CLIS-WPI/OpenRU/hardware/h2/reports/H2A_SCHEMATIC_REVIEW.md

# H2-A Schematic review report — OpenRU-X6 4T4R / 16-feed RF tile

- **Date:** 2026-11-12.
- **Branch:** `hardware/h2a-rf-schematic`, from H1.1 `a7990911b39865cade9f08b94dd8522956c959f7`.
- **Status:** **preliminary schematic, not a released design.** No layout, routing, EM sign-off, Gerbers, purchases,
  OTA transmission or simulator runs were done.

## 1. What exists

The editable KiCad 9 project is `hardware/h2/schematics/openru_x6_tile.kicad_pro`, with 21 sheets and 211 placed
parts. It is generated by `tools/build_schematics.py` and fully reproducible (`tools/run_h2a_checks.sh`).

| # (brief) | Sheet(s) | Content |
|---|---|---|
| 1 RF chain | `chain1..4` | one per N310 channel. Holds the IF SMA and the three sub-sheets below. Four structurally identical chains, generated by one function and verified identical by netlist checks |
| 2 Beamformer + control | `bf1..4` | ADAR1000 (UBF1–4): 4 TX/RX/PA_BIAS/DET channels, SPI (shared SCLK/SDIO, CSB each, unique ADDR), shared TR / TX_LOAD / RX_LOAD, PA_ON ← TX_ALLOW, CREG 1 µF ×4, SDO 50 Ω |
| 3 Four front ends | `fe1..4` | 4× ADTR1107 per chain (UFE1–16), wired per ADTR1107 Fig 91: TX/RX direct, PA_BIASk → VGG_PA (10 nF), CPLR_OUT → DETk, TR_SW_POS → CTRL_SW (100 k pull-up = RX default), LNA_BIAS → VGG_LNA (10 k to GND = self-bias default). Feed SMAs JF1–16 labelled with sim feed index / site / polarisation |
| 4 Conversion | `conv1..4` | N310 IF → 18 pF DC block → BFCN-1840+ → **LTC5553** IF; LTC5553 RF → BFCN-8350+ → HFCN-7150+ → cal sheet; LO 18 pF block; VCC 18 pF + 1 µF; EN = MIX_EN |
| 5 LO | `lo` | ADF4371: 10 MHz SE REFP; RF8P → AVA-183A+ → 3 dB pad → EP4RKU+ → 4 mixers; RF8N terminated; RFAUX8 → LO-monitor SMA; loop filter UNRESOLVED |
| 6 Power + sequencing | `power` | 8 rails (regulators = TBD placeholders), per-chain TPS22810 PA-drain switch, INA226 ×5, PCA9306, negative-rail monitor (TBD) |
| 7 MCU, SPI, telemetry, watchdog | `mcu` | STM32G431 at 1.8 V, TPS3430 window watchdog, 74LVC1G11/08 interlock gates, safe-default pull-downs, TMP117 ×2, N310 GPIO / TX-permit header, SWD |
| 8 Cal + test I/O | `cal` | EDC21-24+ coupler per chain (converter ↔ ADAR1000), EP4RKU+ combiner → CAL SMA; 10 MHz REF SMA (50 Ω); PPS SMA → 74LVC1G125 → MCU |

Topology A feed ownership is preserved exactly: chain c → UBF{c}, channel k → UFE{4(c−1)+k}, with channels 1/2 the
V/H of the left site and 3/4 the V/H of the right site. All 16 feeds were checked against `H1_FEED_POLARIZATION_MAP.csv`.

## 2. Verification performed

| Check | Result | Evidence |
|---|---|---|
| KiCad ERC | **22 errors**, all deliberate unconnected/unresolved pins (§4) | `H2A_ERC_REPORT.md`, `H2A_ERC.json` |
| Hierarchy validation | ok, 0 issues | `H2A_ERC.json` |
| Symbol pin maps vs datasheets | 1088 / 1088 pins match | `H2A_PIN_INTERFACE_VERIFICATION.csv` |
| Interfaces, feed map, rails, safety chain, unconnected-pin declarations | 367 / 367 pass (+ 44 symbol pin-count checks) | same |
| Converter gain/loss, RX cascade NF | RX NF **4.05 dB** feed-referred (H1: 3.85 dB); compression ≈ −32.8 dBm per feed (ADAR1000 IP1dB-limited) | `H2A_RF_CASCADE_BUDGET.csv` |
| TX drive and compression margins | 10 dBm/feed needs: ADTR1107 out 10.7 dBm (12.3 dB below OP1dB typ, 10.3 dB below min); ADAR1000 out −10.8 dBm (20.8 dB below its OP1dB); ADAR1000 gain 13.7 dB of 21 dB; LTC5553 IF −10 dBm (25 dB below IP1dB); N310 −7.6 dBm avg (25.6 dB below 18 dBm max) | same |
| LO distribution | −5.8 / −0.2 / +3.8 dBm per mixer for ADF4371 settings −4 / −1 / +5 dBm (range −6…+6, abs max +10) | `H2A_LO_BUDGET.csv` |
| Spur frequencies | no mLO ± nIF (m, n ≤ 5) product falls in 8.35–8.45 GHz; no mLO ± nRF product in 1.75–1.85 GHz. Nearest: 5×IF at 8.75–9.25 GHz and 2LO − 3IF at 7.65–7.95 GHz (filter rejection there not tabulated) | `H2A_SPUR_TABLE.csv` |
| Power-rail / bias sequencing logic | interlock nets and default states verified in the netlist; sequence in `H2A_POWER_SEQUENCING_SPEC.md` | `verify_netlist.py` (safety) |

**Not performed, and not claimed:**
- EM simulation of any kind;
- S-parameter/scikit-rf cascade;
- ADIsimRF/ADIsimPLL;
- any RF or DC measurement;
- thermal analysis.

All 8.4 GHz figures are datasheet table values from wider bands, plot reads (about ±0.5 dB) or assumptions, tagged
row by row.

## 3. Prototype power target

The prototype target of ≥10 dBm average per feed is **still plausible.**
- It needs about 12 dB back-off from the ADTR1107 OP1dB (23 dBm typ, 21 dBm min, 6–14 GHz table).
- Every stage before it runs with ≥20 dB margin.
- It depends on two unverified items:
  1. 100 MHz OFDM EVM/ACLR at 12 dB back-off without DPD;
  2. ADAR1000 gain and gain-control range at 8.4 GHz, since its data starts at 9.5 GHz.

Both are covered by condition C2.

## 4. Unresolved electrical/RF risks (full list: `H2A_UNRESOLVED_ISSUES.md`, 26 items)

| ID | Risk | Severity | Close by |
|---|---|---|---|
| R1 | **All regulators are placeholders** (U601–U608), and the negative-rail monitor U609 is a placeholder | blocks layout prep | power design (ADI suggests LT8609S + LT1931 for 4 ADAR1000) |
| R2 | **PA_BIAS OFF value conflict.** ADAR1000 p45 says −2.5 V; ADTR1107 VGG_PA abs max is −2 V. H2-A uses −1.75 V in firmware | high (device damage) | ADI question 5a |
| R3 | **VGG_PA 10 nF vs PA_BIAS switching.** 60 ns is specified into 1 nF; 10 nF gives about 0.65 µs or more per TDD edge | medium (TDD guard time) | ADI question 5c; eval-board value |
| R4 | **LNA powered during TX.** The design keeps VDD_LNA on and pinches the gate (Stingray style), unlike the ADTR1107 TX sequence | medium | ADI question 5b |
| R5 | **No bypass values** for ADAR1000 AVDD1/AVDD3 or ADTR1107 VDD_PA/VDD_LNA/VDD_SW/VSS_SW (not in datasheets) | blocks layout prep | eval-board schematics (ADI question 2) |
| R6 | **ADF4371 loop filter not designed;** RF8P single-ended level at 6.6 GHz not tabulated; RF8 is ON at power-up by default | blocks layout prep | ADIsimPLL; C4 bench; CE held low until programmed (drawn) |
| R7 | **AVA-183A+ bias tee not wired;** no gain/P1dB spec between 5 and 8 GHz | blocks layout prep | Fig 2 / PL-328; bench |
| R8 | **ADAR1000 SDO not tristated** on a shared bus (erratum) | low (firmware) | separate CSB per chip, as drawn; read back one chip at a time |
| R9 | **MCU pin/AF map provisional;** STM32 decoupling not placed | blocks layout prep | STM32CubeMX + ST DS |
| R10 | **TI glue-part values from memory** (TPS22810 CT/QOD, TPS3430 timing, INA226 straps, PCA9306 bias, TPS22810 EN threshold at 1.8 V) | blocks layout prep | TI datasheets |
| R11 | **N310 interface levels unverified** (IF port DC state, PPS level, GPIO/ATR mapping); N310 inter-channel phase is random per start/retune | medium | UHD docs; CAL-port loopback after every init/retune (drawn) |
| R12 | **Calibration network:** EP4RKU+ phase unbalance up to 19°, coupler directivity 19 dB typ | medium | one-time VNA characterisation; phase-matched layout |
| R13 | **No footprints** for custom ICs, Mini-Circuits parts or SMAs; ADF4371 EP size is ambiguous in the datasheet. The exposed pad is symbol pin `EP` on every custom part, so footprint pad numbers must match it (the LTC5553 datasheet calls it pin 13) | blocks layout | vendor land patterns |
| R14 | **Antenna / feed interface and thermal design** not done (H1 M5, M6) | separate WPs | EM + thermal studies |
| R15 | **Source copies:** ADI datasheets were read from mirrors (analog.com unreachable) | low | re-check revisions in a browser |

## 5. Gate decision

| Gate | Decision |
|---|---|
| Mixer | **LTC5553 selected** (`H2A_MIXER_DECISION.md`) |
| Preliminary schematic capture | **Done**, as a preliminary schematic |
| **PCB layout preparation** | **NO-GO** |
| PCB routing / Gerbers / fabrication | NO-GO (unchanged) |

Why it is NO-GO:
- ERC is not clean: 22 deliberate open pins.
- The power tree is still placeholders (R1).
- Mandatory bypass networks are missing (R5).
- The loop filter, LO-amplifier bias and TI glue values are not designed (R6, R7, R10).
- None of the H1.1 conditions C1 (ADAR1000 supply), C2 (8.4 GHz bench data) or C4 (LTC5553/ADF4371 at the operating
  point) has closed, and C3 still needs the project lead's acceptance.

Exit criteria to reach CONDITIONAL GO for layout preparation:
1. R1, R5, R6, R7, R9, R10 designed and drawn.
2. ERC at 0 violations (or each residual waived in writing).
3. R2 and R4 answered by ADI or decided by the project lead.
4. Vendor footprints for all parts (R13).
5. C1 closed. C2 and C4 have at least eval-board data, or an explicit risk acceptance.

Work that may proceed in parallel, because it does not depend on schematic freeze:
- building the footprint library from vendor land patterns;
- choosing the stackup and material (ADF4371 DS recommends Rogers 4350/4003/3003);
- antenna EM design;
- the eval-board bench plan for C2/C4, cabled and attenuated with no OTA, using the draft inquiry once it is approved.
