CLIS-WPI/OpenRU/hardware/h2/sim/h2c_d_worst_ASB_nom_gmin.png

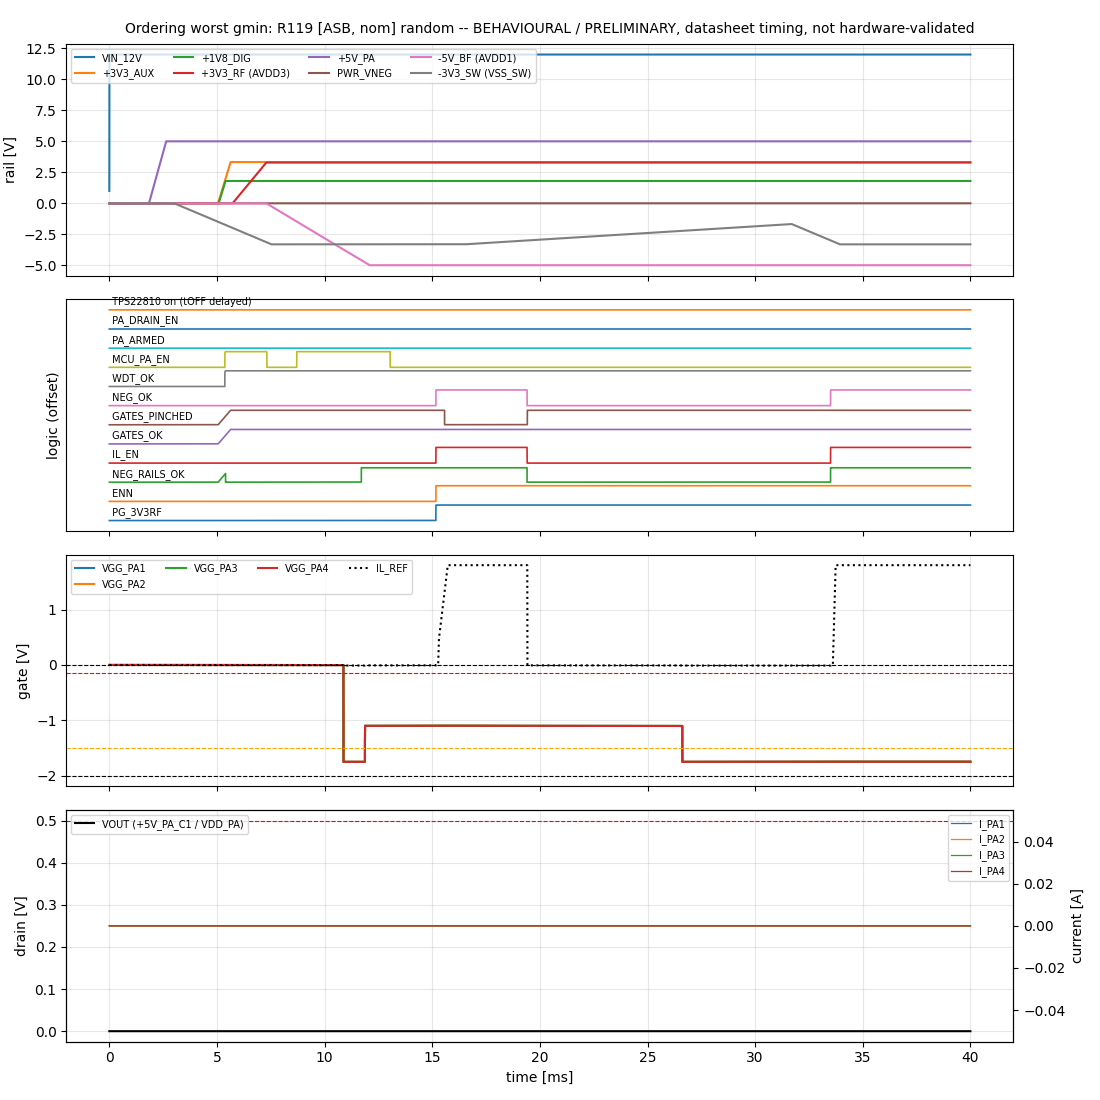
hardware/h2/sim/h2c_d_worst_ASB_nom_gmin.png
