CLIS-WPI/OpenRU/hardware/h2/sim/h2c_d_worst_ASB_nom_t05.png

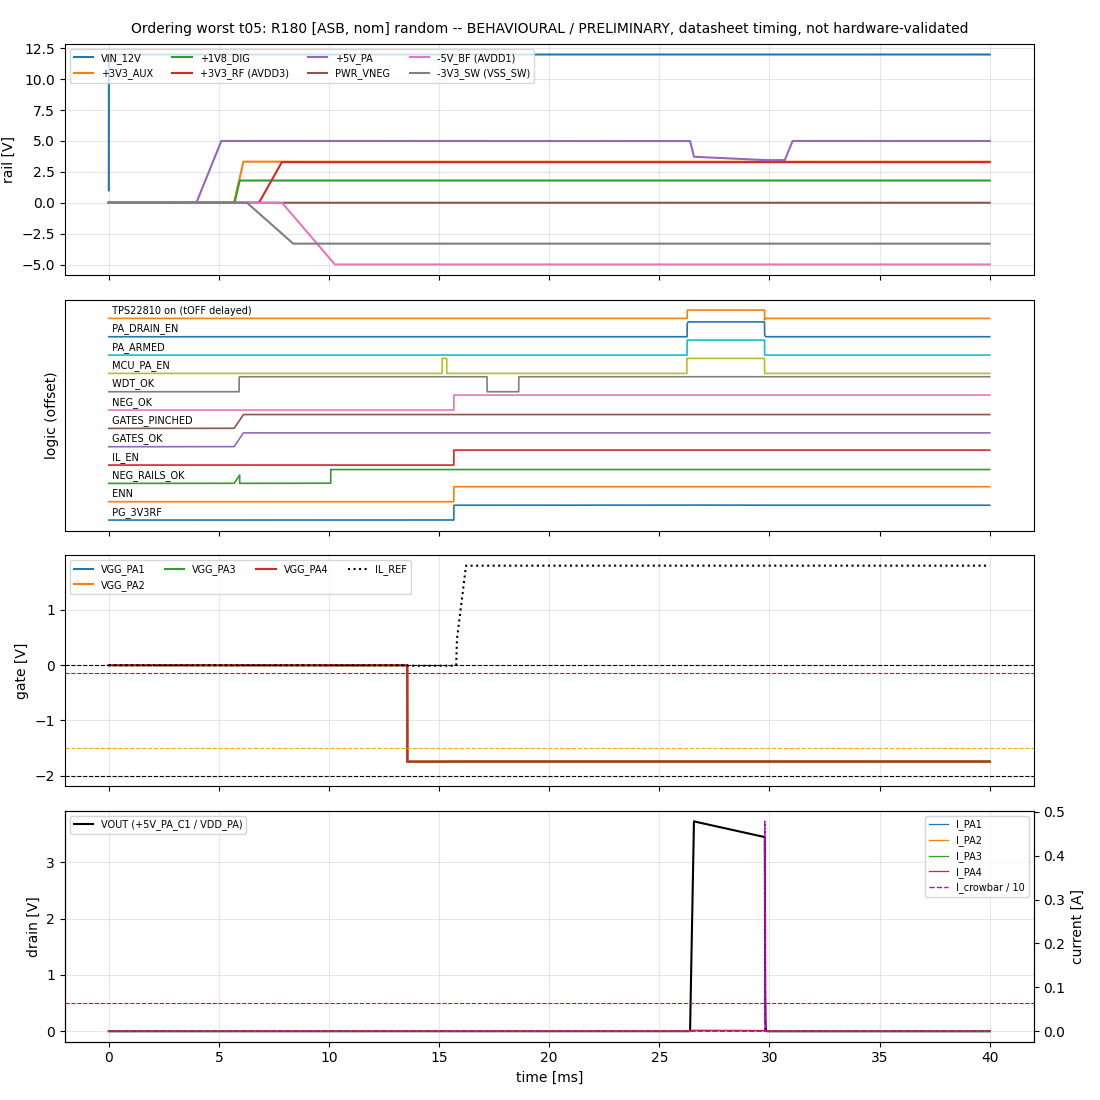
hardware/h2/sim/h2c_d_worst_ASB_nom_t05.png
