CLIS-WPI/OpenRU/hardware/h2/sim/h2c_d_worst_ASB_td100_pess_gmax.png

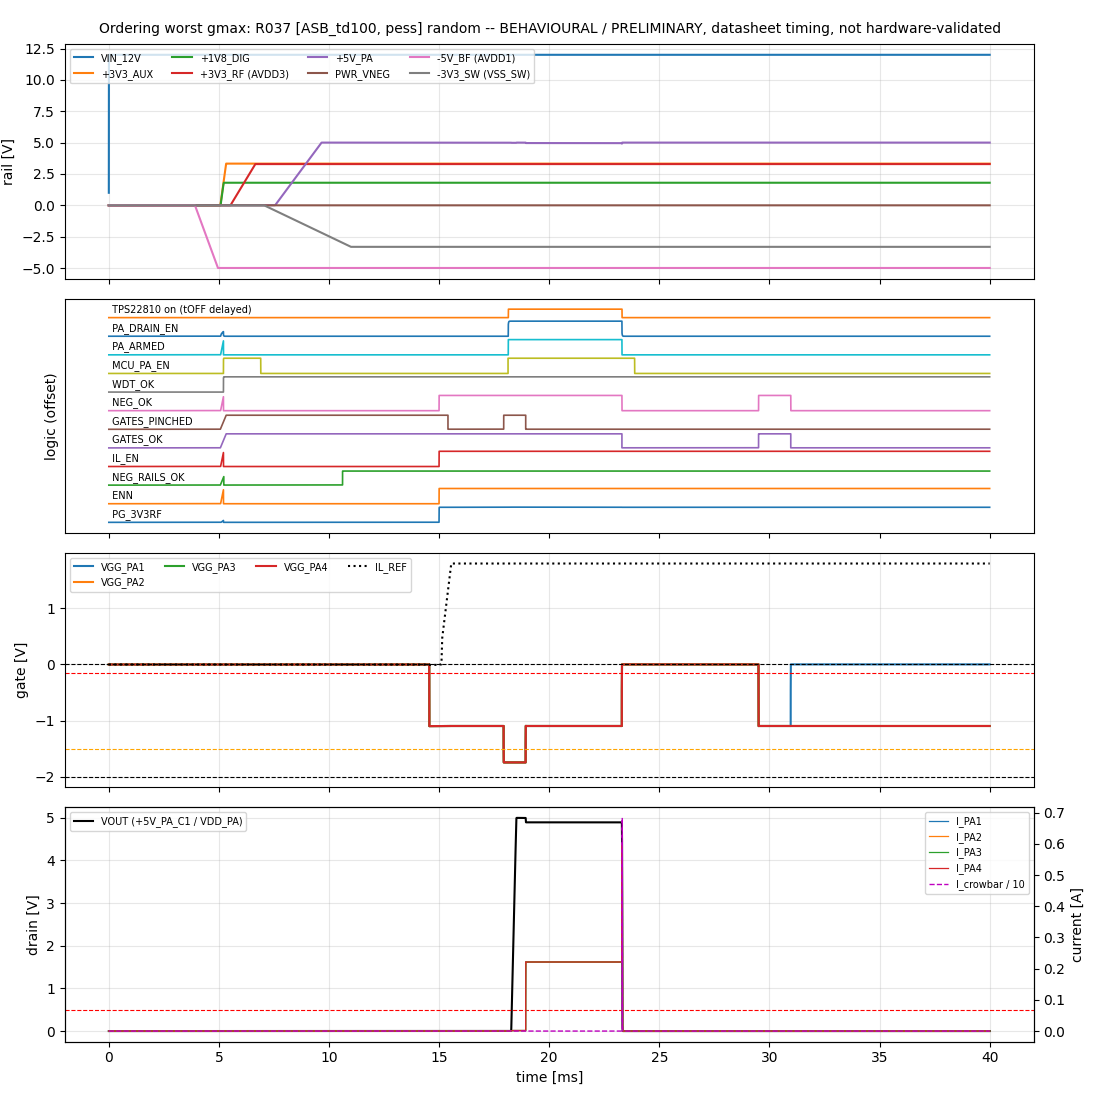
hardware/h2/sim/h2c_d_worst_ASB_td100_pess_gmax.png
