CLIS-WPI/OpenRU/hardware/h2/sim/h2c_s1_powerup_ASB_pess.png

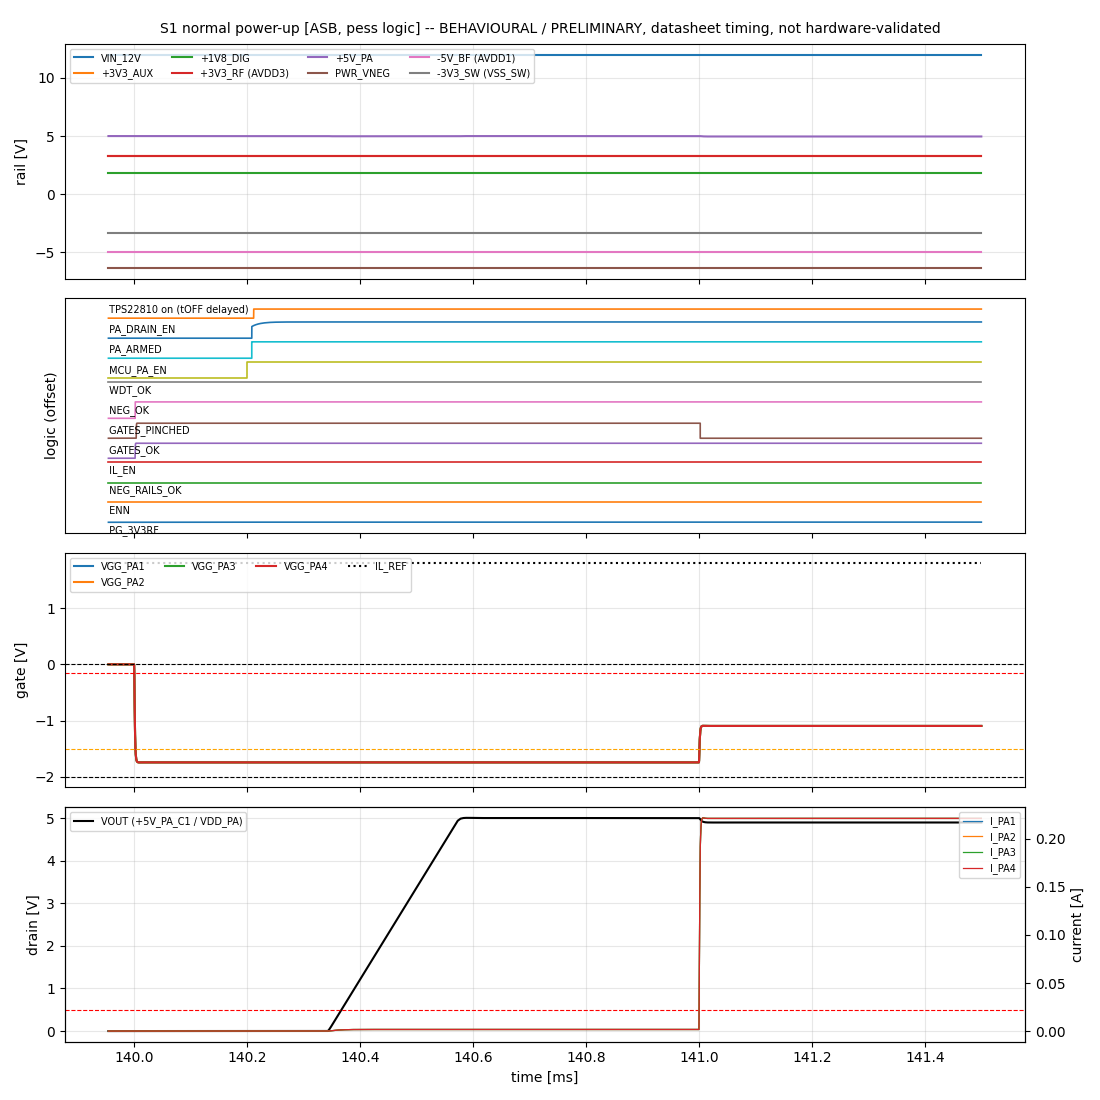
hardware/h2/sim/h2c_s1_powerup_ASB_pess.png
