CLIS-WPI/OpenRU/hardware/h2/sim/h2c_s2_unprogrammed_gates_ASB_pess.png

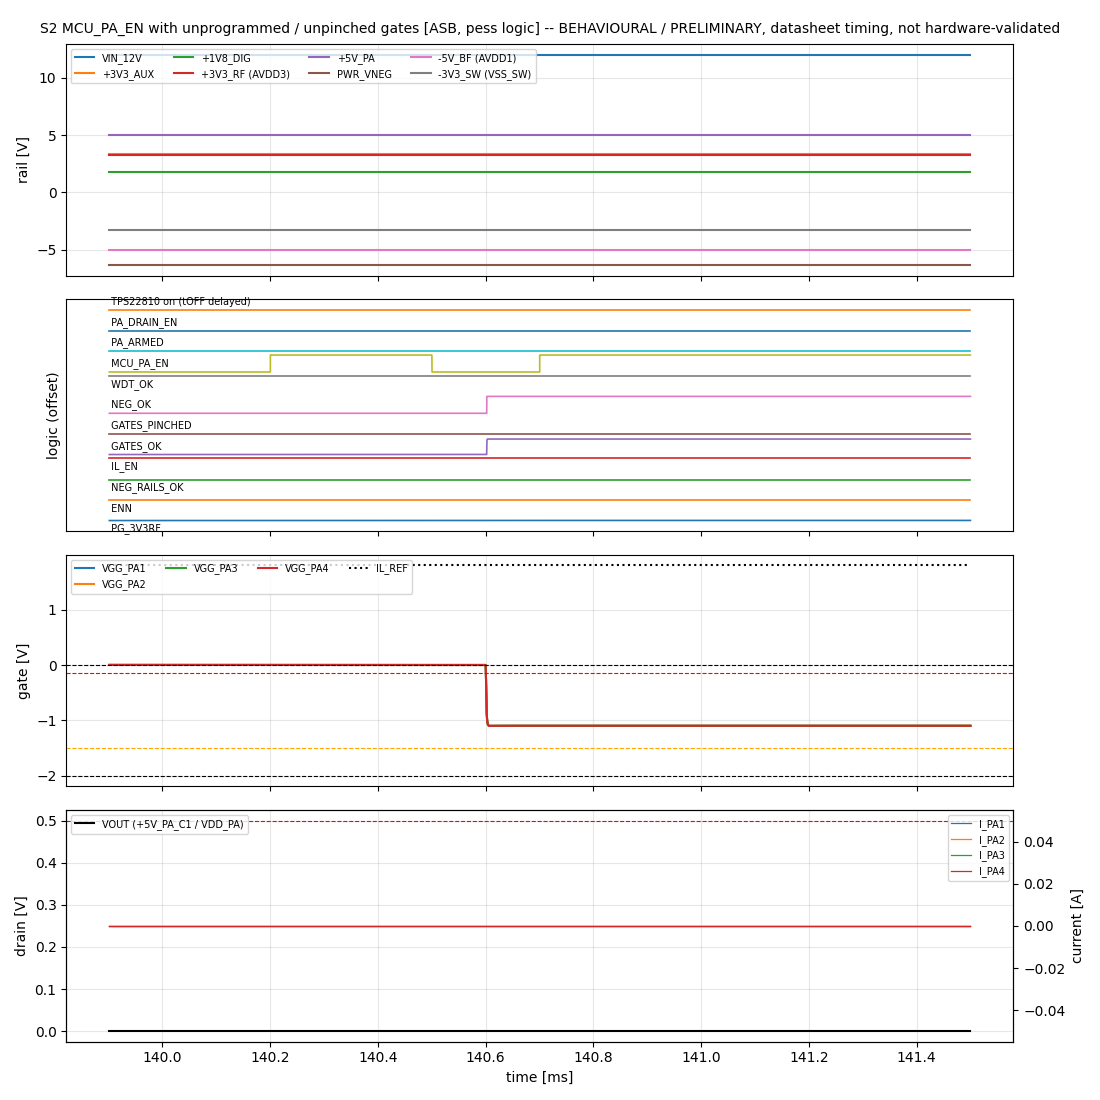
hardware/h2/sim/h2c_s2_unprogrammed_gates_ASB_pess.png
