CLIS-WPI/OpenRU/hardware/h2/sim/h2c_s3_gate_lost_ASB_pess.png

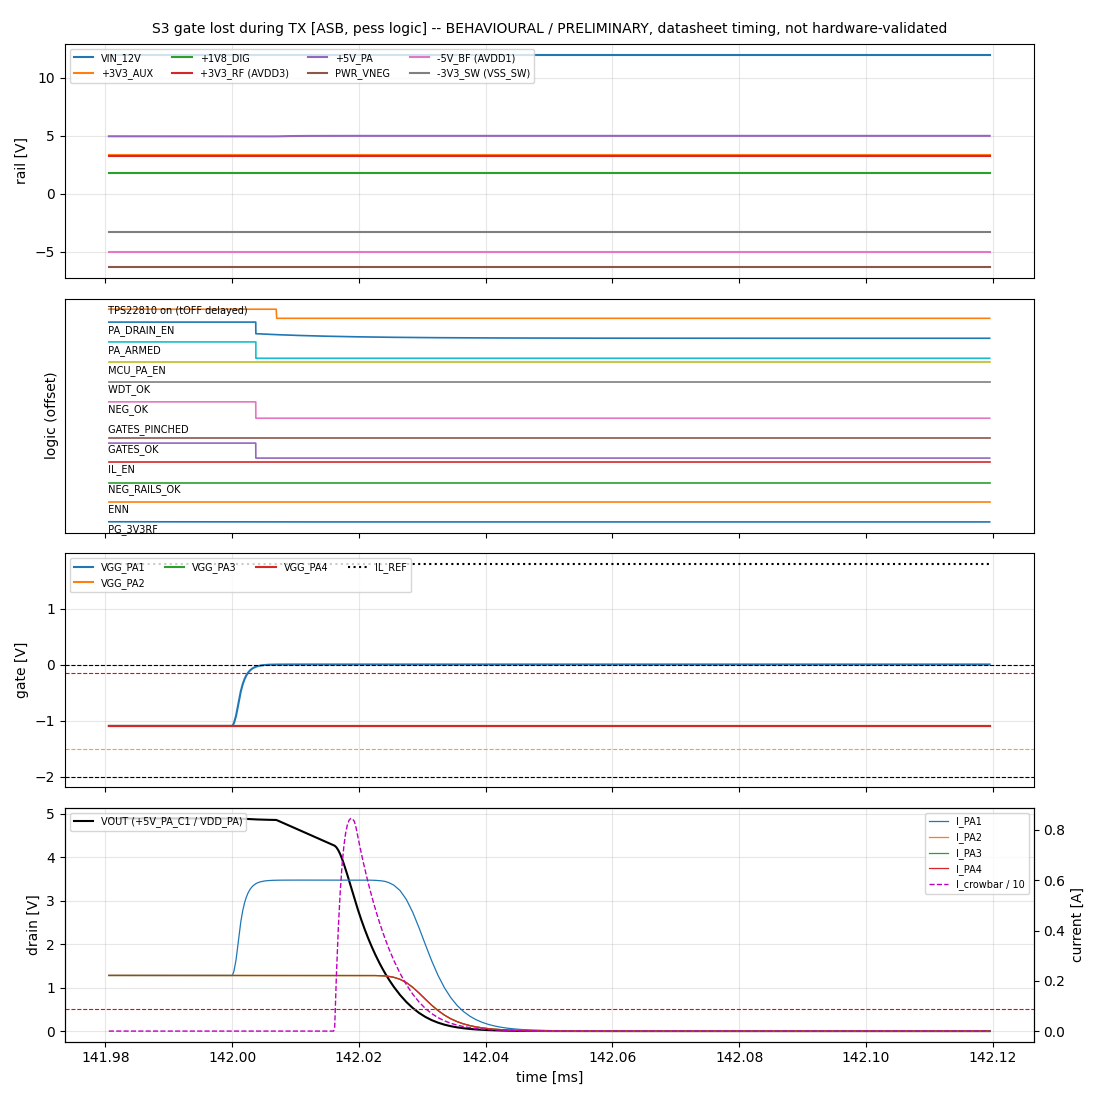
hardware/h2/sim/h2c_s3_gate_lost_ASB_pess.png
