CLIS-WPI/OpenRU/hardware/h2/sim/h2c_s3_gate_lost_R2_nom.png

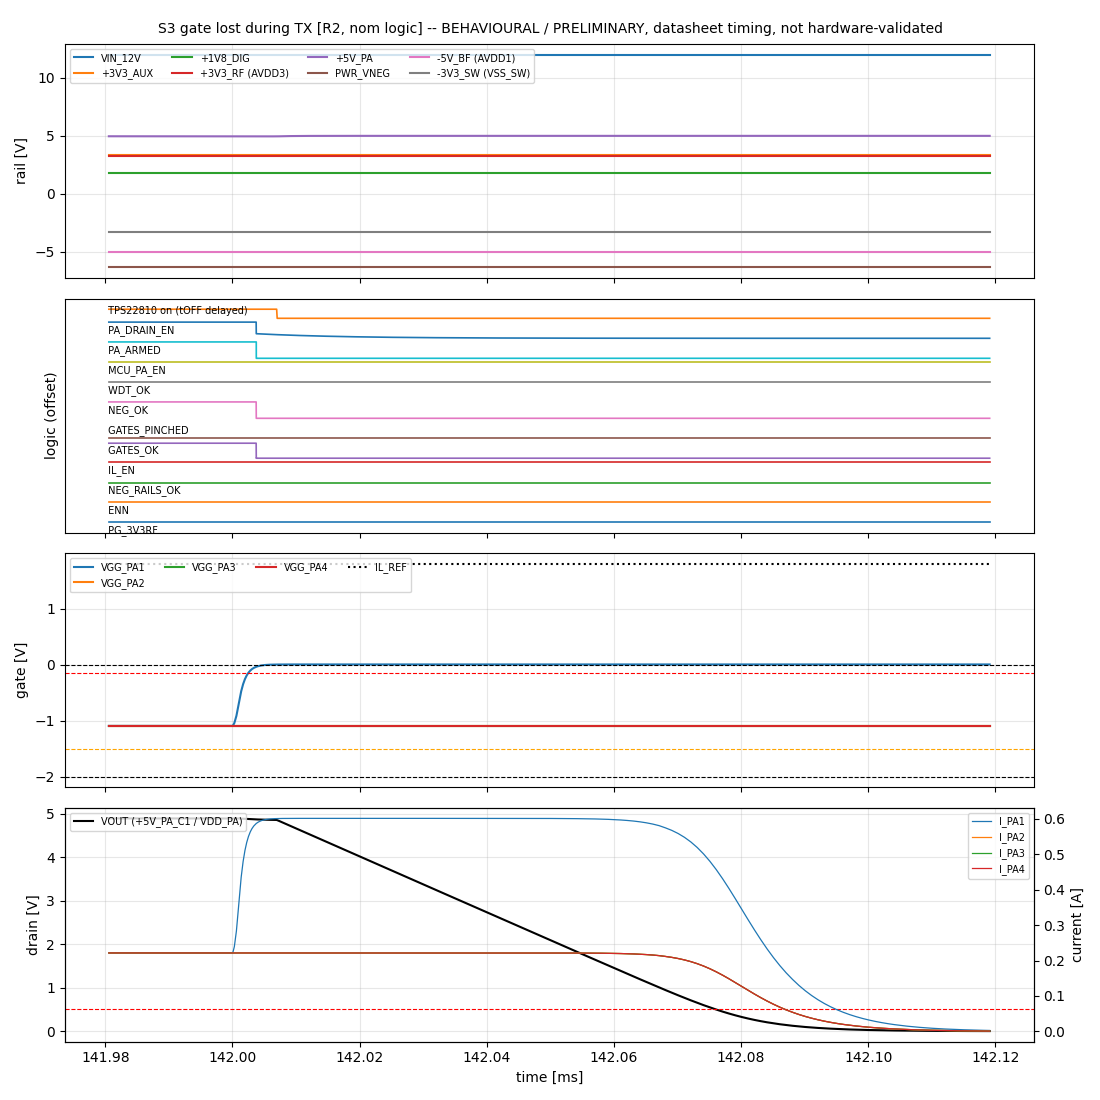
hardware/h2/sim/h2c_s3_gate_lost_R2_nom.png
