CLIS-WPI/OpenRU/hardware/h2/sim/h2c_s4a_neg_collapse_enn_ASB_pess.png

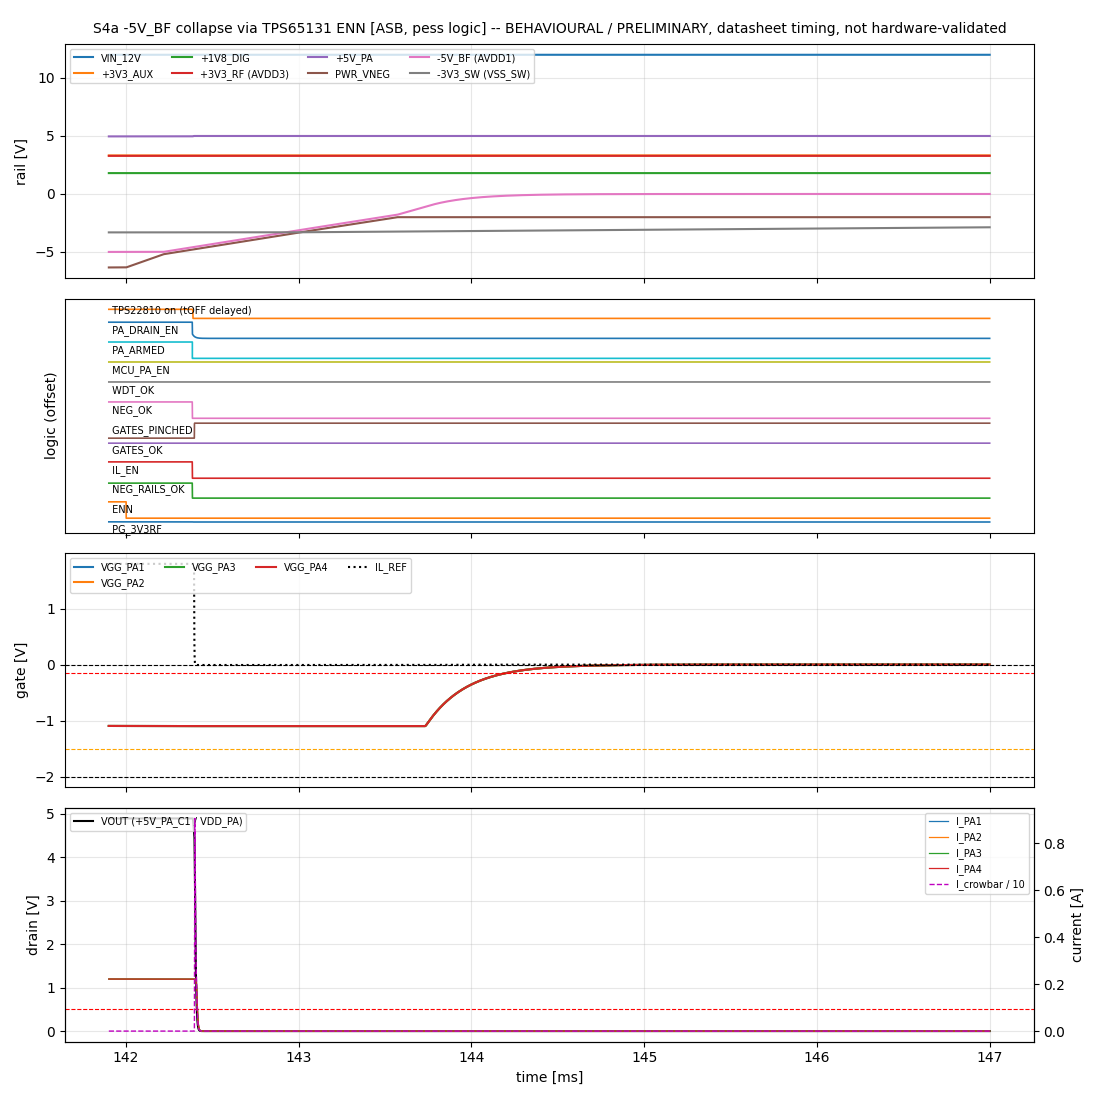
hardware/h2/sim/h2c_s4a_neg_collapse_enn_ASB_pess.png
