CLIS-WPI/OpenRU/hardware/h2/sim/h2c_s4b_neg_collapse_ldo_ASB_pess.png

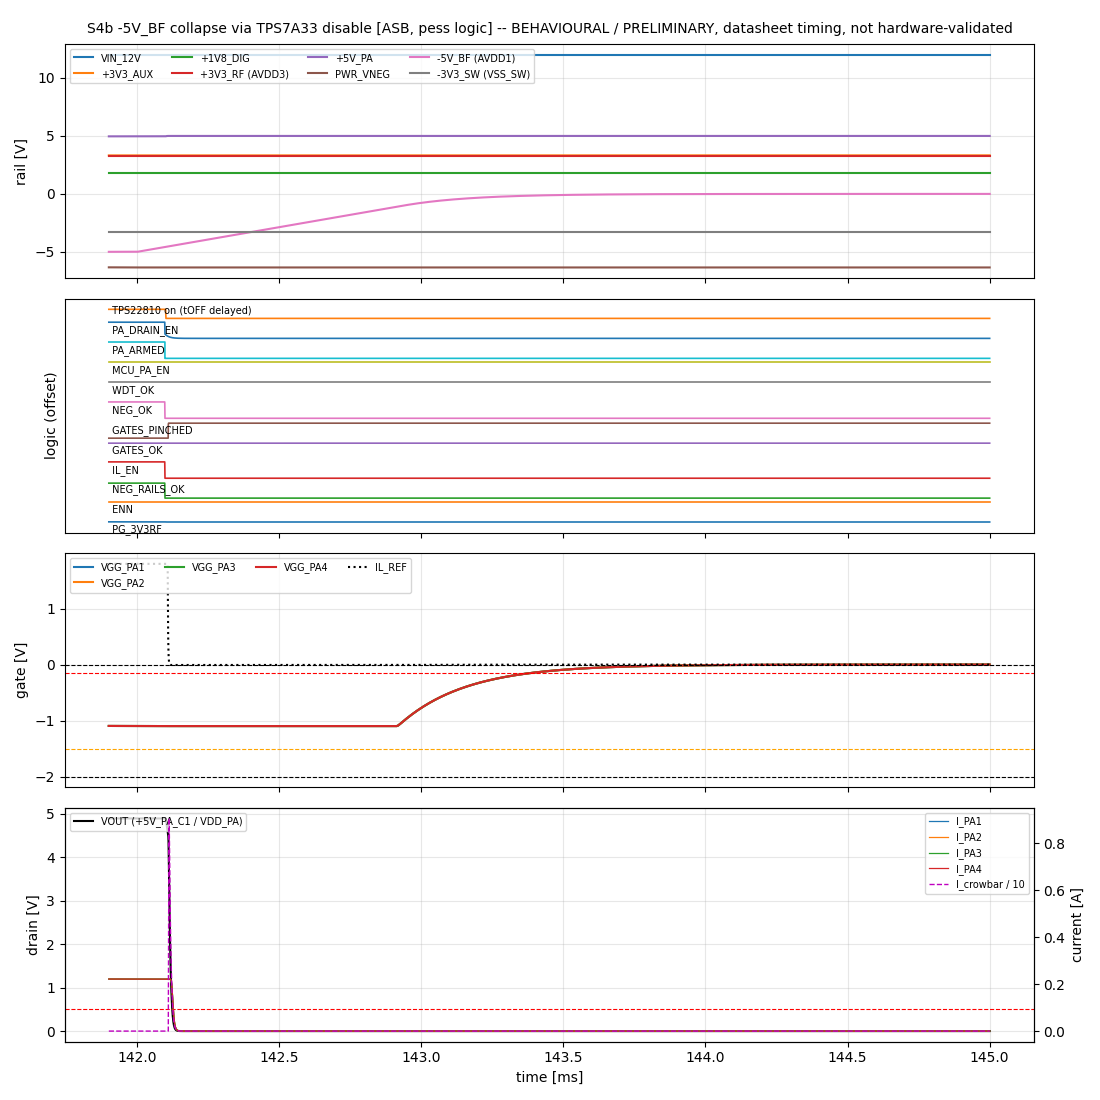
hardware/h2/sim/h2c_s4b_neg_collapse_ldo_ASB_pess.png
