CLIS-WPI/OpenRU/hardware/h2/sim/h2c_s5a_watchdog_tx_ASB_pess.png

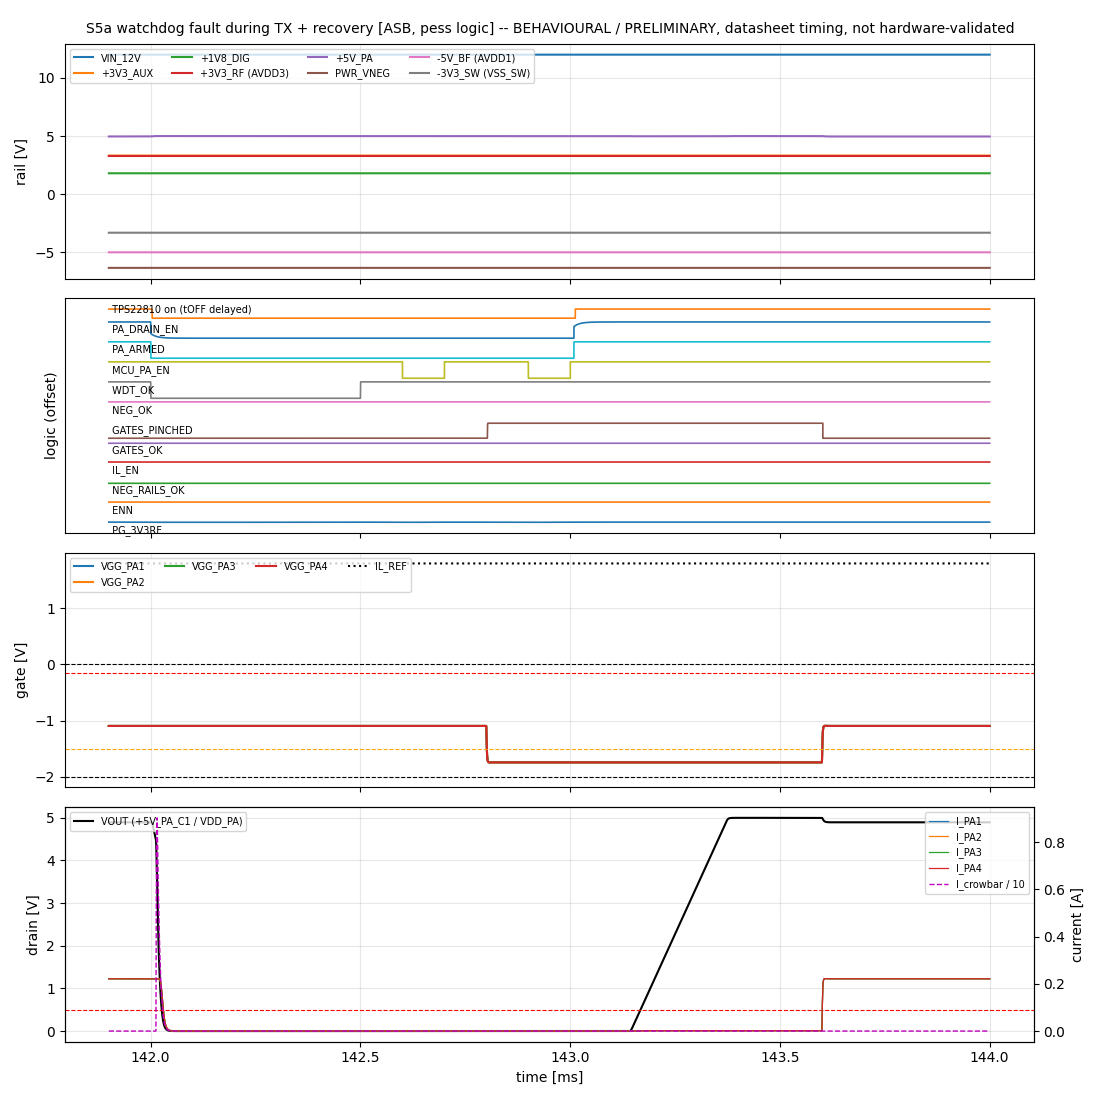
hardware/h2/sim/h2c_s5a_watchdog_tx_ASB_pess.png
