CLIS-WPI/OpenRU/hardware/h2/sim/h2c_s5b_watchdog_idle_ASB_pess.png

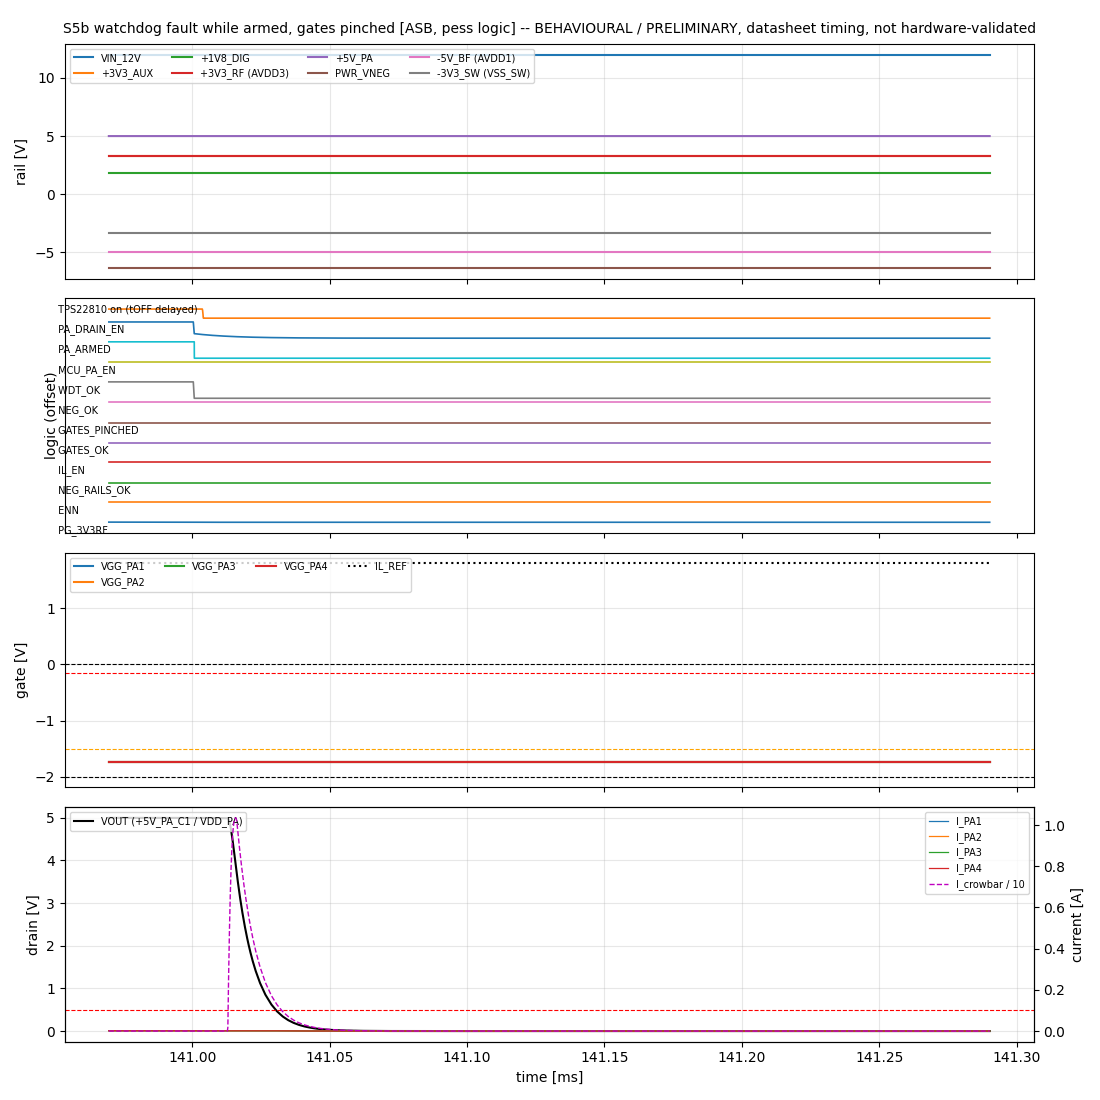
hardware/h2/sim/h2c_s5b_watchdog_idle_ASB_pess.png
