CLIS-WPI/OpenRU/hardware/h2/sim/h2c_s5b_watchdog_idle_R2_nom.png

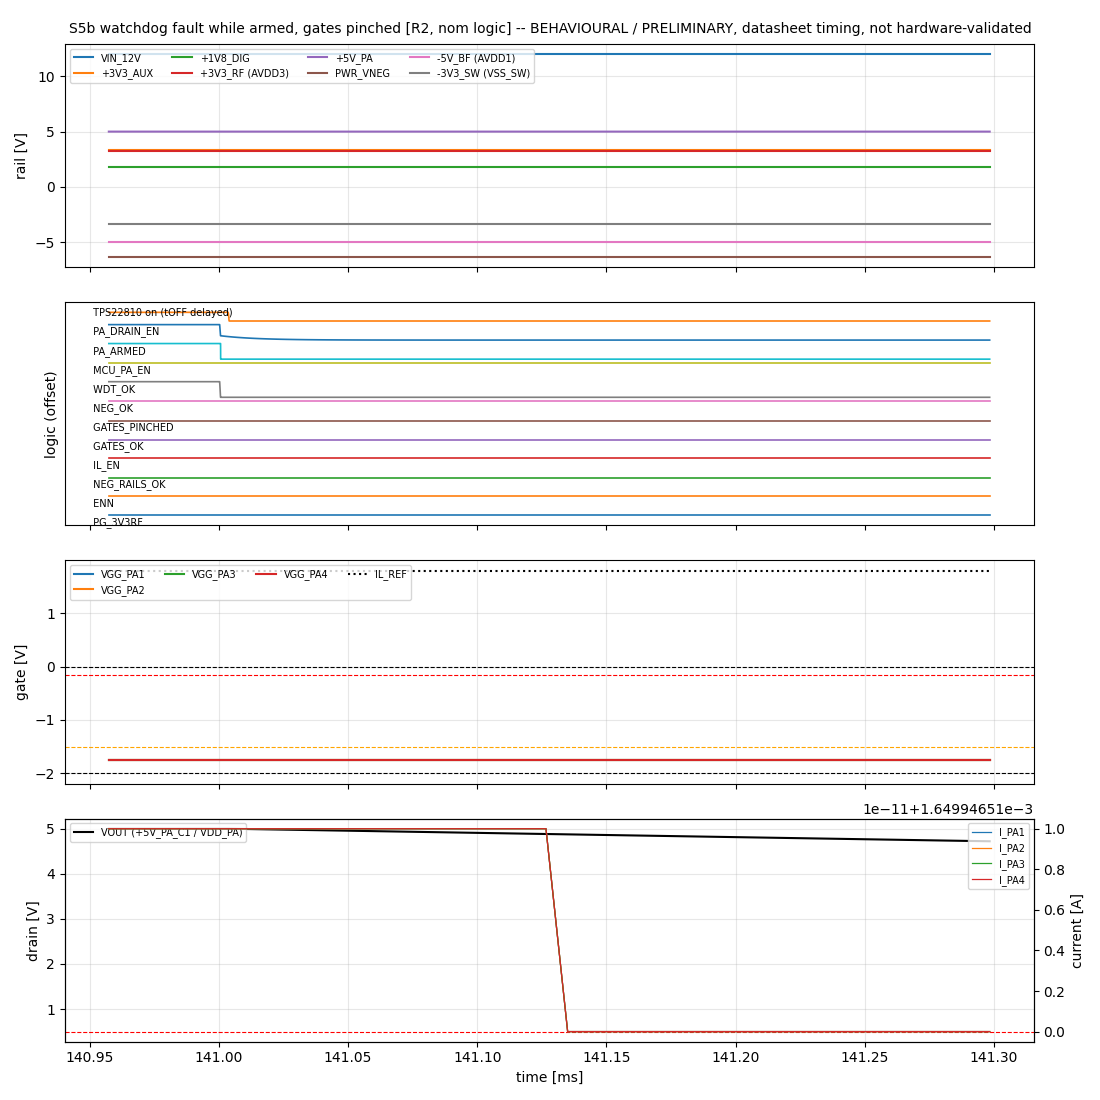
hardware/h2/sim/h2c_s5b_watchdog_idle_R2_nom.png
