CLIS-WPI/OpenRU/hardware/h2/sim/h2c_s6_vin_loss_ASB_pess.png

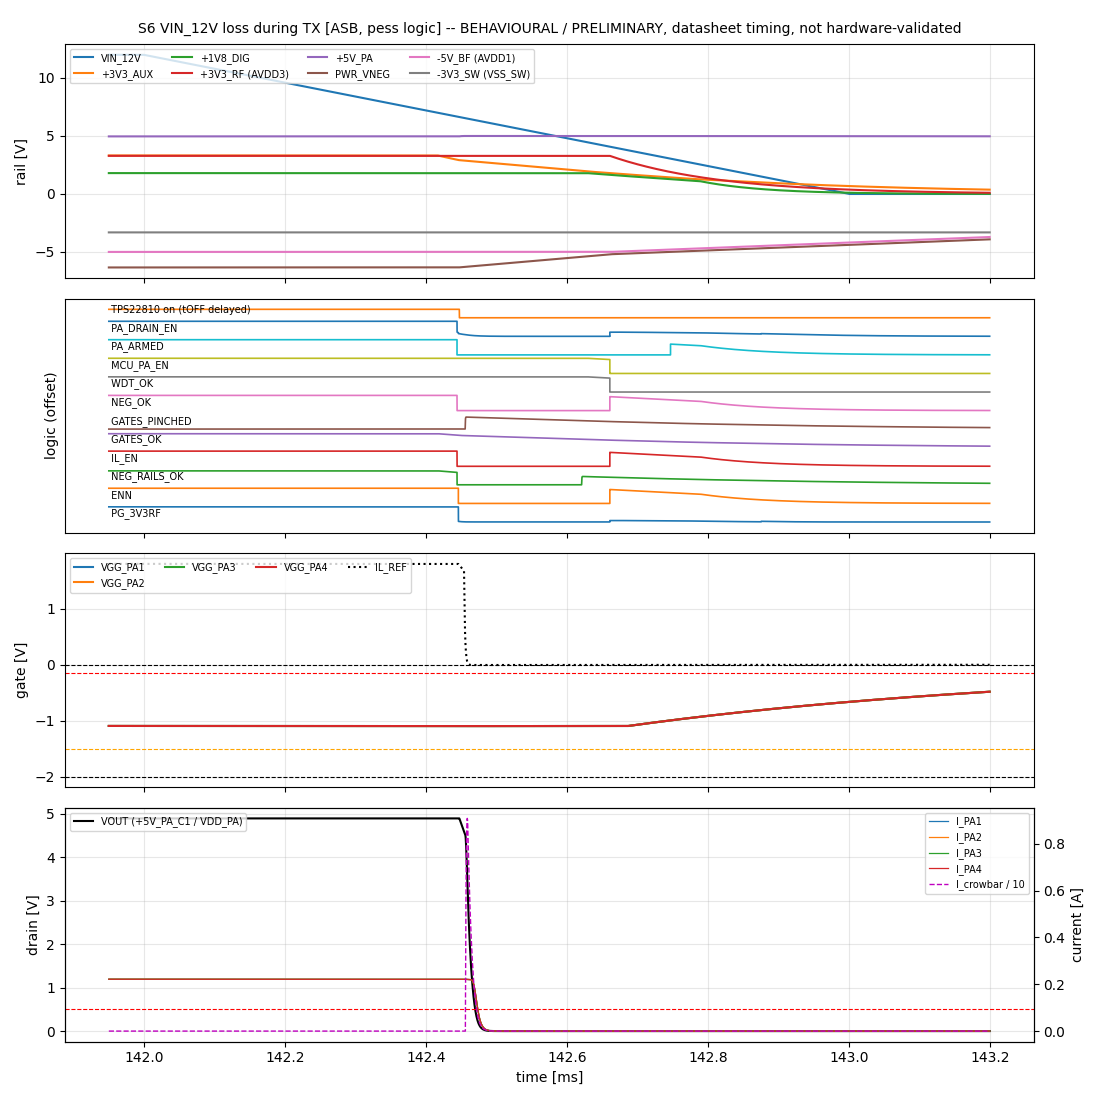
hardware/h2/sim/h2c_s6_vin_loss_ASB_pess.png
