CLIS-WPI/OpenRU/hardware/h2/sim/h2c_s6_vin_loss_R2_nom.png

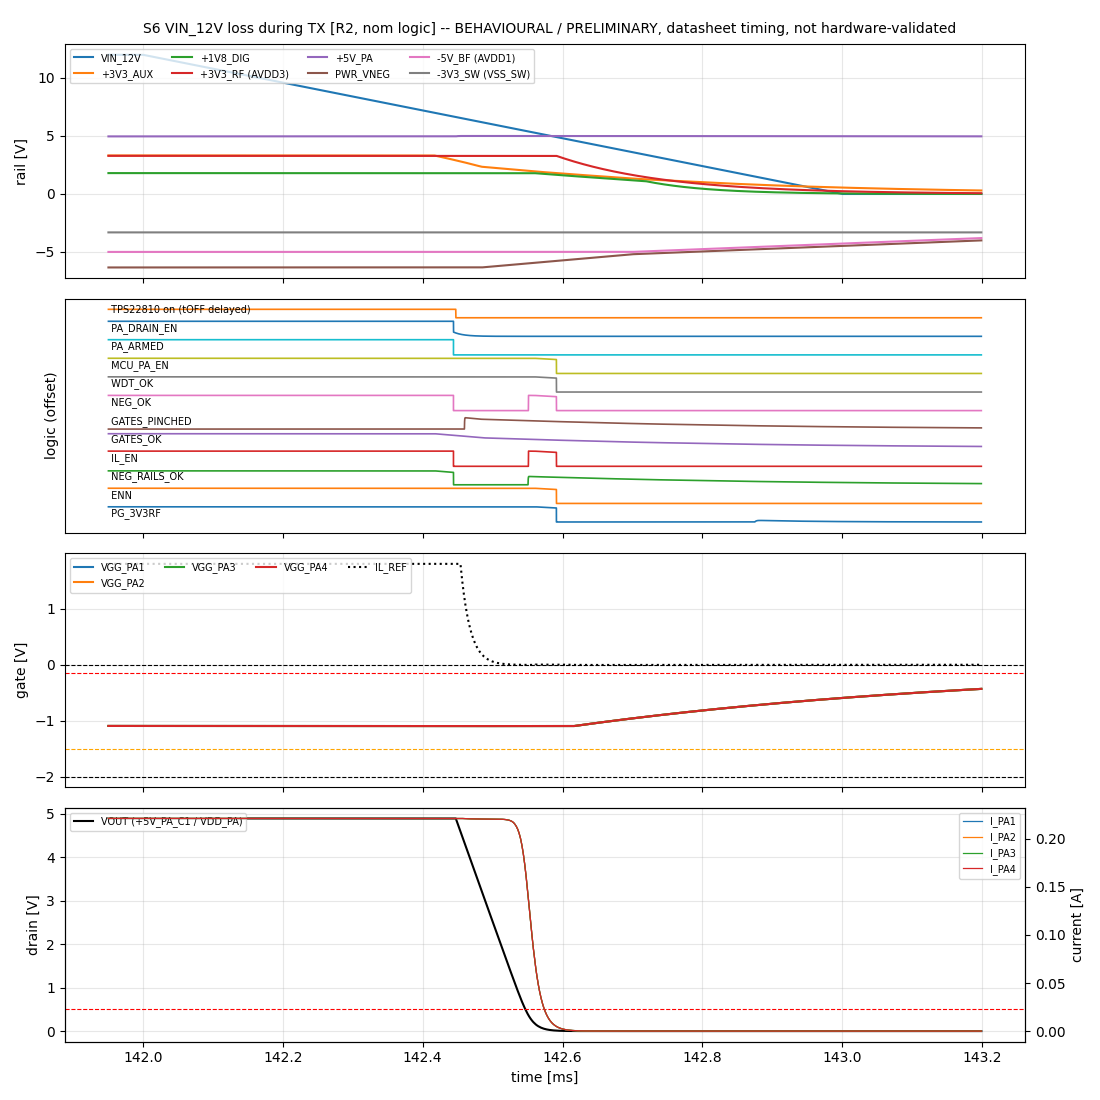
hardware/h2/sim/h2c_s6_vin_loss_R2_nom.png
