CLIS-WPI/OpenRU/hardware/h2/sim/h2c_s7a_rf_en_loss_ASB_pess.png

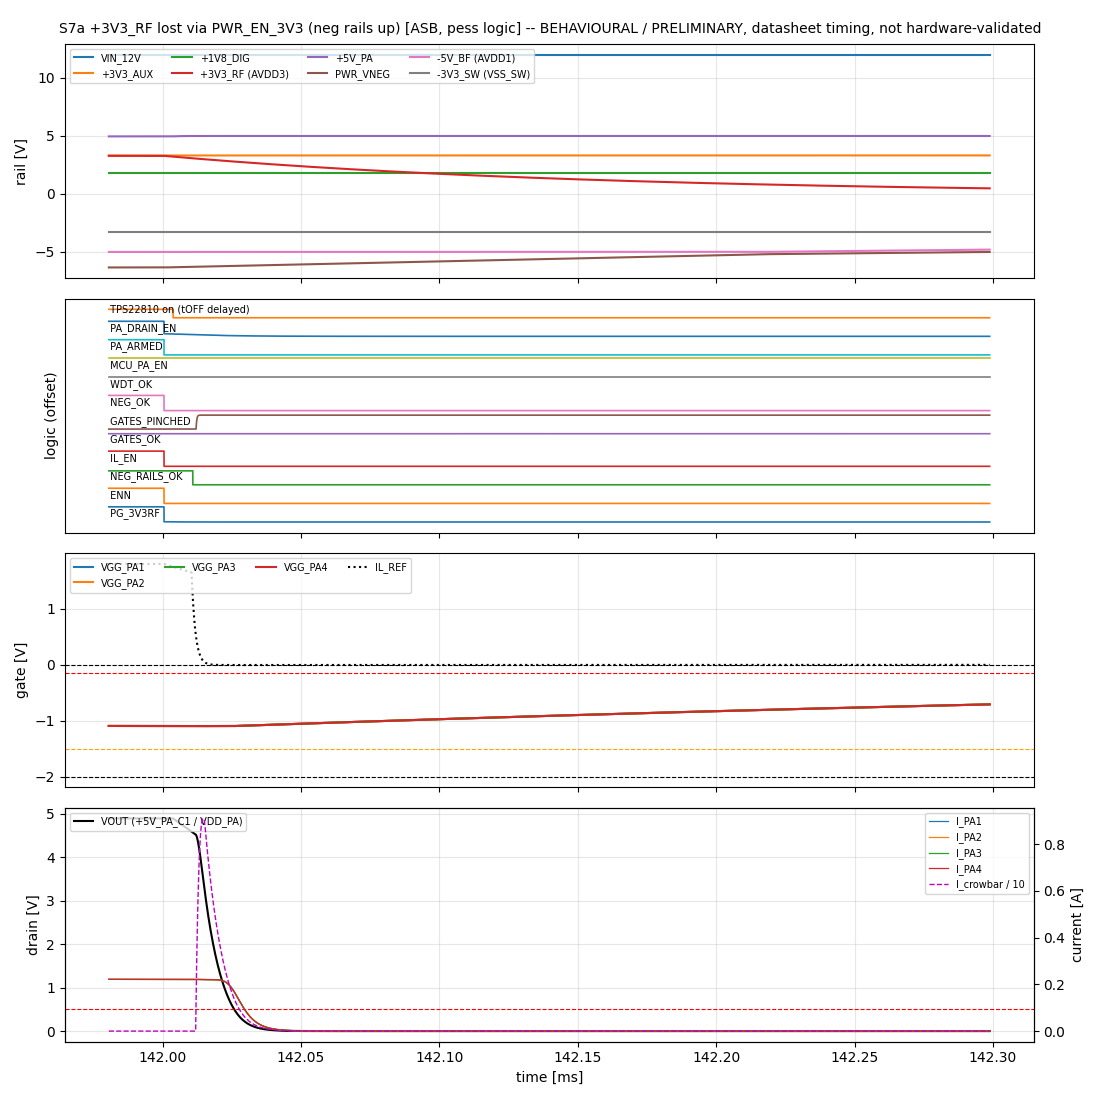
hardware/h2/sim/h2c_s7a_rf_en_loss_ASB_pess.png
