CLIS-WPI/OpenRU/hardware/h2/sim/h2c_s7a_rf_en_loss_R2_nom.png

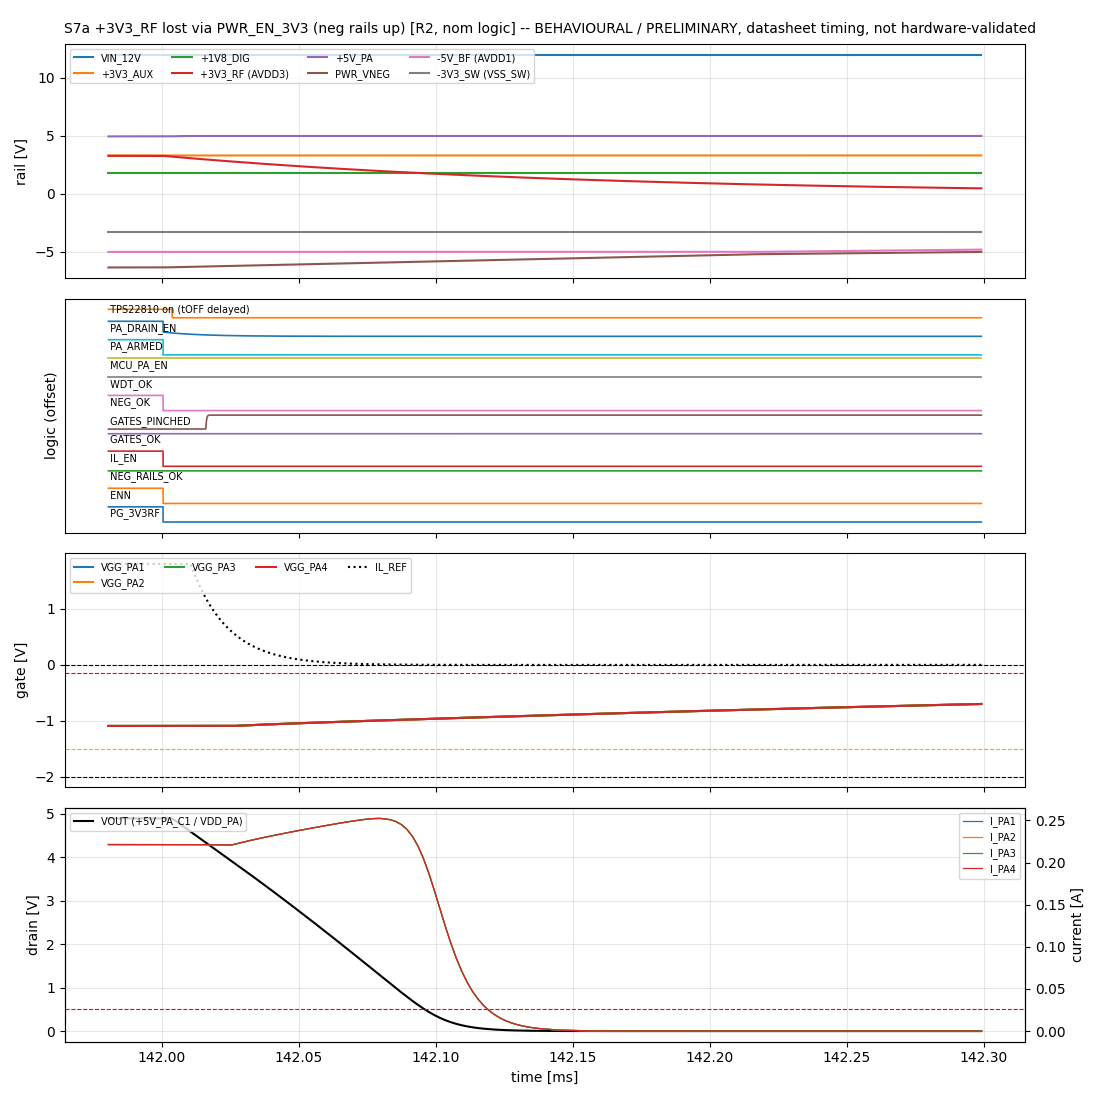
hardware/h2/sim/h2c_s7a_rf_en_loss_R2_nom.png
