CLIS-WPI/OpenRU/hardware/h2/sim/h2c_s7b_rf_silent_collapse_ASB_pess.png

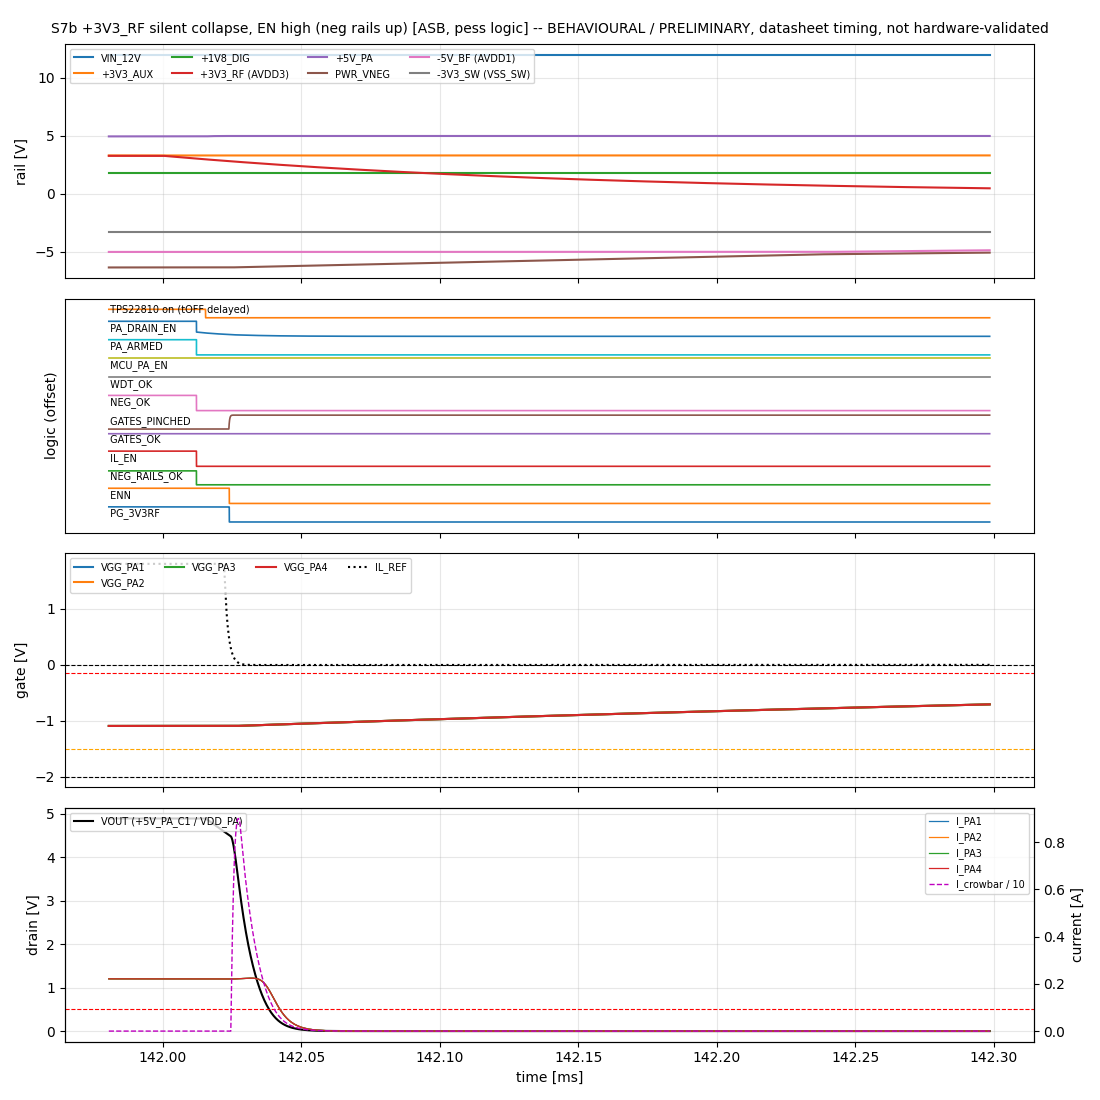
hardware/h2/sim/h2c_s7b_rf_silent_collapse_ASB_pess.png
