CLIS-WPI/OpenRU/hardware/h2/sim/h2c_s7b_rf_silent_collapse_R2_nom.png

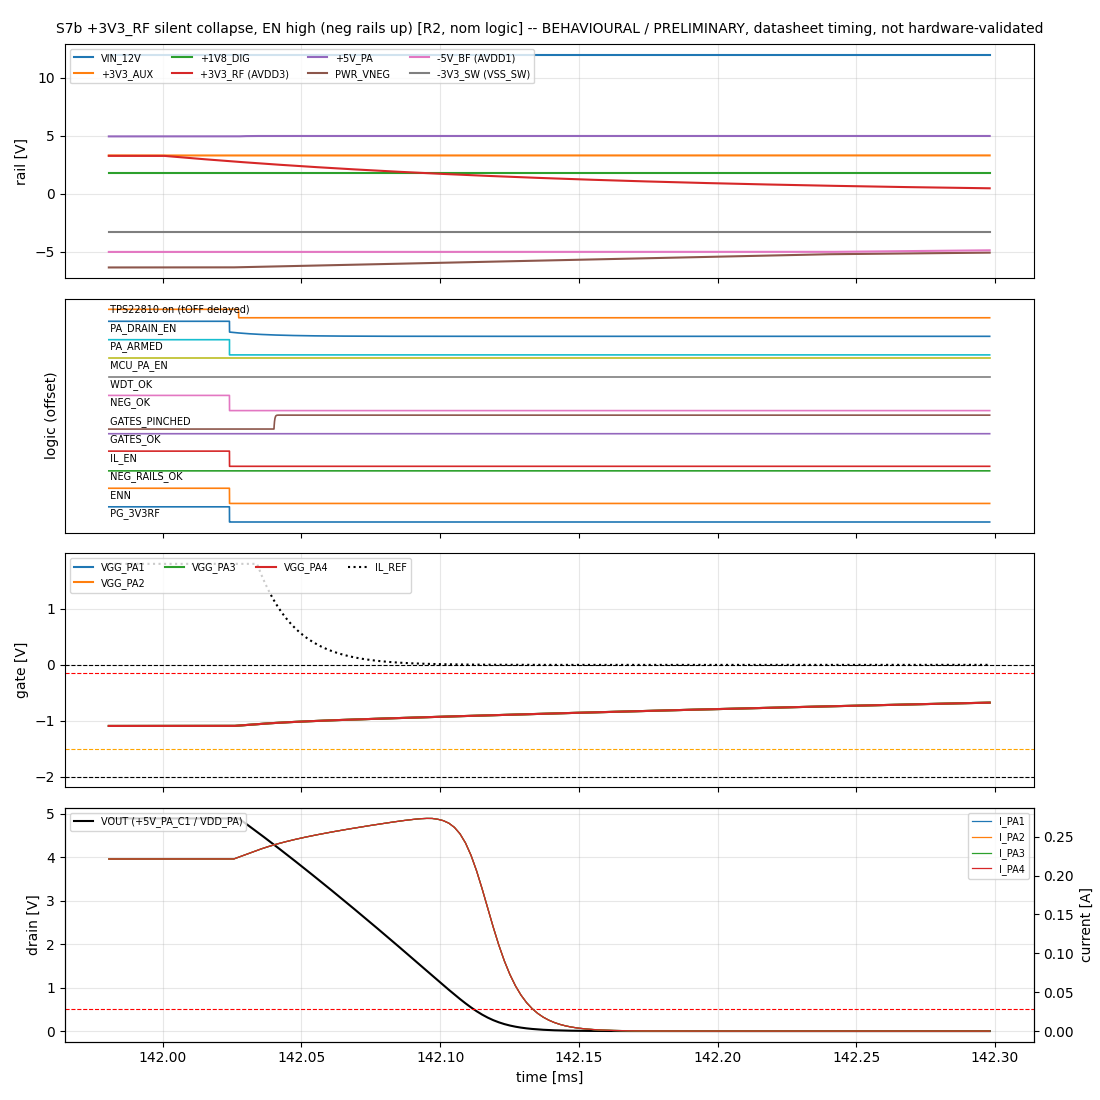
hardware/h2/sim/h2c_s7b_rf_silent_collapse_R2_nom.png
