CLIS-WPI/OpenRU/hardware/h2/reports/H2A_CANDIDATE_BOM.csv

mpn_or_value | symbol | qty_per_tile | refs | footprint | unit_price_usd | extended_usd | price_basis | status
SMA connector (type TBD) | Connector:Conn_Coaxial | 24 | J101 J201 J301 J401 J501 J801 ... (24) | UNRESOLVED | UNVERIFIED | UNVERIFIED |  | SELECTED - KiCad library symbol - DS cross-check pending
ADAR1000ACCZN | openru_x6:ADAR1000 | 4 | UBF1 UBF2 UBF3 UBF4 | UNRESOLVED | UNVERIFIED | UNVERIFIED |  | SELECTED - custom symbol from DS pin table - not qualified
50 | Device:R | 4 | R101 R201 R301 R401 | Resistor_SMD:R_0402_1005Metric | UNVERIFIED | UNVERIFIED |  | PROVISIONAL value (DS value or design choice, see H2A_SCHEMATIC_REVIEW)
1uF | Device:C | 18 | C101 C102 C103 C104 C201 C202 ... (18) | Capacitor_SMD:C_0603_1608Metric | UNVERIFIED | UNVERIFIED |  | PROVISIONAL value (DS value or design choice, see H2A_SCHEMATIC_REVIEW)
ADTR1107ACCZ | openru_x6:ADTR1107 | 16 | UFE1 UFE10 UFE11 UFE12 UFE13 UFE14 ... (16) | UNRESOLVED | 195.69 | 3131.04 | Digi-Key qty 28 (H1.1) | SELECTED - custom symbol from DS pin table - not qualified
10nF | Device:C | 16 | C111 C112 C113 C114 C211 C212 ... (16) | Capacitor_SMD:C_0402_1005Metric | UNVERIFIED | UNVERIFIED |  | PROVISIONAL value (DS value or design choice, see H2A_SCHEMATIC_REVIEW)
100k | Device:R | 21 | R120 R220 R320 R420 R710 R711 ... (21) | Resistor_SMD:R_0402_1005Metric | UNVERIFIED | UNVERIFIED |  | PROVISIONAL value (DS value or design choice, see H2A_SCHEMATIC_REVIEW)
10k | Device:R | 9 | R121 R221 R321 R421 R601 R606 ... (9) | Resistor_SMD:R_0402_1005Metric | UNVERIFIED | UNVERIFIED |  | PROVISIONAL value (DS value or design choice, see H2A_SCHEMATIC_REVIEW)
LTC5553IUDB#PBF | openru_x6:LTC5553 | 4 | UMX1 UMX2 UMX3 UMX4 | UNRESOLVED | UNVERIFIED | UNVERIFIED |  | SELECTED - custom symbol from DS pin table - not qualified
BFCN-1840+ | openru_x6:BFCN-1840+ | 4 | FL101 FL201 FL301 FL401 | UNRESOLVED | UNVERIFIED | UNVERIFIED |  | SELECTED - custom symbol from DS pin table - not qualified
BFCN-8350+ | openru_x6:BFCN-8350+ | 4 | FL102 FL202 FL302 FL402 | UNRESOLVED | 7.23 | 28.92 | Digi-Key qty 1 (H1) | SELECTED - custom symbol from DS pin table - not qualified
HFCN-7150+ | openru_x6:HFCN-7150+ | 4 | FL103 FL203 FL303 FL403 | UNRESOLVED | 5.40 | 21.60 | Digi-Key qty 1 (H1) | SELECTED - custom symbol from DS pin table - not qualified
GJM1555C1H180FB01 | Device:C | 8 | C131 C133 C231 C233 C331 C333 C431 C433 | Capacitor_SMD:C_0402_1005Metric | UNVERIFIED | UNVERIFIED |  | DATASHEET-SPECIFIED (LTC5553 Fig 1)
0402ZK180GBS | Device:C | 4 | C132 C232 C332 C432 | Capacitor_SMD:C_0402_1005Metric | UNVERIFIED | UNVERIFIED |  | DATASHEET-SPECIFIED (LTC5553 Fig 1)
GRM188R71A105KA61 | Device:C | 4 | C134 C234 C334 C434 | Capacitor_SMD:C_0603_1608Metric | UNVERIFIED | UNVERIFIED |  | DATASHEET-SPECIFIED (LTC5553 Fig 1)
ADF4371BCCZ | openru_x6:ADF4371 | 1 | U501 | UNRESOLVED | 474.90 | 474.90 | Digi-Key qty 1 (H1) | SELECTED - custom symbol from DS pin table - not qualified
1k | Device:R | 1 | R501 | Resistor_SMD:R_0402_1005Metric | UNVERIFIED | UNVERIFIED |  | PROVISIONAL value (DS value or design choice, see H2A_SCHEMATIC_REVIEW)
100nF | Device:C | 3 | C503 C504 C701 | Capacitor_SMD:C_0402_1005Metric | UNVERIFIED | UNVERIFIED |  | PROVISIONAL value (DS value or design choice, see H2A_SCHEMATIC_REVIEW)
7.5nH | Device:L | 4 | L501 L502 L503 L504 | Inductor_SMD:L_0402_1005Metric | UNVERIFIED | UNVERIFIED |  | PROVISIONAL value (DS value or design choice, see H2A_SCHEMATIC_REVIEW)
10pF | Device:C | 4 | C505 C506 C507 C508 | Capacitor_SMD:C_0402_1005Metric | UNVERIFIED | UNVERIFIED |  | PROVISIONAL value (DS value or design choice, see H2A_SCHEMATIC_REVIEW)
49.9 | Device:R | 3 | R502 R503 R801 | Resistor_SMD:R_0402_1005Metric | UNVERIFIED | UNVERIFIED |  | PROVISIONAL value (DS value or design choice, see H2A_SCHEMATIC_REVIEW)
AVA-183A+ | openru_x6:AVA-183A+ | 1 | U502 | UNRESOLVED | UNVERIFIED | UNVERIFIED |  | SELECTED - custom symbol from DS pin table - not qualified
294 | Device:R | 2 | R504 R506 | Resistor_SMD:R_0402_1005Metric | UNVERIFIED | UNVERIFIED |  | PROVISIONAL value (DS value or design choice, see H2A_SCHEMATIC_REVIEW)
17.4 | Device:R | 1 | R505 | Resistor_SMD:R_0402_1005Metric | UNVERIFIED | UNVERIFIED |  | PROVISIONAL value (DS value or design choice, see H2A_SCHEMATIC_REVIEW)
EP4RKU+ | openru_x6:EP4RKU+ | 2 | U503 U801 | UNRESOLVED | UNVERIFIED | UNVERIFIED |  | SELECTED - custom symbol from DS pin table - not qualified
EDC21-24+ | openru_x6:EDC21-24+ | 4 | DC801 DC802 DC803 DC804 | UNRESOLVED | UNVERIFIED | UNVERIFIED |  | SELECTED - custom symbol from DS pin table - not qualified
100 | Device:R | 1 | R802 | Resistor_SMD:R_0402_1005Metric | UNVERIFIED | UNVERIFIED |  | PROVISIONAL value (DS value or design choice, see H2A_SCHEMATIC_REVIEW)
74LVC1G125 | 74xGxx:74LVC1G125 | 1 | U802 | Package_TO_SOT_SMD:SOT-23-5 | UNVERIFIED | UNVERIFIED |  | SELECTED - KiCad library symbol - DS cross-check pending
VIN 12V bench | Connector_Generic:Conn_01x02 | 1 | J601 | UNRESOLVED | UNVERIFIED | UNVERIFIED |  | SELECTED - KiCad library symbol - DS cross-check pending
UNRESOLVED_REG | openru_x6:TBD_REG_POS | 6 | U601 U602 U603 U604 U605 U606 | UNRESOLVED | UNVERIFIED | UNVERIFIED |  | PLACEHOLDER - NOT A PART
UNRESOLVED_NEG_REG | openru_x6:TBD_REG_NEG | 2 | U607 U608 | UNRESOLVED | UNVERIFIED | UNVERIFIED |  | PLACEHOLDER - NOT A PART
UNRESOLVED_NEG_MON | openru_x6:TBD_NEG_RAIL_MON | 1 | U609 | UNRESOLVED | UNVERIFIED | UNVERIFIED |  | PLACEHOLDER - NOT A PART
10m | Device:R | 5 | R602 R611 R612 R613 R614 | Resistor_SMD:R_1206_3216Metric | UNVERIFIED | UNVERIFIED |  | PROVISIONAL value (DS value or design choice, see H2A_SCHEMATIC_REVIEW)
TPS22810DRVR | Power_Management:TPS22810DRV | 4 | U621 U622 U623 U624 | UNRESOLVED | UNVERIFIED | UNVERIFIED |  | SELECTED - KiCad library symbol - DS cross-check pending
INA226AIDGSR | Sensor_Energy:INA226 | 5 | U610 U611 U612 U613 U614 | UNRESOLVED | UNVERIFIED | UNVERIFIED |  | SELECTED - KiCad library symbol - DS cross-check pending
PCA9306 | Interface:PCA9306 | 1 | U615 | Package_SO:VSSOP-8_2.3x2mm_P0.5mm | UNVERIFIED | UNVERIFIED |  | SELECTED - KiCad library symbol - DS cross-check pending
200k | Device:R | 1 | R603 | Resistor_SMD:R_0402_1005Metric | UNVERIFIED | UNVERIFIED |  | PROVISIONAL value (DS value or design choice, see H2A_SCHEMATIC_REVIEW)
4.7k | Device:R | 2 | R604 R605 | Resistor_SMD:R_0402_1005Metric | UNVERIFIED | UNVERIFIED |  | PROVISIONAL value (DS value or design choice, see H2A_SCHEMATIC_REVIEW)
STM32G431CBU6 | MCU_ST_STM32G4:STM32G431C_6-8-B_Ux | 1 | U701 | Package_DFN_QFN:QFN-48-1EP_7x7mm_P0.5mm_EP5.6x5.6mm | UNVERIFIED | UNVERIFIED |  | SELECTED - KiCad library symbol - DS cross-check pending
SWD | Connector_Generic:Conn_01x05 | 1 | J701 | UNRESOLVED | UNVERIFIED | UNVERIFIED |  | SELECTED - KiCad library symbol - DS cross-check pending
TPS3430WDRCR | Power_Supervisor:TPS3430WDRC | 1 | U702 | UNRESOLVED | UNVERIFIED | UNVERIFIED |  | SELECTED - KiCad library symbol - DS cross-check pending
74LVC1G11 | 74xGxx:74LVC1G11 | 2 | U703 U705 | Package_TO_SOT_SMD:SOT-23-6 | UNVERIFIED | UNVERIFIED |  | SELECTED - KiCad library symbol - DS cross-check pending
74LVC1G08 | 74xGxx:74LVC1G08 | 1 | U704 | Package_TO_SOT_SMD:SOT-23-5 | UNVERIFIED | UNVERIFIED |  | SELECTED - KiCad library symbol - DS cross-check pending
N310 GPIO / TX interlock | Connector_Generic:Conn_01x04 | 1 | J702 | UNRESOLVED | UNVERIFIED | UNVERIFIED |  | SELECTED - KiCad library symbol - DS cross-check pending
TMP117AIDRVR | Sensor_Temperature:TMP102xxDRL | 2 | U706 U707 | Package_SON:WSON-6-1EP_2x2mm_P0.65mm_EP1x1.6mm | UNVERIFIED | UNVERIFIED |  | SELECTED - KiCad library symbol - DS cross-check pending
2.2k | Device:R | 2 | R703 R704 | Resistor_SMD:R_0402_1005Metric | UNVERIFIED | UNVERIFIED |  | PROVISIONAL value (DS value or design choice, see H2A_SCHEMATIC_REVIEW)
SUMMARY known-price parts |  |  |  |  |  | 3656.46 | ADTR1107 x16 + ADF4371 + BFCN-8350+ x4 + HFCN-7150+ x4 | ADAR1000, LTC5553, EP4RKU+ x2, EDC21-24+ x4, AVA-183A+, BFCN-1840+ x4, regulators, connectors: price UNVERIFIED
