CLIS-WPI/OpenRU/hardware/h2/sim/h2c_results.md

# H2-C sequencing / interlock simulation results -- revision 3 (as built)

**Gating result (as-built design ASB incl. all corners, nominal + pessimistic): FAIL**

**BEHAVIOURAL / PRELIMINARY -- not hardware-validated.** ngspice behavioural models with datasheet timing. Generated by `run_h2c_sim.py`. Every ASB* design gates the exit code; R2 is shown for comparison.

Designs: **R2** = schematic before REC (rev 2: U915 only); **ASB** = as built: REC with CSD16301Q2 / 3x1 ohm / DMG1012T Q2,Q3,Q966 / TPS386000 / BAT54C / TLV75518P; **ASB_cb09** = as built, crowbar VGS(th) 0.9 V (min); **ASB_cb155** = as built, crowbar VGS(th) 1.55 V (max); **ASB_q05** = as built, DMG1012T VGS(th) 0.5 V (Q2, Q3, Q966); **ASB_q10** = as built, DMG1012T VGS(th) 1.0 V (Q2, Q3, Q966); **ASB_toff-** = as built, TPS22810 tOFF -50 % (1.65 us); **ASB_toff+** = as built, TPS22810 tOFF +50 % (4.95 us); **ASB_td20** = as built, supervisor detection delay 20 us; **ASB_td50** = as built, supervisor detection delay 50 us; **ASB_td100** = as built, supervisor detection delay 100 us; **ASB_slow** = as built, slow-crowbar corner: Q2 0.5 V, crowbar 1.55 V, supervisor 100 us; **ASB_ovl** = as built, overlap corner: Q2 1.0 V, crowbar 0.9 V, tOFF +50 %; **FIX** = candidate M5 fix (not built): BAT54C clamps replaced by 2 x DMG1012T on IL_Q3G; R976 fed from supervisor VDD OR +1V8_DIG; **FIX_slow** = FIX at the slow corner; **FIX_ovl** = FIX at the overlap corner

Logic modes: **nom** = nominal thresholds; **pess** = every comparator / LVC / enable input inside its undefined band taken as HIGH / ON (LVC with VCC < 1.65 V outputs VCC, flop SET).

## Scenario suite: safety result per design / logic mode

| scenario | ASB/nom | ASB/pess | R2/nom | R2/pess | ASB_cb09/pess | ASB_cb155/pess | ASB_q05/pess | ASB_q10/pess | ASB_toff-/pess | ASB_toff+/pess | ASB_td20/pess | ASB_td50/pess | ASB_td100/pess | ASB_slow/pess | ASB_ovl/pess | FIX/nom | FIX/pess | FIX_slow/pess | FIX_ovl/pess |
|---|---|---|---|---|---|---|---|---|---|---|---|---|---|---|---|---|---|---|---|
| S1 normal power-up | PASS | PASS | PASS | **FAIL** EN,G,M5b,REF | PASS | PASS | PASS | PASS | PASS | PASS | PASS | PASS | PASS | PASS | PASS | PASS | PASS | PASS | **FAIL** EN,M5b |
| S2 MCU_PA_EN with unprogrammed / unpinched gates | PASS | PASS | PASS | **FAIL** EN,G,M5b,REF | PASS | PASS | PASS | PASS | PASS | PASS | PASS | PASS | PASS | PASS | PASS | PASS | PASS | PASS | **FAIL** EN,M5b |
| S3 gate lost during TX | PASS | PASS | **FAIL** A,T50 | **FAIL** A,EN,G,M5b,REF,T50 | PASS | PASS | PASS | PASS | PASS | PASS | PASS | PASS | PASS | PASS | PASS | PASS | PASS | PASS | **FAIL** EN,M5b |
| S4a -5V_BF collapse via TPS65131 ENN | PASS | PASS | **FAIL** A,T50 | **FAIL** A,EN,G,M5b,REF,T50 | PASS | PASS | PASS | PASS | PASS | PASS | PASS | PASS | PASS | PASS | PASS | PASS | PASS | PASS | **FAIL** EN,M5b |
| S4b -5V_BF collapse via TPS7A33 disable | PASS | PASS | **FAIL** A,T50 | **FAIL** A,EN,G,M5b,REF,T50 | PASS | PASS | PASS | PASS | PASS | PASS | PASS | PASS | PASS | PASS | PASS | PASS | PASS | PASS | **FAIL** EN,M5b |
| S5a watchdog fault during TX + recovery | PASS | PASS | **FAIL** A,T50 | **FAIL** A,EN,G,M5b,REF,T50 | PASS | PASS | PASS | PASS | PASS | PASS | PASS | PASS | PASS | PASS | PASS | PASS | PASS | PASS | **FAIL** EN,M5b |
| S5b watchdog fault while armed, gates pinched | PASS | PASS | **FAIL** T50 | **FAIL** EN,G,M5b,REF,T50 | PASS | PASS | PASS | PASS | PASS | PASS | PASS | PASS | PASS | PASS | PASS | PASS | PASS | PASS | **FAIL** EN,M5b |
| S6 VIN_12V loss during TX | PASS | PASS | **FAIL** A,T50 | **FAIL** A,EN,G,M5b,PA_DRAIN_EN,REF,T50 | PASS | PASS | PASS | PASS | PASS | PASS | PASS | PASS | PASS | PASS | PASS | PASS | PASS | PASS | **FAIL** EN,M5b |
| S7a +3V3_RF lost via PWR_EN_3V3 (neg rails up) | PASS | PASS | **FAIL** A,T50 | **FAIL** A,EN,G,M5b,REF,T50 | PASS | PASS | PASS | PASS | PASS | PASS | PASS | PASS | PASS | PASS | PASS | PASS | PASS | PASS | **FAIL** EN,M5b |
| S7b +3V3_RF silent collapse, EN high (neg rails up) | PASS | PASS | **FAIL** A,T50 | **FAIL** A,EN,G,M5b,REF,T50 | PASS | PASS | PASS | PASS | PASS | PASS | PASS | PASS | PASS | PASS | PASS | PASS | PASS | PASS | **FAIL** EN,M5b |

## Fault response (times from the fault threshold crossing)

| scenario | design/mode | switch open | drain < 0.5 V | residual PA energy | peak PA I | crowbar peak / energy | crowbar starts after switch open | crowbar off before VOUT ramp |
|---|---|---|---|---|---|---|---|---|
| S3 gate lost during TX | R2/nom | 4.5 us | 73.5 us | 0.232 mJ | 0.601 A | - | - | - |
| S3 gate lost during TX | ASB/nom | 4.5 us | 26.3 us | 0.086 mJ | 0.601 A | 8.5 A / 0.147 mJ | 9.0 us | 126.4 us |
| S3 gate lost during TX | ASB/pess | 4.5 us | 26.3 us | 0.086 mJ | 0.601 A | 8.5 A / 0.147 mJ | 9.0 us | 126.3 us |
| S4a -5V_BF collapse via TPS65131 ENN | R2/nom | 6.3 us | 106.0 us | 0.235 mJ | 0.221 A | - | - | - |
| S4a -5V_BF collapse via TPS65131 ENN | ASB/nom | 6.3 us | 29.1 us | 0.063 mJ | 0.221 A | 9.0 A / 0.174 mJ | 8.7 us | 126.3 us |
| S4a -5V_BF collapse via TPS65131 ENN | ASB/pess | 6.3 us | 29.1 us | 0.063 mJ | 0.221 A | 9.0 A / 0.174 mJ | 8.7 us | 126.3 us |
| S4b -5V_BF collapse via TPS7A33 disable | R2/nom | 7.1 us | 106.8 us | 0.235 mJ | 0.221 A | - | - | - |
| S4b -5V_BF collapse via TPS7A33 disable | ASB/nom | 7.6 us | 30.3 us | 0.063 mJ | 0.221 A | 9.0 A / 0.174 mJ | 8.7 us | 126.3 us |
| S4b -5V_BF collapse via TPS7A33 disable | ASB/pess | 7.6 us | 30.3 us | 0.063 mJ | 0.221 A | 9.0 A / 0.174 mJ | 8.7 us | 126.3 us |
| S5a watchdog fault during TX + recovery | R2/nom | 3.8 us | 103.1 us | 0.235 mJ | 0.221 A | - | - | - |
| S5a watchdog fault during TX + recovery | ASB/nom | 3.8 us | 26.8 us | 0.064 mJ | 0.221 A | 9.0 A / 0.173 mJ | 8.9 us | 126.3 us |
| S5a watchdog fault during TX + recovery | ASB/pess | 3.8 us | 26.8 us | 0.064 mJ | 0.221 A | 9.0 A / 0.173 mJ | 8.9 us | 126.3 us |
| S5b watchdog fault while armed, gates pinched | R2/nom | 3.8 us | 7179.8 us | 0.114 mJ | 0.002 A | - | - | - |
| S5b watchdog fault while armed, gates pinched | ASB/nom | 3.8 us | 30.3 us | 0.001 mJ | 0.002 A | 10.4 A / 0.247 mJ | 8.9 us | 126.3 us |
| S5b watchdog fault while armed, gates pinched | ASB/pess | 3.8 us | 30.3 us | 0.001 mJ | 0.002 A | 10.4 A / 0.247 mJ | 8.9 us | 126.3 us |
| S6 VIN_12V loss during TX | R2/nom | 4.8 us | 104.4 us | 0.235 mJ | 0.221 A | - | - | - |
| S6 VIN_12V loss during TX | ASB/nom | 4.8 us | 27.2 us | 0.062 mJ | 0.221 A | 9.1 A / 0.175 mJ | 8.5 us | 126.3 us |
| S6 VIN_12V loss during TX | ASB/pess | 4.8 us | 27.2 us | 0.062 mJ | 0.221 A | 9.1 A / 0.175 mJ | 8.5 us | 126.3 us |
| S7a +3V3_RF lost via PWR_EN_3V3 (neg rails up) | R2/nom | 3.8 us | 96.0 us | 0.235 mJ | 0.252 A | - | - | - |
| S7a +3V3_RF lost via PWR_EN_3V3 (neg rails up) | ASB/nom | 3.8 us | 25.9 us | 0.060 mJ | 0.221 A | 9.1 A / 0.177 mJ | 8.0 us | 126.3 us |
| S7a +3V3_RF lost via PWR_EN_3V3 (neg rails up) | ASB/pess | 3.8 us | 25.9 us | 0.060 mJ | 0.221 A | 9.1 A / 0.176 mJ | 8.1 us | 126.3 us |
| S7b +3V3_RF silent collapse, EN high (neg rails up) | R2/nom | 3.3 us | 88.1 us | 0.235 mJ | 0.274 A | - | - | - |
| S7b +3V3_RF silent collapse, EN high (neg rails up) | ASB/nom | 0.0 us | 14.4 us | 0.029 mJ | 0.224 A | 9.0 A / 0.172 mJ | 9.1 us | 126.3 us |
| S7b +3V3_RF silent collapse, EN high (neg rails up) | ASB/pess | 0.0 us | 14.4 us | 0.029 mJ | 0.224 A | 9.0 A / 0.172 mJ | 9.1 us | 126.3 us |

## Corners (pessimistic logic, worst over all scenarios with a fault)

| corner | safety | worst drain < 0.5 V | worst switch open | max PA energy | max peak PA I | max crowbar peak | min crowbar start after switch open | min crowbar-off before VOUT ramp | max crowbar/switch overlap |
|---|---|---|---|---|---|---|---|---|---|
| ASB | PASS | 30.3 us | 7.6 us | 0.086 mJ | 0.601 A | 10.4 A | 8.1 us | 126.3 us | 0.00 us |
| ASB_cb09 | PASS | 30.3 us | 7.6 us | 0.086 mJ | 0.601 A | 10.3 A | 8.0 us | 126.3 us | 0.00 us |
| ASB_cb155 | PASS | 30.5 us | 7.6 us | 0.087 mJ | 0.601 A | 10.5 A | 8.3 us | 126.3 us | 0.00 us |
| ASB_q05 | PASS | 35.8 us | 7.6 us | 0.112 mJ | 0.601 A | 10.4 A | 13.5 us | 129.4 us | 0.00 us |
| ASB_q10 | PASS | 26.6 us | 7.6 us | 0.066 mJ | 0.601 A | 10.4 A | 4.3 us | 122.5 us | 0.00 us |
| ASB_toff- | PASS | 30.3 us | 5.9 us | 0.094 mJ | 0.601 A | 10.3 A | 9.7 us | 124.7 us | 0.00 us |
| ASB_toff+ | PASS | 30.4 us | 9.2 us | 0.078 mJ | 0.601 A | 10.3 A | 6.5 us | 128.0 us | 0.00 us |
| ASB_td20 | PASS | 30.3 us | 7.6 us | 0.086 mJ | 0.601 A | 10.4 A | 8.1 us | 126.3 us | 0.00 us |
| ASB_td50 | PASS | 30.3 us | 7.6 us | 0.086 mJ | 0.601 A | 10.4 A | 8.1 us | 126.3 us | 0.00 us |
| ASB_td100 | PASS | 30.4 us | 7.6 us | 0.086 mJ | 0.601 A | 10.4 A | 8.1 us | 126.3 us | 0.00 us |
| ASB_slow | PASS | 36.0 us | 7.6 us | 0.113 mJ | 0.601 A | 10.6 A | 13.7 us | 129.4 us | 0.00 us |
| ASB_ovl | PASS | 26.6 us | 9.2 us | 0.057 mJ | 0.601 A | 10.3 A | 2.5 us | 124.1 us | 0.00 us |
| FIX | PASS | 30.3 us | 7.6 us | 0.086 mJ | 0.601 A | 10.4 A | 6.1 us | 126.3 us | 0.00 us |
| FIX_slow | PASS | 36.0 us | 7.6 us | 0.113 mJ | 0.601 A | 10.6 A | 10.0 us | 129.4 us | 0.00 us |
| FIX_ovl | **FAIL** (20) | 26.6 us | 9.2 us | 0.057 mJ | 0.601 A | 10.3 A | 1.7 us | 124.1 us | 0.00 us |

## M5: PG_3V3RF sink level and BAT54C clamps (worst over every as-built run, scenarios + ordering)

| design/mode | max PG_3V3RF while asserted (TLV755 EN off <= 0.3 V) | max clamped PA_DRAIN_EN (< 1.08 V) | max IL_CLR_N - VIL (< 0) | max TPS386000 sink (<= 5 mA) |
|---|---|---|---|---|
| ASB/nom | 0.068 V | 0.322 V | -577 mV | 4.44 mA |
| ASB/pess | 0.661 V | 0.974 V | +345 mV | 4.38 mA |
| ASB_cb09/pess | 0.222 V | 0.546 V | -577 mV | 4.29 mA |
| ASB_cb155/pess | 0.222 V | 0.546 V | -577 mV | 4.29 mA |
| ASB_ovl/pess | 0.661 V | 0.974 V | +345 mV | 4.40 mA |
| ASB_q05/pess | 0.222 V | 0.546 V | -577 mV | 4.29 mA |
| ASB_q10/pess | 0.222 V | 0.546 V | -577 mV | 4.05 mA |
| ASB_slow/pess | 0.661 V | 0.974 V | +345 mV | 4.29 mA |
| ASB_td100/pess | 0.661 V | 0.974 V | +345 mV | 4.29 mA |
| ASB_td20/pess | 0.661 V | 0.974 V | +345 mV | 4.29 mA |
| ASB_td50/pess | 0.661 V | 0.974 V | +345 mV | 4.29 mA |
| ASB_toff+/pess | 0.222 V | 0.546 V | -577 mV | 4.29 mA |
| ASB_toff-/pess | 0.222 V | 0.546 V | -577 mV | 3.83 mA |
| FIX/nom | 0.007 V | 0.438 V | -577 mV | 4.34 mA |
| FIX/pess | 0.007 V | 1.626 V | -576 mV | 4.34 mA |
| FIX_ovl/pess | 0.007 V | 1.627 V | -576 mV | 4.34 mA |
| FIX_slow/pess | 0.007 V | 0.820 V | -576 mV | 4.34 mA |

## Ordering test (920 runs per design: 720 start/stop permutations + 200 random)

| design/mode | failing runs | failures by criterion | worst VGG max | worst VGG min | worst drain < 0.5 V after fault | worst switch open | crowbar overlap max / min start after switch open |
|---|---|---|---|---|---|---|---|
| ASB/nom | 0 / 920 | - | +2 mV (R012) | -1.750 V (R119) | 34.1 us (R180) | 4.6 us (R037) | 0.00 us / 7.9 us |
| ASB/pess | 635 / 920 | A:5, M5a:635, M5c:53, T50:101 | +2 mV (R012) | -1.750 V (R119) | 50.3 us (P497) | 4.6 us (R037) | 0.00 us / 8.0 us |
| ASB_td20/pess | 635 / 920 | (a):128, A:104, CB:2, EN:238, M5a:633, M5c:53, T50:104 | +2 mV (R037) | -1.750 V (R119) | 58.5 us (P053) | 22.4 us (P498) | 1.51 us / 8.0 us |
| ASB_td50/pess | 635 / 920 | (a):126, A:105, CB:5, EN:242, M5a:632, M5c:52, REF:178, T50:105 | +2 mV (R174) | -1.750 V (R129) | 77.0 us (P053) | 50.2 us (P082) | 4.03 us / 7.4 us |
| ASB_td100/pess | 635 / 920 | (a):124, A:103, CB:5, EN:243, M5a:468, M5c:53, REF:178, T50:103 | +2 mV (R037) | -1.750 V (P569) | 104.1 us (P018) | 50.2 us (P082) | 4.03 us / 7.7 us |
| ASB_slow/pess | 635 / 920 | (a):124, A:104, CB:6, EN:243, M5a:467, M5c:59, REF:190, T50:104 | +2 mV (R174) | -1.750 V (R129) | 120.8 us (P082) | 50.2 us (P082) | 0.96 us / 13.7 us |
| ASB_ovl/pess | 635 / 920 | M5a:635, M5c:53 | +2 mV (R126) | -1.750 V (R008) | 31.8 us (P492) | 6.2 us (P547) | 0.00 us / 2.5 us |
| R2/nom | 666 / 920 | A:638, EN:9, G:6, REF:16, T50:661 | +128 mV (R057) | -1.750 V (R133) | 9486.7 us (R069) | 4.8 us (R145) | - |
| FIX/nom | 0 / 920 | - | +2 mV (R126) | -1.750 V (R119) | 34.1 us (R180) | 4.6 us (R037) | 0.00 us / 5.8 us |
| FIX/pess | 76 / 920 | CB:2, EN:47, M5b:33 | +2 mV (R037) | -1.750 V (P545) | 34.1 us (R180) | 4.6 us (R037) | 1.00 us / 4.7 us |
| FIX_slow/pess | 243 / 920 | (a):124, A:103, CB:6, EN:243, REF:178, T50:103 | +2 mV (R126) | -1.750 V (R129) | 114.0 us (P546) | 50.2 us (P082) | 0.96 us / 8.7 us |
| FIX_ovl/pess | 379 / 920 | EN:223, M5b:379 | +2 mV (R126) | -1.750 V (R119) | 29.6 us (R180) | 6.2 us (P547) | 0.00 us / 0.2 us |

## Every as-built FAIL

- ASB/pess ordering P000: M5a: PG_3V3RF <= 0.3 V whenever asserted (TLV755 EN guaranteed off) -- max 0.550 V
- ASB/pess ordering P001: T50: drain < 0.5 V within 50 us of 'fault@13.887ms' -- VOUT < 0.5 V at +50.2 us; VOUT at +50 us = 0.53 V
- ASB/pess ordering P001: M5a: PG_3V3RF <= 0.3 V whenever asserted (TLV755 EN guaranteed off) -- max 0.643 V
- ASB/pess ordering P003: M5a: PG_3V3RF <= 0.3 V whenever asserted (TLV755 EN guaranteed off) -- max 0.550 V
- ASB/pess ordering P004: T50: drain < 0.5 V within 50 us of 'fault@13.707ms' -- VOUT < 0.5 V at +50.1 us; VOUT at +50 us = 0.51 V
- ASB/pess ordering P004: M5a: PG_3V3RF <= 0.3 V whenever asserted (TLV755 EN guaranteed off) -- max 0.643 V
- ASB/pess ordering P005: T50: drain < 0.5 V within 50 us of 'fault@14.327ms' -- VOUT < 0.5 V at +50.2 us; VOUT at +50 us = 0.52 V
- ASB/pess ordering P005: M5a: PG_3V3RF <= 0.3 V whenever asserted (TLV755 EN guaranteed off) -- max 0.642 V
- ASB/pess ordering P006: M5a: PG_3V3RF <= 0.3 V whenever asserted (TLV755 EN guaranteed off) -- max 0.528 V
- ASB/pess ordering P009: M5a: PG_3V3RF <= 0.3 V whenever asserted (TLV755 EN guaranteed off) -- max 0.550 V
- ASB/pess ordering P010: T50: drain < 0.5 V within 50 us of 'fault@14.420ms' -- VOUT < 0.5 V at +50.2 us; VOUT at +50 us = 0.52 V
- ASB/pess ordering P010: M5a: PG_3V3RF <= 0.3 V whenever asserted (TLV755 EN guaranteed off) -- max 0.643 V
- ASB/pess ordering P011: M5a: PG_3V3RF <= 0.3 V whenever asserted (TLV755 EN guaranteed off) -- max 0.550 V
- ASB/pess ordering P012: M5a: PG_3V3RF <= 0.3 V whenever asserted (TLV755 EN guaranteed off) -- max 0.526 V
- ASB/pess ordering P015: M5a: PG_3V3RF <= 0.3 V whenever asserted (TLV755 EN guaranteed off) -- max 0.545 V
- ASB/pess ordering P018: T50: drain < 0.5 V within 50 us of 'fault@14.248ms' -- VOUT < 0.5 V at +50.2 us; VOUT at +50 us = 0.53 V
- ASB/pess ordering P018: M5a: PG_3V3RF <= 0.3 V whenever asserted (TLV755 EN guaranteed off) -- max 0.640 V
- ASB/pess ordering P019: T50: drain < 0.5 V within 50 us of 'fault@14.593ms' -- VOUT < 0.5 V at +50.2 us; VOUT at +50 us = 0.53 V
- ASB/pess ordering P019: M5a: PG_3V3RF <= 0.3 V whenever asserted (TLV755 EN guaranteed off) -- max 0.643 V
- ASB/pess ordering P020: M5a: PG_3V3RF <= 0.3 V whenever asserted (TLV755 EN guaranteed off) -- max 0.539 V
- ASB/pess ordering P021: M5a: PG_3V3RF <= 0.3 V whenever asserted (TLV755 EN guaranteed off) -- max 0.642 V
- ASB/pess ordering P023: M5a: PG_3V3RF <= 0.3 V whenever asserted (TLV755 EN guaranteed off) -- max 0.550 V
- ASB/pess ordering P024: M5a: PG_3V3RF <= 0.3 V whenever asserted (TLV755 EN guaranteed off) -- max 0.550 V
- ASB/pess ordering P025: T50: drain < 0.5 V within 50 us of 'fault@14.085ms' -- VOUT < 0.5 V at +50.2 us; VOUT at +50 us = 0.52 V
- ASB/pess ordering P025: M5a: PG_3V3RF <= 0.3 V whenever asserted (TLV755 EN guaranteed off) -- max 0.643 V
- ASB/pess ordering P029: M5a: PG_3V3RF <= 0.3 V whenever asserted (TLV755 EN guaranteed off) -- max 0.550 V
- ASB/pess ordering P030: M5a: PG_3V3RF <= 0.3 V whenever asserted (TLV755 EN guaranteed off) -- max 0.595 V
- ASB/pess ordering P033: M5a: PG_3V3RF <= 0.3 V whenever asserted (TLV755 EN guaranteed off) -- max 0.525 V
- ASB/pess ordering P034: M5a: PG_3V3RF <= 0.3 V whenever asserted (TLV755 EN guaranteed off) -- max 0.595 V
- ASB/pess ordering P036: M5a: PG_3V3RF <= 0.3 V whenever asserted (TLV755 EN guaranteed off) -- max 0.525 V
- ASB/pess ordering P037: T50: drain < 0.5 V within 50 us of 'fault@15.721ms' -- VOUT < 0.5 V at +50.2 us; VOUT at +50 us = 0.53 V
- ASB/pess ordering P037: M5a: PG_3V3RF <= 0.3 V whenever asserted (TLV755 EN guaranteed off) -- max 0.643 V
- ASB/pess ordering P039: T50: drain < 0.5 V within 50 us of 'fault@15.372ms' -- VOUT < 0.5 V at +50.2 us; VOUT at +50 us = 0.52 V
- ASB/pess ordering P039: M5a: PG_3V3RF <= 0.3 V whenever asserted (TLV755 EN guaranteed off) -- max 0.642 V
- ASB/pess ordering P040: M5a: PG_3V3RF <= 0.3 V whenever asserted (TLV755 EN guaranteed off) -- max 0.595 V
- ASB/pess ordering P041: M5a: PG_3V3RF <= 0.3 V whenever asserted (TLV755 EN guaranteed off) -- max 0.595 V
- ASB/pess ordering P042: M5a: PG_3V3RF <= 0.3 V whenever asserted (TLV755 EN guaranteed off) -- max 0.550 V
- ASB/pess ordering P043: M5a: PG_3V3RF <= 0.3 V whenever asserted (TLV755 EN guaranteed off) -- max 0.550 V
- ASB/pess ordering P044: M5a: PG_3V3RF <= 0.3 V whenever asserted (TLV755 EN guaranteed off) -- max 0.591 V
- ASB/pess ordering P045: T50: drain < 0.5 V within 50 us of 'fault@17.852ms' -- VOUT < 0.5 V at +50.2 us; VOUT at +50 us = 0.53 V
- ASB/pess ordering P045: M5a: PG_3V3RF <= 0.3 V whenever asserted (TLV755 EN guaranteed off) -- max 0.640 V
- ASB/pess ordering P046: M5a: PG_3V3RF <= 0.3 V whenever asserted (TLV755 EN guaranteed off) -- max 0.525 V
- ASB/pess ordering P048: M5a: PG_3V3RF <= 0.3 V whenever asserted (TLV755 EN guaranteed off) -- max 0.550 V
- ASB/pess ordering P051: T50: drain < 0.5 V within 50 us of 'fault@15.976ms' -- VOUT < 0.5 V at +50.2 us; VOUT at +50 us = 0.53 V
- ASB/pess ordering P051: M5a: PG_3V3RF <= 0.3 V whenever asserted (TLV755 EN guaranteed off) -- max 0.640 V
- ASB/pess ordering P053: M5a: PG_3V3RF <= 0.3 V whenever asserted (TLV755 EN guaranteed off) -- max 0.642 V
- ASB/pess ordering P054: M5a: PG_3V3RF <= 0.3 V whenever asserted (TLV755 EN guaranteed off) -- max 0.550 V
- ASB/pess ordering P055: M5a: PG_3V3RF <= 0.3 V whenever asserted (TLV755 EN guaranteed off) -- max 0.640 V
- ASB/pess ordering P056: M5a: PG_3V3RF <= 0.3 V whenever asserted (TLV755 EN guaranteed off) -- max 0.550 V
- ASB/pess ordering P057: T50: drain < 0.5 V within 50 us of 'fault@17.404ms' -- VOUT < 0.5 V at +50.2 us; VOUT at +50 us = 0.52 V
- ASB/pess ordering P057: M5a: PG_3V3RF <= 0.3 V whenever asserted (TLV755 EN guaranteed off) -- max 0.642 V
- ASB/pess ordering P057: M5c: clamped IL_CLR_N < LVC VIL (0.35 VCC) while PG_3V3RF asserted, VCC valid -- max margin +327 mV
- ASB/pess ordering P059: T50: drain < 0.5 V within 50 us of 'fault@17.130ms' -- VOUT < 0.5 V at +50.2 us; VOUT at +50 us = 0.53 V
- ASB/pess ordering P059: M5a: PG_3V3RF <= 0.3 V whenever asserted (TLV755 EN guaranteed off) -- max 0.640 V
- ASB/pess ordering P059: M5c: clamped IL_CLR_N < LVC VIL (0.35 VCC) while PG_3V3RF asserted, VCC valid -- max margin +326 mV
- ASB/pess ordering P062: M5a: PG_3V3RF <= 0.3 V whenever asserted (TLV755 EN guaranteed off) -- max 0.550 V
- ASB/pess ordering P063: T50: drain < 0.5 V within 50 us of 'fault@17.275ms' -- VOUT < 0.5 V at +50.2 us; VOUT at +50 us = 0.52 V
- ASB/pess ordering P063: M5a: PG_3V3RF <= 0.3 V whenever asserted (TLV755 EN guaranteed off) -- max 0.642 V
- ASB/pess ordering P064: M5a: PG_3V3RF <= 0.3 V whenever asserted (TLV755 EN guaranteed off) -- max 0.550 V
- ASB/pess ordering P065: M5a: PG_3V3RF <= 0.3 V whenever asserted (TLV755 EN guaranteed off) -- max 0.550 V
- ASB/pess ordering P066: M5a: PG_3V3RF <= 0.3 V whenever asserted (TLV755 EN guaranteed off) -- max 0.550 V
- ASB/pess ordering P067: M5a: PG_3V3RF <= 0.3 V whenever asserted (TLV755 EN guaranteed off) -- max 0.642 V
- ASB/pess ordering P071: T50: drain < 0.5 V within 50 us of 'fault@17.543ms' -- VOUT < 0.5 V at +50.2 us; VOUT at +50 us = 0.53 V
- ASB/pess ordering P071: M5a: PG_3V3RF <= 0.3 V whenever asserted (TLV755 EN guaranteed off) -- max 0.640 V
- ASB/pess ordering P072: M5a: PG_3V3RF <= 0.3 V whenever asserted (TLV755 EN guaranteed off) -- max 0.526 V
- ASB/pess ordering P073: M5a: PG_3V3RF <= 0.3 V whenever asserted (TLV755 EN guaranteed off) -- max 0.550 V
- ASB/pess ordering P074: M5a: PG_3V3RF <= 0.3 V whenever asserted (TLV755 EN guaranteed off) -- max 0.641 V
- ASB/pess ordering P075: M5a: PG_3V3RF <= 0.3 V whenever asserted (TLV755 EN guaranteed off) -- max 0.550 V
- ASB/pess ordering P076: M5a: PG_3V3RF <= 0.3 V whenever asserted (TLV755 EN guaranteed off) -- max 0.550 V
- ASB/pess ordering P077: M5a: PG_3V3RF <= 0.3 V whenever asserted (TLV755 EN guaranteed off) -- max 0.525 V
- ASB/pess ordering P078: M5a: PG_3V3RF <= 0.3 V whenever asserted (TLV755 EN guaranteed off) -- max 0.550 V
- ASB/pess ordering P079: T50: drain < 0.5 V within 50 us of 'fault@16.578ms' -- VOUT < 0.5 V at +50.2 us; VOUT at +50 us = 0.52 V
- ASB/pess ordering P079: M5a: PG_3V3RF <= 0.3 V whenever asserted (TLV755 EN guaranteed off) -- max 0.642 V
- ASB/pess ordering P081: T50: drain < 0.5 V within 50 us of 'fault@15.065ms' -- VOUT < 0.5 V at +50.3 us; VOUT at +50 us = 0.53 V
- ASB/pess ordering P081: M5a: PG_3V3RF <= 0.3 V whenever asserted (TLV755 EN guaranteed off) -- max 0.643 V
- ASB/pess ordering P082: T50: drain < 0.5 V within 50 us of 'fault@16.457ms' -- VOUT < 0.5 V at +50.2 us; VOUT at +50 us = 0.52 V
- ASB/pess ordering P082: M5a: PG_3V3RF <= 0.3 V whenever asserted (TLV755 EN guaranteed off) -- max 0.640 V
- ASB/pess ordering P083: T50: drain < 0.5 V within 50 us of 'fault@14.730ms' -- VOUT < 0.5 V at +50.2 us; VOUT at +50 us = 0.53 V
- ASB/pess ordering P083: M5a: PG_3V3RF <= 0.3 V whenever asserted (TLV755 EN guaranteed off) -- max 0.642 V
- ASB/pess ordering P084: T50: drain < 0.5 V within 50 us of 'fault@14.704ms' -- VOUT < 0.5 V at +50.2 us; VOUT at +50 us = 0.53 V
- ASB/pess ordering P084: M5a: PG_3V3RF <= 0.3 V whenever asserted (TLV755 EN guaranteed off) -- max 0.643 V
- ASB/pess ordering P085: M5a: PG_3V3RF <= 0.3 V whenever asserted (TLV755 EN guaranteed off) -- max 0.550 V
- ASB/pess ordering P086: M5a: PG_3V3RF <= 0.3 V whenever asserted (TLV755 EN guaranteed off) -- max 0.550 V
- ASB/pess ordering P087: M5a: PG_3V3RF <= 0.3 V whenever asserted (TLV755 EN guaranteed off) -- max 0.594 V
- ASB/pess ordering P092: M5a: PG_3V3RF <= 0.3 V whenever asserted (TLV755 EN guaranteed off) -- max 0.550 V
- ASB/pess ordering P095: T50: drain < 0.5 V within 50 us of 'fault@17.112ms' -- VOUT < 0.5 V at +50.2 us; VOUT at +50 us = 0.53 V
- ASB/pess ordering P095: M5a: PG_3V3RF <= 0.3 V whenever asserted (TLV755 EN guaranteed off) -- max 0.640 V
- ASB/pess ordering P096: M5a: PG_3V3RF <= 0.3 V whenever asserted (TLV755 EN guaranteed off) -- max 0.550 V
- ASB/pess ordering P098: M5a: PG_3V3RF <= 0.3 V whenever asserted (TLV755 EN guaranteed off) -- max 0.550 V
- ASB/pess ordering P099: M5a: PG_3V3RF <= 0.3 V whenever asserted (TLV755 EN guaranteed off) -- max 0.550 V
- ASB/pess ordering P103: M5a: PG_3V3RF <= 0.3 V whenever asserted (TLV755 EN guaranteed off) -- max 0.550 V
- ASB/pess ordering P104: T50: drain < 0.5 V within 50 us of 'fault@14.779ms' -- VOUT < 0.5 V at +50.2 us; VOUT at +50 us = 0.52 V
- ASB/pess ordering P104: M5a: PG_3V3RF <= 0.3 V whenever asserted (TLV755 EN guaranteed off) -- max 0.642 V
- ASB/pess ordering P105: M5a: PG_3V3RF <= 0.3 V whenever asserted (TLV755 EN guaranteed off) -- max 0.550 V
- ASB/pess ordering P108: M5a: PG_3V3RF <= 0.3 V whenever asserted (TLV755 EN guaranteed off) -- max 0.542 V
- ASB/pess ordering P109: M5a: PG_3V3RF <= 0.3 V whenever asserted (TLV755 EN guaranteed off) -- max 0.534 V
- ASB/pess ordering P110: M5a: PG_3V3RF <= 0.3 V whenever asserted (TLV755 EN guaranteed off) -- max 0.550 V
- ASB/pess ordering P111: T50: drain < 0.5 V within 50 us of 'fault@15.819ms' -- VOUT < 0.5 V at +50.2 us; VOUT at +50 us = 0.52 V
- ASB/pess ordering P111: M5a: PG_3V3RF <= 0.3 V whenever asserted (TLV755 EN guaranteed off) -- max 0.643 V
- ASB/pess ordering P113: M5a: PG_3V3RF <= 0.3 V whenever asserted (TLV755 EN guaranteed off) -- max 0.643 V
- ASB/pess ordering P114: M5a: PG_3V3RF <= 0.3 V whenever asserted (TLV755 EN guaranteed off) -- max 0.550 V
- ASB/pess ordering P117: M5a: PG_3V3RF <= 0.3 V whenever asserted (TLV755 EN guaranteed off) -- max 0.550 V
- ASB/pess ordering P118: M5a: PG_3V3RF <= 0.3 V whenever asserted (TLV755 EN guaranteed off) -- max 0.550 V
- ASB/pess ordering P119: M5a: PG_3V3RF <= 0.3 V whenever asserted (TLV755 EN guaranteed off) -- max 0.550 V
- ASB/pess ordering P120: M5a: PG_3V3RF <= 0.3 V whenever asserted (TLV755 EN guaranteed off) -- max 0.550 V
- ASB/pess ordering P121: M5a: PG_3V3RF <= 0.3 V whenever asserted (TLV755 EN guaranteed off) -- max 0.550 V
- ASB/pess ordering P123: M5a: PG_3V3RF <= 0.3 V whenever asserted (TLV755 EN guaranteed off) -- max 0.550 V
- ASB/pess ordering P124: M5a: PG_3V3RF <= 0.3 V whenever asserted (TLV755 EN guaranteed off) -- max 0.550 V
- ASB/pess ordering P125: T50: drain < 0.5 V within 50 us of 'fault@13.670ms' -- VOUT < 0.5 V at +50.2 us; VOUT at +50 us = 0.52 V
- ASB/pess ordering P125: M5a: PG_3V3RF <= 0.3 V whenever asserted (TLV755 EN guaranteed off) -- max 0.643 V
- ASB/pess ordering P127: M5a: PG_3V3RF <= 0.3 V whenever asserted (TLV755 EN guaranteed off) -- max 0.550 V
- ASB/pess ordering P128: M5a: PG_3V3RF <= 0.3 V whenever asserted (TLV755 EN guaranteed off) -- max 0.550 V
- ASB/pess ordering P132: M5a: PG_3V3RF <= 0.3 V whenever asserted (TLV755 EN guaranteed off) -- max 0.526 V
- ASB/pess ordering P134: M5a: PG_3V3RF <= 0.3 V whenever asserted (TLV755 EN guaranteed off) -- max 0.525 V
- ASB/pess ordering P135: M5a: PG_3V3RF <= 0.3 V whenever asserted (TLV755 EN guaranteed off) -- max 0.526 V
- ASB/pess ordering P136: M5a: PG_3V3RF <= 0.3 V whenever asserted (TLV755 EN guaranteed off) -- max 0.525 V
- ASB/pess ordering P137: T50: drain < 0.5 V within 50 us of 'fault@13.314ms' -- VOUT < 0.5 V at +50.2 us; VOUT at +50 us = 0.52 V
- ASB/pess ordering P137: M5a: PG_3V3RF <= 0.3 V whenever asserted (TLV755 EN guaranteed off) -- max 0.643 V
- ASB/pess ordering P139: M5a: PG_3V3RF <= 0.3 V whenever asserted (TLV755 EN guaranteed off) -- max 0.550 V
- ASB/pess ordering P140: M5a: PG_3V3RF <= 0.3 V whenever asserted (TLV755 EN guaranteed off) -- max 0.548 V
- ASB/pess ordering P143: M5a: PG_3V3RF <= 0.3 V whenever asserted (TLV755 EN guaranteed off) -- max 0.550 V
- ASB/pess ordering P147: M5a: PG_3V3RF <= 0.3 V whenever asserted (TLV755 EN guaranteed off) -- max 0.525 V
- ASB/pess ordering P149: M5a: PG_3V3RF <= 0.3 V whenever asserted (TLV755 EN guaranteed off) -- max 0.550 V
- ASB/pess ordering P150: M5a: PG_3V3RF <= 0.3 V whenever asserted (TLV755 EN guaranteed off) -- max 0.593 V
- ASB/pess ordering P152: M5a: PG_3V3RF <= 0.3 V whenever asserted (TLV755 EN guaranteed off) -- max 0.595 V
- ASB/pess ordering P153: M5a: PG_3V3RF <= 0.3 V whenever asserted (TLV755 EN guaranteed off) -- max 0.594 V
- ASB/pess ordering P153: M5c: clamped IL_CLR_N < LVC VIL (0.35 VCC) while PG_3V3RF asserted, VCC valid -- max margin +327 mV
- ASB/pess ordering P154: M5a: PG_3V3RF <= 0.3 V whenever asserted (TLV755 EN guaranteed off) -- max 0.550 V
- ASB/pess ordering P155: M5a: PG_3V3RF <= 0.3 V whenever asserted (TLV755 EN guaranteed off) -- max 0.595 V
- ASB/pess ordering P155: M5c: clamped IL_CLR_N < LVC VIL (0.35 VCC) while PG_3V3RF asserted, VCC valid -- max margin +328 mV
- ASB/pess ordering P156: M5a: PG_3V3RF <= 0.3 V whenever asserted (TLV755 EN guaranteed off) -- max 0.595 V
- ASB/pess ordering P157: M5a: PG_3V3RF <= 0.3 V whenever asserted (TLV755 EN guaranteed off) -- max 0.595 V
- ASB/pess ordering P159: M5a: PG_3V3RF <= 0.3 V whenever asserted (TLV755 EN guaranteed off) -- max 0.594 V
- ASB/pess ordering P160: M5a: PG_3V3RF <= 0.3 V whenever asserted (TLV755 EN guaranteed off) -- max 0.550 V
- ASB/pess ordering P162: T50: drain < 0.5 V within 50 us of 'fault@13.684ms' -- VOUT < 0.5 V at +50.2 us; VOUT at +50 us = 0.52 V
- ASB/pess ordering P162: M5a: PG_3V3RF <= 0.3 V whenever asserted (TLV755 EN guaranteed off) -- max 0.642 V
- ASB/pess ordering P163: M5a: PG_3V3RF <= 0.3 V whenever asserted (TLV755 EN guaranteed off) -- max 0.525 V
- ASB/pess ordering P164: M5a: PG_3V3RF <= 0.3 V whenever asserted (TLV755 EN guaranteed off) -- max 0.526 V
- ASB/pess ordering P165: M5a: PG_3V3RF <= 0.3 V whenever asserted (TLV755 EN guaranteed off) -- max 0.595 V
- ASB/pess ordering P165: M5c: clamped IL_CLR_N < LVC VIL (0.35 VCC) while PG_3V3RF asserted, VCC valid -- max margin +328 mV
- ASB/pess ordering P166: M5a: PG_3V3RF <= 0.3 V whenever asserted (TLV755 EN guaranteed off) -- max 0.595 V
- ASB/pess ordering P167: M5a: PG_3V3RF <= 0.3 V whenever asserted (TLV755 EN guaranteed off) -- max 0.595 V
- ASB/pess ordering P171: M5a: PG_3V3RF <= 0.3 V whenever asserted (TLV755 EN guaranteed off) -- max 0.525 V
- ASB/pess ordering P172: M5a: PG_3V3RF <= 0.3 V whenever asserted (TLV755 EN guaranteed off) -- max 0.550 V
- ASB/pess ordering P173: M5a: PG_3V3RF <= 0.3 V whenever asserted (TLV755 EN guaranteed off) -- max 0.642 V
- ASB/pess ordering P175: M5a: PG_3V3RF <= 0.3 V whenever asserted (TLV755 EN guaranteed off) -- max 0.550 V
- ASB/pess ordering P177: M5a: PG_3V3RF <= 0.3 V whenever asserted (TLV755 EN guaranteed off) -- max 0.550 V
- ASB/pess ordering P178: M5a: PG_3V3RF <= 0.3 V whenever asserted (TLV755 EN guaranteed off) -- max 0.526 V
- ASB/pess ordering P181: M5a: PG_3V3RF <= 0.3 V whenever asserted (TLV755 EN guaranteed off) -- max 0.525 V
- ASB/pess ordering P182: M5a: PG_3V3RF <= 0.3 V whenever asserted (TLV755 EN guaranteed off) -- max 0.525 V
- ASB/pess ordering P187: M5a: PG_3V3RF <= 0.3 V whenever asserted (TLV755 EN guaranteed off) -- max 0.526 V
- ASB/pess ordering P188: M5a: PG_3V3RF <= 0.3 V whenever asserted (TLV755 EN guaranteed off) -- max 0.525 V
- ASB/pess ordering P189: M5a: PG_3V3RF <= 0.3 V whenever asserted (TLV755 EN guaranteed off) -- max 0.526 V
- ASB/pess ordering P191: M5a: PG_3V3RF <= 0.3 V whenever asserted (TLV755 EN guaranteed off) -- max 0.550 V
- ASB/pess ordering P192: M5a: PG_3V3RF <= 0.3 V whenever asserted (TLV755 EN guaranteed off) -- max 0.550 V
- ASB/pess ordering P193: M5a: PG_3V3RF <= 0.3 V whenever asserted (TLV755 EN guaranteed off) -- max 0.550 V
- ASB/pess ordering P196: M5a: PG_3V3RF <= 0.3 V whenever asserted (TLV755 EN guaranteed off) -- max 0.525 V
- ASB/pess ordering P201: M5a: PG_3V3RF <= 0.3 V whenever asserted (TLV755 EN guaranteed off) -- max 0.525 V
- ASB/pess ordering P202: M5a: PG_3V3RF <= 0.3 V whenever asserted (TLV755 EN guaranteed off) -- max 0.595 V
- ASB/pess ordering P204: M5a: PG_3V3RF <= 0.3 V whenever asserted (TLV755 EN guaranteed off) -- max 0.550 V
- ASB/pess ordering P205: M5a: PG_3V3RF <= 0.3 V whenever asserted (TLV755 EN guaranteed off) -- max 0.550 V
- ASB/pess ordering P207: M5a: PG_3V3RF <= 0.3 V whenever asserted (TLV755 EN guaranteed off) -- max 0.526 V
- ASB/pess ordering P208: M5a: PG_3V3RF <= 0.3 V whenever asserted (TLV755 EN guaranteed off) -- max 0.526 V
- ASB/pess ordering P209: M5a: PG_3V3RF <= 0.3 V whenever asserted (TLV755 EN guaranteed off) -- max 0.526 V
- ASB/pess ordering P211: M5a: PG_3V3RF <= 0.3 V whenever asserted (TLV755 EN guaranteed off) -- max 0.550 V
- ASB/pess ordering P212: M5a: PG_3V3RF <= 0.3 V whenever asserted (TLV755 EN guaranteed off) -- max 0.550 V
- ASB/pess ordering P215: M5a: PG_3V3RF <= 0.3 V whenever asserted (TLV755 EN guaranteed off) -- max 0.526 V
- ASB/pess ordering P217: T50: drain < 0.5 V within 50 us of 'fault@13.367ms' -- VOUT < 0.5 V at +50.2 us; VOUT at +50 us = 0.52 V
- ASB/pess ordering P217: M5a: PG_3V3RF <= 0.3 V whenever asserted (TLV755 EN guaranteed off) -- max 0.643 V
- ASB/pess ordering P218: T50: drain < 0.5 V within 50 us of 'fault@13.006ms' -- VOUT < 0.5 V at +50.2 us; VOUT at +50 us = 0.52 V
- ASB/pess ordering P218: M5a: PG_3V3RF <= 0.3 V whenever asserted (TLV755 EN guaranteed off) -- max 0.642 V
- ASB/pess ordering P219: M5a: PG_3V3RF <= 0.3 V whenever asserted (TLV755 EN guaranteed off) -- max 0.550 V
- ASB/pess ordering P220: M5a: PG_3V3RF <= 0.3 V whenever asserted (TLV755 EN guaranteed off) -- max 0.525 V
- ASB/pess ordering P222: M5a: PG_3V3RF <= 0.3 V whenever asserted (TLV755 EN guaranteed off) -- max 0.550 V
- ASB/pess ordering P224: M5a: PG_3V3RF <= 0.3 V whenever asserted (TLV755 EN guaranteed off) -- max 0.550 V
- ASB/pess ordering P225: M5a: PG_3V3RF <= 0.3 V whenever asserted (TLV755 EN guaranteed off) -- max 0.594 V
- ASB/pess ordering P229: M5a: PG_3V3RF <= 0.3 V whenever asserted (TLV755 EN guaranteed off) -- max 0.550 V
- ASB/pess ordering P230: M5a: PG_3V3RF <= 0.3 V whenever asserted (TLV755 EN guaranteed off) -- max 0.525 V
- ASB/pess ordering P231: M5a: PG_3V3RF <= 0.3 V whenever asserted (TLV755 EN guaranteed off) -- max 0.550 V
- ASB/pess ordering P234: M5a: PG_3V3RF <= 0.3 V whenever asserted (TLV755 EN guaranteed off) -- max 0.525 V
- ASB/pess ordering P235: M5a: PG_3V3RF <= 0.3 V whenever asserted (TLV755 EN guaranteed off) -- max 0.550 V
- ASB/pess ordering P236: M5a: PG_3V3RF <= 0.3 V whenever asserted (TLV755 EN guaranteed off) -- max 0.595 V
- ASB/pess ordering P237: M5a: PG_3V3RF <= 0.3 V whenever asserted (TLV755 EN guaranteed off) -- max 0.550 V
- ASB/pess ordering P239: M5a: PG_3V3RF <= 0.3 V whenever asserted (TLV755 EN guaranteed off) -- max 0.550 V
- ASB/pess ordering P242: T50: drain < 0.5 V within 50 us of 'fault@14.162ms' -- VOUT < 0.5 V at +50.2 us; VOUT at +50 us = 0.52 V
- ASB/pess ordering P242: M5a: PG_3V3RF <= 0.3 V whenever asserted (TLV755 EN guaranteed off) -- max 0.643 V
- ASB/pess ordering P244: M5a: PG_3V3RF <= 0.3 V whenever asserted (TLV755 EN guaranteed off) -- max 0.640 V
- ASB/pess ordering P245: M5a: PG_3V3RF <= 0.3 V whenever asserted (TLV755 EN guaranteed off) -- max 0.550 V
- ASB/pess ordering P246: M5a: PG_3V3RF <= 0.3 V whenever asserted (TLV755 EN guaranteed off) -- max 0.595 V
- ASB/pess ordering P247: M5a: PG_3V3RF <= 0.3 V whenever asserted (TLV755 EN guaranteed off) -- max 0.550 V
- ASB/pess ordering P249: M5a: PG_3V3RF <= 0.3 V whenever asserted (TLV755 EN guaranteed off) -- max 0.595 V
- ASB/pess ordering P249: M5c: clamped IL_CLR_N < LVC VIL (0.35 VCC) while PG_3V3RF asserted, VCC valid -- max margin +328 mV
- ASB/pess ordering P250: T50: drain < 0.5 V within 50 us of 'fault@15.517ms' -- VOUT < 0.5 V at +50.2 us; VOUT at +50 us = 0.52 V
- ASB/pess ordering P250: M5a: PG_3V3RF <= 0.3 V whenever asserted (TLV755 EN guaranteed off) -- max 0.643 V
- ASB/pess ordering P251: M5a: PG_3V3RF <= 0.3 V whenever asserted (TLV755 EN guaranteed off) -- max 0.595 V
- ASB/pess ordering P252: M5a: PG_3V3RF <= 0.3 V whenever asserted (TLV755 EN guaranteed off) -- max 0.594 V
- ASB/pess ordering P254: M5a: PG_3V3RF <= 0.3 V whenever asserted (TLV755 EN guaranteed off) -- max 0.525 V
- ASB/pess ordering P255: M5a: PG_3V3RF <= 0.3 V whenever asserted (TLV755 EN guaranteed off) -- max 0.550 V
- ASB/pess ordering P256: M5a: PG_3V3RF <= 0.3 V whenever asserted (TLV755 EN guaranteed off) -- max 0.595 V
- ASB/pess ordering P256: M5c: clamped IL_CLR_N < LVC VIL (0.35 VCC) while PG_3V3RF asserted, VCC valid -- max margin +328 mV
- ... 6563 more (see h2c_d_runs.json)

### Worst-case waveforms

- `d_worst_ASB_nom_gmax.cir` / `h2c_d_worst_ASB_nom_gmax.png`: R012 (random)
- `d_worst_ASB_nom_gmin.cir` / `h2c_d_worst_ASB_nom_gmin.png`: R119 (random)
- `d_worst_ASB_nom_t05.cir` / `h2c_d_worst_ASB_nom_t05.png`: R180 (random)
- `d_worst_ASB_pess_gmax.cir` / `h2c_d_worst_ASB_pess_gmax.png`: R012 (random)
- `d_worst_ASB_pess_gmin.cir` / `h2c_d_worst_ASB_pess_gmin.png`: R119 (random)
- `d_worst_ASB_pess_t05.cir` / `h2c_d_worst_ASB_pess_t05.png`: P497 (up: -5V_BF>+3V3_AUX>+5V_PA>-3V3_SW>+3V3_RF>+1V8_DIG | down: +1V8_DIG>-3V3_SW>+5V_PA>+3V3_AUX>+3V3_RF>-5V_BF)
- `d_worst_ASB_pess_fail.cir` / `h2c_d_worst_ASB_pess_fail.png`: P000 (up: +3V3_AUX>+1V8_DIG>+3V3_RF>+5V_PA>-5V_BF>-3V3_SW | down: -5V_BF>-3V3_SW>+3V3_AUX>+5V_PA>+1V8_DIG>+3V3_RF)
- `d_worst_ASB_td100_pess_gmax.cir` / `h2c_d_worst_ASB_td100_pess_gmax.png`: R037 (random)
- `d_worst_ASB_td100_pess_gmin.cir` / `h2c_d_worst_ASB_td100_pess_gmin.png`: P569 (up: -5V_BF>+5V_PA>+3V3_RF>-3V3_SW>+1V8_DIG>+3V3_AUX | down: +3V3_RF>+3V3_AUX>+1V8_DIG>+5V_PA>-5V_BF>-3V3_SW)
- `d_worst_ASB_td100_pess_t05.cir` / `h2c_d_worst_ASB_td100_pess_t05.png`: P018 (up: +3V3_AUX>+1V8_DIG>-3V3_SW>+3V3_RF>+5V_PA>-5V_BF | down: -3V3_SW>+1V8_DIG>-5V_BF>+3V3_RF>+3V3_AUX>+5V_PA)
- `d_worst_ASB_td100_pess_fail.cir` / `h2c_d_worst_ASB_td100_pess_fail.png`: P000 (up: +3V3_AUX>+1V8_DIG>+3V3_RF>+5V_PA>-5V_BF>-3V3_SW | down: -5V_BF>-3V3_SW>+3V3_AUX>+5V_PA>+1V8_DIG>+3V3_RF)
- `d_worst_ASB_slow_pess_gmax.cir` / `h2c_d_worst_ASB_slow_pess_gmax.png`: R174 (random)
- `d_worst_ASB_slow_pess_gmin.cir` / `h2c_d_worst_ASB_slow_pess_gmin.png`: R129 (random)
- `d_worst_ASB_slow_pess_t05.cir` / `h2c_d_worst_ASB_slow_pess_t05.png`: P082 (up: +3V3_AUX>-5V_BF>+3V3_RF>-3V3_SW>+1V8_DIG>+5V_PA | down: -3V3_SW>+1V8_DIG>+5V_PA>+3V3_RF>-5V_BF>+3V3_AUX)
- `d_worst_ASB_slow_pess_fail.cir` / `h2c_d_worst_ASB_slow_pess_fail.png`: P000 (up: +3V3_AUX>+1V8_DIG>+3V3_RF>+5V_PA>-5V_BF>-3V3_SW | down: -5V_BF>-3V3_SW>+3V3_AUX>+5V_PA>+1V8_DIG>+3V3_RF)
- `d_worst_ASB_ovl_pess_gmax.cir` / `h2c_d_worst_ASB_ovl_pess_gmax.png`: R126 (random)
- `d_worst_ASB_ovl_pess_gmin.cir` / `h2c_d_worst_ASB_ovl_pess_gmin.png`: R008 (random)
- `d_worst_ASB_ovl_pess_t05.cir` / `h2c_d_worst_ASB_ovl_pess_t05.png`: P492 (up: -5V_BF>+3V3_AUX>+5V_PA>+1V8_DIG>+3V3_RF>-3V3_SW | down: -3V3_SW>+5V_PA>+1V8_DIG>-5V_BF>+3V3_RF>+3V3_AUX)
- `d_worst_ASB_ovl_pess_fail.cir` / `h2c_d_worst_ASB_ovl_pess_fail.png`: P000 (up: +3V3_AUX>+1V8_DIG>+3V3_RF>+5V_PA>-5V_BF>-3V3_SW | down: -5V_BF>-3V3_SW>+3V3_AUX>+5V_PA>+1V8_DIG>+3V3_RF)
- `d_worst_R2_nom_gmax.cir` / `h2c_d_worst_R2_nom_gmax.png`: R057 (random)
- `d_worst_R2_nom_gmin.cir` / `h2c_d_worst_R2_nom_gmin.png`: R133 (random)
- `d_worst_R2_nom_t05.cir` / `h2c_d_worst_R2_nom_t05.png`: R069 (random)
- `d_worst_R2_nom_fail.cir` / `h2c_d_worst_R2_nom_fail.png`: P000 (up: +3V3_AUX>+1V8_DIG>+3V3_RF>+5V_PA>-5V_BF>-3V3_SW | down: -5V_BF>-3V3_SW>+3V3_AUX>+5V_PA>+1V8_DIG>+3V3_RF)
- `d_worst_FIX_nom_gmax.cir` / `h2c_d_worst_FIX_nom_gmax.png`: R126 (random)
- `d_worst_FIX_nom_gmin.cir` / `h2c_d_worst_FIX_nom_gmin.png`: R119 (random)
- `d_worst_FIX_nom_t05.cir` / `h2c_d_worst_FIX_nom_t05.png`: R180 (random)
- `d_worst_FIX_pess_gmax.cir` / `h2c_d_worst_FIX_pess_gmax.png`: R037 (random)
- `d_worst_FIX_pess_gmin.cir` / `h2c_d_worst_FIX_pess_gmin.png`: P545 (up: -5V_BF>+3V3_RF>+5V_PA>-3V3_SW>+1V8_DIG>+3V3_AUX | down: -5V_BF>+1V8_DIG>+3V3_AUX>+3V3_RF>-3V3_SW>+5V_PA)
- `d_worst_FIX_pess_t05.cir` / `h2c_d_worst_FIX_pess_t05.png`: R180 (random)
- `d_worst_FIX_pess_fail.cir` / `h2c_d_worst_FIX_pess_fail.png`: P030 (up: +3V3_AUX>+3V3_RF>+5V_PA>+1V8_DIG>-5V_BF>-3V3_SW | down: -3V3_SW>-5V_BF>+1V8_DIG>+5V_PA>+3V3_RF>+3V3_AUX)

## Details: ASB / pess

### S1 normal power-up (`s1_powerup.cir`)

| event | time |
|---|---|
| VIN_12V > 8 V (TPS62933 UVLO start) | 0.6667 ms |
| NEG_RAILS_OK > 0.675 V first time (glitch: LM339 below VS min 2 V) | 2.6183 ms |
| PA_ARMED high first time (pessimistic flop SET while +1V8_DIG < 1.65 V) | 2.6980 ms |
| ENN (U913) high | 2.8202 ms |
| NEG_OK high first time | 2.8202 ms |
| IL_EN high first time (U915) | 2.8204 ms |
| +1V8_DIG > 1.71 V | 3.3553 ms |
| +3V3_AUX > 2.0 V (LM339 active, glitch ends) | 3.5570 ms |
| +3V3_AUX > 3.0 V | 4.9993 ms |
| PWR_EN_3V3 / 5VPA / NEG asserted (MCU) | 8.0010 ms |
| +5V_PA > 4.5 V | 10.9789 ms |
| +3V3_RF (AVDD3, VDD_SW) > 90 % | 11.0069 ms |
| PG_3V3RF high | 14.5574 ms |
| PWR_VNEG < -6.0 V | 15.5047 ms |
| -3V3_SW (VSS_SW) < -0.33 V | 26.8369 ms |
| -5V_BF (AVDD1) < -0.5 V | 26.9260 ms |
| -3V3_SW < -3.0 V (monitor trip) | 123.6077 ms |
| NEG_OK high (gates pinched) | 125.3053 ms |
| NEG_RAILS_OK high (rails good) | 125.3055 ms |
| -5V_BF < -4.6 V (monitor trip) | 125.3937 ms |
| IL_REF > 0.5 V first time | 125.4476 ms |
| IL_REF > 1.7 V (rails good) | 125.5309 ms |
| firmware PA_BIAS -> -1.75 V | 140.0000 ms |
| GATES_OK high | 140.0020 ms |
| all gates < -1.5 V | 140.0025 ms |
| GATES_PINCHED high | 140.0040 ms |
| MCU_PA_EN high | 140.2005 ms |
| PA_DRAIN_EN > 1.08 V first time | 140.2084 ms |
| PA_ARMED high | 140.2084 ms |
| PA_DRAIN_EN high | 140.2084 ms |
| VOUT (drain) > 0.5 V | 140.3672 ms |
| VOUT (drain) > 4.5 V | 140.5528 ms |
| firmware PA_BIAS -> -1.1 V (TX) | 141.0000 ms |
| any gate > -1.5 V | 141.0010 ms |

| check | kind | result | detail |
|---|---|---|---|
| AVDD3 (+3V3_RF 90 %) before AVDD1 (-5V_BF -10 %) [ADAR1000 p13] | SAFETY | PASS | lead 15.92 ms |
| VDD_SW (+3V3_RF 90 %) before VSS_SW (-3V3_SW -10 %) [ADTR1107 p24] | SAFETY | PASS | lead 15.83 ms |
| TPS65131 does not start (PWR_VNEG < -0.5 V) before PG_3V3RF, although PWR_EN_NEG was asserted early | SAFETY | PASS | PWR_VNEG < -0.5 V at 14.6377 ms, PG at 14.5574 ms |
| INFO: ENN logic level not high before PG_3V3RF (U913 output; pessimistic mode drives it to VCC while +1V8_DIG < 1.65 V) | INFO | **FAIL** | ENN first high at 2.8202 ms |
| PA_ARMED only after all gates pinched | SAFETY | PASS | +205.9 us |
| G: VGG_PA within -2.0 .. 0 V (+10 mV) | SAFETY | PASS | max +2 mV at 125.545 ms, min -1.746 V |
| A: drain < 0.5 V whenever a gate > -1.5 V outside armed TX | SAFETY | PASS | ok |
| EN: drain switch never on while a supply is invalid | SAFETY | PASS | ok |
| REF: IL_REF never on while a supply is invalid | SAFETY | PASS | ok |
| M5a: PG_3V3RF <= 0.3 V whenever asserted (TLV755 EN guaranteed off) | SAFETY | PASS | max 0.222 V |
| M5b: clamped PA_DRAIN_EN < VENF min 1.08 V while PG_3V3RF asserted | SAFETY | PASS | max 0.546 V |
| M5c: clamped IL_CLR_N < LVC VIL (0.35 VCC) while PG_3V3RF asserted, VCC valid | SAFETY | PASS | max margin -577 mV |
| M5d: TPS386000 RESET_N sink current <= 5 mA abs max | SAFETY | PASS | max 0.02 mA (VOL specified only at 1 mA) |

- max IL_REF before -5V_BF is good: 0.000 V; max NEG_OK: 1.650 V; max NEG_RAILS_OK during AUX ramp 1.001 V (unchanged pull-up, now gated by PG_3V3RF in U915)
- max gate voltage before firmware programs PA_BIAS: +2.1 mV (ADAR1000 unpowered/at reset)
- -3V3_SW and -5V_BF ramp together (same TPS65131, same 120 ms SS); ADAR1000 p44 lists -3.3 V before -5 V: -3V3_SW reaches -10 % +89.1 us before -5V_BF
- TX drain current (4 PAs) at end: 0.885 A, VOUT 4.89 V

### S2 MCU_PA_EN with unprogrammed / unpinched gates (`s2_unprogrammed_gates.cir`)

| event | time |
|---|---|
| PA_ARMED high | 2.8202 ms |
| NEG_RAILS_OK high | 3.2687 ms |
| MCU_PA_EN high (gates at reset 0 V) | 140.2000 ms |
| MCU_PA_EN low | 140.5000 ms |
| gates programmed ON -1.1 V (not pinched) | 140.6000 ms |
| MCU_PA_EN high again | 140.7000 ms |
| PA_DRAIN_EN high | never |
| VOUT > 0.5 V | never |

| check | kind | result | detail |
|---|---|---|---|
| G: VGG_PA within -2.0 .. 0 V (+10 mV) | SAFETY | PASS | max +2 mV at 125.540 ms, min -1.098 V |
| A: drain < 0.5 V whenever a gate > -1.5 V outside armed TX | SAFETY | PASS | ok |
| EN: drain switch never on while a supply is invalid | SAFETY | PASS | ok |
| REF: IL_REF never on while a supply is invalid | SAFETY | PASS | ok |
| M5a: PG_3V3RF <= 0.3 V whenever asserted (TLV755 EN guaranteed off) | SAFETY | PASS | max 0.222 V |
| M5b: clamped PA_DRAIN_EN < VENF min 1.08 V while PG_3V3RF asserted | SAFETY | PASS | max 0.546 V |
| M5c: clamped IL_CLR_N < LVC VIL (0.35 VCC) while PG_3V3RF asserted, VCC valid | SAFETY | PASS | max margin -577 mV |
| M5d: TPS386000 RESET_N sink current <= 5 mA abs max | SAFETY | PASS | max 0.02 mA (VOL specified only at 1 mA) |

- GATES_OK at 140.3 ms = 0.01 V, NEG_OK = 0.00 V, IL_CLR_N = 0.00 V
- GATES_PINCHED at 140.8 ms = 0.01 V, NEG_OK = 1.80 V
- max VOUT 0.000 V, max PA_ARMED 1.65 V

### S3 gate lost during TX (`s3_gate_lost.cir`)

| event | time |
|---|---|
| PA_BIAS1 step -1.1 -> 0 V | 142.0000 ms |
| gate1 > -0.15 V (fault) | 142.0025 ms |
| NEG_OK low | 142.0037 ms |
| GATES_OK low (< VIL) | 142.0037 ms |
| PA_DRAIN_EN low | 142.0037 ms |
| PA_ARMED low | 142.0038 ms |
| VOUT < 4.5 V | 142.0125 ms |
| VOUT < 0.5 V | 142.0288 ms |
| PA_BIAS1 restored -1.1 V (must stay off) | 142.3000 ms |

| check | kind | result | detail |
|---|---|---|---|
| G: VGG_PA within -2.0 .. 0 V (+10 mV) | SAFETY | PASS | max +2 mV at 125.537 ms, min -1.745 V |
| A: drain < 0.5 V whenever a gate > -1.5 V outside armed TX | SAFETY | PASS | ok |
| T50: drain < 0.5 V within 50 us of 'gate1 lost (> -0.15 V)' | SAFETY | PASS | VOUT < 0.5 V at +26.3 us; VOUT at +50 us = 0.00 V |
| (a) switch open <= 10 us after 'gate1 lost (> -0.15 V)' | SAFETY | PASS | tOFF complete +4.5 us |
| (b) residual PA energy <= 0.25 mJ, peak PA current <= 0.6 A after 'gate1 lost (> -0.15 V)' | SAFETY | PASS | E = 0.086 mJ; peak per-PA 0.601 A |
| INFO gate vs drain after 'gate1 lost (> -0.15 V)' | INFO | PASS | drain < 0.5 V at +26.3 us; first gate > -0.15 V at n/a; > 0 V at +2.5 us |
| EN: drain switch never on while a supply is invalid | SAFETY | PASS | ok |
| REF: IL_REF never on while a supply is invalid | SAFETY | PASS | ok |
| M5a: PG_3V3RF <= 0.3 V whenever asserted (TLV755 EN guaranteed off) | SAFETY | PASS | max 0.222 V |
| M5b: clamped PA_DRAIN_EN < VENF min 1.08 V while PG_3V3RF asserted | SAFETY | PASS | max 0.546 V |
| M5c: clamped IL_CLR_N < LVC VIL (0.35 VCC) while PG_3V3RF asserted, VCC valid | SAFETY | PASS | max margin -577 mV |
| M5d: TPS386000 RESET_N sink current <= 5 mA abs max | SAFETY | PASS | max 0.02 mA (VOL specified only at 1 mA) |
| CB: no crowbar / switch overlap (shoot-through) | SAFETY | PASS | overlap 0.00 us; crowbar starts 9.0 us after switch opens; crowbar off 126.3 us before VOUT ramp; peak 8.5 A, 0.147 mJ total |

- peak PA1 current 0.601 A (nominal 0.22 A); peak chain current 1.265 A
- PA1 energy from step to VOUT < 0.5 V: 0.058 mJ; to sim end: 0.059 mJ; stored in 19.81 uF at 5 V: 0.248 mJ
- VOUT at 142.5 ms after gate restored: 0.000 V, PA_ARMED 0.00 V

### S4a -5V_BF collapse via TPS65131 ENN (`s4a_neg_collapse_enn.cir`)

| event | time |
|---|---|
| PWR_EN_NEG / ENN low | 142.0000 ms |
| PWR_VNEG > -5.2 V (LDO in dropout) | 142.2149 ms |
| -5V_BF > -4.6 V (rail comparator) | 142.3807 ms |
| NEG_RAILS_OK low (< VIL) | 142.3837 ms |
| PA_DRAIN_EN low | 142.3838 ms |
| IL_REF < 0.1 V | 142.3975 ms |
| VOUT < 0.5 V | 142.4097 ms |
| any gate > -1.0 V (drifting above TX bias) | 143.7564 ms |
| any gate > -0.15 V (gate-lost level) | 144.2020 ms |
| any gate > -0.01 V | 144.8351 ms |

| check | kind | result | detail |
|---|---|---|---|
| G: VGG_PA within -2.0 .. 0 V (+10 mV) | SAFETY | PASS | max +2 mV at 125.545 ms, min -1.746 V |
| A: drain < 0.5 V whenever a gate > -1.5 V outside armed TX | SAFETY | PASS | ok |
| T50: drain < 0.5 V within 50 us of '-5V_BF > -4.6 V' | SAFETY | PASS | VOUT < 0.5 V at +29.1 us; VOUT at +50 us = 0.00 V |
| (a) switch open <= 10 us after '-5V_BF > -4.6 V' | SAFETY | PASS | tOFF complete +6.3 us |
| (b) residual PA energy <= 0.25 mJ, peak PA current <= 0.6 A after '-5V_BF > -4.6 V' | SAFETY | PASS | E = 0.063 mJ; peak per-PA 0.221 A |
| INFO gate vs drain after '-5V_BF > -4.6 V' | INFO | PASS | drain < 0.5 V at +29.1 us; first gate > -0.15 V at +1821.3 us; > 0 V at +2454.4 us |
| EN: drain switch never on while a supply is invalid | SAFETY | PASS | ok |
| REF: IL_REF never on while a supply is invalid | SAFETY | PASS | ok |
| M5a: PG_3V3RF <= 0.3 V whenever asserted (TLV755 EN guaranteed off) | SAFETY | PASS | max 0.222 V |
| M5b: clamped PA_DRAIN_EN < VENF min 1.08 V while PG_3V3RF asserted | SAFETY | PASS | max 0.546 V |
| M5c: clamped IL_CLR_N < LVC VIL (0.35 VCC) while PG_3V3RF asserted, VCC valid | SAFETY | PASS | max margin -577 mV |
| M5d: TPS386000 RESET_N sink current <= 5 mA abs max | SAFETY | PASS | max 0.02 mA (VOL specified only at 1 mA) |
| CB: no crowbar / switch overlap (shoot-through) | SAFETY | PASS | overlap 0.00 us; crowbar starts 8.7 us after switch opens; crowbar off 126.3 us before VOUT ramp; peak 9.0 A, 0.174 mJ total |

- first trip: rail comparator (-4.6 V); drain < 0.5 V +1792.3 us before the first gate reaches -0.15 V

### S4b -5V_BF collapse via TPS7A33 disable (`s4b_neg_collapse_ldo.cir`)

| event | time |
|---|---|
| -5V_BF LDO disabled | 142.0000 ms |
| -5V_BF > -4.6 V (rail comparator) | 142.0932 ms |
| NEG_RAILS_OK low (< VIL) | 142.0975 ms |
| PA_DRAIN_EN low | 142.0976 ms |
| IL_REF < 0.1 V | 142.1113 ms |
| VOUT < 0.5 V | 142.1235 ms |
| any gate > -1.0 V (drifting above TX bias) | 142.9395 ms |
| any gate > -0.15 V (gate-lost level) | 143.3851 ms |
| any gate > -0.01 V | 144.0182 ms |
| PWR_VNEG > -5.2 V (LDO in dropout) | never |

| check | kind | result | detail |
|---|---|---|---|
| G: VGG_PA within -2.0 .. 0 V (+10 mV) | SAFETY | PASS | max +2 mV at 125.545 ms, min -1.746 V |
| A: drain < 0.5 V whenever a gate > -1.5 V outside armed TX | SAFETY | PASS | ok |
| T50: drain < 0.5 V within 50 us of '-5V_BF > -4.6 V' | SAFETY | PASS | VOUT < 0.5 V at +30.3 us; VOUT at +50 us = 0.01 V |
| (a) switch open <= 10 us after '-5V_BF > -4.6 V' | SAFETY | PASS | tOFF complete +7.6 us |
| (b) residual PA energy <= 0.25 mJ, peak PA current <= 0.6 A after '-5V_BF > -4.6 V' | SAFETY | PASS | E = 0.063 mJ; peak per-PA 0.221 A |
| INFO gate vs drain after '-5V_BF > -4.6 V' | INFO | PASS | drain < 0.5 V at +30.3 us; first gate > -0.15 V at +1291.9 us; > 0 V at +1925.0 us |
| EN: drain switch never on while a supply is invalid | SAFETY | PASS | ok |
| REF: IL_REF never on while a supply is invalid | SAFETY | PASS | ok |
| M5a: PG_3V3RF <= 0.3 V whenever asserted (TLV755 EN guaranteed off) | SAFETY | PASS | max 0.222 V |
| M5b: clamped PA_DRAIN_EN < VENF min 1.08 V while PG_3V3RF asserted | SAFETY | PASS | max 0.546 V |
| M5c: clamped IL_CLR_N < LVC VIL (0.35 VCC) while PG_3V3RF asserted, VCC valid | SAFETY | PASS | max margin -577 mV |
| M5d: TPS386000 RESET_N sink current <= 5 mA abs max | SAFETY | PASS | max 0.02 mA (VOL specified only at 1 mA) |
| CB: no crowbar / switch overlap (shoot-through) | SAFETY | PASS | overlap 0.00 us; crowbar starts 8.7 us after switch opens; crowbar off 126.3 us before VOUT ramp; peak 9.0 A, 0.174 mJ total |

- first trip: rail comparator (-4.6 V); drain < 0.5 V +1261.5 us before the first gate reaches -0.15 V

### S5a watchdog fault during TX + recovery (`s5a_watchdog_tx.cir`)

| event | time |
|---|---|
| WDT_OK low | 142.0000 ms |
| PA_DRAIN_EN low | 142.0005 ms |
| PA_ARMED low | 142.0007 ms |
| VOUT < 0.5 V | 142.0268 ms |
| WDT_OK high again | 142.5000 ms |
| MCU_PA_EN toggle with gates ON (142.6/142.7 ms) | 142.7000 ms |
| gates OFF -1.75 V | 142.8000 ms |
| MCU_PA_EN re-arm edge | 143.0000 ms |
| PA_ARMED high (should be after 143.0 ms) | 143.0090 ms |
| PA_DRAIN_EN high | 143.0090 ms |
| VOUT > 4.5 V | 143.3534 ms |
| gates ON -1.1 V (TX) | 143.6000 ms |

| check | kind | result | detail |
|---|---|---|---|
| No re-arm while gates ON (142.7 ms toggle ignored) | SAFETY | PASS | 143.0090 ms |
| G: VGG_PA within -2.0 .. 0 V (+10 mV) | SAFETY | PASS | max +2 mV at 125.540 ms, min -1.746 V |
| A: drain < 0.5 V whenever a gate > -1.5 V outside armed TX | SAFETY | PASS | ok |
| T50: drain < 0.5 V within 50 us of 'WDT_OK low' | SAFETY | PASS | VOUT < 0.5 V at +26.8 us; VOUT at +50 us = 0.00 V |
| (a) switch open <= 10 us after 'WDT_OK low' | SAFETY | PASS | tOFF complete +3.8 us |
| (b) residual PA energy <= 0.25 mJ, peak PA current <= 0.6 A after 'WDT_OK low' | SAFETY | PASS | E = 0.064 mJ; peak per-PA 0.221 A |
| INFO gate vs drain after 'WDT_OK low' | INFO | PASS | drain < 0.5 V at +26.8 us; first gate > -0.15 V at n/a; > 0 V at n/a |
| EN: drain switch never on while a supply is invalid | SAFETY | PASS | ok |
| REF: IL_REF never on while a supply is invalid | SAFETY | PASS | ok |
| M5a: PG_3V3RF <= 0.3 V whenever asserted (TLV755 EN guaranteed off) | SAFETY | PASS | max 0.222 V |
| M5b: clamped PA_DRAIN_EN < VENF min 1.08 V while PG_3V3RF asserted | SAFETY | PASS | max 0.546 V |
| M5c: clamped IL_CLR_N < LVC VIL (0.35 VCC) while PG_3V3RF asserted, VCC valid | SAFETY | PASS | max margin -577 mV |
| M5d: TPS386000 RESET_N sink current <= 5 mA abs max | SAFETY | PASS | max 0.02 mA (VOL specified only at 1 mA) |
| CB: no crowbar / switch overlap (shoot-through) | SAFETY | PASS | overlap 0.00 us; crowbar starts 8.9 us after switch opens; crowbar off 126.3 us before VOUT ramp; peak 9.0 A, 0.173 mJ total |

### S5b watchdog fault while armed, gates pinched (`s5b_watchdog_idle.cir`)

| event | time |
|---|---|
| WDT_OK low (armed, gates -1.75 V, no PA current) | 141.0000 ms |
| PA_DRAIN_EN low | 141.0005 ms |
| VOUT < 4.5 V | 141.0145 ms |
| VOUT < 0.5 V | 141.0303 ms |

| check | kind | result | detail |
|---|---|---|---|
| G: VGG_PA within -2.0 .. 0 V (+10 mV) | SAFETY | PASS | max +2 mV at 125.551 ms, min -1.746 V |
| A: drain < 0.5 V whenever a gate > -1.5 V outside armed TX | SAFETY | PASS | ok |
| T50: drain < 0.5 V within 50 us of 'WDT_OK low' | SAFETY | PASS | VOUT < 0.5 V at +30.3 us; VOUT at +50 us = 0.03 V |
| (a) switch open <= 10 us after 'WDT_OK low' | SAFETY | PASS | tOFF complete +3.8 us |
| (b) residual PA energy <= 0.25 mJ, peak PA current <= 0.6 A after 'WDT_OK low' | SAFETY | PASS | E = 0.001 mJ; peak per-PA 0.002 A |
| INFO gate vs drain after 'WDT_OK low' | INFO | PASS | drain < 0.5 V at +30.3 us; first gate > -0.15 V at n/a; > 0 V at n/a |
| EN: drain switch never on while a supply is invalid | SAFETY | PASS | ok |
| REF: IL_REF never on while a supply is invalid | SAFETY | PASS | ok |
| M5a: PG_3V3RF <= 0.3 V whenever asserted (TLV755 EN guaranteed off) | SAFETY | PASS | max 0.222 V |
| M5b: clamped PA_DRAIN_EN < VENF min 1.08 V while PG_3V3RF asserted | SAFETY | PASS | max 0.546 V |
| M5c: clamped IL_CLR_N < LVC VIL (0.35 VCC) while PG_3V3RF asserted, VCC valid | SAFETY | PASS | max margin -577 mV |
| M5d: TPS386000 RESET_N sink current <= 5 mA abs max | SAFETY | PASS | max 0.02 mA (VOL specified only at 1 mA) |
| CB: no crowbar / switch overlap (shoot-through) | SAFETY | PASS | overlap 0.00 us; crowbar starts 8.9 us after switch opens; crowbar off 126.3 us before VOUT ramp; peak 10.4 A, 0.247 mJ total |

- QOD-only discharge (RPD 400 ohm x 19.81 uF, tau 7.9 ms): VOUT < 0.5 V after 0.03 ms
- gates stay at -1.75 V, so no PA current flows; the residual charge is 0.25 mJ

### S6 VIN_12V loss during TX (`s6_vin_loss.cir`)

| event | time |
|---|---|
| VIN_12V starts falling (12 -> 0 V / 1 ms) | 142.0000 ms |
| VIN < 7 V (TPS62933 UVLO stop, AUX stops) | 142.4167 ms |
| +3V3_AUX < 2.97 V (AUX UV comparator) | 142.4426 ms |
| PA_DRAIN_EN low | 142.4441 ms |
| NEG_RAILS_OK low (< VIL) | 142.4441 ms |
| PG_3V3RF low | 142.4460 ms |
| VOUT < 0.5 V | 142.4698 ms |
| +3V3_AUX < 2.35 V (TPS65131 UVLO) | 142.5533 ms |
| VIN < 5.3 V (+5V_PA out of regulation) | 142.5583 ms |
| +3V3_AUX < 2.0 V (LM339 VS min) | 142.6190 ms |
| NEG_RAILS_OK back > 0.675 V (LM339 below VS min) | 142.6209 ms |
| +1V8_DIG < 1.65 V | 142.6607 ms |
| IL_EN back high | 142.6607 ms |
| NEG_OK back high | 142.6607 ms |
| +3V3_RF < 2.8 V (ADAR1000 PA_BIAS high-Z, assumed) | 142.6857 ms |
| any gate > -1.0 V (drifting above TX bias) | 142.7445 ms |
| -5V_BF > -4.6 V | 142.8261 ms |
| any gate > -0.15 V | 143.9351 ms |
| any gate > -0.01 V | 145.6346 ms |
| -3V3_SW > -3.0 V | 146.2611 ms |
| IL_REF back > 0.5 V | never |
| PG_3V3RF floats high again (TPS568230 VIN < 1.5 V, assumed) | never |

| check | kind | result | detail |
|---|---|---|---|
| INFO: IL_EN and NEG_OK logic levels stay low after the trip (LVC outputs; hazard checked by EN/REF/PA_DRAIN_EN) | INFO | **FAIL** | max IL_EN 1.649 V, max NEG_OK 1.650 V |
| PA_DRAIN_EN stays < VENF 1.08 V after trip | SAFETY | PASS | max 0.494 V |
| INFO: NEG_RAILS_OK level after trip (pull-up AUX/2 once LM339 < VS min) | INFO | **FAIL** | max 0.993 V |
| INFO: IL_REF stays off (< 0.1 V) once switched off | INFO | PASS | max 0.039 V |
| G: VGG_PA within -2.0 .. 0 V (+10 mV) | SAFETY | PASS | max +2 mV at 125.540 ms, min -1.746 V |
| A: drain < 0.5 V whenever a gate > -1.5 V outside armed TX | SAFETY | PASS | ok |
| T50: drain < 0.5 V within 50 us of 'first monitored threshold (VIN loss)' | SAFETY | PASS | VOUT < 0.5 V at +27.2 us; VOUT at +50 us = 0.00 V |
| (a) switch open <= 10 us after 'first monitored threshold (VIN loss)' | SAFETY | PASS | tOFF complete +4.8 us |
| (b) residual PA energy <= 0.25 mJ, peak PA current <= 0.6 A after 'first monitored threshold (VIN loss)' | SAFETY | PASS | E = 0.062 mJ; peak per-PA 0.221 A |
| INFO gate vs drain after 'first monitored threshold (VIN loss)' | INFO | PASS | drain < 0.5 V at +27.2 us; first gate > -0.15 V at +1492.5 us; > 0 V at +3192.0 us |
| EN: drain switch never on while a supply is invalid | SAFETY | PASS | ok |
| REF: IL_REF never on while a supply is invalid | SAFETY | PASS | ok |
| M5a: PG_3V3RF <= 0.3 V whenever asserted (TLV755 EN guaranteed off) | SAFETY | PASS | max 0.222 V |
| M5b: clamped PA_DRAIN_EN < VENF min 1.08 V while PG_3V3RF asserted | SAFETY | PASS | max 0.546 V |
| M5c: clamped IL_CLR_N < LVC VIL (0.35 VCC) while PG_3V3RF asserted, VCC valid | SAFETY | PASS | max margin -577 mV |
| M5d: TPS386000 RESET_N sink current <= 5 mA abs max | SAFETY | PASS | max 4.29 mA (VOL specified only at 1 mA) |
| CB: no crowbar / switch overlap (shoot-through) | SAFETY | PASS | overlap 0.00 us; crowbar starts 8.5 us after switch opens; crowbar off 126.3 us before VOUT ramp; peak 9.1 A, 0.175 mJ total |

- first interlock threshold crossed: aux at 142.4426 ms
- drain < 0.5 V +1465.3 us before the first gate reaches -0.15 V
- max gate after VIN loss -0 mV; max NEG_OK after trip 1.65 V; max IL_EN after trip 1.65 V; max PA_ARMED after trip 1.28 V

### S7a +3V3_RF lost via PWR_EN_3V3 (neg rails up) (`s7a_rf_en_loss.cir`)

| event | time |
|---|---|
| PWR_EN_3V3 low | 142.0000 ms |
| PG_3V3RF low | 142.0005 ms |
| PA_DRAIN_EN low | 142.0005 ms |
| IL_EN low | 142.0005 ms |
| NEG_OK low | 142.0005 ms |
| TPS22810 switch open (tOFF done) | 142.0038 ms |
| IL_REF < 0.1 V | 142.0142 ms |
| +3V3_RF < 85 % (PGOOD UV) | 142.0240 ms |
| +3V3_RF < 2.8 V (ADAR1000 PA_BIAS high-Z, assumed) | 142.0256 ms |
| VOUT < 0.5 V | 142.0259 ms |
| any gate > -1.0 V | 142.0843 ms |
| any gate > -0.15 V | 143.2749 ms |

| check | kind | result | detail |
|---|---|---|---|
| G: VGG_PA within -2.0 .. 0 V (+10 mV) | SAFETY | PASS | max +2 mV at 125.540 ms, min -1.746 V |
| A: drain < 0.5 V whenever a gate > -1.5 V outside armed TX | SAFETY | PASS | ok |
| T50: drain < 0.5 V within 50 us of 'PWR_EN_3V3 low' | SAFETY | PASS | VOUT < 0.5 V at +25.9 us; VOUT at +50 us = 0.00 V |
| (a) switch open <= 10 us after 'PWR_EN_3V3 low' | SAFETY | PASS | tOFF complete +3.8 us |
| (b) residual PA energy <= 0.25 mJ, peak PA current <= 0.6 A after 'PWR_EN_3V3 low' | SAFETY | PASS | E = 0.060 mJ; peak per-PA 0.221 A |
| INFO gate vs drain after 'PWR_EN_3V3 low' | INFO | PASS | drain < 0.5 V at +25.9 us; first gate > -0.15 V at +1274.9 us; > 0 V at +2974.4 us |
| EN: drain switch never on while a supply is invalid | SAFETY | PASS | ok |
| REF: IL_REF never on while a supply is invalid | SAFETY | PASS | ok |
| M5a: PG_3V3RF <= 0.3 V whenever asserted (TLV755 EN guaranteed off) | SAFETY | PASS | max 0.222 V |
| M5b: clamped PA_DRAIN_EN < VENF min 1.08 V while PG_3V3RF asserted | SAFETY | PASS | max 0.546 V |
| M5c: clamped IL_CLR_N < LVC VIL (0.35 VCC) while PG_3V3RF asserted, VCC valid | SAFETY | PASS | max margin -577 mV |
| M5d: TPS386000 RESET_N sink current <= 5 mA abs max | SAFETY | PASS | max 0.02 mA (VOL specified only at 1 mA) |
| CB: no crowbar / switch overlap (shoot-through) | SAFETY | PASS | overlap 0.00 us; crowbar starts 8.1 us after switch opens; crowbar off 126.3 us before VOUT ramp; peak 9.1 A, 0.176 mJ total |

- -5V_BF 0.00 V and -3V3_SW -2.98 V at sim end (still up: AVDD1/VSS_SW present without AVDD3/VDD_SW; ADAR1000/ADTR1107 power-down order is not specified in the datasheets)
- max gate after the fault -2 mV; drain < 0.5 V +1249.0 us before any gate reaches -0.15 V

### S7b +3V3_RF silent collapse, EN high (neg rails up) (`s7b_rf_silent_collapse.cir`)

| event | time |
|---|---|
| +3V3_RF converter stops | 142.0000 ms |
| IL_EN low | 142.0122 ms |
| NEG_OK low | 142.0122 ms |
| PA_DRAIN_EN low | 142.0122 ms |
| TPS22810 switch open (tOFF done) | 142.0155 ms |
| +3V3_RF < 85 % (PGOOD UV) | 142.0240 ms |
| PG_3V3RF low | 142.0240 ms |
| +3V3_RF < 2.8 V (ADAR1000 PA_BIAS high-Z, assumed) | 142.0256 ms |
| IL_REF < 0.1 V | 142.0260 ms |
| VOUT < 0.5 V | 142.0384 ms |
| any gate > -1.0 V | 142.0841 ms |
| any gate > -0.15 V | 143.2746 ms |

| check | kind | result | detail |
|---|---|---|---|
| G: VGG_PA within -2.0 .. 0 V (+10 mV) | SAFETY | PASS | max +2 mV at 125.540 ms, min -1.746 V |
| A: drain < 0.5 V whenever a gate > -1.5 V outside armed TX | SAFETY | PASS | ok |
| T50: drain < 0.5 V within 50 us of '+3V3_RF < 85 %' | SAFETY | PASS | VOUT < 0.5 V at +14.4 us; VOUT at +50 us = 0.00 V |
| (a) switch open <= 10 us after '+3V3_RF < 85 %' | SAFETY | PASS | tOFF complete +0.0 us |
| (b) residual PA energy <= 0.25 mJ, peak PA current <= 0.6 A after '+3V3_RF < 85 %' | SAFETY | PASS | E = 0.029 mJ; peak per-PA 0.224 A |
| INFO gate vs drain after '+3V3_RF < 85 %' | INFO | PASS | drain < 0.5 V at +14.4 us; first gate > -0.15 V at +1250.6 us; > 0 V at +2950.0 us |
| EN: drain switch never on while a supply is invalid | SAFETY | PASS | ok |
| REF: IL_REF never on while a supply is invalid | SAFETY | PASS | ok |
| M5a: PG_3V3RF <= 0.3 V whenever asserted (TLV755 EN guaranteed off) | SAFETY | PASS | max 0.222 V |
| M5b: clamped PA_DRAIN_EN < VENF min 1.08 V while PG_3V3RF asserted | SAFETY | PASS | max 0.546 V |
| M5c: clamped IL_CLR_N < LVC VIL (0.35 VCC) while PG_3V3RF asserted, VCC valid | SAFETY | PASS | max margin -577 mV |
| M5d: TPS386000 RESET_N sink current <= 5 mA abs max | SAFETY | PASS | max 0.02 mA (VOL specified only at 1 mA) |
| CB: no crowbar / switch overlap (shoot-through) | SAFETY | PASS | overlap 0.00 us; crowbar starts 9.1 us after switch opens; crowbar off 126.3 us before VOUT ramp; peak 9.0 A, 0.172 mJ total |

- -5V_BF 0.00 V and -3V3_SW -2.98 V at sim end (still up: AVDD1/VSS_SW present without AVDD3/VDD_SW; ADAR1000/ADTR1107 power-down order is not specified in the datasheets)
- max gate after the fault -2 mV; drain < 0.5 V +1236.2 us before any gate reaches -0.15 V

## Details: ASB / nom

### S1 normal power-up (`s1_powerup.cir`)

| event | time |
|---|---|
| VIN_12V > 8 V (TPS62933 UVLO start) | 0.6667 ms |
| NEG_RAILS_OK > 0.675 V first time (glitch: LM339 below VS min 2 V) | 2.6183 ms |
| +1V8_DIG > 1.71 V | 3.3553 ms |
| +3V3_AUX > 2.0 V (LM339 active, glitch ends) | 3.5570 ms |
| +3V3_AUX > 3.0 V | 4.9993 ms |
| PWR_EN_3V3 / 5VPA / NEG asserted (MCU) | 8.0010 ms |
| +5V_PA > 4.5 V | 10.9789 ms |
| +3V3_RF (AVDD3, VDD_SW) > 90 % | 11.0069 ms |
| PG_3V3RF high | 14.5577 ms |
| ENN (U913) high | 14.5577 ms |
| PWR_VNEG < -6.0 V | 15.5055 ms |
| -3V3_SW (VSS_SW) < -0.33 V | 26.8377 ms |
| -5V_BF (AVDD1) < -0.5 V | 26.9268 ms |
| -3V3_SW < -3.0 V (monitor trip) | 123.6085 ms |
| NEG_OK high first time | 125.3030 ms |
| NEG_OK high (gates pinched) | 125.3030 ms |
| IL_EN high first time (U915) | 125.3030 ms |
| NEG_RAILS_OK high (rails good) | 125.3032 ms |
| -5V_BF < -4.6 V (monitor trip) | 125.3945 ms |
| IL_REF > 0.5 V first time | 125.4453 ms |
| IL_REF > 1.7 V (rails good) | 125.5286 ms |
| firmware PA_BIAS -> -1.75 V | 140.0000 ms |
| GATES_OK high | 140.0019 ms |
| all gates < -1.5 V | 140.0025 ms |
| GATES_PINCHED high | 140.0040 ms |
| MCU_PA_EN high | 140.2005 ms |
| PA_ARMED high first time (pessimistic flop SET while +1V8_DIG < 1.65 V) | 140.2084 ms |
| PA_DRAIN_EN > 1.08 V first time | 140.2084 ms |
| PA_ARMED high | 140.2084 ms |
| PA_DRAIN_EN high | 140.2084 ms |
| VOUT (drain) > 0.5 V | 140.3672 ms |
| VOUT (drain) > 4.5 V | 140.5528 ms |
| firmware PA_BIAS -> -1.1 V (TX) | 141.0000 ms |
| any gate > -1.5 V | 141.0010 ms |

| check | kind | result | detail |
|---|---|---|---|
| AVDD3 (+3V3_RF 90 %) before AVDD1 (-5V_BF -10 %) [ADAR1000 p13] | SAFETY | PASS | lead 15.92 ms |
| VDD_SW (+3V3_RF 90 %) before VSS_SW (-3V3_SW -10 %) [ADTR1107 p24] | SAFETY | PASS | lead 15.83 ms |
| TPS65131 does not start (PWR_VNEG < -0.5 V) before PG_3V3RF, although PWR_EN_NEG was asserted early | SAFETY | PASS | PWR_VNEG < -0.5 V at 14.6384 ms, PG at 14.5577 ms |
| INFO: ENN logic level not high before PG_3V3RF (U913 output; pessimistic mode drives it to VCC while +1V8_DIG < 1.65 V) | INFO | PASS | ENN first high at 14.5577 ms |
| PA_ARMED only after all gates pinched | SAFETY | PASS | +205.9 us |
| G: VGG_PA within -2.0 .. 0 V (+10 mV) | SAFETY | PASS | max +2 mV at 125.542 ms, min -1.746 V |
| A: drain < 0.5 V whenever a gate > -1.5 V outside armed TX | SAFETY | PASS | ok |
| EN: drain switch never on while a supply is invalid | SAFETY | PASS | ok |
| REF: IL_REF never on while a supply is invalid | SAFETY | PASS | ok |
| M5a: PG_3V3RF <= 0.3 V whenever asserted (TLV755 EN guaranteed off) | SAFETY | PASS | max 0.007 V |
| M5b: clamped PA_DRAIN_EN < VENF min 1.08 V while PG_3V3RF asserted | SAFETY | PASS | max 0.000 V |
| M5c: clamped IL_CLR_N < LVC VIL (0.35 VCC) while PG_3V3RF asserted, VCC valid | SAFETY | PASS | max margin -578 mV |
| M5d: TPS386000 RESET_N sink current <= 5 mA abs max | SAFETY | PASS | max 0.02 mA (VOL specified only at 1 mA) |

- max IL_REF before -5V_BF is good: 0.000 V; max NEG_OK: 0.000 V; max NEG_RAILS_OK during AUX ramp 1.001 V (unchanged pull-up, now gated by PG_3V3RF in U915)
- max gate voltage before firmware programs PA_BIAS: +2.1 mV (ADAR1000 unpowered/at reset)
- -3V3_SW and -5V_BF ramp together (same TPS65131, same 120 ms SS); ADAR1000 p44 lists -3.3 V before -5 V: -3V3_SW reaches -10 % +89.1 us before -5V_BF
- TX drain current (4 PAs) at end: 0.885 A, VOUT 4.89 V

### S2 MCU_PA_EN with unprogrammed / unpinched gates (`s2_unprogrammed_gates.cir`)

| event | time |
|---|---|
| NEG_RAILS_OK high | 3.2686 ms |
| MCU_PA_EN high (gates at reset 0 V) | 140.2000 ms |
| MCU_PA_EN low | 140.5000 ms |
| gates programmed ON -1.1 V (not pinched) | 140.6000 ms |
| MCU_PA_EN high again | 140.7000 ms |
| PA_ARMED high | never |
| PA_DRAIN_EN high | never |
| VOUT > 0.5 V | never |

| check | kind | result | detail |
|---|---|---|---|
| G: VGG_PA within -2.0 .. 0 V (+10 mV) | SAFETY | PASS | max +2 mV at 125.537 ms, min -1.098 V |
| A: drain < 0.5 V whenever a gate > -1.5 V outside armed TX | SAFETY | PASS | ok |
| EN: drain switch never on while a supply is invalid | SAFETY | PASS | ok |
| REF: IL_REF never on while a supply is invalid | SAFETY | PASS | ok |
| M5a: PG_3V3RF <= 0.3 V whenever asserted (TLV755 EN guaranteed off) | SAFETY | PASS | max 0.007 V |
| M5b: clamped PA_DRAIN_EN < VENF min 1.08 V while PG_3V3RF asserted | SAFETY | PASS | max 0.000 V |
| M5c: clamped IL_CLR_N < LVC VIL (0.35 VCC) while PG_3V3RF asserted, VCC valid | SAFETY | PASS | max margin -578 mV |
| M5d: TPS386000 RESET_N sink current <= 5 mA abs max | SAFETY | PASS | max 0.02 mA (VOL specified only at 1 mA) |

- GATES_OK at 140.3 ms = 0.01 V, NEG_OK = 0.00 V, IL_CLR_N = 0.00 V
- GATES_PINCHED at 140.8 ms = 0.01 V, NEG_OK = 1.80 V
- max VOUT 0.000 V, max PA_ARMED 0.00 V

### S3 gate lost during TX (`s3_gate_lost.cir`)

| event | time |
|---|---|
| PA_BIAS1 step -1.1 -> 0 V | 142.0000 ms |
| gate1 > -0.15 V (fault) | 142.0025 ms |
| NEG_OK low | 142.0037 ms |
| PA_DRAIN_EN low | 142.0037 ms |
| GATES_OK low (< VIL) | 142.0037 ms |
| PA_ARMED low | 142.0037 ms |
| VOUT < 4.5 V | 142.0125 ms |
| VOUT < 0.5 V | 142.0288 ms |
| PA_BIAS1 restored -1.1 V (must stay off) | 142.3000 ms |

| check | kind | result | detail |
|---|---|---|---|
| G: VGG_PA within -2.0 .. 0 V (+10 mV) | SAFETY | PASS | max +2 mV at 125.539 ms, min -1.745 V |
| A: drain < 0.5 V whenever a gate > -1.5 V outside armed TX | SAFETY | PASS | ok |
| T50: drain < 0.5 V within 50 us of 'gate1 lost (> -0.15 V)' | SAFETY | PASS | VOUT < 0.5 V at +26.3 us; VOUT at +50 us = 0.00 V |
| (a) switch open <= 10 us after 'gate1 lost (> -0.15 V)' | SAFETY | PASS | tOFF complete +4.5 us |
| (b) residual PA energy <= 0.25 mJ, peak PA current <= 0.6 A after 'gate1 lost (> -0.15 V)' | SAFETY | PASS | E = 0.086 mJ; peak per-PA 0.601 A |
| INFO gate vs drain after 'gate1 lost (> -0.15 V)' | INFO | PASS | drain < 0.5 V at +26.3 us; first gate > -0.15 V at n/a; > 0 V at +2.5 us |
| EN: drain switch never on while a supply is invalid | SAFETY | PASS | ok |
| REF: IL_REF never on while a supply is invalid | SAFETY | PASS | ok |
| M5a: PG_3V3RF <= 0.3 V whenever asserted (TLV755 EN guaranteed off) | SAFETY | PASS | max 0.007 V |
| M5b: clamped PA_DRAIN_EN < VENF min 1.08 V while PG_3V3RF asserted | SAFETY | PASS | max 0.000 V |
| M5c: clamped IL_CLR_N < LVC VIL (0.35 VCC) while PG_3V3RF asserted, VCC valid | SAFETY | PASS | max margin -578 mV |
| M5d: TPS386000 RESET_N sink current <= 5 mA abs max | SAFETY | PASS | max 0.02 mA (VOL specified only at 1 mA) |
| CB: no crowbar / switch overlap (shoot-through) | SAFETY | PASS | overlap 0.00 us; crowbar starts 9.0 us after switch opens; crowbar off 126.4 us before VOUT ramp; peak 8.5 A, 0.147 mJ total |

- peak PA1 current 0.601 A (nominal 0.22 A); peak chain current 1.265 A
- PA1 energy from step to VOUT < 0.5 V: 0.058 mJ; to sim end: 0.059 mJ; stored in 19.81 uF at 5 V: 0.248 mJ
- VOUT at 142.5 ms after gate restored: 0.000 V, PA_ARMED 0.00 V

### S4a -5V_BF collapse via TPS65131 ENN (`s4a_neg_collapse_enn.cir`)

| event | time |
|---|---|
| PWR_EN_NEG / ENN low | 142.0000 ms |
| PWR_VNEG > -5.2 V (LDO in dropout) | 142.2149 ms |
| -5V_BF > -4.6 V (rail comparator) | 142.3807 ms |
| NEG_RAILS_OK low (< VIL) | 142.3837 ms |
| PA_DRAIN_EN low | 142.3838 ms |
| IL_REF < 0.1 V | 142.3975 ms |
| VOUT < 0.5 V | 142.4097 ms |
| any gate > -1.0 V (drifting above TX bias) | 143.7564 ms |
| any gate > -0.15 V (gate-lost level) | 144.2020 ms |
| any gate > -0.01 V | 144.8351 ms |

| check | kind | result | detail |
|---|---|---|---|
| G: VGG_PA within -2.0 .. 0 V (+10 mV) | SAFETY | PASS | max +2 mV at 125.542 ms, min -1.746 V |
| A: drain < 0.5 V whenever a gate > -1.5 V outside armed TX | SAFETY | PASS | ok |
| T50: drain < 0.5 V within 50 us of '-5V_BF > -4.6 V' | SAFETY | PASS | VOUT < 0.5 V at +29.1 us; VOUT at +50 us = 0.00 V |
| (a) switch open <= 10 us after '-5V_BF > -4.6 V' | SAFETY | PASS | tOFF complete +6.3 us |
| (b) residual PA energy <= 0.25 mJ, peak PA current <= 0.6 A after '-5V_BF > -4.6 V' | SAFETY | PASS | E = 0.063 mJ; peak per-PA 0.221 A |
| INFO gate vs drain after '-5V_BF > -4.6 V' | INFO | PASS | drain < 0.5 V at +29.1 us; first gate > -0.15 V at +1821.3 us; > 0 V at +2454.4 us |
| EN: drain switch never on while a supply is invalid | SAFETY | PASS | ok |
| REF: IL_REF never on while a supply is invalid | SAFETY | PASS | ok |
| M5a: PG_3V3RF <= 0.3 V whenever asserted (TLV755 EN guaranteed off) | SAFETY | PASS | max 0.007 V |
| M5b: clamped PA_DRAIN_EN < VENF min 1.08 V while PG_3V3RF asserted | SAFETY | PASS | max 0.000 V |
| M5c: clamped IL_CLR_N < LVC VIL (0.35 VCC) while PG_3V3RF asserted, VCC valid | SAFETY | PASS | max margin -578 mV |
| M5d: TPS386000 RESET_N sink current <= 5 mA abs max | SAFETY | PASS | max 0.02 mA (VOL specified only at 1 mA) |
| CB: no crowbar / switch overlap (shoot-through) | SAFETY | PASS | overlap 0.00 us; crowbar starts 8.7 us after switch opens; crowbar off 126.3 us before VOUT ramp; peak 9.0 A, 0.174 mJ total |

- first trip: rail comparator (-4.6 V); drain < 0.5 V +1792.3 us before the first gate reaches -0.15 V

### S4b -5V_BF collapse via TPS7A33 disable (`s4b_neg_collapse_ldo.cir`)

| event | time |
|---|---|
| -5V_BF LDO disabled | 142.0000 ms |
| -5V_BF > -4.6 V (rail comparator) | 142.0932 ms |
| NEG_RAILS_OK low (< VIL) | 142.0975 ms |
| PA_DRAIN_EN low | 142.0976 ms |
| IL_REF < 0.1 V | 142.1113 ms |
| VOUT < 0.5 V | 142.1235 ms |
| any gate > -1.0 V (drifting above TX bias) | 142.9395 ms |
| any gate > -0.15 V (gate-lost level) | 143.3851 ms |
| any gate > -0.01 V | 144.0182 ms |
| PWR_VNEG > -5.2 V (LDO in dropout) | never |

| check | kind | result | detail |
|---|---|---|---|
| G: VGG_PA within -2.0 .. 0 V (+10 mV) | SAFETY | PASS | max +2 mV at 125.542 ms, min -1.746 V |
| A: drain < 0.5 V whenever a gate > -1.5 V outside armed TX | SAFETY | PASS | ok |
| T50: drain < 0.5 V within 50 us of '-5V_BF > -4.6 V' | SAFETY | PASS | VOUT < 0.5 V at +30.3 us; VOUT at +50 us = 0.01 V |
| (a) switch open <= 10 us after '-5V_BF > -4.6 V' | SAFETY | PASS | tOFF complete +7.6 us |
| (b) residual PA energy <= 0.25 mJ, peak PA current <= 0.6 A after '-5V_BF > -4.6 V' | SAFETY | PASS | E = 0.063 mJ; peak per-PA 0.221 A |
| INFO gate vs drain after '-5V_BF > -4.6 V' | INFO | PASS | drain < 0.5 V at +30.3 us; first gate > -0.15 V at +1291.9 us; > 0 V at +1925.0 us |
| EN: drain switch never on while a supply is invalid | SAFETY | PASS | ok |
| REF: IL_REF never on while a supply is invalid | SAFETY | PASS | ok |
| M5a: PG_3V3RF <= 0.3 V whenever asserted (TLV755 EN guaranteed off) | SAFETY | PASS | max 0.007 V |
| M5b: clamped PA_DRAIN_EN < VENF min 1.08 V while PG_3V3RF asserted | SAFETY | PASS | max 0.000 V |
| M5c: clamped IL_CLR_N < LVC VIL (0.35 VCC) while PG_3V3RF asserted, VCC valid | SAFETY | PASS | max margin -578 mV |
| M5d: TPS386000 RESET_N sink current <= 5 mA abs max | SAFETY | PASS | max 0.02 mA (VOL specified only at 1 mA) |
| CB: no crowbar / switch overlap (shoot-through) | SAFETY | PASS | overlap 0.00 us; crowbar starts 8.7 us after switch opens; crowbar off 126.3 us before VOUT ramp; peak 9.0 A, 0.174 mJ total |

- first trip: rail comparator (-4.6 V); drain < 0.5 V +1261.5 us before the first gate reaches -0.15 V

### S5a watchdog fault during TX + recovery (`s5a_watchdog_tx.cir`)

| event | time |
|---|---|
| WDT_OK low | 142.0000 ms |
| PA_DRAIN_EN low | 142.0005 ms |
| PA_ARMED low | 142.0007 ms |
| VOUT < 0.5 V | 142.0268 ms |
| WDT_OK high again | 142.5000 ms |
| MCU_PA_EN toggle with gates ON (142.6/142.7 ms) | 142.7000 ms |
| gates OFF -1.75 V | 142.8000 ms |
| MCU_PA_EN re-arm edge | 143.0000 ms |
| PA_ARMED high (should be after 143.0 ms) | 143.0090 ms |
| PA_DRAIN_EN high | 143.0090 ms |
| VOUT > 4.5 V | 143.3534 ms |
| gates ON -1.1 V (TX) | 143.6000 ms |

| check | kind | result | detail |
|---|---|---|---|
| No re-arm while gates ON (142.7 ms toggle ignored) | SAFETY | PASS | 143.0090 ms |
| G: VGG_PA within -2.0 .. 0 V (+10 mV) | SAFETY | PASS | max +2 mV at 125.537 ms, min -1.746 V |
| A: drain < 0.5 V whenever a gate > -1.5 V outside armed TX | SAFETY | PASS | ok |
| T50: drain < 0.5 V within 50 us of 'WDT_OK low' | SAFETY | PASS | VOUT < 0.5 V at +26.8 us; VOUT at +50 us = 0.00 V |
| (a) switch open <= 10 us after 'WDT_OK low' | SAFETY | PASS | tOFF complete +3.8 us |
| (b) residual PA energy <= 0.25 mJ, peak PA current <= 0.6 A after 'WDT_OK low' | SAFETY | PASS | E = 0.064 mJ; peak per-PA 0.221 A |
| INFO gate vs drain after 'WDT_OK low' | INFO | PASS | drain < 0.5 V at +26.8 us; first gate > -0.15 V at n/a; > 0 V at n/a |
| EN: drain switch never on while a supply is invalid | SAFETY | PASS | ok |
| REF: IL_REF never on while a supply is invalid | SAFETY | PASS | ok |
| M5a: PG_3V3RF <= 0.3 V whenever asserted (TLV755 EN guaranteed off) | SAFETY | PASS | max 0.007 V |
| M5b: clamped PA_DRAIN_EN < VENF min 1.08 V while PG_3V3RF asserted | SAFETY | PASS | max 0.000 V |
| M5c: clamped IL_CLR_N < LVC VIL (0.35 VCC) while PG_3V3RF asserted, VCC valid | SAFETY | PASS | max margin -578 mV |
| M5d: TPS386000 RESET_N sink current <= 5 mA abs max | SAFETY | PASS | max 0.02 mA (VOL specified only at 1 mA) |
| CB: no crowbar / switch overlap (shoot-through) | SAFETY | PASS | overlap 0.00 us; crowbar starts 8.9 us after switch opens; crowbar off 126.3 us before VOUT ramp; peak 9.0 A, 0.173 mJ total |

### S5b watchdog fault while armed, gates pinched (`s5b_watchdog_idle.cir`)

| event | time |
|---|---|
| WDT_OK low (armed, gates -1.75 V, no PA current) | 141.0000 ms |
| PA_DRAIN_EN low | 141.0005 ms |
| VOUT < 4.5 V | 141.0145 ms |
| VOUT < 0.5 V | 141.0303 ms |

| check | kind | result | detail |
|---|---|---|---|
| G: VGG_PA within -2.0 .. 0 V (+10 mV) | SAFETY | PASS | max +2 mV at 125.560 ms, min -1.746 V |
| A: drain < 0.5 V whenever a gate > -1.5 V outside armed TX | SAFETY | PASS | ok |
| T50: drain < 0.5 V within 50 us of 'WDT_OK low' | SAFETY | PASS | VOUT < 0.5 V at +30.3 us; VOUT at +50 us = 0.03 V |
| (a) switch open <= 10 us after 'WDT_OK low' | SAFETY | PASS | tOFF complete +3.8 us |
| (b) residual PA energy <= 0.25 mJ, peak PA current <= 0.6 A after 'WDT_OK low' | SAFETY | PASS | E = 0.001 mJ; peak per-PA 0.002 A |
| INFO gate vs drain after 'WDT_OK low' | INFO | PASS | drain < 0.5 V at +30.3 us; first gate > -0.15 V at n/a; > 0 V at n/a |
| EN: drain switch never on while a supply is invalid | SAFETY | PASS | ok |
| REF: IL_REF never on while a supply is invalid | SAFETY | PASS | ok |
| M5a: PG_3V3RF <= 0.3 V whenever asserted (TLV755 EN guaranteed off) | SAFETY | PASS | max 0.007 V |
| M5b: clamped PA_DRAIN_EN < VENF min 1.08 V while PG_3V3RF asserted | SAFETY | PASS | max 0.000 V |
| M5c: clamped IL_CLR_N < LVC VIL (0.35 VCC) while PG_3V3RF asserted, VCC valid | SAFETY | PASS | max margin -578 mV |
| M5d: TPS386000 RESET_N sink current <= 5 mA abs max | SAFETY | PASS | max 0.02 mA (VOL specified only at 1 mA) |
| CB: no crowbar / switch overlap (shoot-through) | SAFETY | PASS | overlap 0.00 us; crowbar starts 8.9 us after switch opens; crowbar off 126.3 us before VOUT ramp; peak 10.4 A, 0.247 mJ total |

- QOD-only discharge (RPD 400 ohm x 19.81 uF, tau 7.9 ms): VOUT < 0.5 V after 0.03 ms
- gates stay at -1.75 V, so no PA current flows; the residual charge is 0.25 mJ

### S6 VIN_12V loss during TX (`s6_vin_loss.cir`)

| event | time |
|---|---|
| VIN_12V starts falling (12 -> 0 V / 1 ms) | 142.0000 ms |
| VIN < 7 V (TPS62933 UVLO stop, AUX stops) | 142.4167 ms |
| +3V3_AUX < 2.97 V (AUX UV comparator) | 142.4426 ms |
| PA_DRAIN_EN low | 142.4441 ms |
| NEG_RAILS_OK low (< VIL) | 142.4441 ms |
| PG_3V3RF low | 142.4460 ms |
| VOUT < 0.5 V | 142.4698 ms |
| +3V3_AUX < 2.35 V (TPS65131 UVLO) | 142.5533 ms |
| VIN < 5.3 V (+5V_PA out of regulation) | 142.5583 ms |
| +3V3_AUX < 2.0 V (LM339 VS min) | 142.6190 ms |
| NEG_RAILS_OK back > 0.675 V (LM339 below VS min) | 142.6204 ms |
| +1V8_DIG < 1.65 V | 142.6607 ms |
| +3V3_RF < 2.8 V (ADAR1000 PA_BIAS high-Z, assumed) | 142.6857 ms |
| any gate > -1.0 V (drifting above TX bias) | 142.7443 ms |
| -5V_BF > -4.6 V | 142.8261 ms |
| any gate > -0.15 V | 143.9349 ms |
| any gate > -0.01 V | 145.6344 ms |
| -3V3_SW > -3.0 V | 146.2611 ms |
| IL_REF back > 0.5 V | never |
| IL_EN back high | never |
| PG_3V3RF floats high again (TPS568230 VIN < 1.5 V, assumed) | never |
| NEG_OK back high | never |

| check | kind | result | detail |
|---|---|---|---|
| INFO: IL_EN and NEG_OK logic levels stay low after the trip (LVC outputs; hazard checked by EN/REF/PA_DRAIN_EN) | INFO | PASS | max IL_EN 0.000 V, max NEG_OK 0.000 V |
| PA_DRAIN_EN stays < VENF 1.08 V after trip | SAFETY | PASS | max 0.301 V |
| INFO: NEG_RAILS_OK level after trip (pull-up AUX/2 once LM339 < VS min) | INFO | **FAIL** | max 0.995 V |
| INFO: IL_REF stays off (< 0.1 V) once switched off | INFO | PASS | max 0.041 V |
| G: VGG_PA within -2.0 .. 0 V (+10 mV) | SAFETY | PASS | max +2 mV at 125.537 ms, min -1.746 V |
| A: drain < 0.5 V whenever a gate > -1.5 V outside armed TX | SAFETY | PASS | ok |
| T50: drain < 0.5 V within 50 us of 'first monitored threshold (VIN loss)' | SAFETY | PASS | VOUT < 0.5 V at +27.2 us; VOUT at +50 us = 0.00 V |
| (a) switch open <= 10 us after 'first monitored threshold (VIN loss)' | SAFETY | PASS | tOFF complete +4.8 us |
| (b) residual PA energy <= 0.25 mJ, peak PA current <= 0.6 A after 'first monitored threshold (VIN loss)' | SAFETY | PASS | E = 0.062 mJ; peak per-PA 0.221 A |
| INFO gate vs drain after 'first monitored threshold (VIN loss)' | INFO | PASS | drain < 0.5 V at +27.2 us; first gate > -0.15 V at +1492.3 us; > 0 V at +3191.8 us |
| EN: drain switch never on while a supply is invalid | SAFETY | PASS | ok |
| REF: IL_REF never on while a supply is invalid | SAFETY | PASS | ok |
| M5a: PG_3V3RF <= 0.3 V whenever asserted (TLV755 EN guaranteed off) | SAFETY | PASS | max 0.051 V |
| M5b: clamped PA_DRAIN_EN < VENF min 1.08 V while PG_3V3RF asserted | SAFETY | PASS | max 0.295 V |
| M5c: clamped IL_CLR_N < LVC VIL (0.35 VCC) while PG_3V3RF asserted, VCC valid | SAFETY | PASS | max margin -577 mV |
| M5d: TPS386000 RESET_N sink current <= 5 mA abs max | SAFETY | PASS | max 4.31 mA (VOL specified only at 1 mA) |
| CB: no crowbar / switch overlap (shoot-through) | SAFETY | PASS | overlap 0.00 us; crowbar starts 8.5 us after switch opens; crowbar off 126.3 us before VOUT ramp; peak 9.1 A, 0.175 mJ total |

- first interlock threshold crossed: aux at 142.4426 ms
- drain < 0.5 V +1465.1 us before the first gate reaches -0.15 V
- max gate after VIN loss -0 mV; max NEG_OK after trip 0.00 V; max IL_EN after trip 0.00 V; max PA_ARMED after trip 0.00 V

### S7a +3V3_RF lost via PWR_EN_3V3 (neg rails up) (`s7a_rf_en_loss.cir`)

| event | time |
|---|---|
| PWR_EN_3V3 low | 142.0000 ms |
| PG_3V3RF low | 142.0005 ms |
| PA_DRAIN_EN low | 142.0005 ms |
| IL_EN low | 142.0005 ms |
| NEG_OK low | 142.0005 ms |
| TPS22810 switch open (tOFF done) | 142.0038 ms |
| IL_REF < 0.1 V | 142.0142 ms |
| +3V3_RF < 85 % (PGOOD UV) | 142.0240 ms |
| +3V3_RF < 2.8 V (ADAR1000 PA_BIAS high-Z, assumed) | 142.0256 ms |
| VOUT < 0.5 V | 142.0259 ms |
| any gate > -1.0 V | 142.0844 ms |
| any gate > -0.15 V | 143.2749 ms |

| check | kind | result | detail |
|---|---|---|---|
| G: VGG_PA within -2.0 .. 0 V (+10 mV) | SAFETY | PASS | max +2 mV at 125.537 ms, min -1.746 V |
| A: drain < 0.5 V whenever a gate > -1.5 V outside armed TX | SAFETY | PASS | ok |
| T50: drain < 0.5 V within 50 us of 'PWR_EN_3V3 low' | SAFETY | PASS | VOUT < 0.5 V at +25.9 us; VOUT at +50 us = 0.00 V |
| (a) switch open <= 10 us after 'PWR_EN_3V3 low' | SAFETY | PASS | tOFF complete +3.8 us |
| (b) residual PA energy <= 0.25 mJ, peak PA current <= 0.6 A after 'PWR_EN_3V3 low' | SAFETY | PASS | E = 0.060 mJ; peak per-PA 0.221 A |
| INFO gate vs drain after 'PWR_EN_3V3 low' | INFO | PASS | drain < 0.5 V at +25.9 us; first gate > -0.15 V at +1274.9 us; > 0 V at +2974.4 us |
| EN: drain switch never on while a supply is invalid | SAFETY | PASS | ok |
| REF: IL_REF never on while a supply is invalid | SAFETY | PASS | ok |
| M5a: PG_3V3RF <= 0.3 V whenever asserted (TLV755 EN guaranteed off) | SAFETY | PASS | max 0.021 V |
| M5b: clamped PA_DRAIN_EN < VENF min 1.08 V while PG_3V3RF asserted | SAFETY | PASS | max 0.285 V |
| M5c: clamped IL_CLR_N < LVC VIL (0.35 VCC) while PG_3V3RF asserted, VCC valid | SAFETY | PASS | max margin -578 mV |
| M5d: TPS386000 RESET_N sink current <= 5 mA abs max | SAFETY | PASS | max 0.02 mA (VOL specified only at 1 mA) |
| CB: no crowbar / switch overlap (shoot-through) | SAFETY | PASS | overlap 0.00 us; crowbar starts 8.0 us after switch opens; crowbar off 126.3 us before VOUT ramp; peak 9.1 A, 0.177 mJ total |

- -5V_BF 0.00 V and -3V3_SW -2.98 V at sim end (still up: AVDD1/VSS_SW present without AVDD3/VDD_SW; ADAR1000/ADTR1107 power-down order is not specified in the datasheets)
- max gate after the fault -2 mV; drain < 0.5 V +1249.1 us before any gate reaches -0.15 V

### S7b +3V3_RF silent collapse, EN high (neg rails up) (`s7b_rf_silent_collapse.cir`)

| event | time |
|---|---|
| +3V3_RF converter stops | 142.0000 ms |
| IL_EN low | 142.0122 ms |
| NEG_OK low | 142.0122 ms |
| PA_DRAIN_EN low | 142.0122 ms |
| TPS22810 switch open (tOFF done) | 142.0155 ms |
| +3V3_RF < 85 % (PGOOD UV) | 142.0240 ms |
| PG_3V3RF low | 142.0240 ms |
| +3V3_RF < 2.8 V (ADAR1000 PA_BIAS high-Z, assumed) | 142.0256 ms |
| IL_REF < 0.1 V | 142.0260 ms |
| VOUT < 0.5 V | 142.0384 ms |
| any gate > -1.0 V | 142.0841 ms |
| any gate > -0.15 V | 143.2746 ms |

| check | kind | result | detail |
|---|---|---|---|
| G: VGG_PA within -2.0 .. 0 V (+10 mV) | SAFETY | PASS | max +2 mV at 125.537 ms, min -1.746 V |
| A: drain < 0.5 V whenever a gate > -1.5 V outside armed TX | SAFETY | PASS | ok |
| T50: drain < 0.5 V within 50 us of '+3V3_RF < 85 %' | SAFETY | PASS | VOUT < 0.5 V at +14.4 us; VOUT at +50 us = 0.00 V |
| (a) switch open <= 10 us after '+3V3_RF < 85 %' | SAFETY | PASS | tOFF complete +0.0 us |
| (b) residual PA energy <= 0.25 mJ, peak PA current <= 0.6 A after '+3V3_RF < 85 %' | SAFETY | PASS | E = 0.029 mJ; peak per-PA 0.224 A |
| INFO gate vs drain after '+3V3_RF < 85 %' | INFO | PASS | drain < 0.5 V at +14.4 us; first gate > -0.15 V at +1250.6 us; > 0 V at +2950.0 us |
| EN: drain switch never on while a supply is invalid | SAFETY | PASS | ok |
| REF: IL_REF never on while a supply is invalid | SAFETY | PASS | ok |
| M5a: PG_3V3RF <= 0.3 V whenever asserted (TLV755 EN guaranteed off) | SAFETY | PASS | max 0.007 V |
| M5b: clamped PA_DRAIN_EN < VENF min 1.08 V while PG_3V3RF asserted | SAFETY | PASS | max 0.176 V |
| M5c: clamped IL_CLR_N < LVC VIL (0.35 VCC) while PG_3V3RF asserted, VCC valid | SAFETY | PASS | max margin -578 mV |
| M5d: TPS386000 RESET_N sink current <= 5 mA abs max | SAFETY | PASS | max 0.02 mA (VOL specified only at 1 mA) |
| CB: no crowbar / switch overlap (shoot-through) | SAFETY | PASS | overlap 0.00 us; crowbar starts 9.1 us after switch opens; crowbar off 126.3 us before VOUT ramp; peak 9.0 A, 0.172 mJ total |

- -5V_BF 0.00 V and -3V3_SW -2.98 V at sim end (still up: AVDD1/VSS_SW present without AVDD3/VDD_SW; ADAR1000/ADTR1107 power-down order is not specified in the datasheets)
- max gate after the fault -2 mV; drain < 0.5 V +1236.2 us before any gate reaches -0.15 V

## Details: R2 / nom

### S1 normal power-up (`s1_powerup.cir`)

| event | time |
|---|---|
| VIN_12V > 8 V (TPS62933 UVLO start) | 0.6667 ms |
| NEG_RAILS_OK > 0.675 V first time (glitch: LM339 below VS min 2 V) | 2.6183 ms |
| +1V8_DIG > 1.71 V | 3.3553 ms |
| +3V3_AUX > 2.0 V (LM339 active, glitch ends) | 3.5570 ms |
| +3V3_AUX > 3.0 V | 4.9993 ms |
| PWR_EN_3V3 / 5VPA / NEG asserted (MCU) | 8.0010 ms |
| +5V_PA > 4.5 V | 10.9789 ms |
| +3V3_RF (AVDD3, VDD_SW) > 90 % | 11.0069 ms |
| ENN (U913) high | 12.2419 ms |
| PG_3V3RF high | 12.2419 ms |
| PWR_VNEG < -6.0 V | 13.1897 ms |
| -3V3_SW (VSS_SW) < -0.33 V | 24.5217 ms |
| -5V_BF (AVDD1) < -0.5 V | 24.6108 ms |
| -3V3_SW < -3.0 V (monitor trip) | 121.2925 ms |
| NEG_OK high first time | 122.9873 ms |
| NEG_OK high (gates pinched) | 122.9873 ms |
| IL_EN high first time (U915) | 122.9873 ms |
| NEG_RAILS_OK high (rails good) | 122.9875 ms |
| -5V_BF < -4.6 V (monitor trip) | 123.0785 ms |
| IL_REF > 0.5 V first time | 123.1295 ms |
| IL_REF > 1.7 V (rails good) | 123.2129 ms |
| firmware PA_BIAS -> -1.75 V | 140.0000 ms |
| GATES_OK high | 140.0019 ms |
| all gates < -1.5 V | 140.0025 ms |
| GATES_PINCHED high | 140.0040 ms |
| MCU_PA_EN high | 140.2005 ms |
| PA_ARMED high first time (pessimistic flop SET while +1V8_DIG < 1.65 V) | 140.2084 ms |
| PA_DRAIN_EN > 1.08 V first time | 140.2084 ms |
| PA_ARMED high | 140.2084 ms |
| PA_DRAIN_EN high | 140.2084 ms |
| VOUT (drain) > 0.5 V | 140.3672 ms |
| VOUT (drain) > 4.5 V | 140.5528 ms |
| firmware PA_BIAS -> -1.1 V (TX) | 141.0000 ms |
| any gate > -1.5 V | 141.0010 ms |

| check | kind | result | detail |
|---|---|---|---|
| AVDD3 (+3V3_RF 90 %) before AVDD1 (-5V_BF -10 %) [ADAR1000 p13] | SAFETY | PASS | lead 13.60 ms |
| VDD_SW (+3V3_RF 90 %) before VSS_SW (-3V3_SW -10 %) [ADTR1107 p24] | SAFETY | PASS | lead 13.51 ms |
| TPS65131 does not start (PWR_VNEG < -0.5 V) before PG_3V3RF, although PWR_EN_NEG was asserted early | SAFETY | PASS | PWR_VNEG < -0.5 V at 12.3226 ms, PG at 12.2419 ms |
| INFO: ENN logic level not high before PG_3V3RF (U913 output; pessimistic mode drives it to VCC while +1V8_DIG < 1.65 V) | INFO | PASS | ENN first high at 12.2419 ms |
| PA_ARMED only after all gates pinched | SAFETY | PASS | +205.9 us |
| G: VGG_PA within -2.0 .. 0 V (+10 mV) | SAFETY | PASS | max +2 mV at 123.228 ms, min -1.746 V |
| A: drain < 0.5 V whenever a gate > -1.5 V outside armed TX | SAFETY | PASS | ok |
| EN: drain switch never on while a supply is invalid | SAFETY | PASS | ok |
| REF: IL_REF never on while a supply is invalid | SAFETY | PASS | ok |
| M5a: PG_3V3RF <= 0.3 V whenever asserted (TLV755 EN guaranteed off) | SAFETY | PASS | max 0.002 V |
| M5b: clamped PA_DRAIN_EN < VENF min 1.08 V while PG_3V3RF asserted | SAFETY | PASS | max 0.000 V |
| M5c: clamped IL_CLR_N < LVC VIL (0.35 VCC) while PG_3V3RF asserted, VCC valid | SAFETY | PASS | max margin -578 mV |
| M5d: TPS386000 RESET_N sink current <= 5 mA abs max | SAFETY | PASS | max 0.00 mA (VOL specified only at 1 mA) |

- max IL_REF before -5V_BF is good: 0.000 V; max NEG_OK: 0.000 V; max NEG_RAILS_OK during AUX ramp 1.001 V (unchanged pull-up, now gated by PG_3V3RF in U915)
- max gate voltage before firmware programs PA_BIAS: +2.1 mV (ADAR1000 unpowered/at reset)
- -3V3_SW and -5V_BF ramp together (same TPS65131, same 120 ms SS); ADAR1000 p44 lists -3.3 V before -5 V: -3V3_SW reaches -10 % +89.1 us before -5V_BF
- TX drain current (4 PAs) at end: 0.885 A, VOUT 4.89 V

### S2 MCU_PA_EN with unprogrammed / unpinched gates (`s2_unprogrammed_gates.cir`)

| event | time |
|---|---|
| NEG_RAILS_OK high | 3.2686 ms |
| MCU_PA_EN high (gates at reset 0 V) | 140.2000 ms |
| MCU_PA_EN low | 140.5000 ms |
| gates programmed ON -1.1 V (not pinched) | 140.6000 ms |
| MCU_PA_EN high again | 140.7000 ms |
| PA_ARMED high | never |
| PA_DRAIN_EN high | never |
| VOUT > 0.5 V | never |

| check | kind | result | detail |
|---|---|---|---|
| G: VGG_PA within -2.0 .. 0 V (+10 mV) | SAFETY | PASS | max +2 mV at 123.224 ms, min -1.098 V |
| A: drain < 0.5 V whenever a gate > -1.5 V outside armed TX | SAFETY | PASS | ok |
| EN: drain switch never on while a supply is invalid | SAFETY | PASS | ok |
| REF: IL_REF never on while a supply is invalid | SAFETY | PASS | ok |
| M5a: PG_3V3RF <= 0.3 V whenever asserted (TLV755 EN guaranteed off) | SAFETY | PASS | max 0.002 V |
| M5b: clamped PA_DRAIN_EN < VENF min 1.08 V while PG_3V3RF asserted | SAFETY | PASS | max 0.000 V |
| M5c: clamped IL_CLR_N < LVC VIL (0.35 VCC) while PG_3V3RF asserted, VCC valid | SAFETY | PASS | max margin -578 mV |
| M5d: TPS386000 RESET_N sink current <= 5 mA abs max | SAFETY | PASS | max 0.00 mA (VOL specified only at 1 mA) |

- GATES_OK at 140.3 ms = 0.01 V, NEG_OK = 0.00 V, IL_CLR_N = 0.00 V
- GATES_PINCHED at 140.8 ms = 0.01 V, NEG_OK = 1.80 V
- max VOUT 0.000 V, max PA_ARMED 0.00 V

### S3 gate lost during TX (`s3_gate_lost.cir`)

| event | time |
|---|---|
| PA_BIAS1 step -1.1 -> 0 V | 142.0000 ms |
| gate1 > -0.15 V (fault) | 142.0025 ms |
| NEG_OK low | 142.0037 ms |
| PA_DRAIN_EN low | 142.0037 ms |
| GATES_OK low (< VIL) | 142.0037 ms |
| PA_ARMED low | 142.0037 ms |
| VOUT < 4.5 V | 142.0125 ms |
| VOUT < 0.5 V | 142.0760 ms |
| PA_BIAS1 restored -1.1 V (must stay off) | 142.3000 ms |

| check | kind | result | detail |
|---|---|---|---|
| G: VGG_PA within -2.0 .. 0 V (+10 mV) | SAFETY | PASS | max +2 mV at 123.225 ms, min -1.745 V |
| A: drain < 0.5 V whenever a gate > -1.5 V outside armed TX | SAFETY | **FAIL** | violated 142.0531..142.0751 ms, max VOUT 1.90 V |
| T50: drain < 0.5 V within 50 us of 'gate1 lost (> -0.15 V)' | SAFETY | **FAIL** | VOUT < 0.5 V at +73.5 us; VOUT at +50 us = 1.93 V |
| (a) switch open <= 10 us after 'gate1 lost (> -0.15 V)' | SAFETY | PASS | tOFF complete +4.5 us |
| (b) residual PA energy <= 0.25 mJ, peak PA current <= 0.6 A after 'gate1 lost (> -0.15 V)' | SAFETY | PASS | E = 0.232 mJ; peak per-PA 0.601 A |
| INFO gate vs drain after 'gate1 lost (> -0.15 V)' | INFO | PASS | drain < 0.5 V at +73.5 us; first gate > -0.15 V at n/a; > 0 V at +2.5 us |
| EN: drain switch never on while a supply is invalid | SAFETY | PASS | ok |
| REF: IL_REF never on while a supply is invalid | SAFETY | PASS | ok |
| M5a: PG_3V3RF <= 0.3 V whenever asserted (TLV755 EN guaranteed off) | SAFETY | PASS | max 0.002 V |
| M5b: clamped PA_DRAIN_EN < VENF min 1.08 V while PG_3V3RF asserted | SAFETY | PASS | max 0.000 V |
| M5c: clamped IL_CLR_N < LVC VIL (0.35 VCC) while PG_3V3RF asserted, VCC valid | SAFETY | PASS | max margin -578 mV |
| M5d: TPS386000 RESET_N sink current <= 5 mA abs max | SAFETY | PASS | max 0.00 mA (VOL specified only at 1 mA) |

- peak PA1 current 0.601 A (nominal 0.22 A); peak chain current 1.265 A
- PA1 energy from step to VOUT < 0.5 V: 0.127 mJ; to sim end: 0.128 mJ; stored in 19.81 uF at 5 V: 0.248 mJ
- VOUT at 142.5 ms after gate restored: 0.000 V, PA_ARMED 0.00 V

### S4a -5V_BF collapse via TPS65131 ENN (`s4a_neg_collapse_enn.cir`)

| event | time |
|---|---|
| PWR_EN_NEG / ENN low | 142.0000 ms |
| PWR_VNEG > -5.2 V (LDO in dropout) | 142.2149 ms |
| -5V_BF > -4.6 V (rail comparator) | 142.3807 ms |
| NEG_RAILS_OK low (< VIL) | 142.3837 ms |
| PA_DRAIN_EN low | 142.3837 ms |
| IL_REF < 0.1 V | 142.4317 ms |
| VOUT < 0.5 V | 142.4866 ms |
| any gate > -1.0 V (drifting above TX bias) | 143.7565 ms |
| any gate > -0.15 V (gate-lost level) | 144.2020 ms |
| any gate > -0.01 V | 144.8352 ms |

| check | kind | result | detail |
|---|---|---|---|
| G: VGG_PA within -2.0 .. 0 V (+10 mV) | SAFETY | PASS | max +2 mV at 123.228 ms, min -1.746 V |
| A: drain < 0.5 V whenever a gate > -1.5 V outside armed TX | SAFETY | **FAIL** | violated 142.4313..142.4846 ms, max VOUT 2.90 V |
| T50: drain < 0.5 V within 50 us of '-5V_BF > -4.6 V' | SAFETY | **FAIL** | VOUT < 0.5 V at +106.0 us; VOUT at +50 us = 2.92 V |
| (a) switch open <= 10 us after '-5V_BF > -4.6 V' | SAFETY | PASS | tOFF complete +6.3 us |
| (b) residual PA energy <= 0.25 mJ, peak PA current <= 0.6 A after '-5V_BF > -4.6 V' | SAFETY | PASS | E = 0.235 mJ; peak per-PA 0.221 A |
| INFO gate vs drain after '-5V_BF > -4.6 V' | INFO | PASS | drain < 0.5 V at +106.0 us; first gate > -0.15 V at +1821.4 us; > 0 V at +2454.5 us |
| EN: drain switch never on while a supply is invalid | SAFETY | PASS | ok |
| REF: IL_REF never on while a supply is invalid | SAFETY | PASS | ok |
| M5a: PG_3V3RF <= 0.3 V whenever asserted (TLV755 EN guaranteed off) | SAFETY | PASS | max 0.002 V |
| M5b: clamped PA_DRAIN_EN < VENF min 1.08 V while PG_3V3RF asserted | SAFETY | PASS | max 0.000 V |
| M5c: clamped IL_CLR_N < LVC VIL (0.35 VCC) while PG_3V3RF asserted, VCC valid | SAFETY | PASS | max margin -578 mV |
| M5d: TPS386000 RESET_N sink current <= 5 mA abs max | SAFETY | PASS | max 0.00 mA (VOL specified only at 1 mA) |

- first trip: rail comparator (-4.6 V); drain < 0.5 V +1715.4 us before the first gate reaches -0.15 V

### S4b -5V_BF collapse via TPS7A33 disable (`s4b_neg_collapse_ldo.cir`)

| event | time |
|---|---|
| -5V_BF LDO disabled | 142.0000 ms |
| -5V_BF > -4.6 V (rail comparator) | 142.0933 ms |
| NEG_RAILS_OK low (< VIL) | 142.0972 ms |
| PA_DRAIN_EN low | 142.0972 ms |
| IL_REF < 0.1 V | 142.1452 ms |
| VOUT < 0.5 V | 142.2001 ms |
| any gate > -1.0 V (drifting above TX bias) | 142.9396 ms |
| any gate > -0.15 V (gate-lost level) | 143.3852 ms |
| any gate > -0.01 V | 144.0183 ms |
| PWR_VNEG > -5.2 V (LDO in dropout) | never |

| check | kind | result | detail |
|---|---|---|---|
| G: VGG_PA within -2.0 .. 0 V (+10 mV) | SAFETY | PASS | max +2 mV at 123.228 ms, min -1.746 V |
| A: drain < 0.5 V whenever a gate > -1.5 V outside armed TX | SAFETY | **FAIL** | violated 142.1449..142.1982 ms, max VOUT 2.89 V |
| T50: drain < 0.5 V within 50 us of '-5V_BF > -4.6 V' | SAFETY | **FAIL** | VOUT < 0.5 V at +106.8 us; VOUT at +50 us = 2.96 V |
| (a) switch open <= 10 us after '-5V_BF > -4.6 V' | SAFETY | PASS | tOFF complete +7.1 us |
| (b) residual PA energy <= 0.25 mJ, peak PA current <= 0.6 A after '-5V_BF > -4.6 V' | SAFETY | PASS | E = 0.235 mJ; peak per-PA 0.221 A |
| INFO gate vs drain after '-5V_BF > -4.6 V' | INFO | PASS | drain < 0.5 V at +106.8 us; first gate > -0.15 V at +1291.9 us; > 0 V at +1925.0 us |
| EN: drain switch never on while a supply is invalid | SAFETY | PASS | ok |
| REF: IL_REF never on while a supply is invalid | SAFETY | PASS | ok |
| M5a: PG_3V3RF <= 0.3 V whenever asserted (TLV755 EN guaranteed off) | SAFETY | PASS | max 0.002 V |
| M5b: clamped PA_DRAIN_EN < VENF min 1.08 V while PG_3V3RF asserted | SAFETY | PASS | max 0.000 V |
| M5c: clamped IL_CLR_N < LVC VIL (0.35 VCC) while PG_3V3RF asserted, VCC valid | SAFETY | PASS | max margin -578 mV |
| M5d: TPS386000 RESET_N sink current <= 5 mA abs max | SAFETY | PASS | max 0.00 mA (VOL specified only at 1 mA) |

- first trip: rail comparator (-4.6 V); drain < 0.5 V +1185.1 us before the first gate reaches -0.15 V

### S5a watchdog fault during TX + recovery (`s5a_watchdog_tx.cir`)

| event | time |
|---|---|
| WDT_OK low | 142.0000 ms |
| PA_DRAIN_EN low | 142.0005 ms |
| PA_ARMED low | 142.0007 ms |
| VOUT < 0.5 V | 142.1031 ms |
| WDT_OK high again | 142.5000 ms |
| MCU_PA_EN toggle with gates ON (142.6/142.7 ms) | 142.7000 ms |
| gates OFF -1.75 V | 142.8000 ms |
| MCU_PA_EN re-arm edge | 143.0000 ms |
| PA_ARMED high (should be after 143.0 ms) | 143.0090 ms |
| PA_DRAIN_EN high | 143.0090 ms |
| VOUT > 4.5 V | 143.3534 ms |
| gates ON -1.1 V (TX) | 143.6000 ms |

| check | kind | result | detail |
|---|---|---|---|
| No re-arm while gates ON (142.7 ms toggle ignored) | SAFETY | PASS | 143.0090 ms |
| G: VGG_PA within -2.0 .. 0 V (+10 mV) | SAFETY | PASS | max +2 mV at 123.224 ms, min -1.746 V |
| A: drain < 0.5 V whenever a gate > -1.5 V outside armed TX | SAFETY | **FAIL** | violated 142.0510..142.1030 ms, max VOUT 2.76 V |
| T50: drain < 0.5 V within 50 us of 'WDT_OK low' | SAFETY | **FAIL** | VOUT < 0.5 V at +103.1 us; VOUT at +50 us = 2.81 V |
| (a) switch open <= 10 us after 'WDT_OK low' | SAFETY | PASS | tOFF complete +3.8 us |
| (b) residual PA energy <= 0.25 mJ, peak PA current <= 0.6 A after 'WDT_OK low' | SAFETY | PASS | E = 0.235 mJ; peak per-PA 0.221 A |
| INFO gate vs drain after 'WDT_OK low' | INFO | PASS | drain < 0.5 V at +103.1 us; first gate > -0.15 V at n/a; > 0 V at n/a |
| EN: drain switch never on while a supply is invalid | SAFETY | PASS | ok |
| REF: IL_REF never on while a supply is invalid | SAFETY | PASS | ok |
| M5a: PG_3V3RF <= 0.3 V whenever asserted (TLV755 EN guaranteed off) | SAFETY | PASS | max 0.002 V |
| M5b: clamped PA_DRAIN_EN < VENF min 1.08 V while PG_3V3RF asserted | SAFETY | PASS | max 0.000 V |
| M5c: clamped IL_CLR_N < LVC VIL (0.35 VCC) while PG_3V3RF asserted, VCC valid | SAFETY | PASS | max margin -578 mV |
| M5d: TPS386000 RESET_N sink current <= 5 mA abs max | SAFETY | PASS | max 0.00 mA (VOL specified only at 1 mA) |

### S5b watchdog fault while armed, gates pinched (`s5b_watchdog_idle.cir`)

| event | time |
|---|---|
| WDT_OK low (armed, gates -1.75 V, no PA current) | 141.0000 ms |
| PA_DRAIN_EN low | 141.0005 ms |
| VOUT < 4.5 V | 141.5393 ms |
| VOUT < 0.5 V | 148.1798 ms |

| check | kind | result | detail |
|---|---|---|---|
| G: VGG_PA within -2.0 .. 0 V (+10 mV) | SAFETY | PASS | max +2 mV at 123.233 ms, min -1.746 V |
| A: drain < 0.5 V whenever a gate > -1.5 V outside armed TX | SAFETY | PASS | ok |
| T50: drain < 0.5 V within 50 us of 'WDT_OK low' | SAFETY | **FAIL** | VOUT < 0.5 V at +7179.8 us; VOUT at +50 us = 4.95 V |
| (a) switch open <= 10 us after 'WDT_OK low' | SAFETY | PASS | tOFF complete +3.8 us |
| (b) residual PA energy <= 0.25 mJ, peak PA current <= 0.6 A after 'WDT_OK low' | SAFETY | PASS | E = 0.114 mJ; peak per-PA 0.002 A |
| INFO gate vs drain after 'WDT_OK low' | INFO | PASS | drain < 0.5 V at +7179.8 us; first gate > -0.15 V at n/a; > 0 V at n/a |
| EN: drain switch never on while a supply is invalid | SAFETY | PASS | ok |
| REF: IL_REF never on while a supply is invalid | SAFETY | PASS | ok |
| M5a: PG_3V3RF <= 0.3 V whenever asserted (TLV755 EN guaranteed off) | SAFETY | PASS | max 0.002 V |
| M5b: clamped PA_DRAIN_EN < VENF min 1.08 V while PG_3V3RF asserted | SAFETY | PASS | max 0.000 V |
| M5c: clamped IL_CLR_N < LVC VIL (0.35 VCC) while PG_3V3RF asserted, VCC valid | SAFETY | PASS | max margin -578 mV |
| M5d: TPS386000 RESET_N sink current <= 5 mA abs max | SAFETY | PASS | max 0.00 mA (VOL specified only at 1 mA) |

- QOD-only discharge (RPD 400 ohm x 19.81 uF, tau 7.9 ms): VOUT < 0.5 V after 7.18 ms
- gates stay at -1.75 V, so no PA current flows; the residual charge is 0.25 mJ

### S6 VIN_12V loss during TX (`s6_vin_loss.cir`)

| event | time |
|---|---|
| VIN_12V starts falling (12 -> 0 V / 1 ms) | 142.0000 ms |
| VIN < 7 V (TPS62933 UVLO stop, AUX stops) | 142.4167 ms |
| +3V3_AUX < 2.97 V (AUX UV comparator) | 142.4425 ms |
| PA_DRAIN_EN low | 142.4441 ms |
| NEG_RAILS_OK low (< VIL) | 142.4441 ms |
| +3V3_AUX < 2.35 V (TPS65131 UVLO) | 142.4840 ms |
| VOUT < 0.5 V | 142.5469 ms |
| +3V3_AUX < 2.0 V (LM339 VS min) | 142.5496 ms |
| NEG_RAILS_OK back > 0.675 V (LM339 below VS min) | 142.5510 ms |
| NEG_OK back high | 142.5512 ms |
| IL_EN back high | 142.5512 ms |
| VIN < 5.3 V (+5V_PA out of regulation) | 142.5583 ms |
| +1V8_DIG < 1.65 V | 142.5913 ms |
| PG_3V3RF low | 142.5913 ms |
| +3V3_RF < 2.8 V (ADAR1000 PA_BIAS high-Z, assumed) | 142.6163 ms |
| any gate > -1.0 V (drifting above TX bias) | 142.6751 ms |
| -5V_BF > -4.6 V | 142.8642 ms |
| any gate > -0.15 V | 143.8657 ms |
| any gate > -0.01 V | 145.5653 ms |
| -3V3_SW > -3.0 V | 146.2991 ms |
| IL_REF back > 0.5 V | never |
| PG_3V3RF floats high again (TPS568230 VIN < 1.5 V, assumed) | never |

| check | kind | result | detail |
|---|---|---|---|
| INFO: IL_EN and NEG_OK logic levels stay low after the trip (LVC outputs; hazard checked by EN/REF/PA_DRAIN_EN) | INFO | **FAIL** | max IL_EN 1.799 V, max NEG_OK 1.800 V |
| PA_DRAIN_EN stays < VENF 1.08 V after trip | SAFETY | PASS | max 0.394 V |
| INFO: NEG_RAILS_OK level after trip (pull-up AUX/2 once LM339 < VS min) | INFO | **FAIL** | max 0.995 V |
| INFO: IL_REF stays off (< 0.1 V) once switched off | INFO | PASS | max 0.091 V |
| G: VGG_PA within -2.0 .. 0 V (+10 mV) | SAFETY | PASS | max +2 mV at 123.224 ms, min -1.746 V |
| A: drain < 0.5 V whenever a gate > -1.5 V outside armed TX | SAFETY | **FAIL** | violated 142.4928..142.5460 ms, max VOUT 2.85 V |
| T50: drain < 0.5 V within 50 us of 'first monitored threshold (VIN loss)' | SAFETY | **FAIL** | VOUT < 0.5 V at +104.4 us; VOUT at +50 us = 2.86 V |
| (a) switch open <= 10 us after 'first monitored threshold (VIN loss)' | SAFETY | PASS | tOFF complete +4.8 us |
| (b) residual PA energy <= 0.25 mJ, peak PA current <= 0.6 A after 'first monitored threshold (VIN loss)' | SAFETY | PASS | E = 0.235 mJ; peak per-PA 0.221 A |
| INFO gate vs drain after 'first monitored threshold (VIN loss)' | INFO | PASS | drain < 0.5 V at +104.4 us; first gate > -0.15 V at +1423.2 us; > 0 V at +3122.8 us |
| EN: drain switch never on while a supply is invalid | SAFETY | PASS | ok |
| REF: IL_REF never on while a supply is invalid | SAFETY | PASS | ok |
| M5a: PG_3V3RF <= 0.3 V whenever asserted (TLV755 EN guaranteed off) | SAFETY | PASS | max 0.002 V |
| M5b: clamped PA_DRAIN_EN < VENF min 1.08 V while PG_3V3RF asserted | SAFETY | PASS | max 0.000 V |
| M5c: clamped IL_CLR_N < LVC VIL (0.35 VCC) while PG_3V3RF asserted, VCC valid | SAFETY | PASS | max margin -578 mV |
| M5d: TPS386000 RESET_N sink current <= 5 mA abs max | SAFETY | PASS | max 0.00 mA (VOL specified only at 1 mA) |

- first interlock threshold crossed: aux at 142.4425 ms
- drain < 0.5 V +1318.8 us before the first gate reaches -0.15 V
- max gate after VIN loss -0 mV; max NEG_OK after trip 1.80 V; max IL_EN after trip 1.80 V; max PA_ARMED after trip 0.00 V

### S7a +3V3_RF lost via PWR_EN_3V3 (neg rails up) (`s7a_rf_en_loss.cir`)

| event | time |
|---|---|
| PWR_EN_3V3 low | 142.0000 ms |
| PG_3V3RF low | 142.0005 ms |
| IL_EN low | 142.0005 ms |
| NEG_OK low | 142.0005 ms |
| PA_DRAIN_EN low | 142.0005 ms |
| TPS22810 switch open (tOFF done) | 142.0038 ms |
| +3V3_RF < 85 % (PGOOD UV) | 142.0240 ms |
| +3V3_RF < 2.8 V (ADAR1000 PA_BIAS high-Z, assumed) | 142.0256 ms |
| IL_REF < 0.1 V | 142.0489 ms |
| any gate > -1.0 V | 142.0786 ms |
| VOUT < 0.5 V | 142.0960 ms |
| any gate > -0.15 V | 143.2692 ms |

| check | kind | result | detail |
|---|---|---|---|
| G: VGG_PA within -2.0 .. 0 V (+10 mV) | SAFETY | PASS | max +2 mV at 123.224 ms, min -1.746 V |
| A: drain < 0.5 V whenever a gate > -1.5 V outside armed TX | SAFETY | **FAIL** | violated 142.0515..142.0955 ms, max VOUT 2.69 V |
| T50: drain < 0.5 V within 50 us of 'PWR_EN_3V3 low' | SAFETY | **FAIL** | VOUT < 0.5 V at +96.0 us; VOUT at +50 us = 2.77 V |
| (a) switch open <= 10 us after 'PWR_EN_3V3 low' | SAFETY | PASS | tOFF complete +3.8 us |
| (b) residual PA energy <= 0.25 mJ, peak PA current <= 0.6 A after 'PWR_EN_3V3 low' | SAFETY | PASS | E = 0.235 mJ; peak per-PA 0.252 A |
| INFO gate vs drain after 'PWR_EN_3V3 low' | INFO | PASS | drain < 0.5 V at +96.0 us; first gate > -0.15 V at +1269.2 us; > 0 V at +2968.8 us |
| EN: drain switch never on while a supply is invalid | SAFETY | PASS | ok |
| REF: IL_REF never on while a supply is invalid | SAFETY | PASS | ok |
| M5a: PG_3V3RF <= 0.3 V whenever asserted (TLV755 EN guaranteed off) | SAFETY | PASS | max 0.002 V |
| M5b: clamped PA_DRAIN_EN < VENF min 1.08 V while PG_3V3RF asserted | SAFETY | PASS | max 0.433 V |
| M5c: clamped IL_CLR_N < LVC VIL (0.35 VCC) while PG_3V3RF asserted, VCC valid | SAFETY | PASS | max margin -578 mV |
| M5d: TPS386000 RESET_N sink current <= 5 mA abs max | SAFETY | PASS | max 0.00 mA (VOL specified only at 1 mA) |

- -5V_BF 0.00 V and -3V3_SW -2.98 V at sim end (still up: AVDD1/VSS_SW present without AVDD3/VDD_SW; ADAR1000/ADTR1107 power-down order is not specified in the datasheets)
- max gate after the fault -2 mV; drain < 0.5 V +1173.2 us before any gate reaches -0.15 V

### S7b +3V3_RF silent collapse, EN high (neg rails up) (`s7b_rf_silent_collapse.cir`)

| event | time |
|---|---|
| +3V3_RF converter stops | 142.0000 ms |
| +3V3_RF < 85 % (PGOOD UV) | 142.0240 ms |
| PG_3V3RF low | 142.0240 ms |
| IL_EN low | 142.0240 ms |
| NEG_OK low | 142.0240 ms |
| PA_DRAIN_EN low | 142.0240 ms |
| +3V3_RF < 2.8 V (ADAR1000 PA_BIAS high-Z, assumed) | 142.0256 ms |
| TPS22810 switch open (tOFF done) | 142.0274 ms |
| any gate > -1.0 V | 142.0586 ms |
| IL_REF < 0.1 V | 142.0724 ms |
| VOUT < 0.5 V | 142.1122 ms |
| any gate > -0.15 V | 143.2463 ms |

| check | kind | result | detail |
|---|---|---|---|
| G: VGG_PA within -2.0 .. 0 V (+10 mV) | SAFETY | PASS | max +2 mV at 123.224 ms, min -1.746 V |
| A: drain < 0.5 V whenever a gate > -1.5 V outside armed TX | SAFETY | **FAIL** | violated 142.0751..142.1111 ms, max VOUT 2.48 V |
| T50: drain < 0.5 V within 50 us of '+3V3_RF < 85 %' | SAFETY | **FAIL** | VOUT < 0.5 V at +88.1 us; VOUT at +50 us = 2.54 V |
| (a) switch open <= 10 us after '+3V3_RF < 85 %' | SAFETY | PASS | tOFF complete +3.3 us |
| (b) residual PA energy <= 0.25 mJ, peak PA current <= 0.6 A after '+3V3_RF < 85 %' | SAFETY | PASS | E = 0.235 mJ; peak per-PA 0.274 A |
| INFO gate vs drain after '+3V3_RF < 85 %' | INFO | PASS | drain < 0.5 V at +88.1 us; first gate > -0.15 V at +1222.3 us; > 0 V at +2921.9 us |
| EN: drain switch never on while a supply is invalid | SAFETY | PASS | ok |
| REF: IL_REF never on while a supply is invalid | SAFETY | PASS | ok |
| M5a: PG_3V3RF <= 0.3 V whenever asserted (TLV755 EN guaranteed off) | SAFETY | PASS | max 0.002 V |
| M5b: clamped PA_DRAIN_EN < VENF min 1.08 V while PG_3V3RF asserted | SAFETY | PASS | max 0.430 V |
| M5c: clamped IL_CLR_N < LVC VIL (0.35 VCC) while PG_3V3RF asserted, VCC valid | SAFETY | PASS | max margin -578 mV |
| M5d: TPS386000 RESET_N sink current <= 5 mA abs max | SAFETY | PASS | max 0.00 mA (VOL specified only at 1 mA) |

- -5V_BF 0.00 V and -3V3_SW -2.98 V at sim end (still up: AVDD1/VSS_SW present without AVDD3/VDD_SW; ADAR1000/ADTR1107 power-down order is not specified in the datasheets)
- max gate after the fault -2 mV; drain < 0.5 V +1134.2 us before any gate reaches -0.15 V
