CLIS-WPI/OpenRU/hardware/h2/sim/h2c_d_worst_FIX_pess_fail.png

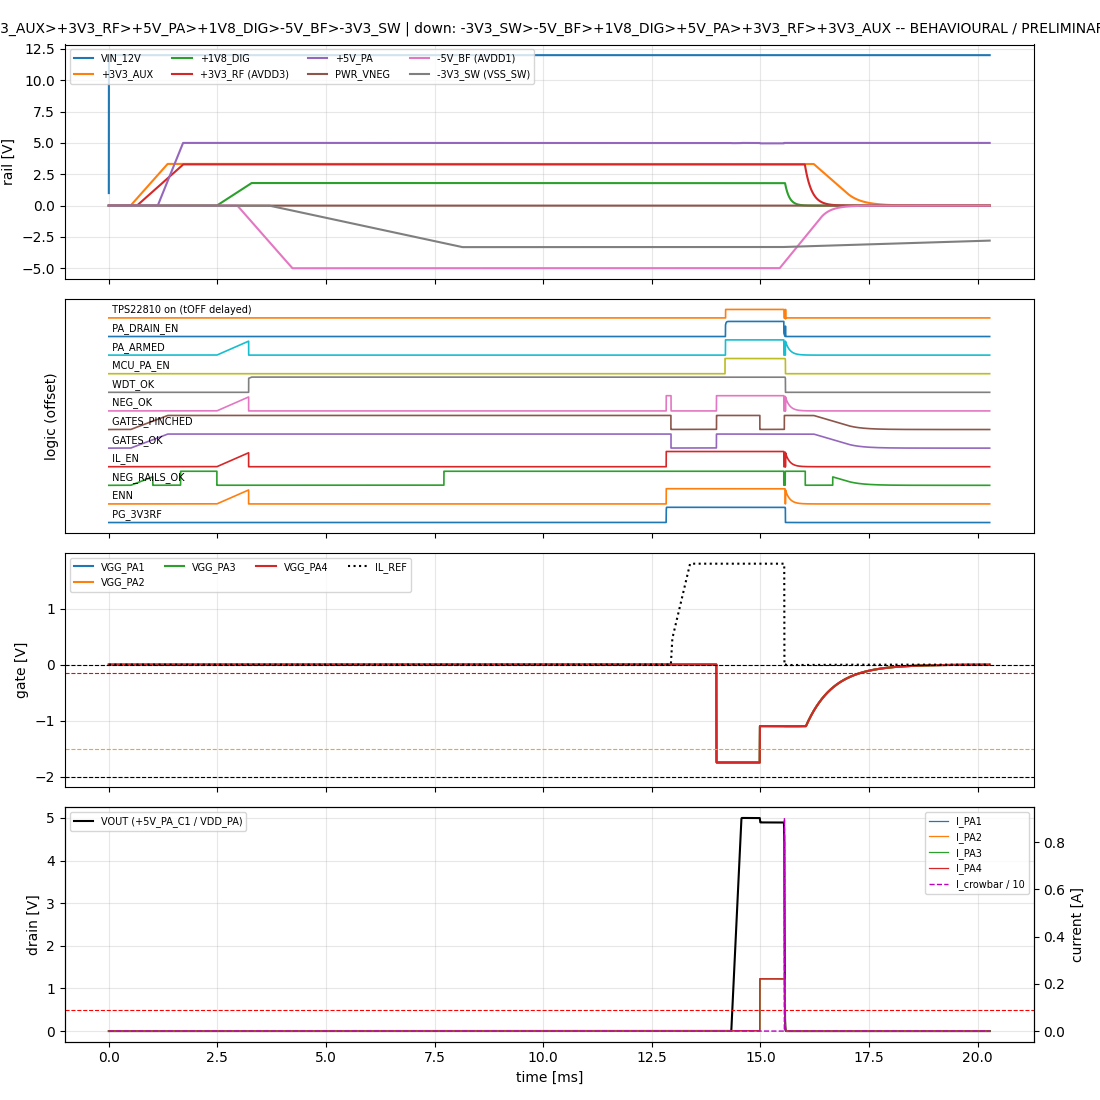
hardware/h2/sim/h2c_d_worst_FIX_pess_fail.png
