CLIS-WPI/OpenRU/hardware/h2/sim/d_worst_FIX_nom_gmax.cir

* D ordering run R126 -- BEHAVIOURAL / PRELIMINARY (free-rail mode, ADAR1000 register reset)
* rails on/off (ms): +3V3_AUX [(1.5859152909996126, None)]; +1V8_DIG [(7.949260998481094, None)]; +3V3_RF [(2.7081881216199455, None)]; +5V_PA [(4.719842346667788, None)]; -5V_BF [(4.412815328661956, None)]; -3V3_SW [(6.138376722603272, 29.681360001114317)]
.include h2c_plant.inc
.param cb_en=1 ilref_mode=2 sup_en=1 rf_uv=3.1 cref=10n asb=1 cb_r=0.362 cb_vth=1.1 cb_ciss=340p q2_vth=0.75 sup_vth=1.6706 sup_aux=2.968 sup_trst=9.6 sup_tdet=0.1u fetclamp=1
.param free=1 adar_reset=1 tr_aux=1.684 tr_18=0.369 tr_rf=0.707 tr_pa=1.672 tr_n5=1.712 tr_n3=4.326
VVIN vin 0 PWL(0 12)
VE3 fw_en3v3 0 1
VE5 fw_en5vpa 0 1
VEN fw_enneg 0 1
VKL ldo5_kill 0 0
VRK rf_kill 0 0
VWD fw_wdt 0 PWL(0 1)
VPA fw_pa_en 0 PWL(0 0 0.0108302472 0 0.0108312472 1 0.0128351119 1 0.0128361119 1 0.0145943586 1 0.0145953586 0 0.0156507489 0 0.0156517489 0)
VD1 dac1 0 PWL(0 0 0.0106302472 0 0.0106312472 -1.75 0.0116302472 -1.75 0.0116312472 -1.1 0.0270056109 -1.1 0.0270066109 0)
VD2 dac2 0 PWL(0 0 0.0106302472 0 0.0106312472 -1.75 0.0116302472 -1.75 0.0116312472 -1.1 0.0270056109 -1.1 0.0270066109 0)
VD3 dac3 0 PWL(0 0 0.0106302472 0 0.0106312472 -1.75 0.0116302472 -1.75 0.0116312472 -1.1 0.0270056109 -1.1 0.0270066109 0)
VD4 dac4 0 PWL(0 0 0.0106302472 0 0.0106312472 -1.75 0.0116302472 -1.75 0.0116312472 -1.1 0.0270056109 -1.1 0.0270066109 0)
VTLW tlw 0 PWL(0 0 0.0106302472 0 0.0106312472 0.0106302 0.0116302472 0.0106302 0.0116312472 0.0116302 0.0270056109 0.0116302 0.0270066109 0.0270056)
VFR1 fr_aux 0 PWL(0 0 0.00158591529 0 0.00158691529 1)
VFR2 fr_18 0 PWL(0 0 0.007949261 0 0.007950261 1)
VFR3 fr_rf 0 PWL(0 0 0.00270818812 0 0.00270918812 1)
VFR4 fr_pa 0 PWL(0 0 0.00471984235 0 0.00472084235 1)
VFR5 fr_n5 0 PWL(0 0 0.00441281533 0 0.00441381533 1)
VFR6 fr_n3 0 PWL(0 0 0.00613837672 0 0.00613937672 1 0.02968136 1 0.02968236 0)
.tran 1u 0.04 0 2u
.end
