CLIS-WPI/OpenRU/hardware/h2/sim/d_worst_FIX_nom_gmin.cir

* D ordering run R119 -- BEHAVIOURAL / PRELIMINARY (free-rail mode, ADAR1000 register reset)
* rails on/off (ms): +3V3_AUX [(5.050771446528277, None)]; +1V8_DIG [(1.1194453627621481, None)]; +3V3_RF [(5.723890189927998, None)]; +5V_PA [(1.8395469103500566, None)]; -5V_BF [(7.288495207404938, None)]; -3V3_SW [(3.0102515947762436, 16.49503424103897), (29.41691339208149, None)]
.include h2c_plant.inc
.param cb_en=1 ilref_mode=2 sup_en=1 rf_uv=3.1 cref=10n asb=1 cb_r=0.362 cb_vth=1.1 cb_ciss=340p q2_vth=0.75 sup_vth=1.6706 sup_aux=2.968 sup_trst=9.6 sup_tdet=0.1u fetclamp=1
.param free=1 adar_reset=1 tr_aux=0.576 tr_18=0.473 tr_rf=1.562 tr_pa=0.795 tr_n5=4.796 tr_n3=4.511
VVIN vin 0 PWL(0 12)
VE3 fw_en3v3 0 1
VE5 fw_en5vpa 0 1
VEN fw_enneg 0 1
VKL ldo5_kill 0 0
VRK rf_kill 0 0
VWD fw_wdt 0 PWL(0 1)
VPA fw_pa_en 0 PWL(0 0 0.00209357406 0 0.00209457406 1 0.0073161373 1 0.0073171373 0 0.00870360138 0 0.00870460138 1 0.0110731955 1 0.0110741955 1 0.0130430338 1 0.0130440338 0 0.0141171464 0 0.0141181464 0)
VD1 dac1 0 PWL(0 0 0.0108731955 0 0.0108741955 -1.75 0.0118731955 -1.75 0.0118741955 -1.1 0.0266148491 -1.1 0.0266158491 -1.75)
VD2 dac2 0 PWL(0 0 0.0108731955 0 0.0108741955 -1.75 0.0118731955 -1.75 0.0118741955 -1.1 0.0266148491 -1.1 0.0266158491 -1.75)
VD3 dac3 0 PWL(0 0 0.0108731955 0 0.0108741955 -1.75 0.0118731955 -1.75 0.0118741955 -1.1 0.0266148491 -1.1 0.0266158491 -1.75)
VD4 dac4 0 PWL(0 0 0.0108731955 0 0.0108741955 -1.75 0.0118731955 -1.75 0.0118741955 -1.1 0.0266148491 -1.1 0.0266158491 -1.75)
VTLW tlw 0 PWL(0 0 0.0108731955 0 0.0108741955 0.0108732 0.0118731955 0.0108732 0.0118741955 0.0118732 0.0266148491 0.0118732 0.0266158491 0.0266148)
VFR1 fr_aux 0 PWL(0 0 0.00505077145 0 0.00505177145 1)
VFR2 fr_18 0 PWL(0 0 0.00111944536 0 0.00112044536 1)
VFR3 fr_rf 0 PWL(0 0 0.00572389019 0 0.00572489019 1)
VFR4 fr_pa 0 PWL(0 0 0.00183954691 0 0.00184054691 1)
VFR5 fr_n5 0 PWL(0 0 0.00728849521 0 0.00728949521 1)
VFR6 fr_n3 0 PWL(0 0 0.00301025159 0 0.00301125159 1 0.0164950342 1 0.0164960342 0 0.0294169134 0 0.0294179134 1)
.tran 1u 0.04 0 2u
.end
