CLIS-WPI/OpenRU/hardware/h2/sim/d_worst_FIX_nom_t05.cir

* D ordering run R180 -- BEHAVIOURAL / PRELIMINARY (free-rail mode, ADAR1000 register reset)
* rails on/off (ms): +3V3_AUX [(5.686521415491434, None)]; +1V8_DIG [(1.1344892506844912, None)]; +3V3_RF [(6.815748258689236, None)]; +5V_PA [(3.9733458996358624, 17.91863107067525), (29.915045568163485, None)]; -5V_BF [(7.864856382184397, None)]; -3V3_SW [(6.273081065907562, None)]
.include h2c_plant.inc
.param cb_en=1 ilref_mode=2 sup_en=1 rf_uv=3.1 cref=10n asb=1 cb_r=0.362 cb_vth=1.1 cb_ciss=340p q2_vth=0.75 sup_vth=1.6706 sup_aux=2.968 sup_trst=9.6 sup_tdet=0.1u fetclamp=1
.param free=1 adar_reset=1 tr_aux=0.420 tr_18=0.175 tr_rf=1.032 tr_pa=1.128 tr_n5=2.399 tr_n3=2.094
VVIN vin 0 PWL(0 12)
VE3 fw_en3v3 0 1
VE5 fw_en5vpa 0 1
VEN fw_enneg 0 1
VKL ldo5_kill 0 0
VRK rf_kill 0 0
VWD fw_wdt 0 PWL(0 1 0.017172726 1 0.017173726 0 0.0186128321 0 0.0186138321 1)
VPA fw_pa_en 0 PWL(0 0 0.015137659 0 0.015138659 1 0.0153431933 1 0.0153441933 0 0.0262498687 0 0.0262508687 1 0.0297751212 1 0.0297761212 0)
VD1 dac1 0 PWL(0 0 0.00186066532 0 0.00186166532 -1.75 0.0135491769 -1.75 0.0135501769 -1.75 0.0216780135 -1.75 0.0216790135 -1.75)
VD2 dac2 0 PWL(0 0 0.00186066532 0 0.00186166532 -1.75 0.0135491769 -1.75 0.0135501769 -1.75 0.0216780135 -1.75 0.0216790135 -1.75)
VD3 dac3 0 PWL(0 0 0.00186066532 0 0.00186166532 -1.75 0.0135491769 -1.75 0.0135501769 -1.75 0.0216780135 -1.75 0.0216790135 -1.75)
VD4 dac4 0 PWL(0 0 0.00186066532 0 0.00186166532 -1.75 0.0135491769 -1.75 0.0135501769 -1.75 0.0216780135 -1.75 0.0216790135 -1.75)
VTLW tlw 0 PWL(0 0 0.00186066532 0 0.00186166532 0.00186067 0.0135491769 0.00186067 0.0135501769 0.0135492 0.0216780135 0.0135492 0.0216790135 0.021678)
VFR1 fr_aux 0 PWL(0 0 0.00568652142 0 0.00568752142 1)
VFR2 fr_18 0 PWL(0 0 0.00113448925 0 0.00113548925 1)
VFR3 fr_rf 0 PWL(0 0 0.00681574826 0 0.00681674826 1)
VFR4 fr_pa 0 PWL(0 0 0.0039733459 0 0.0039743459 1 0.0179186311 1 0.0179196311 0 0.0299150456 0 0.0299160456 1)
VFR5 fr_n5 0 PWL(0 0 0.00786485638 0 0.00786585638 1)
VFR6 fr_n3 0 PWL(0 0 0.00627308107 0 0.00627408107 1)
.tran 1u 0.04 0 2u
.end
