CLIS-WPI/OpenRU/hardware/h2/sim/d_worst_FIX_pess_fail.cir

* D ordering run P030 -- BEHAVIOURAL / PRELIMINARY (free-rail mode, ADAR1000 register reset)
* rails on/off (ms): +3V3_AUX [(0.5, 16.22406212019308)]; +1V8_DIG [(2.485350004077379, 15.564969310129483)]; +3V3_RF [(0.644842351540172, 16.020733228308476)]; +5V_PA [(1.1234512542309627, 15.564969310129483)]; -5V_BF [(2.957844400788024, 15.44124601398729)]; -3V3_SW [(3.692126653915632, 15.44124601398729)]
.include h2c_plant.inc
.param cb_en=1 ilref_mode=2 sup_en=1 rf_uv=3.1 cref=10n asb=1 cb_r=0.362 cb_vth=1.1 cb_ciss=340p q2_vth=0.75 sup_vth=1.6706 sup_aux=2.968 sup_trst=9.6 sup_tdet=0.1u fetclamp=1 pess=1
.param free=1 adar_reset=1 tr_aux=0.850 tr_18=0.799 tr_rf=1.064 tr_pa=0.581 tr_n5=1.267 tr_n3=4.438
VVIN vin 0 PWL(0 12)
VE3 fw_en3v3 0 1
VE5 fw_en5vpa 0 1
VEN fw_enneg 0 1
VKL ldo5_kill 0 0
VRK rf_kill 0 0
VWD fw_wdt 0 PWL(0 1)
VPA fw_pa_en 0 PWL(0 0 0.0141841094 0 0.0141851094 1)
VD1 dac1 0 PWL(0 0 0.0139841094 0 0.0139851094 -1.75 0.0149841094 -1.75 0.0149851094 -1.1)
VD2 dac2 0 PWL(0 0 0.0139841094 0 0.0139851094 -1.75 0.0149841094 -1.75 0.0149851094 -1.1)
VD3 dac3 0 PWL(0 0 0.0139841094 0 0.0139851094 -1.75 0.0149841094 -1.75 0.0149851094 -1.1)
VD4 dac4 0 PWL(0 0 0.0139841094 0 0.0139851094 -1.75 0.0149841094 -1.75 0.0149851094 -1.1)
VTLW tlw 0 PWL(0 0 0.0139841094 0 0.0139851094 0.0139841 0.0149841094 0.0139841 0.0149851094 0.0149841)
VFR1 fr_aux 0 PWL(0 0 0.0005 0 0.000501 1 0.0162240621 1 0.0162250621 0)
VFR2 fr_18 0 PWL(0 0 0.00248535 0 0.00248635 1 0.0155649693 1 0.0155659693 0)
VFR3 fr_rf 0 PWL(0 0 0.000644842352 0 0.000645842352 1 0.0160207332 1 0.0160217332 0)
VFR4 fr_pa 0 PWL(0 0 0.00112345125 0 0.00112445125 1 0.0155649693 1 0.0155659693 0)
VFR5 fr_n5 0 PWL(0 0 0.0029578444 0 0.0029588444 1 0.015441246 1 0.015442246 0)
VFR6 fr_n3 0 PWL(0 0 0.00369212665 0 0.00369312665 1 0.015441246 1 0.015442246 0)
.tran 1u 0.0202768 0 2u
.end
