CLIS-WPI/OpenRU/hardware/h2/sim/d_worst_FIX_pess_gmax.cir

* D ordering run R037 -- BEHAVIOURAL / PRELIMINARY (free-rail mode, ADAR1000 register reset)
* rails on/off (ms): +3V3_AUX [(5.062318391731417, None)]; +1V8_DIG [(3.900923360744394, None)]; +3V3_RF [(5.521598267979987, None)]; +5V_PA [(7.547814947254272, None)]; -5V_BF [(3.9101647072142454, None)]; -3V3_SW [(7.050420131337876, None)]
.include h2c_plant.inc
.param cb_en=1 ilref_mode=2 sup_en=1 rf_uv=3.1 cref=10n asb=1 cb_r=0.362 cb_vth=1.1 cb_ciss=340p q2_vth=0.75 sup_vth=1.6706 sup_aux=2.968 sup_trst=9.6 sup_tdet=0.1u fetclamp=1 pess=1
.param free=1 adar_reset=1 tr_aux=0.260 tr_18=0.790 tr_rf=1.125 tr_pa=2.105 tr_n5=1.037 tr_n3=3.934
VVIN vin 0 PWL(0 12)
VE3 fw_en3v3 0 1
VE5 fw_en5vpa 0 1
VEN fw_enneg 0 1
VKL ldo5_kill 0 0
VRK rf_kill 0 0
VWD fw_wdt 0 PWL(0 1)
VPA fw_pa_en 0 PWL(0 0 0.00249593992 0 0.00249693992 1 0.00689647884 1 0.00689747884 0 0.0181284329 0 0.0181294329 1 0.0238757245 1 0.0238767245 0)
VD1 dac1 0 PWL(0 0 0.000591322328 0 0.000592322328 -1.1 0.0145486781 -1.1 0.0145496781 -1.1 0.0179284329 -1.1 0.0179294329 -1.75 0.0189284329 -1.75 0.0189294329 -1.1 0.0232962907 -1.1 0.0232972907 0 0.0295024632 0 0.0295034632 -1.1 0.0309633612 -1.1 0.0309643612 0)
VD2 dac2 0 PWL(0 0 0.000591322328 0 0.000592322328 -1.1 0.0145486781 -1.1 0.0145496781 -1.1 0.0179284329 -1.1 0.0179294329 -1.75 0.0189284329 -1.75 0.0189294329 -1.1 0.0232962907 -1.1 0.0232972907 0 0.0295024632 0 0.0295034632 -1.1 0.0309633612 -1.1 0.0309643612 -1.1)
VD3 dac3 0 PWL(0 0 0.000591322328 0 0.000592322328 -1.1 0.0145486781 -1.1 0.0145496781 -1.1 0.0179284329 -1.1 0.0179294329 -1.75 0.0189284329 -1.75 0.0189294329 -1.1 0.0232962907 -1.1 0.0232972907 0 0.0295024632 0 0.0295034632 -1.1 0.0309633612 -1.1 0.0309643612 -1.1)
VD4 dac4 0 PWL(0 0 0.000591322328 0 0.000592322328 -1.1 0.0145486781 -1.1 0.0145496781 -1.1 0.0179284329 -1.1 0.0179294329 -1.75 0.0189284329 -1.75 0.0189294329 -1.1 0.0232962907 -1.1 0.0232972907 0 0.0295024632 0 0.0295034632 -1.1 0.0309633612 -1.1 0.0309643612 -1.1)
VTLW tlw 0 PWL(0 0 0.000591322328 0 0.000592322328 0.000591322 0.0145486781 0.000591322 0.0145496781 0.0145487 0.0179284329 0.0145487 0.0179294329 0.0179284 0.0189284329 0.0179284 0.0189294329 0.0189284 0.0232962907 0.0189284 0.0232972907 0.0232963 0.0295024632 0.0232963 0.0295034632 0.0295025 0.0309633612 0.0295025 0.0309643612 0.0309634)
VFR1 fr_aux 0 PWL(0 0 0.00506231839 0 0.00506331839 1)
VFR2 fr_18 0 PWL(0 0 0.00390092336 0 0.00390192336 1)
VFR3 fr_rf 0 PWL(0 0 0.00552159827 0 0.00552259827 1)
VFR4 fr_pa 0 PWL(0 0 0.00754781495 0 0.00754881495 1)
VFR5 fr_n5 0 PWL(0 0 0.00391016471 0 0.00391116471 1)
VFR6 fr_n3 0 PWL(0 0 0.00705042013 0 0.00705142013 1)
.tran 1u 0.04 0 2u
.end
