CLIS-WPI/OpenRU/hardware/h2/sim/d_worst_FIX_pess_gmin.cir

* D ordering run P545 -- BEHAVIOURAL / PRELIMINARY (free-rail mode, ADAR1000 register reset)
* rails on/off (ms): +3V3_AUX [(2.0699912194873753, 15.300132432238492)]; +1V8_DIG [(1.964876495262141, 14.826245488345972)]; +3V3_RF [(0.9188259197426818, 16.02087530363306)]; +5V_PA [(1.1491167671524583, 16.887278911606867)]; -5V_BF [(0.5, 14.826245488345972)]; -3V3_SW [(1.1491167671524583, 16.776930131000483)]
.include h2c_plant.inc
.param cb_en=1 ilref_mode=2 sup_en=1 rf_uv=3.1 cref=10n asb=1 cb_r=0.362 cb_vth=1.1 cb_ciss=340p q2_vth=0.75 sup_vth=1.6706 sup_aux=2.968 sup_trst=9.6 sup_tdet=0.1u fetclamp=1 pess=1
.param free=1 adar_reset=1 tr_aux=1.844 tr_18=0.661 tr_rf=2.133 tr_pa=1.722 tr_n5=4.315 tr_n3=2.238
VVIN vin 0 PWL(0 12)
VE3 fw_en3v3 0 1
VE5 fw_en5vpa 0 1
VEN fw_enneg 0 1
VKL ldo5_kill 0 0
VRK rf_kill 0 0
VWD fw_wdt 0 PWL(0 1)
VPA fw_pa_en 0 PWL(0 0 0.0135263032 0 0.0135273032 1)
VD1 dac1 0 PWL(0 0 0.0133263032 0 0.0133273032 -1.75 0.0143263032 -1.75 0.0143273032 -1.1)
VD2 dac2 0 PWL(0 0 0.0133263032 0 0.0133273032 -1.75 0.0143263032 -1.75 0.0143273032 -1.1)
VD3 dac3 0 PWL(0 0 0.0133263032 0 0.0133273032 -1.75 0.0143263032 -1.75 0.0143273032 -1.1)
VD4 dac4 0 PWL(0 0 0.0133263032 0 0.0133273032 -1.75 0.0143263032 -1.75 0.0143273032 -1.1)
VTLW tlw 0 PWL(0 0 0.0133263032 0 0.0133273032 0.0133263 0.0143263032 0.0133263 0.0143273032 0.0143263)
VFR1 fr_aux 0 PWL(0 0 0.00206999122 0 0.00207099122 1 0.0153001324 1 0.0153011324 0)
VFR2 fr_18 0 PWL(0 0 0.0019648765 0 0.0019658765 1 0.0148262455 1 0.0148272455 0)
VFR3 fr_rf 0 PWL(0 0 0.00091882592 0 0.00091982592 1 0.0160208753 1 0.0160218753 0)
VFR4 fr_pa 0 PWL(0 0 0.00114911677 0 0.00115011677 1 0.0168872789 1 0.0168882789 0)
VFR5 fr_n5 0 PWL(0 0 0.0005 0 0.000501 1 0.0148262455 1 0.0148272455 0)
VFR6 fr_n3 0 PWL(0 0 0.00114911677 0 0.00115011677 1 0.0167769301 1 0.0167779301 0)
.tran 1u 0.0208873 0 2u
.end
