CLIS-WPI/OpenRU/hardware/h2/sim/d_worst_ASB_nom_gmax.cir

* D ordering run R012 -- BEHAVIOURAL / PRELIMINARY (free-rail mode, ADAR1000 register reset)
* rails on/off (ms): +3V3_AUX [(6.637950232117625, None)]; +1V8_DIG [(7.591865818754842, None)]; +3V3_RF [(4.551221247799165, None)]; +5V_PA [(6.464574644255221, None)]; -5V_BF [(0.3474159140268537, None)]; -3V3_SW [(6.440456031696321, 23.35992103072318), (31.329368209047797, None)]
.include h2c_plant.inc
.param cb_en=1 ilref_mode=2 sup_en=1 rf_uv=3.1 cref=10n asb=1 cb_r=0.362 cb_vth=1.1 cb_ciss=340p q2_vth=0.75 sup_vth=1.6706 sup_aux=2.968 sup_trst=9.6 sup_tdet=0.1u
.param free=1 adar_reset=1 tr_aux=1.648 tr_18=0.651 tr_rf=1.516 tr_pa=2.529 tr_n5=1.129 tr_n3=2.693
VVIN vin 0 PWL(0 12)
VE3 fw_en3v3 0 1
VE5 fw_en5vpa 0 1
VEN fw_enneg 0 1
VKL ldo5_kill 0 0
VRK rf_kill 0 0
VWD fw_wdt 0 PWL(0 1)
VPA fw_pa_en 0 PWL(0 0 0.00287958138 0 0.00288058138 1 0.00746946108 1 0.00747046108 0 0.0128019845 0 0.0128029845 1 0.0152136399 1 0.0152146399 0 0.0223197611 0 0.0223207611 1 0.023999916 1 0.024000916 0 0.0284919614 0 0.0284929614 1 0.0325674266 1 0.0325684266 0)
VD1 dac1 0 PWL(0 0 0.000688843817 0 0.000689843817 -1.75 0.0193483344 -1.75 0.0193493344 0 0.0282919614 0 0.0282929614 -1.75 0.0292919614 -1.75 0.0292929614 -1.1 0.0343450594 -1.1 0.0343460594 -1.75)
VD2 dac2 0 PWL(0 0 0.000688843817 0 0.000689843817 -1.75 0.0193483344 -1.75 0.0193493344 0 0.0282919614 0 0.0282929614 -1.75 0.0292919614 -1.75 0.0292929614 -1.1 0.0343450594 -1.1 0.0343460594 -1.75)
VD3 dac3 0 PWL(0 0 0.000688843817 0 0.000689843817 -1.75 0.0193483344 -1.75 0.0193493344 0 0.0282919614 0 0.0282929614 -1.75 0.0292919614 -1.75 0.0292929614 -1.1 0.0343450594 -1.1 0.0343460594 -1.75)
VD4 dac4 0 PWL(0 0 0.000688843817 0 0.000689843817 -1.75 0.0193483344 -1.75 0.0193493344 0 0.0282919614 0 0.0282929614 -1.75 0.0292919614 -1.75 0.0292929614 -1.1 0.0343450594 -1.1 0.0343460594 -1.75)
VTLW tlw 0 PWL(0 0 0.000688843817 0 0.000689843817 0.000688844 0.0193483344 0.000688844 0.0193493344 0.0193483 0.0282919614 0.0193483 0.0282929614 0.028292 0.0292919614 0.028292 0.0292929614 0.029292 0.0343450594 0.029292 0.0343460594 0.0343451)
VFR1 fr_aux 0 PWL(0 0 0.00663795023 0 0.00663895023 1)
VFR2 fr_18 0 PWL(0 0 0.00759186582 0 0.00759286582 1)
VFR3 fr_rf 0 PWL(0 0 0.00455122125 0 0.00455222125 1)
VFR4 fr_pa 0 PWL(0 0 0.00646457464 0 0.00646557464 1)
VFR5 fr_n5 0 PWL(0 0 0.000347415914 0 0.000348415914 1)
VFR6 fr_n3 0 PWL(0 0 0.00644045603 0 0.00644145603 1 0.023359921 1 0.023360921 0 0.0313293682 0 0.0313303682 1)
.tran 1u 0.04 0 2u
.end
