CLIS-WPI/OpenRU/hardware/h2/sim/d_worst_ASB_ovl_pess_fail.cir

* D ordering run P000 -- BEHAVIOURAL / PRELIMINARY (free-rail mode, ADAR1000 register reset)
* rails on/off (ms): +3V3_AUX [(0.5, 15.142272688550307)]; +1V8_DIG [(1.226820154391262, 16.741564282290966)]; +3V3_RF [(2.396772948107344, 17.306084150612826)]; +5V_PA [(3.0150480749974817, 15.850224254163566)]; -5V_BF [(4.275809730626383, 14.518382468658602)]; -3V3_SW [(4.763567180452671, 15.142272688550307)]
.include h2c_plant.inc
.param cb_en=1 ilref_mode=2 sup_en=1 rf_uv=3.1 cref=10n asb=1 cb_r=0.362 cb_vth=0.9 cb_ciss=340p q2_vth=1.0 sup_vth=1.6706 sup_aux=2.968 sup_trst=9.6 sup_tdet=0.1u tsw_off=4.95u pess=1
.param free=1 adar_reset=1 tr_aux=0.780 tr_18=0.983 tr_rf=0.430 tr_pa=0.566 tr_n5=1.161 tr_n3=4.137
VVIN vin 0 PWL(0 12)
VE3 fw_en3v3 0 1
VE5 fw_en5vpa 0 1
VEN fw_enneg 0 1
VKL ldo5_kill 0 0
VRK rf_kill 0 0
VWD fw_wdt 0 PWL(0 1)
VPA fw_pa_en 0 PWL(0 0 0.0131099376 0 0.0131109376 1)
VD1 dac1 0 PWL(0 0 0.0129099376 0 0.0129109376 -1.75 0.0139099376 -1.75 0.0139109376 -1.1)
VD2 dac2 0 PWL(0 0 0.0129099376 0 0.0129109376 -1.75 0.0139099376 -1.75 0.0139109376 -1.1)
VD3 dac3 0 PWL(0 0 0.0129099376 0 0.0129109376 -1.75 0.0139099376 -1.75 0.0139109376 -1.1)
VD4 dac4 0 PWL(0 0 0.0129099376 0 0.0129109376 -1.75 0.0139099376 -1.75 0.0139109376 -1.1)
VTLW tlw 0 PWL(0 0 0.0129099376 0 0.0129109376 0.0129099 0.0139099376 0.0129099 0.0139109376 0.0139099)
VFR1 fr_aux 0 PWL(0 0 0.0005 0 0.000501 1 0.0151422727 1 0.0151432727 0)
VFR2 fr_18 0 PWL(0 0 0.00122682015 0 0.00122782015 1 0.0167415643 1 0.0167425643 0)
VFR3 fr_rf 0 PWL(0 0 0.00239677295 0 0.00239777295 1 0.0173060842 1 0.0173070842 0)
VFR4 fr_pa 0 PWL(0 0 0.00301504807 0 0.00301604807 1 0.0158502243 1 0.0158512243 0)
VFR5 fr_n5 0 PWL(0 0 0.00427580973 0 0.00427680973 1 0.0145183825 1 0.0145193825 0)
VFR6 fr_n3 0 PWL(0 0 0.00476356718 0 0.00476456718 1 0.0151422727 1 0.0151432727 0)
.tran 1u 0.0215458 0 2u
.end
