CLIS-WPI/OpenRU/hardware/h2/sim/d_worst_ASB_ovl_pess_gmin.cir

* D ordering run R008 -- BEHAVIOURAL / PRELIMINARY (free-rail mode, ADAR1000 register reset)
* rails on/off (ms): +3V3_AUX [(2.088711296240429, None)]; +1V8_DIG [(4.299533860801737, 27.256612433272956)]; +3V3_RF [(5.142313683916855, None)]; +5V_PA [(5.70888814877267, None)]; -5V_BF [(1.827364061385034, 19.344132047901834), (23.520604178895205, None)]; -3V3_SW [(0.2333055983931975, None)]
.include h2c_plant.inc
.param cb_en=1 ilref_mode=2 sup_en=1 rf_uv=3.1 cref=10n asb=1 cb_r=0.362 cb_vth=0.9 cb_ciss=340p q2_vth=1.0 sup_vth=1.6706 sup_aux=2.968 sup_trst=9.6 sup_tdet=0.1u tsw_off=4.95u pess=1
.param free=1 adar_reset=1 tr_aux=0.719 tr_18=0.456 tr_rf=1.881 tr_pa=1.769 tr_n5=2.229 tr_n3=4.321
VVIN vin 0 PWL(0 12)
VE3 fw_en3v3 0 1
VE5 fw_en5vpa 0 1
VEN fw_enneg 0 1
VKL ldo5_kill 0 0
VRK rf_kill 0 0
VWD fw_wdt 0 PWL(0 1)
VPA fw_pa_en 0 PWL(0 0 0.00759150991 0 0.00759250991 1 0.00992506429 1 0.00992606429 0 0.0236135382 0 0.0236145382 1 0.027038329 1 0.027039329 0)
VD1 dac1 0 PWL(0 0 0.00739150991 0 0.00739250991 -1.75 0.00839150991 -1.75 0.00839250991 -1.1 0.0298301766 -1.1 0.0298311766 -1.75)
VD2 dac2 0 PWL(0 0 0.00739150991 0 0.00739250991 -1.75 0.00839150991 -1.75 0.00839250991 -1.1 0.0298301766 -1.1 0.0298311766 -1.75)
VD3 dac3 0 PWL(0 0 0.00739150991 0 0.00739250991 -1.75 0.00839150991 -1.75 0.00839250991 -1.1 0.0298301766 -1.1 0.0298311766 -1.75)
VD4 dac4 0 PWL(0 0 0.00739150991 0 0.00739250991 -1.75 0.00839150991 -1.75 0.00839250991 -1.1 0.0298301766 -1.1 0.0298311766 -1.75)
VTLW tlw 0 PWL(0 0 0.00739150991 0 0.00739250991 0.00739151 0.00839150991 0.00739151 0.00839250991 0.00839151 0.0298301766 0.00839151 0.0298311766 0.0298302)
VFR1 fr_aux 0 PWL(0 0 0.0020887113 0 0.0020897113 1)
VFR2 fr_18 0 PWL(0 0 0.00429953386 0 0.00430053386 1 0.0272566124 1 0.0272576124 0)
VFR3 fr_rf 0 PWL(0 0 0.00514231368 0 0.00514331368 1)
VFR4 fr_pa 0 PWL(0 0 0.00570888815 0 0.00570988815 1)
VFR5 fr_n5 0 PWL(0 0 0.00182736406 0 0.00182836406 1 0.019344132 1 0.019345132 0 0.0235206042 0 0.0235216042 1)
VFR6 fr_n3 0 PWL(0 0 0.000233305598 0 0.000234305598 1)
.tran 1u 0.04 0 2u
.end
