CLIS-WPI/OpenRU/hardware/h2/sim/d_worst_ASB_ovl_pess_t05.cir

* D ordering run P492 -- BEHAVIOURAL / PRELIMINARY (free-rail mode, ADAR1000 register reset)
* rails on/off (ms): +3V3_AUX [(0.5, 16.076416639030114)]; +1V8_DIG [(2.248455586935278, 14.813203208675565)]; +3V3_RF [(2.248455586935278, 16.076416639030114)]; +5V_PA [(1.8580813857671257, 14.619403420265414)]; -5V_BF [(0.5, 15.53249093690907)]; -3V3_SW [(2.248455586935278, 14.506279200831019)]
.include h2c_plant.inc
.param cb_en=1 ilref_mode=2 sup_en=1 rf_uv=3.1 cref=10n asb=1 cb_r=0.362 cb_vth=0.9 cb_ciss=340p q2_vth=1.0 sup_vth=1.6706 sup_aux=2.968 sup_trst=9.6 sup_tdet=0.1u tsw_off=4.95u pess=1
.param free=1 adar_reset=1 tr_aux=0.969 tr_18=0.133 tr_rf=0.789 tr_pa=0.396 tr_n5=0.634 tr_n3=0.553
VVIN vin 0 PWL(0 12)
VE3 fw_en3v3 0 1
VE5 fw_en5vpa 0 1
VEN fw_enneg 0 1
VKL ldo5_kill 0 0
VRK rf_kill 0 0
VWD fw_wdt 0 PWL(0 1)
VPA fw_pa_en 0 PWL(0 0 0.0132816374 0 0.0132826374 1)
VD1 dac1 0 PWL(0 0 0.0130816374 0 0.0130826374 -1.75 0.0140816374 -1.75 0.0140826374 -1.1)
VD2 dac2 0 PWL(0 0 0.0130816374 0 0.0130826374 -1.75 0.0140816374 -1.75 0.0140826374 -1.1)
VD3 dac3 0 PWL(0 0 0.0130816374 0 0.0130826374 -1.75 0.0140816374 -1.75 0.0140826374 -1.1)
VD4 dac4 0 PWL(0 0 0.0130816374 0 0.0130826374 -1.75 0.0140816374 -1.75 0.0140826374 -1.1)
VTLW tlw 0 PWL(0 0 0.0130816374 0 0.0130826374 0.0130816 0.0140816374 0.0130816 0.0140826374 0.0140816)
VFR1 fr_aux 0 PWL(0 0 0.0005 0 0.000501 1 0.0160764166 1 0.0160774166 0)
VFR2 fr_18 0 PWL(0 0 0.00224845559 0 0.00224945559 1 0.0148132032 1 0.0148142032 0)
VFR3 fr_rf 0 PWL(0 0 0.00224845559 0 0.00224945559 1 0.0160764166 1 0.0160774166 0)
VFR4 fr_pa 0 PWL(0 0 0.00185808139 0 0.00185908139 1 0.0146194034 1 0.0146204034 0)
VFR5 fr_n5 0 PWL(0 0 0.0005 0 0.000501 1 0.0155324909 1 0.0155334909 0)
VFR6 fr_n3 0 PWL(0 0 0.00224845559 0 0.00224945559 1 0.0145062792 1 0.0145072792 0)
.tran 1u 0.0210094 0 2u
.end
