CLIS-WPI/OpenRU/hardware/h2/sim/d_worst_ASB_pess_t05.cir

* D ordering run P497 -- BEHAVIOURAL / PRELIMINARY (free-rail mode, ADAR1000 register reset)
* rails on/off (ms): +3V3_AUX [(0.5, 16.20275104110963)]; +1V8_DIG [(2.1631442033725725, 15.13441907708451)]; +3V3_RF [(2.0664812369195316, 17.164286673716337)]; +5V_PA [(1.065368714973614, 16.20275104110963)]; -5V_BF [(0.5, 18.126175703854695)]; -3V3_SW [(1.6628211545402511, 15.219395465456488)]
.include h2c_plant.inc
.param cb_en=1 ilref_mode=2 sup_en=1 rf_uv=3.1 cref=10n asb=1 cb_r=0.362 cb_vth=1.1 cb_ciss=340p q2_vth=0.75 sup_vth=1.6706 sup_aux=2.968 sup_trst=9.6 sup_tdet=0.1u pess=1
.param free=1 adar_reset=1 tr_aux=0.488 tr_18=0.723 tr_rf=1.133 tr_pa=2.536 tr_n5=3.456 tr_n3=1.029
VVIN vin 0 PWL(0 12)
VE3 fw_en3v3 0 1
VE5 fw_en5vpa 0 1
VEN fw_enneg 0 1
VKL ldo5_kill 0 0
VRK rf_kill 0 0
VWD fw_wdt 0 PWL(0 1)
VPA fw_pa_en 0 PWL(0 0 0.0137862458 0 0.0137872458 1)
VD1 dac1 0 PWL(0 0 0.0135862458 0 0.0135872458 -1.75 0.0145862458 -1.75 0.0145872458 -1.1)
VD2 dac2 0 PWL(0 0 0.0135862458 0 0.0135872458 -1.75 0.0145862458 -1.75 0.0145872458 -1.1)
VD3 dac3 0 PWL(0 0 0.0135862458 0 0.0135872458 -1.75 0.0145862458 -1.75 0.0145872458 -1.1)
VD4 dac4 0 PWL(0 0 0.0135862458 0 0.0135872458 -1.75 0.0145862458 -1.75 0.0145872458 -1.1)
VTLW tlw 0 PWL(0 0 0.0135862458 0 0.0135872458 0.0135862 0.0145862458 0.0135862 0.0145872458 0.0145862)
VFR1 fr_aux 0 PWL(0 0 0.0005 0 0.000501 1 0.016202751 1 0.016203751 0)
VFR2 fr_18 0 PWL(0 0 0.0021631442 0 0.0021641442 1 0.0151344191 1 0.0151354191 0)
VFR3 fr_rf 0 PWL(0 0 0.00206648124 0 0.00206748124 1 0.0171642867 1 0.0171652867 0)
VFR4 fr_pa 0 PWL(0 0 0.00106536871 0 0.00106636871 1 0.016202751 1 0.016203751 0)
VFR5 fr_n5 0 PWL(0 0 0.0005 0 0.000501 1 0.0181261757 1 0.0181271757 0)
VFR6 fr_n3 0 PWL(0 0 0.00166282115 0 0.00166382115 1 0.0152193955 1 0.0152203955 0)
.tran 1u 0.0226575 0 2u
.end
