CLIS-WPI/OpenRU/hardware/h2/sim/d_worst_ASB_slow_pess_gmax.cir

* D ordering run R174 -- BEHAVIOURAL / PRELIMINARY (free-rail mode, ADAR1000 register reset)
* rails on/off (ms): +3V3_AUX [(0.2749884229618843, None)]; +1V8_DIG [(1.5166265220646251, None)]; +3V3_RF [(4.580165721097937, None)]; +5V_PA [(7.964969357893399, None)]; -5V_BF [(1.5649858879986271, None)]; -3V3_SW [(6.8202298686612695, None)]
.include h2c_plant.inc
.param cb_en=1 ilref_mode=2 sup_en=1 rf_uv=3.1 cref=10n asb=1 cb_r=0.362 cb_vth=1.55 cb_ciss=340p q2_vth=0.5 sup_vth=1.6706 sup_aux=2.968 sup_trst=9.6 sup_tdet=100u pess=1
.param free=1 adar_reset=1 tr_aux=1.551 tr_18=0.343 tr_rf=2.798 tr_pa=1.440 tr_n5=2.840 tr_n3=2.367
VVIN vin 0 PWL(0 12)
VE3 fw_en3v3 0 1
VE5 fw_en5vpa 0 1
VEN fw_enneg 0 1
VKL ldo5_kill 0 0
VRK rf_kill 0 0
VWD fw_wdt 0 PWL(0 1)
VPA fw_pa_en 0 PWL(0 0 0.0244309675 0 0.0244319675 1 0.0250158983 1 0.0250168983 0)
VD1 dac1 0 PWL(0 0 0.00689121557 0 0.00689221557 -1.75 0.0120862478 -1.75 0.0120872478 -1.1 0.0178680152 -1.1 0.0178690152 0 0.0226471106 0 0.0226481106 -1.75 0.031186089 -1.75 0.031187089 -1.75)
VD2 dac2 0 PWL(0 0 0.00689121557 0 0.00689221557 -1.75 0.0120862478 -1.75 0.0120872478 -1.1 0.0178680152 -1.1 0.0178690152 -1.1 0.0226471106 -1.1 0.0226481106 -1.75 0.031186089 -1.75 0.031187089 -1.75)
VD3 dac3 0 PWL(0 0 0.00689121557 0 0.00689221557 -1.75 0.0120862478 -1.75 0.0120872478 -1.1 0.0178680152 -1.1 0.0178690152 -1.1 0.0226471106 -1.1 0.0226481106 -1.75 0.031186089 -1.75 0.031187089 -1.75)
VD4 dac4 0 PWL(0 0 0.00689121557 0 0.00689221557 -1.75 0.0120862478 -1.75 0.0120872478 -1.1 0.0178680152 -1.1 0.0178690152 -1.1 0.0226471106 -1.1 0.0226481106 -1.75 0.031186089 -1.75 0.031187089 -1.75)
VTLW tlw 0 PWL(0 0 0.00689121557 0 0.00689221557 0.00689122 0.0120862478 0.00689122 0.0120872478 0.0120862 0.0178680152 0.0120862 0.0178690152 0.017868 0.0226471106 0.017868 0.0226481106 0.0226471 0.031186089 0.0226471 0.031187089 0.0311861)
VFR1 fr_aux 0 PWL(0 0 0.000274988423 0 0.000275988423 1)
VFR2 fr_18 0 PWL(0 0 0.00151662652 0 0.00151762652 1)
VFR3 fr_rf 0 PWL(0 0 0.00458016572 0 0.00458116572 1)
VFR4 fr_pa 0 PWL(0 0 0.00796496936 0 0.00796596936 1)
VFR5 fr_n5 0 PWL(0 0 0.00156498589 0 0.00156598589 1)
VFR6 fr_n3 0 PWL(0 0 0.00682022987 0 0.00682122987 1)
.tran 1u 0.04 0 2u
.end
