CLIS-WPI/OpenRU/hardware/h2/sim/d_worst_ASB_slow_pess_gmin.cir

* D ordering run R129 -- BEHAVIOURAL / PRELIMINARY (free-rail mode, ADAR1000 register reset)
* rails on/off (ms): +3V3_AUX [(4.7915135885641975, None)]; +1V8_DIG [(6.75555320250213, 9.237230656802792)]; +3V3_RF [(3.590824463765662, 20.741534721969174), (30.40739953773171, None)]; +5V_PA [(5.678306286001758, 28.07212794196981)]; -5V_BF [(4.366529309602655, None)]; -3V3_SW [(2.861302920107033, None)]
.include h2c_plant.inc
.param cb_en=1 ilref_mode=2 sup_en=1 rf_uv=3.1 cref=10n asb=1 cb_r=0.362 cb_vth=1.55 cb_ciss=340p q2_vth=0.5 sup_vth=1.6706 sup_aux=2.968 sup_trst=9.6 sup_tdet=100u pess=1
.param free=1 adar_reset=1 tr_aux=1.419 tr_18=0.855 tr_rf=2.979 tr_pa=0.567 tr_n5=1.111 tr_n3=4.504
VVIN vin 0 PWL(0 12)
VE3 fw_en3v3 0 1
VE5 fw_en5vpa 0 1
VEN fw_enneg 0 1
VKL ldo5_kill 0 0
VRK rf_kill 0 0
VWD fw_wdt 0 PWL(0 1)
VPA fw_pa_en 0 PWL(0 0 0.00598226378 0 0.00598326378 1 0.0100893244 1 0.0100903244 0 0.0125902478 0 0.0125912478 1 0.0168333584 1 0.0168343584 0)
VD1 dac1 0 PWL(0 0 0.00966338141 0 0.00966438141 0 0.0123902478 0 0.0123912478 -1.75 0.0126933314 -1.75 0.0126943314 0 0.0133902478 0 0.0133912478 -1.1)
VD2 dac2 0 PWL(0 0 0.00966338141 0 0.00966438141 -1.1 0.0123902478 -1.1 0.0123912478 -1.75 0.0126933314 -1.75 0.0126943314 0 0.0133902478 0 0.0133912478 -1.1)
VD3 dac3 0 PWL(0 0 0.00966338141 0 0.00966438141 -1.1 0.0123902478 -1.1 0.0123912478 -1.75 0.0126933314 -1.75 0.0126943314 0 0.0133902478 0 0.0133912478 -1.1)
VD4 dac4 0 PWL(0 0 0.00966338141 0 0.00966438141 -1.1 0.0123902478 -1.1 0.0123912478 -1.75 0.0126933314 -1.75 0.0126943314 0 0.0133902478 0 0.0133912478 -1.1)
VTLW tlw 0 PWL(0 0 0.00966338141 0 0.00966438141 0.00966338 0.0123902478 0.00966338 0.0123912478 0.0123902 0.0126933314 0.0123902 0.0126943314 0.0126933 0.0133902478 0.0126933 0.0133912478 0.0133902)
VFR1 fr_aux 0 PWL(0 0 0.00479151359 0 0.00479251359 1)
VFR2 fr_18 0 PWL(0 0 0.0067555532 0 0.0067565532 1 0.00923723066 1 0.00923823066 0)
VFR3 fr_rf 0 PWL(0 0 0.00359082446 0 0.00359182446 1 0.0207415347 1 0.0207425347 0 0.0304073995 0 0.0304083995 1)
VFR4 fr_pa 0 PWL(0 0 0.00567830629 0 0.00567930629 1 0.0280721279 1 0.0280731279 0)
VFR5 fr_n5 0 PWL(0 0 0.00436652931 0 0.00436752931 1)
VFR6 fr_n3 0 PWL(0 0 0.00286130292 0 0.00286230292 1)
.tran 1u 0.04 0 2u
.end
