CLIS-WPI/OpenRU/hardware/h2/sim/d_worst_ASB_slow_pess_t05.cir

* D ordering run P082 -- BEHAVIOURAL / PRELIMINARY (free-rail mode, ADAR1000 register reset)
* rails on/off (ms): +3V3_AUX [(0.5, 18.007744390320276)]; +1V8_DIG [(3.6290115689017712, 16.448099521682323)]; +3V3_RF [(1.4151546969080675, 16.975185355388522)]; +5V_PA [(4.8864211677449045, 16.574581534584055)]; -5V_BF [(1.0567612986505006, 17.571166272941728)]; -3V3_SW [(2.403448266496619, 15.99734337699746)]
.include h2c_plant.inc
.param cb_en=1 ilref_mode=2 sup_en=1 rf_uv=3.1 cref=10n asb=1 cb_r=0.362 cb_vth=1.55 cb_ciss=340p q2_vth=0.5 sup_vth=1.6706 sup_aux=2.968 sup_trst=9.6 sup_tdet=100u pess=1
.param free=1 adar_reset=1 tr_aux=1.263 tr_18=0.247 tr_rf=2.025 tr_pa=0.767 tr_n5=3.978 tr_n3=1.024
VVIN vin 0 PWL(0 12)
VE3 fw_en3v3 0 1
VE5 fw_en5vpa 0 1
VEN fw_enneg 0 1
VKL ldo5_kill 0 0
VRK rf_kill 0 0
VWD fw_wdt 0 PWL(0 1)
VPA fw_pa_en 0 PWL(0 0 0.0147763346 0 0.0147773346 1)
VD1 dac1 0 PWL(0 0 0.0145763346 0 0.0145773346 -1.75 0.0155763346 -1.75 0.0155773346 -1.1)
VD2 dac2 0 PWL(0 0 0.0145763346 0 0.0145773346 -1.75 0.0155763346 -1.75 0.0155773346 -1.1)
VD3 dac3 0 PWL(0 0 0.0145763346 0 0.0145773346 -1.75 0.0155763346 -1.75 0.0155773346 -1.1)
VD4 dac4 0 PWL(0 0 0.0145763346 0 0.0145773346 -1.75 0.0155763346 -1.75 0.0155773346 -1.1)
VTLW tlw 0 PWL(0 0 0.0145763346 0 0.0145773346 0.0145763 0.0155763346 0.0145763 0.0155773346 0.0155763)
VFR1 fr_aux 0 PWL(0 0 0.0005 0 0.000501 1 0.0180077444 1 0.0180087444 0)
VFR2 fr_18 0 PWL(0 0 0.00362901157 0 0.00363001157 1 0.0164480995 1 0.0164490995 0)
VFR3 fr_rf 0 PWL(0 0 0.0014151547 0 0.0014161547 1 0.0169751854 1 0.0169761854 0)
VFR4 fr_pa 0 PWL(0 0 0.00488642117 0 0.00488742117 1 0.0165745815 1 0.0165755815 0)
VFR5 fr_n5 0 PWL(0 0 0.0010567613 0 0.0010577613 1 0.0175711663 1 0.0175721663 0)
VFR6 fr_n3 0 PWL(0 0 0.00240344827 0 0.00240444827 1 0.0159973434 1 0.0159983434 0)
.tran 1u 0.0227843 0 2u
.end
