CLIS-WPI/OpenRU/hardware/h2/sim/d_worst_ASB_td100_pess_gmin.cir

* D ordering run P569 -- BEHAVIOURAL / PRELIMINARY (free-rail mode, ADAR1000 register reset)
* rails on/off (ms): +3V3_AUX [(2.496248574222294, 15.634249199189737)]; +1V8_DIG [(2.3722019550048445, 16.21094711262543)]; +3V3_RF [(0.5, 15.180331913682908)]; +5V_PA [(0.5, 16.21094711262543)]; -5V_BF [(0.5, 17.078660146348554)]; -3V3_SW [(1.751647635738904, 17.880466241366193)]
.include h2c_plant.inc
.param cb_en=1 ilref_mode=2 sup_en=1 rf_uv=3.1 cref=10n asb=1 cb_r=0.362 cb_vth=1.1 cb_ciss=340p q2_vth=0.75 sup_vth=1.6706 sup_aux=2.968 sup_trst=9.6 sup_tdet=100u pess=1
.param free=1 adar_reset=1 tr_aux=1.640 tr_18=0.697 tr_rf=2.016 tr_pa=2.614 tr_n5=4.954 tr_n3=4.183
VVIN vin 0 PWL(0 12)
VE3 fw_en3v3 0 1
VE5 fw_en5vpa 0 1
VEN fw_enneg 0 1
VKL ldo5_kill 0 0
VRK rf_kill 0 0
VWD fw_wdt 0 PWL(0 1)
VPA fw_pa_en 0 PWL(0 0 0.0139690803 0 0.0139700803 1)
VD1 dac1 0 PWL(0 0 0.0137690803 0 0.0137700803 -1.75 0.0147690803 -1.75 0.0147700803 -1.1)
VD2 dac2 0 PWL(0 0 0.0137690803 0 0.0137700803 -1.75 0.0147690803 -1.75 0.0147700803 -1.1)
VD3 dac3 0 PWL(0 0 0.0137690803 0 0.0137700803 -1.75 0.0147690803 -1.75 0.0147700803 -1.1)
VD4 dac4 0 PWL(0 0 0.0137690803 0 0.0137700803 -1.75 0.0147690803 -1.75 0.0147700803 -1.1)
VTLW tlw 0 PWL(0 0 0.0137690803 0 0.0137700803 0.0137691 0.0147690803 0.0137691 0.0147700803 0.0147691)
VFR1 fr_aux 0 PWL(0 0 0.00249624857 0 0.00249724857 1 0.0156342492 1 0.0156352492 0)
VFR2 fr_18 0 PWL(0 0 0.00237220196 0 0.00237320196 1 0.0162109471 1 0.0162119471 0)
VFR3 fr_rf 0 PWL(0 0 0.0005 0 0.000501 1 0.0151803319 1 0.0151813319 0)
VFR4 fr_pa 0 PWL(0 0 0.0005 0 0.000501 1 0.0162109471 1 0.0162119471 0)
VFR5 fr_n5 0 PWL(0 0 0.0005 0 0.000501 1 0.0170786601 1 0.0170796601 0)
VFR6 fr_n3 0 PWL(0 0 0.00175164764 0 0.00175264764 1 0.0178804662 1 0.0178814662 0)
.tran 1u 0.0218805 0 2u
.end
