CLIS-WPI/OpenRU/hardware/h2/sim/d_worst_ASB_td100_pess_t05.cir

* D ordering run P018 -- BEHAVIOURAL / PRELIMINARY (free-rail mode, ADAR1000 register reset)
* rails on/off (ms): +3V3_AUX [(0.5, 15.709409477971436)]; +1V8_DIG [(1.4052164586374496, 14.23916136578356)]; +3V3_RF [(3.3228233837083705, 15.135371681553934)]; +5V_PA [(3.3228233837083705, 15.709409477971436)]; -5V_BF [(3.3228233837083705, 14.23916136578356)]; -3V3_SW [(2.1652881455250705, 13.778449804964916)]
.include h2c_plant.inc
.param cb_en=1 ilref_mode=2 sup_en=1 rf_uv=3.1 cref=10n asb=1 cb_r=0.362 cb_vth=1.1 cb_ciss=340p q2_vth=0.75 sup_vth=1.6706 sup_aux=2.968 sup_trst=9.6 sup_tdet=100u pess=1
.param free=1 adar_reset=1 tr_aux=0.896 tr_18=0.176 tr_rf=1.016 tr_pa=1.901 tr_n5=2.870 tr_n3=2.262
VVIN vin 0 PWL(0 12)
VE3 fw_en3v3 0 1
VE5 fw_en5vpa 0 1
VEN fw_enneg 0 1
VKL ldo5_kill 0 0
VRK rf_kill 0 0
VWD fw_wdt 0 PWL(0 1)
VPA fw_pa_en 0 PWL(0 0 0.0124809615 0 0.0124819615 1)
VD1 dac1 0 PWL(0 0 0.0122809615 0 0.0122819615 -1.75 0.0132809615 -1.75 0.0132819615 -1.1)
VD2 dac2 0 PWL(0 0 0.0122809615 0 0.0122819615 -1.75 0.0132809615 -1.75 0.0132819615 -1.1)
VD3 dac3 0 PWL(0 0 0.0122809615 0 0.0122819615 -1.75 0.0132809615 -1.75 0.0132819615 -1.1)
VD4 dac4 0 PWL(0 0 0.0122809615 0 0.0122819615 -1.75 0.0132809615 -1.75 0.0132819615 -1.1)
VTLW tlw 0 PWL(0 0 0.0122809615 0 0.0122819615 0.012281 0.0132809615 0.012281 0.0132819615 0.013281)
VFR1 fr_aux 0 PWL(0 0 0.0005 0 0.000501 1 0.0157094095 1 0.0157104095 0)
VFR2 fr_18 0 PWL(0 0 0.00140521646 0 0.00140621646 1 0.0142391614 1 0.0142401614 0)
VFR3 fr_rf 0 PWL(0 0 0.00332282338 0 0.00332382338 1 0.0151353717 1 0.0151363717 0)
VFR4 fr_pa 0 PWL(0 0 0.00332282338 0 0.00332382338 1 0.0157094095 1 0.0157104095 0)
VFR5 fr_n5 0 PWL(0 0 0.00332282338 0 0.00332382338 1 0.0142391614 1 0.0142401614 0)
VFR6 fr_n3 0 PWL(0 0 0.00216528815 0 0.00216628815 1 0.0137784498 1 0.0137794498 0)
.tran 1u 0.0197094 0 2u
.end
