CLIS-WPI/OpenRU/hardware/h2/sim/d_worst_R2_nom_gmax.cir

* D ordering run R057 -- BEHAVIOURAL / PRELIMINARY (free-rail mode, ADAR1000 register reset)
* rails on/off (ms): +3V3_AUX [(2.3947199243154933, 16.54687716607946)]; +1V8_DIG [(3.361363679077563, None)]; +3V3_RF [(4.716384038845559, 16.54687716607946)]; +5V_PA [(5.886870589445294, 16.54687716607946)]; -5V_BF [(0.8791273553412673, None)]; -3V3_SW [(1.9402170769655358, None)]
.include h2c_plant.inc
.param free=1 adar_reset=1 tr_aux=0.820 tr_18=0.576 tr_rf=2.443 tr_pa=1.729 tr_n5=2.995 tr_n3=3.861
VVIN vin 0 PWL(0 12 0.0165468772 12 0.0165478772 0)
VE3 fw_en3v3 0 1
VE5 fw_en5vpa 0 1
VEN fw_enneg 0 1
VKL ldo5_kill 0 0
VRK rf_kill 0 0
VWD fw_wdt 0 PWL(0 1)
VPA fw_pa_en 0 PWL(0 0 0.0231060775 0 0.0231070775 1 0.0274212112 1 0.0274222112 0 0.0275802705 0 0.0275812705 1 0.0318893886 1 0.0318903886 0)
VD1 dac1 0 PWL(0 0 0.0203672186 0 0.0203682186 -1.75 0.0229060775 -1.75 0.0229070775 -1.75 0.0231298184 -1.75 0.0231308184 -1.75 0.0239060775 -1.75 0.0239070775 -1.1 0.0251699009 -1.1 0.0251709009 0 0.0331854112 0 0.0331864112 0)
VD2 dac2 0 PWL(0 0 0.0203672186 0 0.0203682186 -1.75 0.0229060775 -1.75 0.0229070775 -1.75 0.0231298184 -1.75 0.0231308184 -1.75 0.0239060775 -1.75 0.0239070775 -1.1 0.0251699009 -1.1 0.0251709009 -1.1 0.0331854112 -1.1 0.0331864112 0)
VD3 dac3 0 PWL(0 0 0.0203672186 0 0.0203682186 -1.75 0.0229060775 -1.75 0.0229070775 -1.75 0.0231298184 -1.75 0.0231308184 -1.75 0.0239060775 -1.75 0.0239070775 -1.1 0.0251699009 -1.1 0.0251709009 -1.1 0.0331854112 -1.1 0.0331864112 0)
VD4 dac4 0 PWL(0 0 0.0203672186 0 0.0203682186 -1.75 0.0229060775 -1.75 0.0229070775 -1.75 0.0231298184 -1.75 0.0231308184 -1.75 0.0239060775 -1.75 0.0239070775 -1.1 0.0251699009 -1.1 0.0251709009 -1.1 0.0331854112 -1.1 0.0331864112 0)
VTLW tlw 0 PWL(0 0 0.0203672186 0 0.0203682186 0.0203672 0.0229060775 0.0203672 0.0229070775 0.0229061 0.0231298184 0.0229061 0.0231308184 0.0231298 0.0239060775 0.0231298 0.0239070775 0.0239061 0.0251699009 0.0239061 0.0251709009 0.0251699 0.0331854112 0.0251699 0.0331864112 0.0331854)
VFR1 fr_aux 0 PWL(0 0 0.00239471992 0 0.00239571992 1 0.0165468772 1 0.0165478772 0)
VFR2 fr_18 0 PWL(0 0 0.00336136368 0 0.00336236368 1)
VFR3 fr_rf 0 PWL(0 0 0.00471638404 0 0.00471738404 1 0.0165468772 1 0.0165478772 0)
VFR4 fr_pa 0 PWL(0 0 0.00588687059 0 0.00588787059 1 0.0165468772 1 0.0165478772 0)
VFR5 fr_n5 0 PWL(0 0 0.000879127355 0 0.000880127355 1)
VFR6 fr_n3 0 PWL(0 0 0.00194021708 0 0.00194121708 1)
.tran 1u 0.04 0 2u
.end
