CLIS-WPI/OpenRU/hardware/h2/sim/d_worst_R2_nom_gmin.cir

* D ordering run R133 -- BEHAVIOURAL / PRELIMINARY (free-rail mode, ADAR1000 register reset)
* rails on/off (ms): +3V3_AUX [(0.8634298619067886, 17.27164459766415)]; +1V8_DIG [(6.839451976373704, None)]; +3V3_RF [(6.262413475166552, None)]; +5V_PA [(1.2400318223761684, None)]; -5V_BF [(2.7775995047193085, None)]; -3V3_SW [(3.775897106680507, None)]
.include h2c_plant.inc
.param free=1 adar_reset=1 tr_aux=1.431 tr_18=0.396 tr_rf=1.013 tr_pa=1.567 tr_n5=1.870 tr_n3=2.453
VVIN vin 0 PWL(0 12)
VE3 fw_en3v3 0 1
VE5 fw_en5vpa 0 1
VEN fw_enneg 0 1
VKL ldo5_kill 0 0
VRK rf_kill 0 0
VWD fw_wdt 0 PWL(0 1 0.00567978959 1 0.00568078959 0 0.00734480149 0 0.00734580149 1)
VPA fw_pa_en 0 PWL(0 0 0.00839647677 0 0.00839747677 1 0.0123809622 1 0.0123819622 0 0.0266473644 0 0.0266483644 1 0.0285002007 1 0.0285012007 0 0.0351816527 0 0.0351826527 1 0.0384456503 1 0.0384466503 0)
VD1 dac1 0 PWL(0 0 0.00819647677 0 0.00819747677 -1.75 0.00919647677 -1.75 0.00919747677 -1.1 0.010578078 -1.1 0.010579078 -1.75)
VD2 dac2 0 PWL(0 0 0.00819647677 0 0.00819747677 -1.75 0.00919647677 -1.75 0.00919747677 -1.1 0.010578078 -1.1 0.010579078 -1.75)
VD3 dac3 0 PWL(0 0 0.00819647677 0 0.00819747677 -1.75 0.00919647677 -1.75 0.00919747677 -1.1 0.010578078 -1.1 0.010579078 -1.75)
VD4 dac4 0 PWL(0 0 0.00819647677 0 0.00819747677 -1.75 0.00919647677 -1.75 0.00919747677 -1.1 0.010578078 -1.1 0.010579078 -1.75)
VTLW tlw 0 PWL(0 0 0.00819647677 0 0.00819747677 0.00819648 0.00919647677 0.00819648 0.00919747677 0.00919648 0.010578078 0.00919648 0.010579078 0.0105781)
VFR1 fr_aux 0 PWL(0 0 0.000863429862 0 0.000864429862 1 0.0172716446 1 0.0172726446 0)
VFR2 fr_18 0 PWL(0 0 0.00683945198 0 0.00684045198 1)
VFR3 fr_rf 0 PWL(0 0 0.00626241348 0 0.00626341348 1)
VFR4 fr_pa 0 PWL(0 0 0.00124003182 0 0.00124103182 1)
VFR5 fr_n5 0 PWL(0 0 0.0027775995 0 0.0027785995 1)
VFR6 fr_n3 0 PWL(0 0 0.00377589711 0 0.00377689711 1)
.tran 1u 0.04 0 2u
.end
