CLIS-WPI/OpenRU/hardware/h2/schematics/bf1.kicad_sch

## KiCad design hardware/h2/schematics/bf1.kicad_sch (2026-11-12)

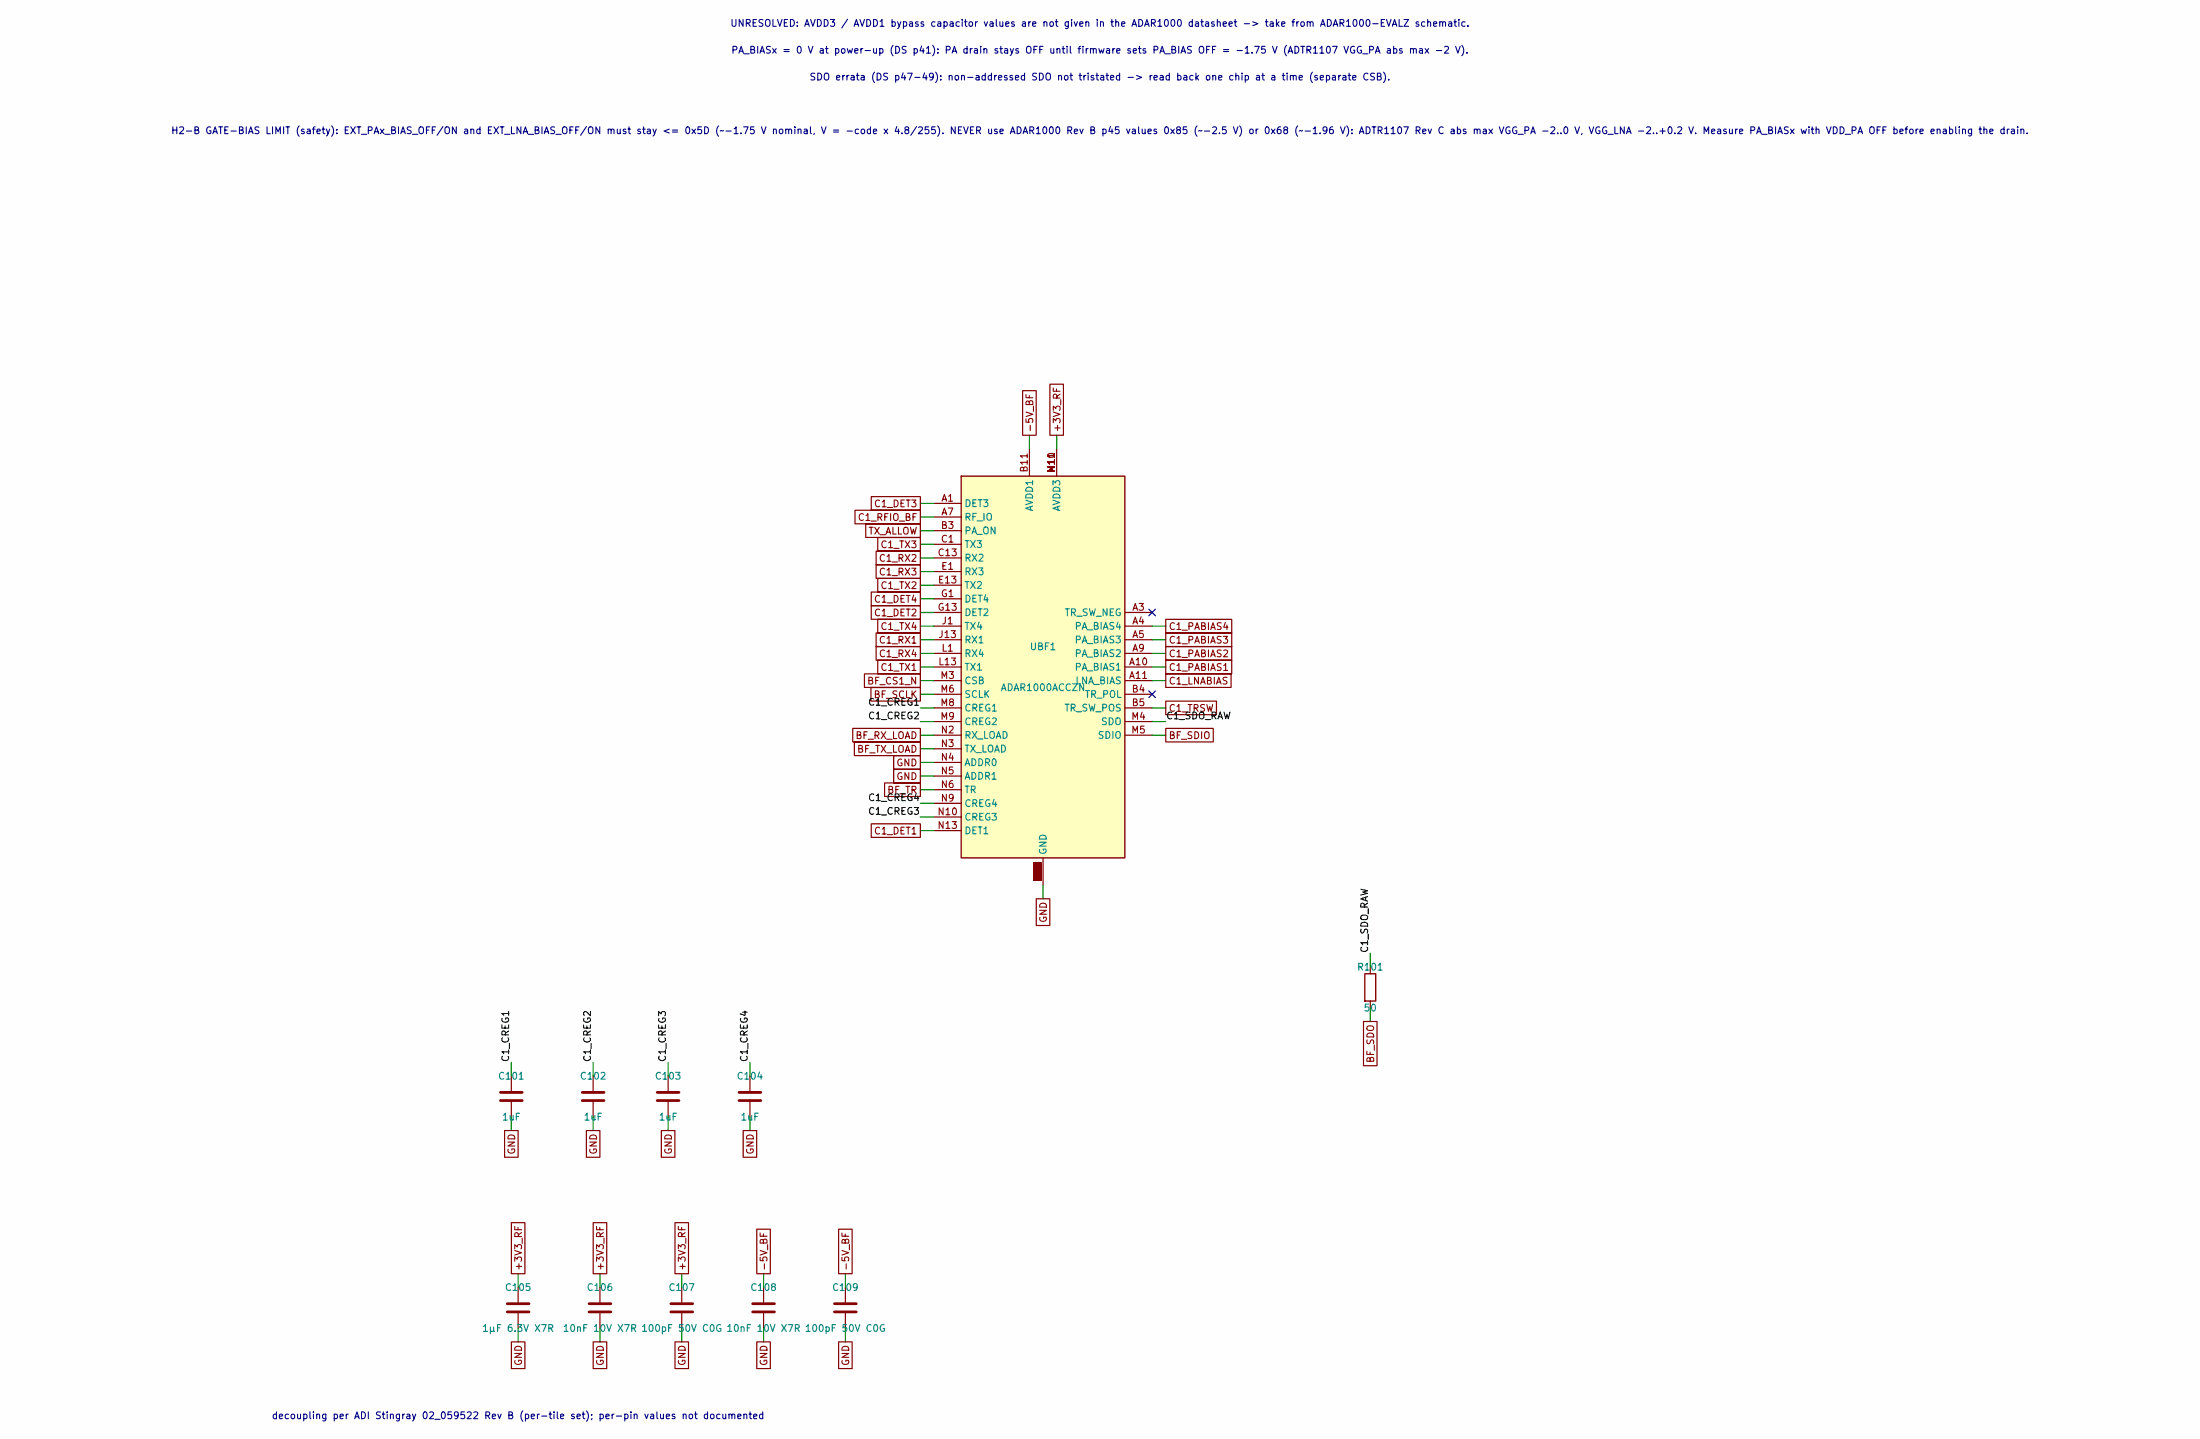
[picture p36: schematic bf1.kicad_sch]

Parts:
C101, C102, C103, C104: 1uF; C_0603_1608Metric
C105: 1µF 6.3V X7R; C_0402_1005Metric; MPN GRM155R70J105KA12D
C106, C108: 10nF 10V X7R; C_0402_1005Metric
C107, C109: 100pF 50V C0G; C_0402_1005Metric
R101: 50; R_0402_1005Metric
UBF1: ADAR1000ACCZN; MPN ADAR1000ACCZN

Connections:
+3V3_RF: C105.1, C106.1, C107.1, UBF1.M10 (AVDD3), UBF1.M11 (AVDD3), UBF1.N11 (AVDD3)
-5V_BF: C108.1, C109.1, UBF1.B11 (AVDD1)
BF_CS1_N: UBF1.M3 (CSB)
BF_RX_LOAD: UBF1.N2 (RX_LOAD)
BF_SCLK: UBF1.M6 (SCLK)
BF_SDIO: UBF1.M5 (SDIO)
BF_SDO: R101.2
BF_TR: UBF1.N6 (TR)
BF_TX_LOAD: UBF1.N3 (TX_LOAD)
C1_CREG1: C101.1, UBF1.M8 (CREG1)
C1_CREG2: C102.1, UBF1.M9 (CREG2)
C1_CREG3: C103.1, UBF1.N10 (CREG3)
C1_CREG4: C104.1, UBF1.N9 (CREG4)
C1_DET1: UBF1.N13 (DET1)
C1_DET2: UBF1.G13 (DET2)
C1_DET3: UBF1.A1 (DET3)
C1_DET4: UBF1.G1 (DET4)
C1_LNABIAS: UBF1.A11 (LNA_BIAS)
C1_PABIAS1: UBF1.A10 (PA_BIAS1)
C1_PABIAS2: UBF1.A9 (PA_BIAS2)
C1_PABIAS3: UBF1.A5 (PA_BIAS3)
C1_PABIAS4: UBF1.A4 (PA_BIAS4)
C1_RFIO_BF: UBF1.A7 (RF_IO)
C1_RX1: UBF1.J13 (RX1)
C1_RX2: UBF1.C13 (RX2)
C1_RX3: UBF1.E1 (RX3)
C1_RX4: UBF1.L1 (RX4)
C1_SDO_RAW: R101.1, UBF1.M4 (SDO)
C1_TRSW: UBF1.B5 (TR_SW_POS)
C1_TX1: UBF1.L13 (TX1)
C1_TX2: UBF1.E13 (TX2)
C1_TX3: UBF1.C1 (TX3)
C1_TX4: UBF1.J1 (TX4)
GND: C101.2, C102.2, C103.2, C104.2, C105.2, C106.2, C107.2, C108.2, C109.2, UBF1.A2 (GND), UBF1.A6 (GND), UBF1.A8 (GND), UBF1.A12 (GND), UBF1.A13 (GND), UBF1.B1 (GND), UBF1.B2 (GND), UBF1.B6 (GND), UBF1.B7 (GND), UBF1.B8 (GND), UBF1.B9 (GND), UBF1.B10 (GND), UBF1.B12 (GND), UBF1.B13 (GND), UBF1.C2 (GND), UBF1.C12 (GND), UBF1.D1 (GND), UBF1.D2 (GND), UBF1.D12 (GND), UBF1.D13 (GND), UBF1.E2 (GND), UBF1.E12 (GND), UBF1.EP (GND), UBF1.F1 (GND), UBF1.F2 (GND), UBF1.F12 (GND), UBF1.F13 (GND), UBF1.G2 (GND), UBF1.G12 (GND), UBF1.H1 (GND), UBF1.H2 (GND), UBF1.H12 (GND), UBF1.H13 (GND), UBF1.J2 (GND), UBF1.J12 (GND), UBF1.K1 (GND), UBF1.K2 (GND), UBF1.K12 (GND), UBF1.K13 (GND), UBF1.L2 (GND), UBF1.L12 (GND), UBF1.M1 (GND), UBF1.M2 (GND), UBF1.M7 (GND), UBF1.M12 (GND), UBF1.M13 (GND), UBF1.N1 (GND), UBF1.N4 (ADDR0), UBF1.N5 (ADDR1), UBF1.N7 (GND), UBF1.N8 (GND), UBF1.N12 (GND)
TX_ALLOW: UBF1.B3 (PA_ON)

Notes on the sheet:
UNRESOLVED: AVDD3 / AVDD1 bypass capacitor values are not given in the ADAR1000 datasheet -> take from ADAR1000-EVALZ schematic.
PA_BIASx = 0 V at power-up (DS p41): PA drain stays OFF until firmware sets PA_BIAS OFF = -1.75 V (ADTR1107 VGG_PA abs max -2 V).
SDO errata (DS p47-49): non-addressed SDO not tristated -> read back one chip at a time (separate CSB).
H2-B GATE-BIAS LIMIT (safety): EXT_PAx_BIAS_OFF/ON and EXT_LNA_BIAS_OFF/ON must stay <= 0x5D (~-1.75 V nominal, V = -code x 4.8/255). NEVER use ADAR1000 Rev B p45 values 0x85 (~-2.5 V) or 0x68 (~-1.96 V): ADTR1107 Rev C abs max VGG_PA -2..0 V, VGG_LNA -2..+0.2 V. Measure PA_BIASx with VDD_PA OFF be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
decoupling per ADI Stingray 02_059522 Rev B (per-tile set); per-pin values not documented
