CLIS-WPI/OpenRU/hardware/h2/schematics/bf2.kicad_sch

## KiCad design hardware/h2/schematics/bf2.kicad_sch (2026-11-12)

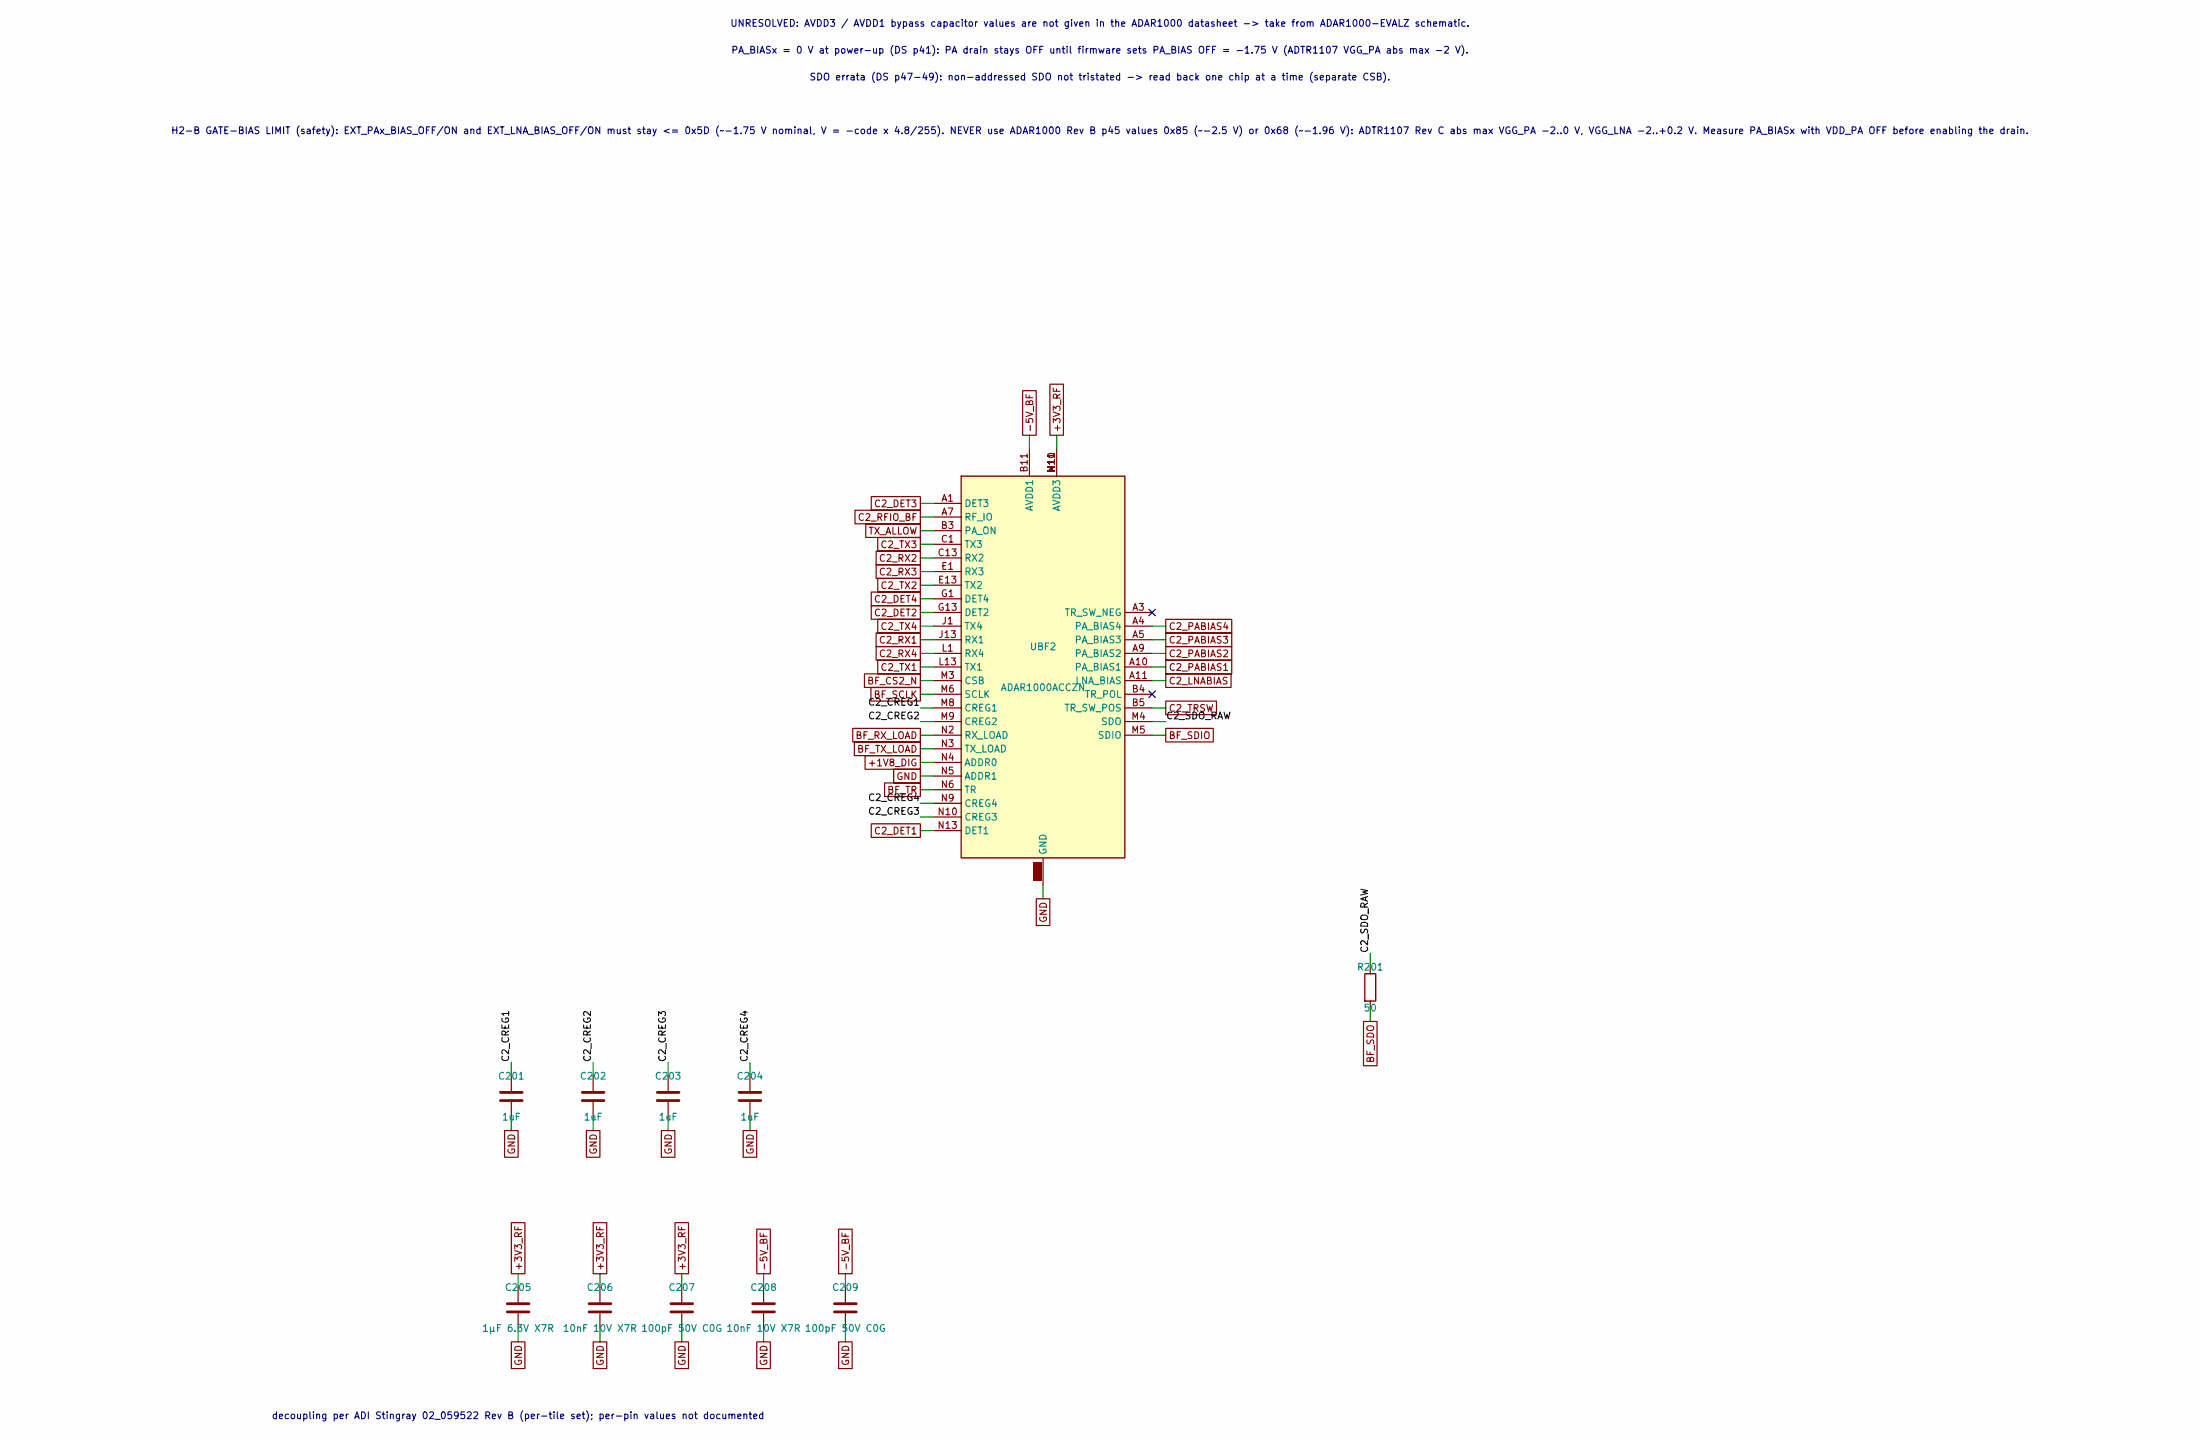
[picture p37: schematic bf2.kicad_sch]

Parts:
C201, C202, C203, C204: 1uF; C_0603_1608Metric
C205: 1µF 6.3V X7R; C_0402_1005Metric; MPN GRM155R70J105KA12D
C206, C208: 10nF 10V X7R; C_0402_1005Metric
C207, C209: 100pF 50V C0G; C_0402_1005Metric
R201: 50; R_0402_1005Metric
UBF2: ADAR1000ACCZN; MPN ADAR1000ACCZN

Connections:
+1V8_DIG: UBF2.N4 (ADDR0)
+3V3_RF: C205.1, C206.1, C207.1, UBF2.M10 (AVDD3), UBF2.M11 (AVDD3), UBF2.N11 (AVDD3)
-5V_BF: C208.1, C209.1, UBF2.B11 (AVDD1)
BF_CS2_N: UBF2.M3 (CSB)
BF_RX_LOAD: UBF2.N2 (RX_LOAD)
BF_SCLK: UBF2.M6 (SCLK)
BF_SDIO: UBF2.M5 (SDIO)
BF_SDO: R201.2
BF_TR: UBF2.N6 (TR)
BF_TX_LOAD: UBF2.N3 (TX_LOAD)
C2_CREG1: C201.1, UBF2.M8 (CREG1)
C2_CREG2: C202.1, UBF2.M9 (CREG2)
C2_CREG3: C203.1, UBF2.N10 (CREG3)
C2_CREG4: C204.1, UBF2.N9 (CREG4)
C2_DET1: UBF2.N13 (DET1)
C2_DET2: UBF2.G13 (DET2)
C2_DET3: UBF2.A1 (DET3)
C2_DET4: UBF2.G1 (DET4)
C2_LNABIAS: UBF2.A11 (LNA_BIAS)
C2_PABIAS1: UBF2.A10 (PA_BIAS1)
C2_PABIAS2: UBF2.A9 (PA_BIAS2)
C2_PABIAS3: UBF2.A5 (PA_BIAS3)
C2_PABIAS4: UBF2.A4 (PA_BIAS4)
C2_RFIO_BF: UBF2.A7 (RF_IO)
C2_RX1: UBF2.J13 (RX1)
C2_RX2: UBF2.C13 (RX2)
C2_RX3: UBF2.E1 (RX3)
C2_RX4: UBF2.L1 (RX4)
C2_SDO_RAW: R201.1, UBF2.M4 (SDO)
C2_TRSW: UBF2.B5 (TR_SW_POS)
C2_TX1: UBF2.L13 (TX1)
C2_TX2: UBF2.E13 (TX2)
C2_TX3: UBF2.C1 (TX3)
C2_TX4: UBF2.J1 (TX4)
GND: C201.2, C202.2, C203.2, C204.2, C205.2, C206.2, C207.2, C208.2, C209.2, UBF2.A2 (GND), UBF2.A6 (GND), UBF2.A8 (GND), UBF2.A12 (GND), UBF2.A13 (GND), UBF2.B1 (GND), UBF2.B2 (GND), UBF2.B6 (GND), UBF2.B7 (GND), UBF2.B8 (GND), UBF2.B9 (GND), UBF2.B10 (GND), UBF2.B12 (GND), UBF2.B13 (GND), UBF2.C2 (GND), UBF2.C12 (GND), UBF2.D1 (GND), UBF2.D2 (GND), UBF2.D12 (GND), UBF2.D13 (GND), UBF2.E2 (GND), UBF2.E12 (GND), UBF2.EP (GND), UBF2.F1 (GND), UBF2.F2 (GND), UBF2.F12 (GND), UBF2.F13 (GND), UBF2.G2 (GND), UBF2.G12 (GND), UBF2.H1 (GND), UBF2.H2 (GND), UBF2.H12 (GND), UBF2.H13 (GND), UBF2.J2 (GND), UBF2.J12 (GND), UBF2.K1 (GND), UBF2.K2 (GND), UBF2.K12 (GND), UBF2.K13 (GND), UBF2.L2 (GND), UBF2.L12 (GND), UBF2.M1 (GND), UBF2.M2 (GND), UBF2.M7 (GND), UBF2.M12 (GND), UBF2.M13 (GND), UBF2.N1 (GND), UBF2.N5 (ADDR1), UBF2.N7 (GND), UBF2.N8 (GND), UBF2.N12 (GND)
TX_ALLOW: UBF2.B3 (PA_ON)

Notes on the sheet:
UNRESOLVED: AVDD3 / AVDD1 bypass capacitor values are not given in the ADAR1000 datasheet -> take from ADAR1000-EVALZ schematic.
PA_BIASx = 0 V at power-up (DS p41): PA drain stays OFF until firmware sets PA_BIAS OFF = -1.75 V (ADTR1107 VGG_PA abs max -2 V).
SDO errata (DS p47-49): non-addressed SDO not tristated -> read back one chip at a time (separate CSB).
H2-B GATE-BIAS LIMIT (safety): EXT_PAx_BIAS_OFF/ON and EXT_LNA_BIAS_OFF/ON must stay <= 0x5D (~-1.75 V nominal, V = -code x 4.8/255). NEVER use ADAR1000 Rev B p45 values 0x85 (~-2.5 V) or 0x68 (~-1.96 V): ADTR1107 Rev C abs max VGG_PA -2..0 V, VGG_LNA -2..+0.2 V. Measure PA_BIASx with VDD_PA OFF be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
decoupling per ADI Stingray 02_059522 Rev B (per-tile set); per-pin values not documented
