CLIS-WPI/OpenRU/hardware/h2/schematics/bf3.kicad_sch

## KiCad design hardware/h2/schematics/bf3.kicad_sch (2026-11-12)

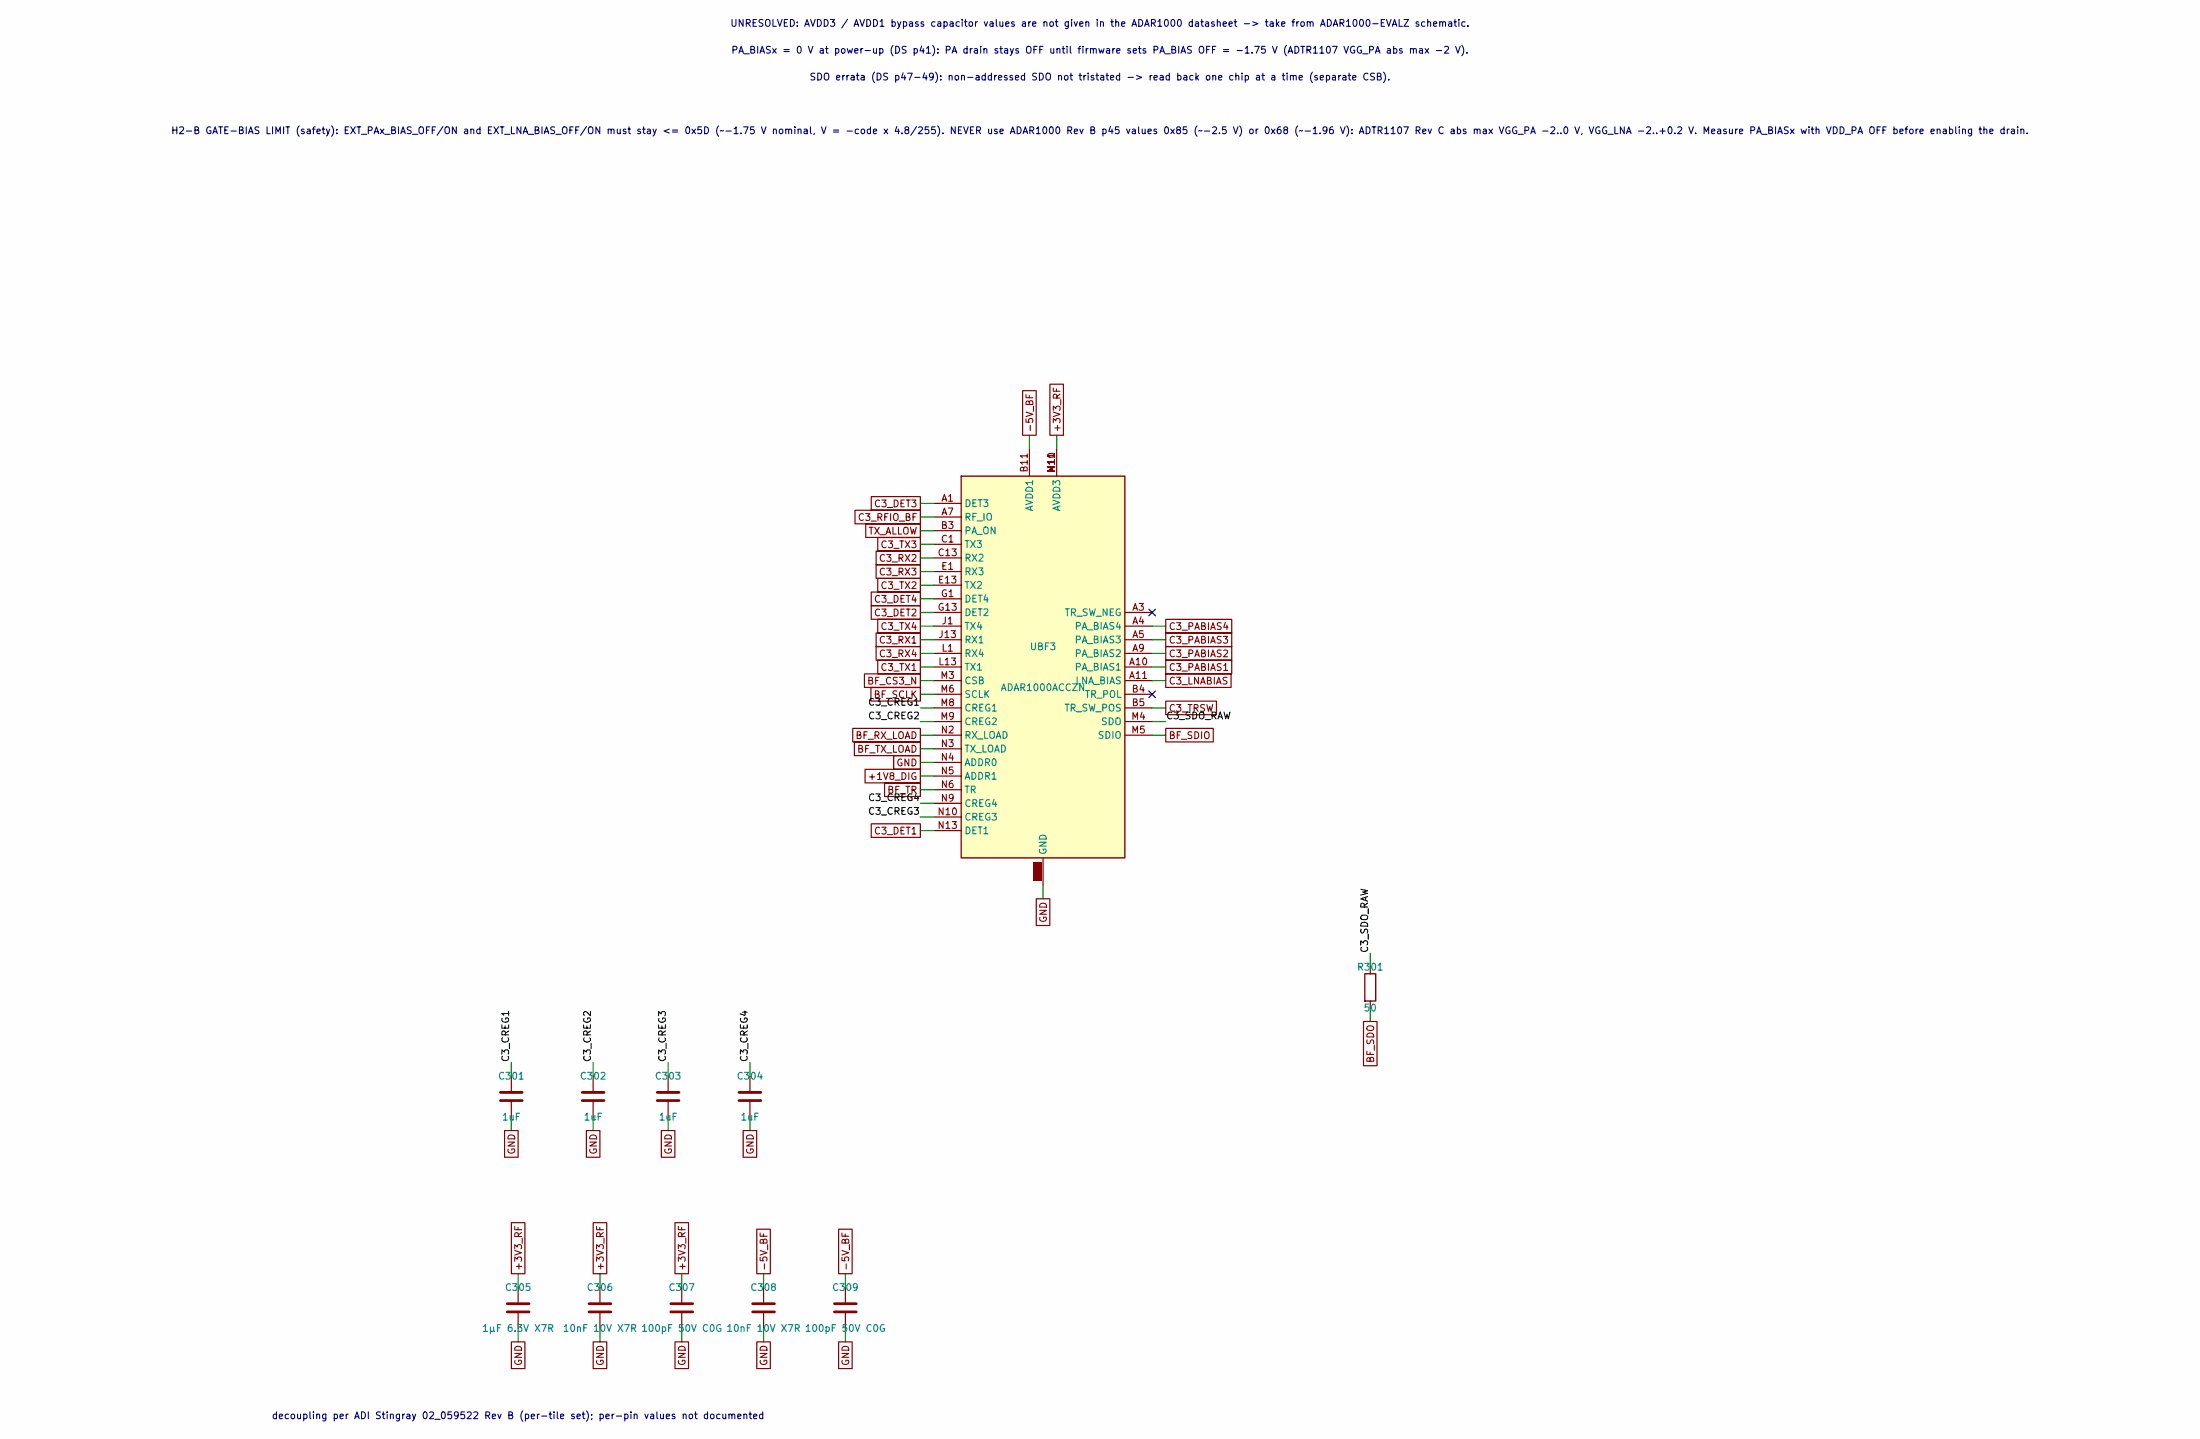
[picture p38: schematic bf3.kicad_sch]

Parts:
C301, C302, C303, C304: 1uF; C_0603_1608Metric
C305: 1µF 6.3V X7R; C_0402_1005Metric; MPN GRM155R70J105KA12D
C306, C308: 10nF 10V X7R; C_0402_1005Metric
C307, C309: 100pF 50V C0G; C_0402_1005Metric
R301: 50; R_0402_1005Metric
UBF3: ADAR1000ACCZN; MPN ADAR1000ACCZN

Connections:
+1V8_DIG: UBF3.N5 (ADDR1)
+3V3_RF: C305.1, C306.1, C307.1, UBF3.M10 (AVDD3), UBF3.M11 (AVDD3), UBF3.N11 (AVDD3)
-5V_BF: C308.1, C309.1, UBF3.B11 (AVDD1)
BF_CS3_N: UBF3.M3 (CSB)
BF_RX_LOAD: UBF3.N2 (RX_LOAD)
BF_SCLK: UBF3.M6 (SCLK)
BF_SDIO: UBF3.M5 (SDIO)
BF_SDO: R301.2
BF_TR: UBF3.N6 (TR)
BF_TX_LOAD: UBF3.N3 (TX_LOAD)
C3_CREG1: C301.1, UBF3.M8 (CREG1)
C3_CREG2: C302.1, UBF3.M9 (CREG2)
C3_CREG3: C303.1, UBF3.N10 (CREG3)
C3_CREG4: C304.1, UBF3.N9 (CREG4)
C3_DET1: UBF3.N13 (DET1)
C3_DET2: UBF3.G13 (DET2)
C3_DET3: UBF3.A1 (DET3)
C3_DET4: UBF3.G1 (DET4)
C3_LNABIAS: UBF3.A11 (LNA_BIAS)
C3_PABIAS1: UBF3.A10 (PA_BIAS1)
C3_PABIAS2: UBF3.A9 (PA_BIAS2)
C3_PABIAS3: UBF3.A5 (PA_BIAS3)
C3_PABIAS4: UBF3.A4 (PA_BIAS4)
C3_RFIO_BF: UBF3.A7 (RF_IO)
C3_RX1: UBF3.J13 (RX1)
C3_RX2: UBF3.C13 (RX2)
C3_RX3: UBF3.E1 (RX3)
C3_RX4: UBF3.L1 (RX4)
C3_SDO_RAW: R301.1, UBF3.M4 (SDO)
C3_TRSW: UBF3.B5 (TR_SW_POS)
C3_TX1: UBF3.L13 (TX1)
C3_TX2: UBF3.E13 (TX2)
C3_TX3: UBF3.C1 (TX3)
C3_TX4: UBF3.J1 (TX4)
GND: C301.2, C302.2, C303.2, C304.2, C305.2, C306.2, C307.2, C308.2, C309.2, UBF3.A2 (GND), UBF3.A6 (GND), UBF3.A8 (GND), UBF3.A12 (GND), UBF3.A13 (GND), UBF3.B1 (GND), UBF3.B2 (GND), UBF3.B6 (GND), UBF3.B7 (GND), UBF3.B8 (GND), UBF3.B9 (GND), UBF3.B10 (GND), UBF3.B12 (GND), UBF3.B13 (GND), UBF3.C2 (GND), UBF3.C12 (GND), UBF3.D1 (GND), UBF3.D2 (GND), UBF3.D12 (GND), UBF3.D13 (GND), UBF3.E2 (GND), UBF3.E12 (GND), UBF3.EP (GND), UBF3.F1 (GND), UBF3.F2 (GND), UBF3.F12 (GND), UBF3.F13 (GND), UBF3.G2 (GND), UBF3.G12 (GND), UBF3.H1 (GND), UBF3.H2 (GND), UBF3.H12 (GND), UBF3.H13 (GND), UBF3.J2 (GND), UBF3.J12 (GND), UBF3.K1 (GND), UBF3.K2 (GND), UBF3.K12 (GND), UBF3.K13 (GND), UBF3.L2 (GND), UBF3.L12 (GND), UBF3.M1 (GND), UBF3.M2 (GND), UBF3.M7 (GND), UBF3.M12 (GND), UBF3.M13 (GND), UBF3.N1 (GND), UBF3.N4 (ADDR0), UBF3.N7 (GND), UBF3.N8 (GND), UBF3.N12 (GND)
TX_ALLOW: UBF3.B3 (PA_ON)

Notes on the sheet:
UNRESOLVED: AVDD3 / AVDD1 bypass capacitor values are not given in the ADAR1000 datasheet -> take from ADAR1000-EVALZ schematic.
PA_BIASx = 0 V at power-up (DS p41): PA drain stays OFF until firmware sets PA_BIAS OFF = -1.75 V (ADTR1107 VGG_PA abs max -2 V).
SDO errata (DS p47-49): non-addressed SDO not tristated -> read back one chip at a time (separate CSB).
H2-B GATE-BIAS LIMIT (safety): EXT_PAx_BIAS_OFF/ON and EXT_LNA_BIAS_OFF/ON must stay <= 0x5D (~-1.75 V nominal, V = -code x 4.8/255). NEVER use ADAR1000 Rev B p45 values 0x85 (~-2.5 V) or 0x68 (~-1.96 V): ADTR1107 Rev C abs max VGG_PA -2..0 V, VGG_LNA -2..+0.2 V. Measure PA_BIASx with VDD_PA OFF be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
decoupling per ADI Stingray 02_059522 Rev B (per-tile set); per-pin values not documented
