CLIS-WPI/OpenRU/hardware/h2/schematics/bf4.kicad_sch

## KiCad design hardware/h2/schematics/bf4.kicad_sch (2026-11-12)

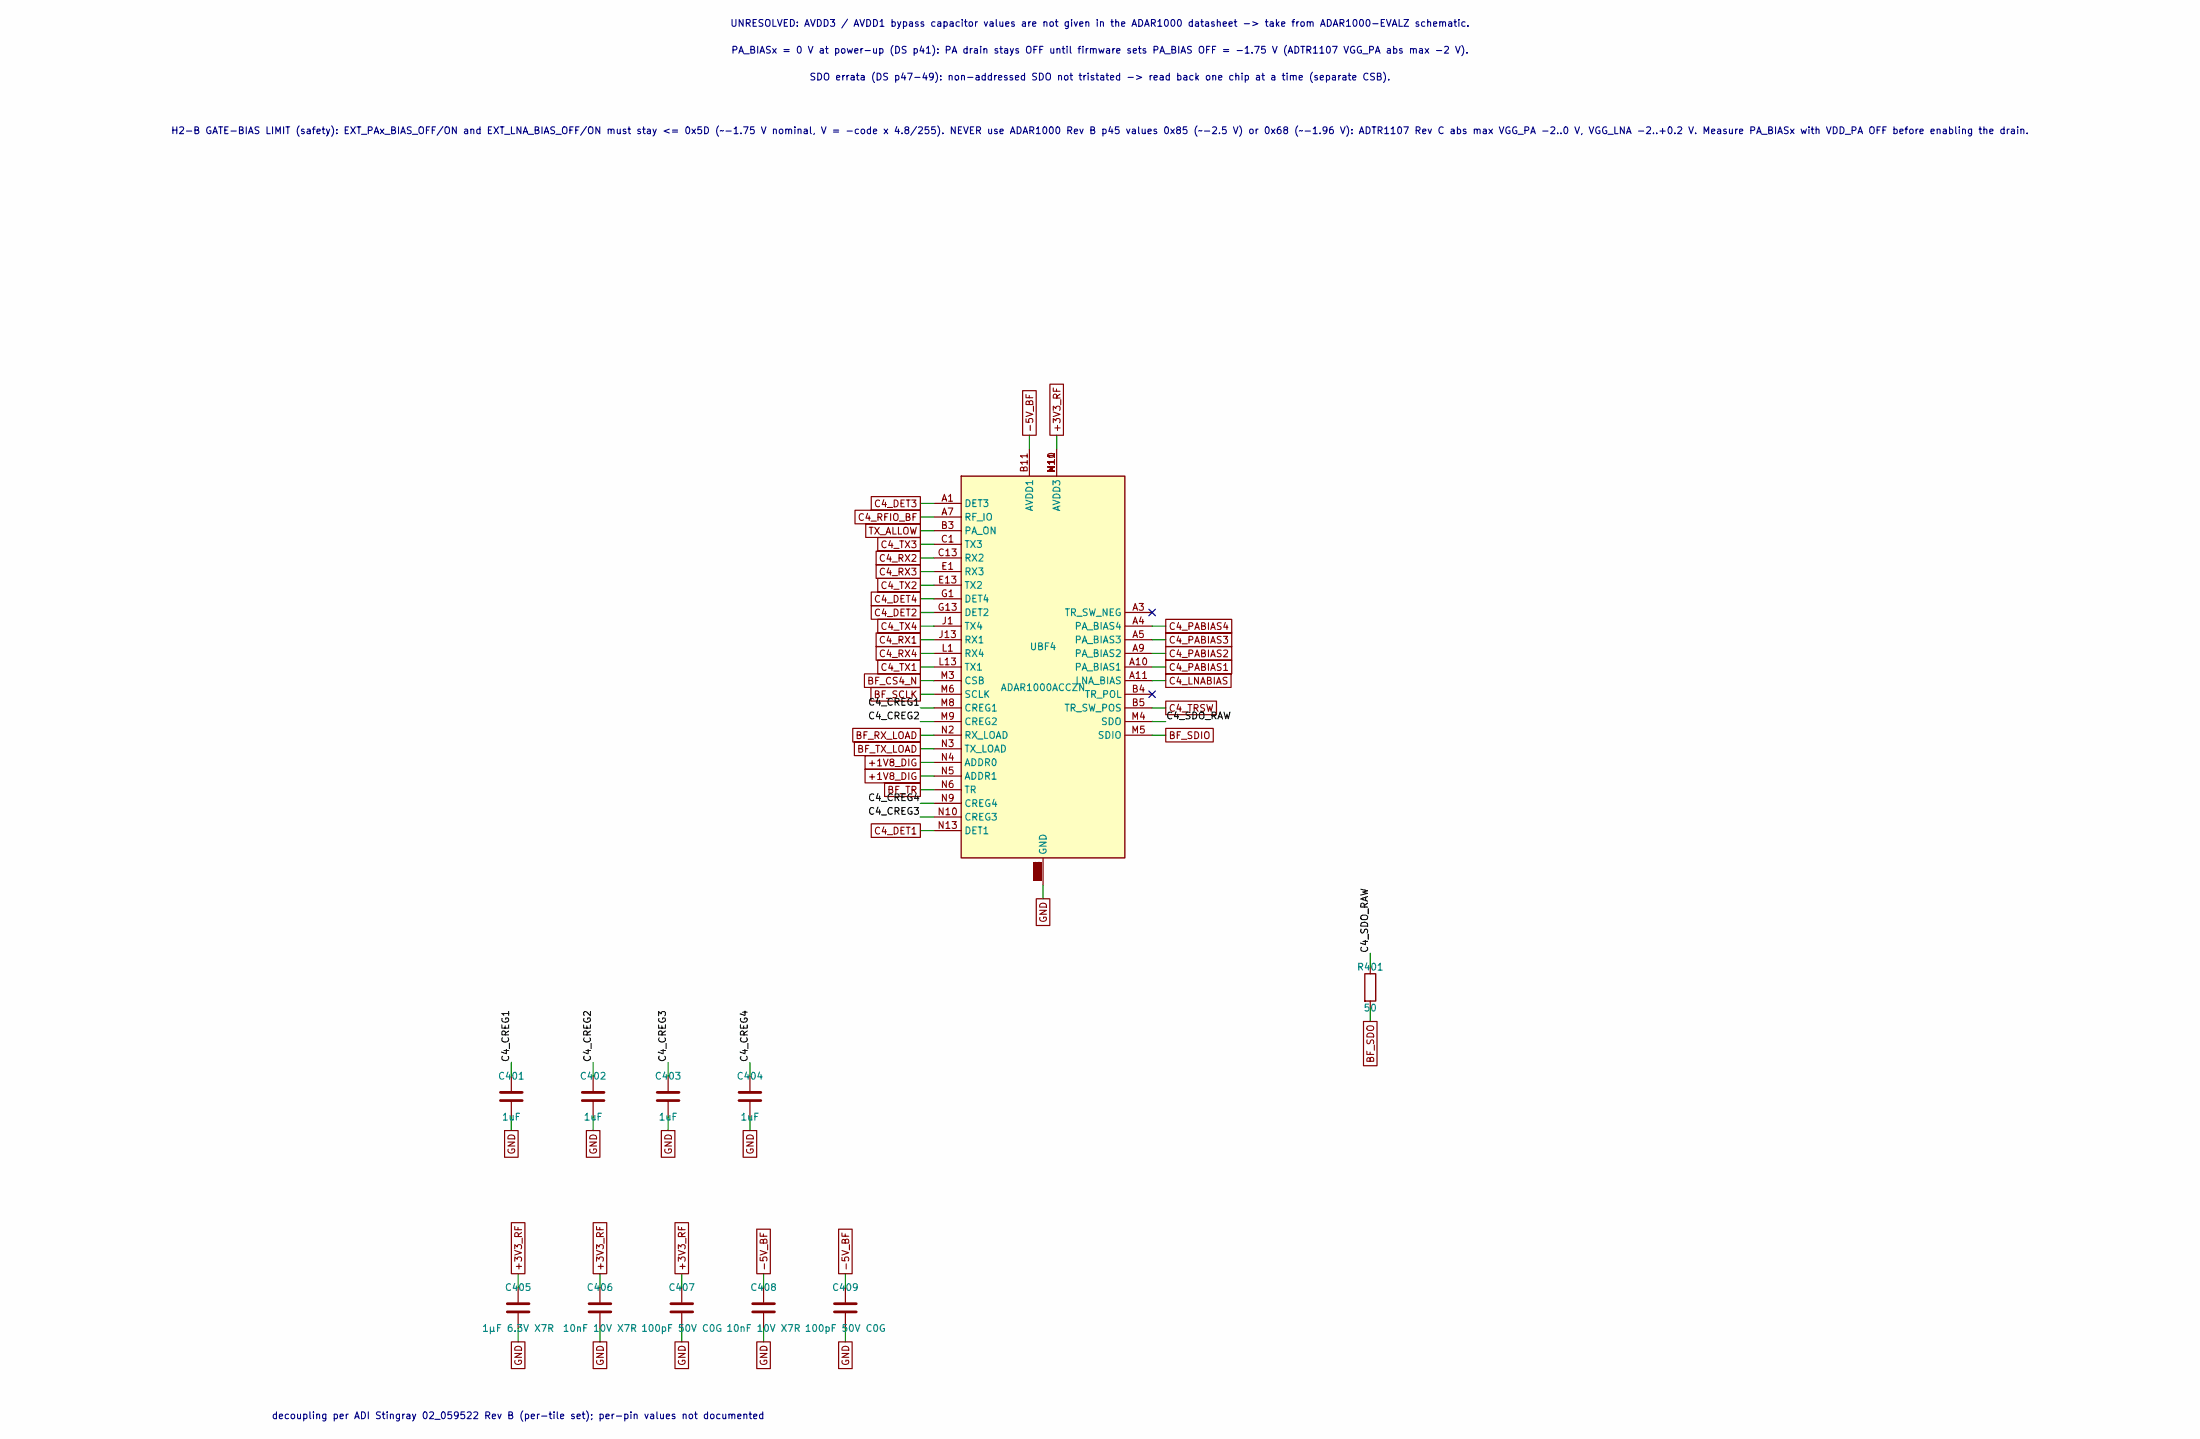
[picture p39: schematic bf4.kicad_sch]

Parts:
C401, C402, C403, C404: 1uF; C_0603_1608Metric
C405: 1µF 6.3V X7R; C_0402_1005Metric; MPN GRM155R70J105KA12D
C406, C408: 10nF 10V X7R; C_0402_1005Metric
C407, C409: 100pF 50V C0G; C_0402_1005Metric
R401: 50; R_0402_1005Metric
UBF4: ADAR1000ACCZN; MPN ADAR1000ACCZN

Connections:
+1V8_DIG: UBF4.N4 (ADDR0), UBF4.N5 (ADDR1)
+3V3_RF: C405.1, C406.1, C407.1, UBF4.M10 (AVDD3), UBF4.M11 (AVDD3), UBF4.N11 (AVDD3)
-5V_BF: C408.1, C409.1, UBF4.B11 (AVDD1)
BF_CS4_N: UBF4.M3 (CSB)
BF_RX_LOAD: UBF4.N2 (RX_LOAD)
BF_SCLK: UBF4.M6 (SCLK)
BF_SDIO: UBF4.M5 (SDIO)
BF_SDO: R401.2
BF_TR: UBF4.N6 (TR)
BF_TX_LOAD: UBF4.N3 (TX_LOAD)
C4_CREG1: C401.1, UBF4.M8 (CREG1)
C4_CREG2: C402.1, UBF4.M9 (CREG2)
C4_CREG3: C403.1, UBF4.N10 (CREG3)
C4_CREG4: C404.1, UBF4.N9 (CREG4)
C4_DET1: UBF4.N13 (DET1)
C4_DET2: UBF4.G13 (DET2)
C4_DET3: UBF4.A1 (DET3)
C4_DET4: UBF4.G1 (DET4)
C4_LNABIAS: UBF4.A11 (LNA_BIAS)
C4_PABIAS1: UBF4.A10 (PA_BIAS1)
C4_PABIAS2: UBF4.A9 (PA_BIAS2)
C4_PABIAS3: UBF4.A5 (PA_BIAS3)
C4_PABIAS4: UBF4.A4 (PA_BIAS4)
C4_RFIO_BF: UBF4.A7 (RF_IO)
C4_RX1: UBF4.J13 (RX1)
C4_RX2: UBF4.C13 (RX2)
C4_RX3: UBF4.E1 (RX3)
C4_RX4: UBF4.L1 (RX4)
C4_SDO_RAW: R401.1, UBF4.M4 (SDO)
C4_TRSW: UBF4.B5 (TR_SW_POS)
C4_TX1: UBF4.L13 (TX1)
C4_TX2: UBF4.E13 (TX2)
C4_TX3: UBF4.C1 (TX3)
C4_TX4: UBF4.J1 (TX4)
GND: C401.2, C402.2, C403.2, C404.2, C405.2, C406.2, C407.2, C408.2, C409.2, UBF4.A2 (GND), UBF4.A6 (GND), UBF4.A8 (GND), UBF4.A12 (GND), UBF4.A13 (GND), UBF4.B1 (GND), UBF4.B2 (GND), UBF4.B6 (GND), UBF4.B7 (GND), UBF4.B8 (GND), UBF4.B9 (GND), UBF4.B10 (GND), UBF4.B12 (GND), UBF4.B13 (GND), UBF4.C2 (GND), UBF4.C12 (GND), UBF4.D1 (GND), UBF4.D2 (GND), UBF4.D12 (GND), UBF4.D13 (GND), UBF4.E2 (GND), UBF4.E12 (GND), UBF4.EP (GND), UBF4.F1 (GND), UBF4.F2 (GND), UBF4.F12 (GND), UBF4.F13 (GND), UBF4.G2 (GND), UBF4.G12 (GND), UBF4.H1 (GND), UBF4.H2 (GND), UBF4.H12 (GND), UBF4.H13 (GND), UBF4.J2 (GND), UBF4.J12 (GND), UBF4.K1 (GND), UBF4.K2 (GND), UBF4.K12 (GND), UBF4.K13 (GND), UBF4.L2 (GND), UBF4.L12 (GND), UBF4.M1 (GND), UBF4.M2 (GND), UBF4.M7 (GND), UBF4.M12 (GND), UBF4.M13 (GND), UBF4.N1 (GND), UBF4.N7 (GND), UBF4.N8 (GND), UBF4.N12 (GND)
TX_ALLOW: UBF4.B3 (PA_ON)

Notes on the sheet:
UNRESOLVED: AVDD3 / AVDD1 bypass capacitor values are not given in the ADAR1000 datasheet -> take from ADAR1000-EVALZ schematic.
PA_BIASx = 0 V at power-up (DS p41): PA drain stays OFF until firmware sets PA_BIAS OFF = -1.75 V (ADTR1107 VGG_PA abs max -2 V).
SDO errata (DS p47-49): non-addressed SDO not tristated -> read back one chip at a time (separate CSB).
H2-B GATE-BIAS LIMIT (safety): EXT_PAx_BIAS_OFF/ON and EXT_LNA_BIAS_OFF/ON must stay <= 0x5D (~-1.75 V nominal, V = -code x 4.8/255). NEVER use ADAR1000 Rev B p45 values 0x85 (~-2.5 V) or 0x68 (~-1.96 V): ADTR1107 Rev C abs max VGG_PA -2..0 V, VGG_LNA -2..+0.2 V. Measure PA_BIASx with VDD_PA OFF be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
decoupling per ADI Stingray 02_059522 Rev B (per-tile set); per-pin values not documented
