CLIS-WPI/OpenRU/hardware/h2/schematics/cal.kicad_sch

## KiCad design hardware/h2/schematics/cal.kicad_sch (2026-11-12)

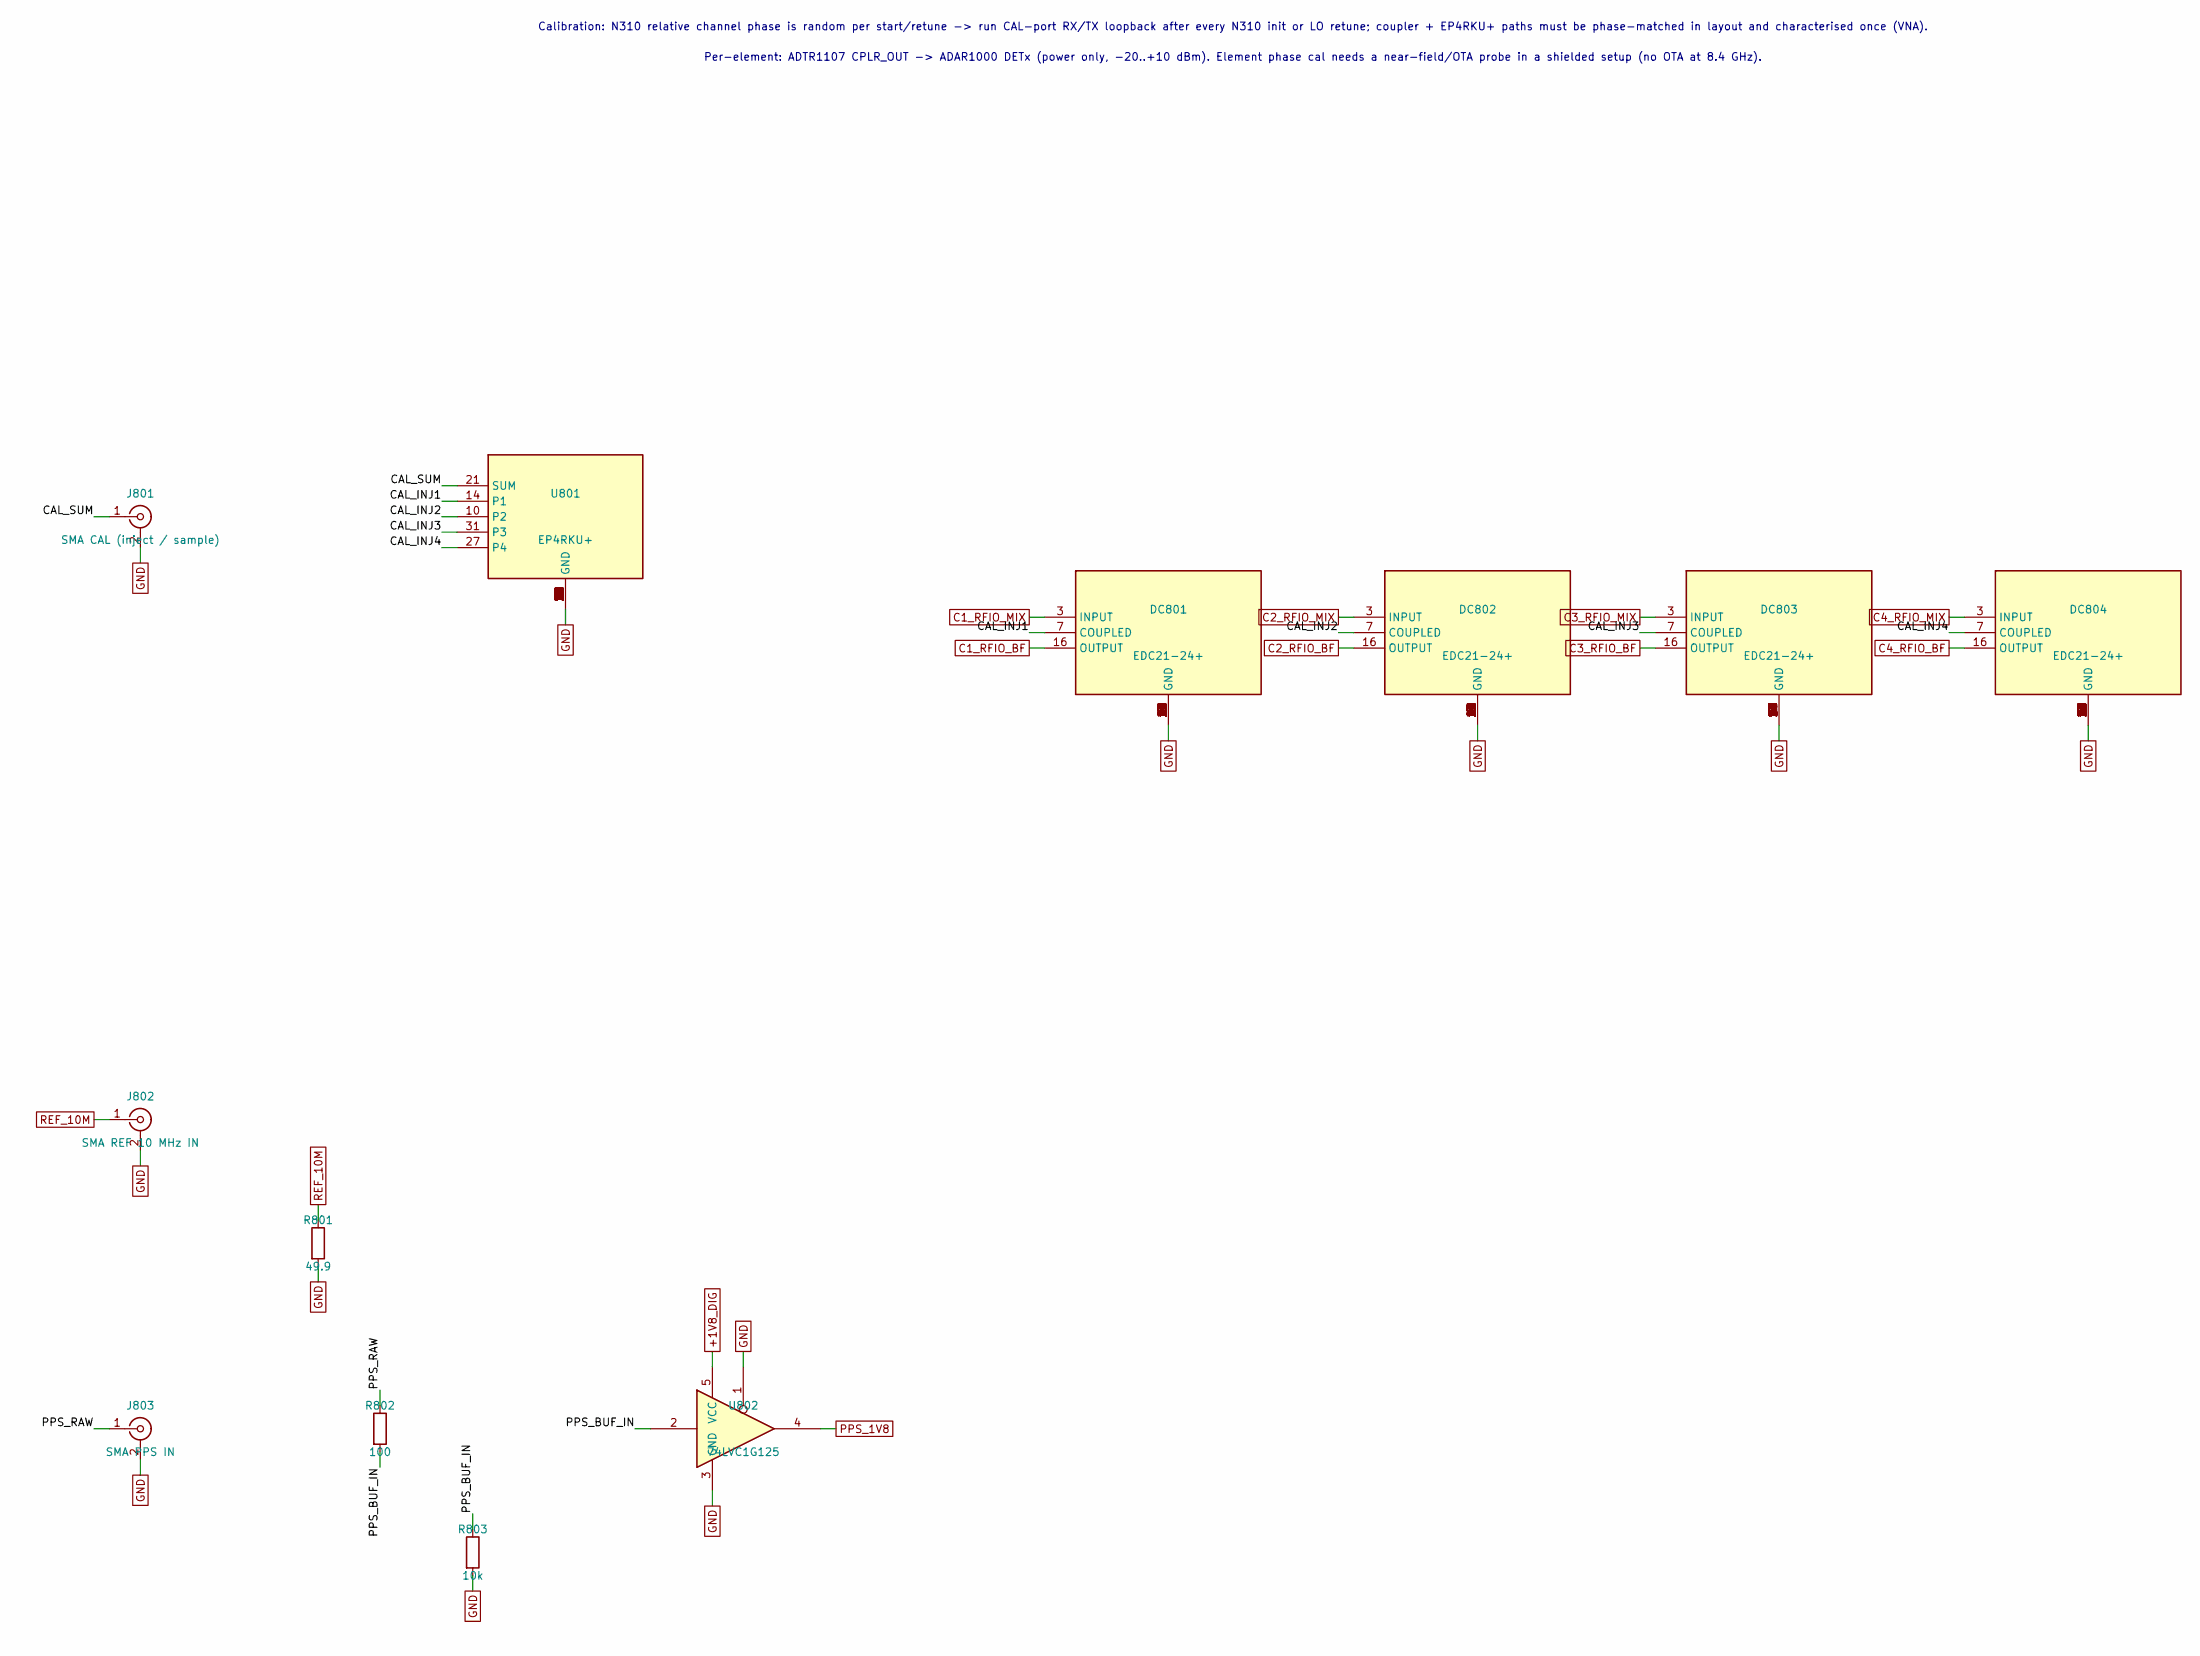
[picture p40: schematic cal.kicad_sch]

Parts:
DC801, DC802, DC803, DC804: EDC21-24+; MPN EDC21-24+
J801: SMA CAL (inject / sample)
J802: SMA REF 10 MHz IN
J803: SMA PPS IN
R801: 49.9; R_0402_1005Metric
R802: 100; R_0402_1005Metric
R803: 10k; R_0402_1005Metric
U801: EP4RKU+; MPN EP4RKU+
U802: 74LVC1G125; SOT-23-5

Connections:
+1V8_DIG: U802.5 (VCC)
C1_RFIO_BF: DC801.16 (OUTPUT)
C1_RFIO_MIX: DC801.3 (INPUT)
C2_RFIO_BF: DC802.16 (OUTPUT)
C2_RFIO_MIX: DC802.3 (INPUT)
C3_RFIO_BF: DC803.16 (OUTPUT)
C3_RFIO_MIX: DC803.3 (INPUT)
C4_RFIO_BF: DC804.16 (OUTPUT)
C4_RFIO_MIX: DC804.3 (INPUT)
CAL_INJ1: DC801.7 (COUPLED), U801.14 (P1)
CAL_INJ2: DC802.7 (COUPLED), U801.10 (P2)
CAL_INJ3: DC803.7 (COUPLED), U801.31 (P3)
CAL_INJ4: DC804.7 (COUPLED), U801.27 (P4)
CAL_SUM: J801.1 (In), U801.21 (SUM)
GND: DC801.1 (GND), DC801.2 (GND), DC801.4 (GND), DC801.5 (GND), DC801.6 (GND), DC801.8 (GND), DC801.9 (GND), DC801.10 (GND), DC801.11 (GND), DC801.12 (GND), DC801.13 (GND), DC801.14 (GND), DC801.15 (GND), DC801.17 (GND), DC801.18 (GND), DC801.19 (GND), DC801.20 (GND), DC801.21 (GND), DC801.22 (GND), DC801.23 (GND), DC801.24 (GND), DC801.EP (GND), DC802.1 (GND), DC802.2 (GND), DC802.4 (GND), DC802.5 (GND), DC802.6 (GND), DC802.8 (GND), DC802.9 (GND), DC802.10 (GND), DC802.11 (GND), DC802.12 (GND), DC802.13 (GND), DC802.14 (GND), DC802.15 (GND), DC802.17 (GND), DC802.18 (GND), DC802.19 (GND), DC802.20 (GND), DC802.21 (GND), DC802.22 (GND), DC802.23 (GND), DC802.24 (GND), DC802.EP (GND), DC803.1 (GND), DC803.2 (GND), DC803.4 (GND), DC803.5 (GND), DC803.6 (GND), DC803.8 (GND), DC803.9 (GND), DC803.10 (GND), DC803.11 (GND), DC803.12 (GND), DC803.13 (GND), DC803.14 (GND), DC803.15 (GND), DC803.17 (GND), DC803.18 (GND), DC803.19 (GND), DC803.20 (GND), DC803.21 (GND), DC803.22 (GND), DC803.23 (GND), DC803.24 (GND), DC803.EP (GND), DC804.1 (GND), DC804.2 (GND), DC804.4 (GND), DC804.5 (GND), DC804.6 (GND), DC804.8 (GND), DC804.9 (GND), DC804.10 (GND), DC804.11 (GND), DC804.12 (GND), DC804.13 (GND), DC804.14 (GND), DC804.15 (GND), DC804.17 (GND), DC804.18 (GND), DC804.19 (GND), DC804.20 (GND), DC804.21 (GND), DC804.22 (GND), DC804.23 (GND), DC804.24 (GND), DC804.EP (GND), J801.2 (Ext), J802.2 (Ext), J803.2 (Ext), R801.2, R803.2, U801.1 (GND), U801.2 (GND), U801.3 (GND), U801.4 (GND), U801.5 (GND), U801.6 (GND), U801.7 (GND), U801.8 (GND), U801.9 (GND), U801.11 (GND), U801.12 (GND), U801.13 (GND), U801.15 (GND), U801.16 (GND), U801.17 (GND), U801.18 (GND), U801.19 (GND), U801.20 (GND), U801.22 (GND), U801.23 (GND), U801.24 (GND), U801.25 (GND), U801.26 (GND), U801.28 (GND), U801.29 (GND), U801.30 (GND), U801.32 (GND), U801.EP (GND), U802.1, U802.3 (GND)
PPS_1V8: U802.4
PPS_BUF_IN: R802.2, R803.1, U802.2
PPS_RAW: J803.1 (In), R802.1
REF_10M: J802.1 (In), R801.1

Notes on the sheet:
Calibration: N310 relative channel phase is random per start/retune -> run CAL-port RX/TX loopback after every N310 init or LO retune; coupler + EP4RKU+ paths must be phase-matched in layout and characterised once (VNA).
Per-element: ADTR1107 CPLR_OUT -> ADAR1000 DETx (power only, -20..+10 dBm). Element phase cal needs a near-field/OTA probe in a shielded setup (no OTA at 8.4 GHz).
