CLIS-WPI/OpenRU/hardware/h2/schematics/conv1.kicad_sch

## KiCad design hardware/h2/schematics/conv1.kicad_sch (2026-11-12)

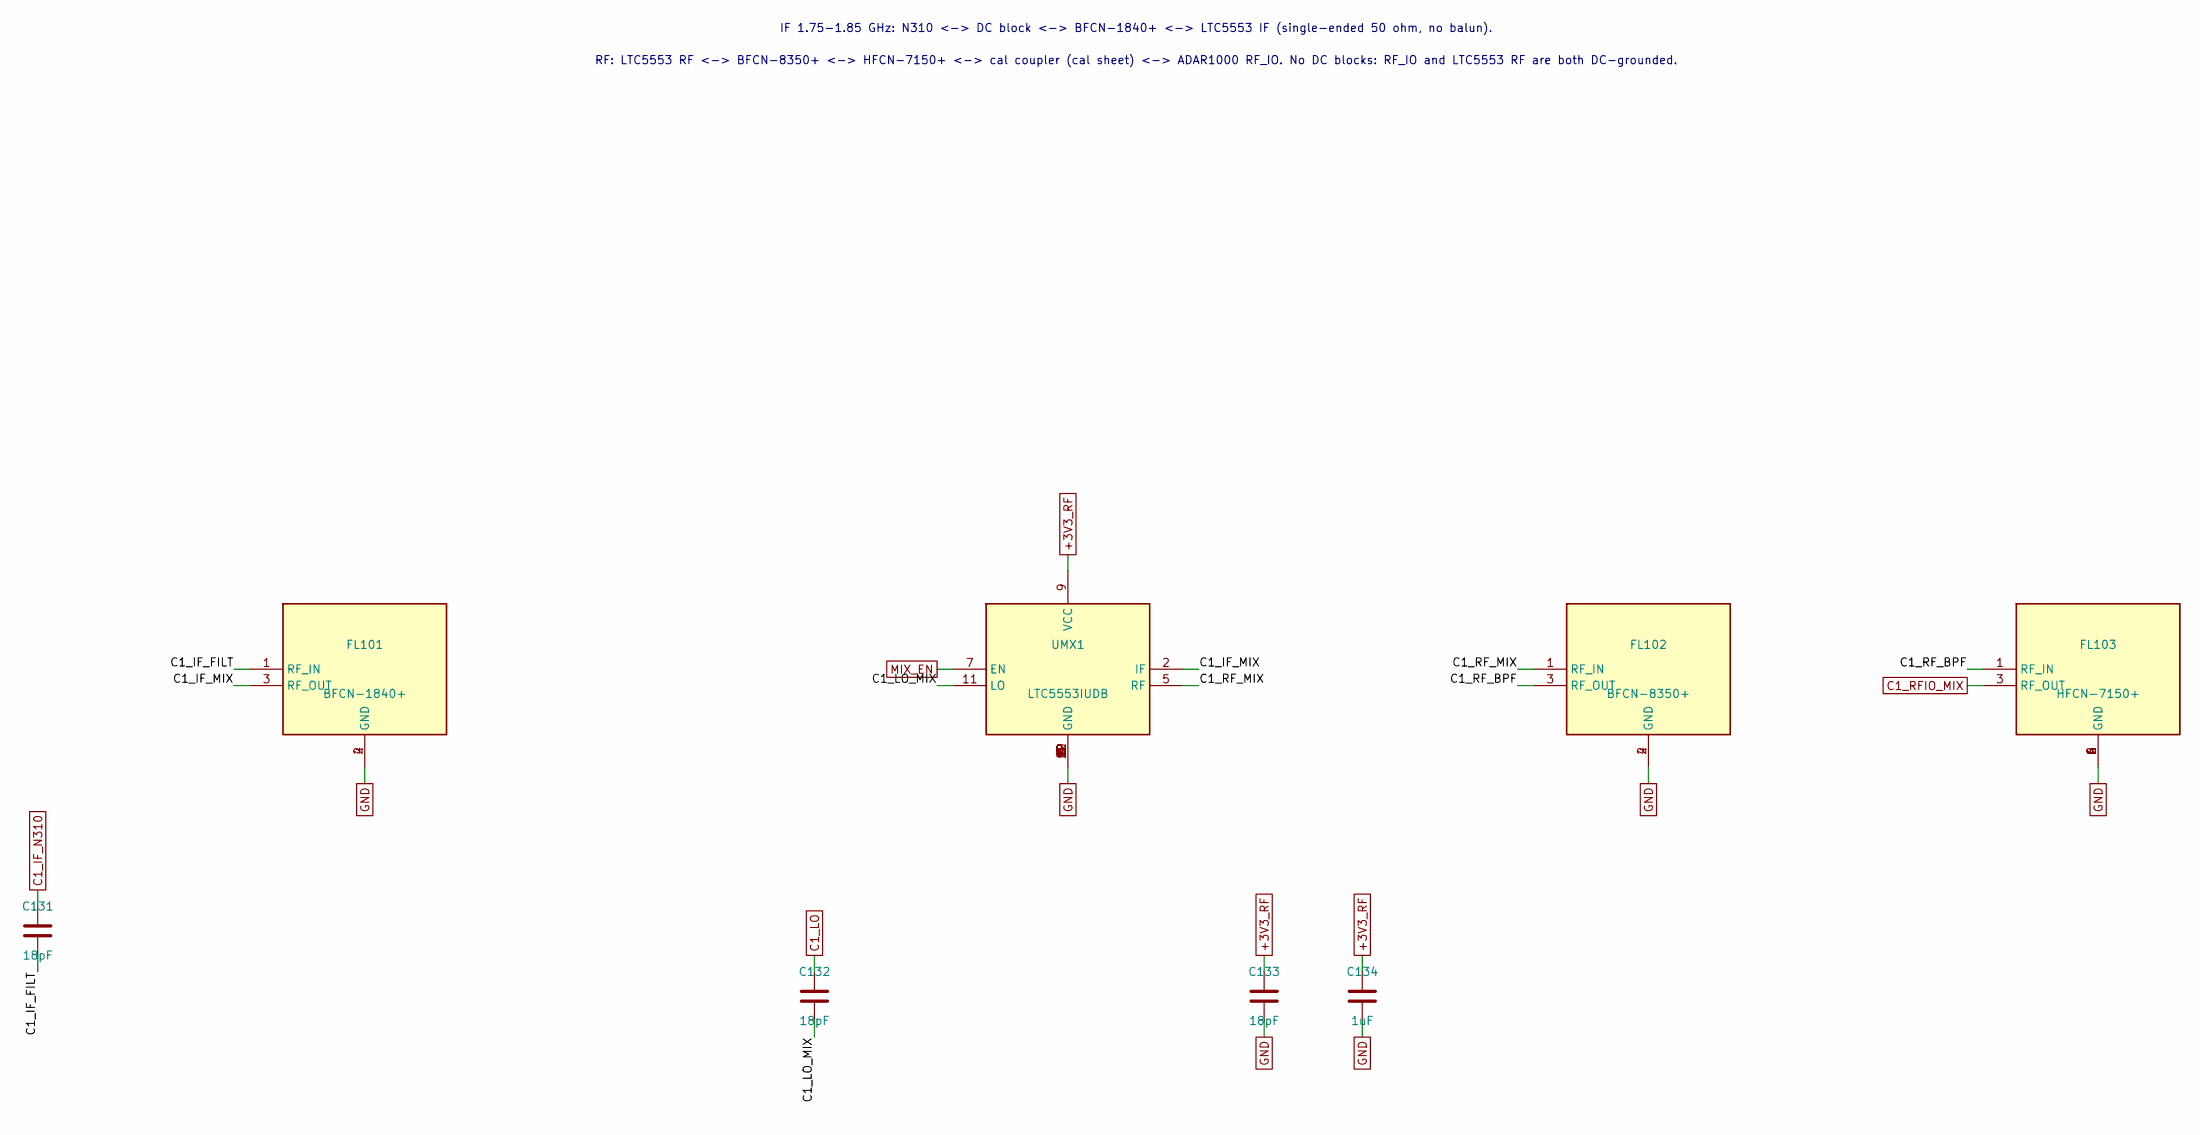
[picture p41: schematic conv1.kicad_sch]

Parts:
C131, C133: 18pF; C_0402_1005Metric; MPN GJM1555C1H180FB01
C132: 18pF; C_0402_1005Metric; MPN 0402ZK180GBS
C134: 1uF; C_0603_1608Metric; MPN GRM188R71A105KA61
FL101: BFCN-1840+; MPN BFCN-1840+
FL102: BFCN-8350+; MPN BFCN-8350+
FL103: HFCN-7150+; MPN HFCN-7150+
UMX1: LTC5553IUDB; MPN LTC5553IUDB#PBF

Connections:
+3V3_RF: C133.1, C134.1, UMX1.9 (VCC)
C1_IF_FILT: C131.2, FL101.1 (RF_IN)
C1_IF_MIX: FL101.3 (RF_OUT), UMX1.2 (IF)
C1_IF_N310: C131.1
C1_LO: C132.1
C1_LO_MIX: C132.2, UMX1.11 (LO)
C1_RFIO_MIX: FL103.3 (RF_OUT)
C1_RF_BPF: FL102.3 (RF_OUT), FL103.1 (RF_IN)
C1_RF_MIX: FL102.1 (RF_IN), UMX1.5 (RF)
GND: C133.2, C134.2, FL101.2 (GND), FL101.4 (GND), FL102.2 (GND), FL102.4 (GND), FL103.2 (GND), FL103.4 (GND), FL103.5 (GND), FL103.6 (GND), UMX1.1 (GND), UMX1.3 (GND), UMX1.4 (GND), UMX1.6 (GND), UMX1.8 (GND), UMX1.10 (GND), UMX1.12 (GND), UMX1.EP (GND)
MIX_EN: UMX1.7 (EN)

Notes on the sheet:
IF 1.75-1.85 GHz: N310 <-> DC block <-> BFCN-1840+ <-> LTC5553 IF (single-ended 50 ohm, no balun).
RF: LTC5553 RF <-> BFCN-8350+ <-> HFCN-7150+ <-> cal coupler (cal sheet) <-> ADAR1000 RF_IO. No DC blocks: RF_IO and LTC5553 RF are both DC-grounded.
