CLIS-WPI/OpenRU/hardware/h2/schematics/conv2.kicad_sch

## KiCad design hardware/h2/schematics/conv2.kicad_sch (2026-11-12)

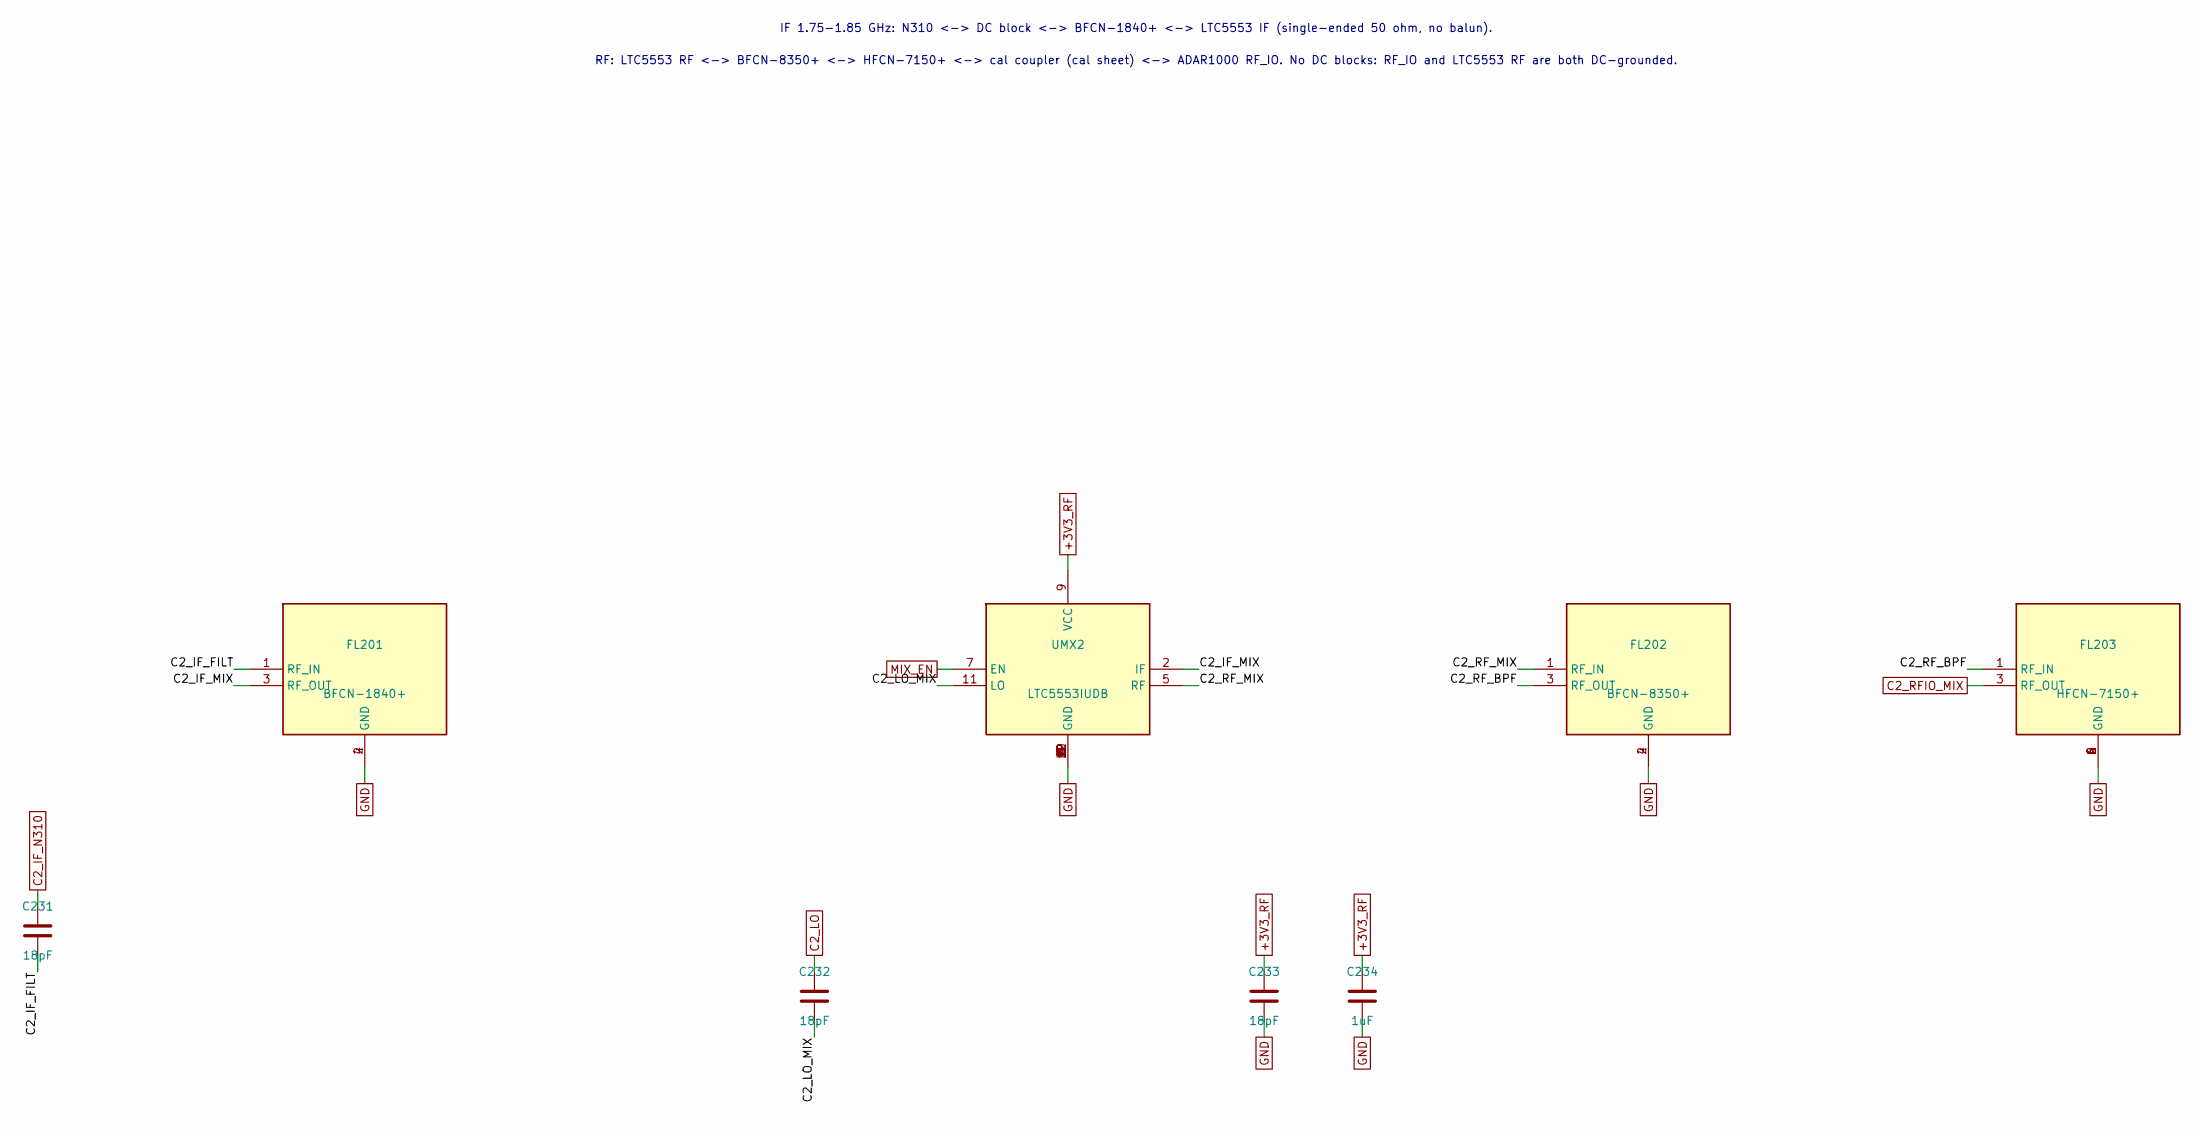
[picture p42: schematic conv2.kicad_sch]

Parts:
C231, C233: 18pF; C_0402_1005Metric; MPN GJM1555C1H180FB01
C232: 18pF; C_0402_1005Metric; MPN 0402ZK180GBS
C234: 1uF; C_0603_1608Metric; MPN GRM188R71A105KA61
FL201: BFCN-1840+; MPN BFCN-1840+
FL202: BFCN-8350+; MPN BFCN-8350+
FL203: HFCN-7150+; MPN HFCN-7150+
UMX2: LTC5553IUDB; MPN LTC5553IUDB#PBF

Connections:
+3V3_RF: C233.1, C234.1, UMX2.9 (VCC)
C2_IF_FILT: C231.2, FL201.1 (RF_IN)
C2_IF_MIX: FL201.3 (RF_OUT), UMX2.2 (IF)
C2_IF_N310: C231.1
C2_LO: C232.1
C2_LO_MIX: C232.2, UMX2.11 (LO)
C2_RFIO_MIX: FL203.3 (RF_OUT)
C2_RF_BPF: FL202.3 (RF_OUT), FL203.1 (RF_IN)
C2_RF_MIX: FL202.1 (RF_IN), UMX2.5 (RF)
GND: C233.2, C234.2, FL201.2 (GND), FL201.4 (GND), FL202.2 (GND), FL202.4 (GND), FL203.2 (GND), FL203.4 (GND), FL203.5 (GND), FL203.6 (GND), UMX2.1 (GND), UMX2.3 (GND), UMX2.4 (GND), UMX2.6 (GND), UMX2.8 (GND), UMX2.10 (GND), UMX2.12 (GND), UMX2.EP (GND)
MIX_EN: UMX2.7 (EN)

Notes on the sheet:
IF 1.75-1.85 GHz: N310 <-> DC block <-> BFCN-1840+ <-> LTC5553 IF (single-ended 50 ohm, no balun).
RF: LTC5553 RF <-> BFCN-8350+ <-> HFCN-7150+ <-> cal coupler (cal sheet) <-> ADAR1000 RF_IO. No DC blocks: RF_IO and LTC5553 RF are both DC-grounded.
