CLIS-WPI/OpenRU/hardware/h2/schematics/conv3.kicad_sch

## KiCad design hardware/h2/schematics/conv3.kicad_sch (2026-11-12)

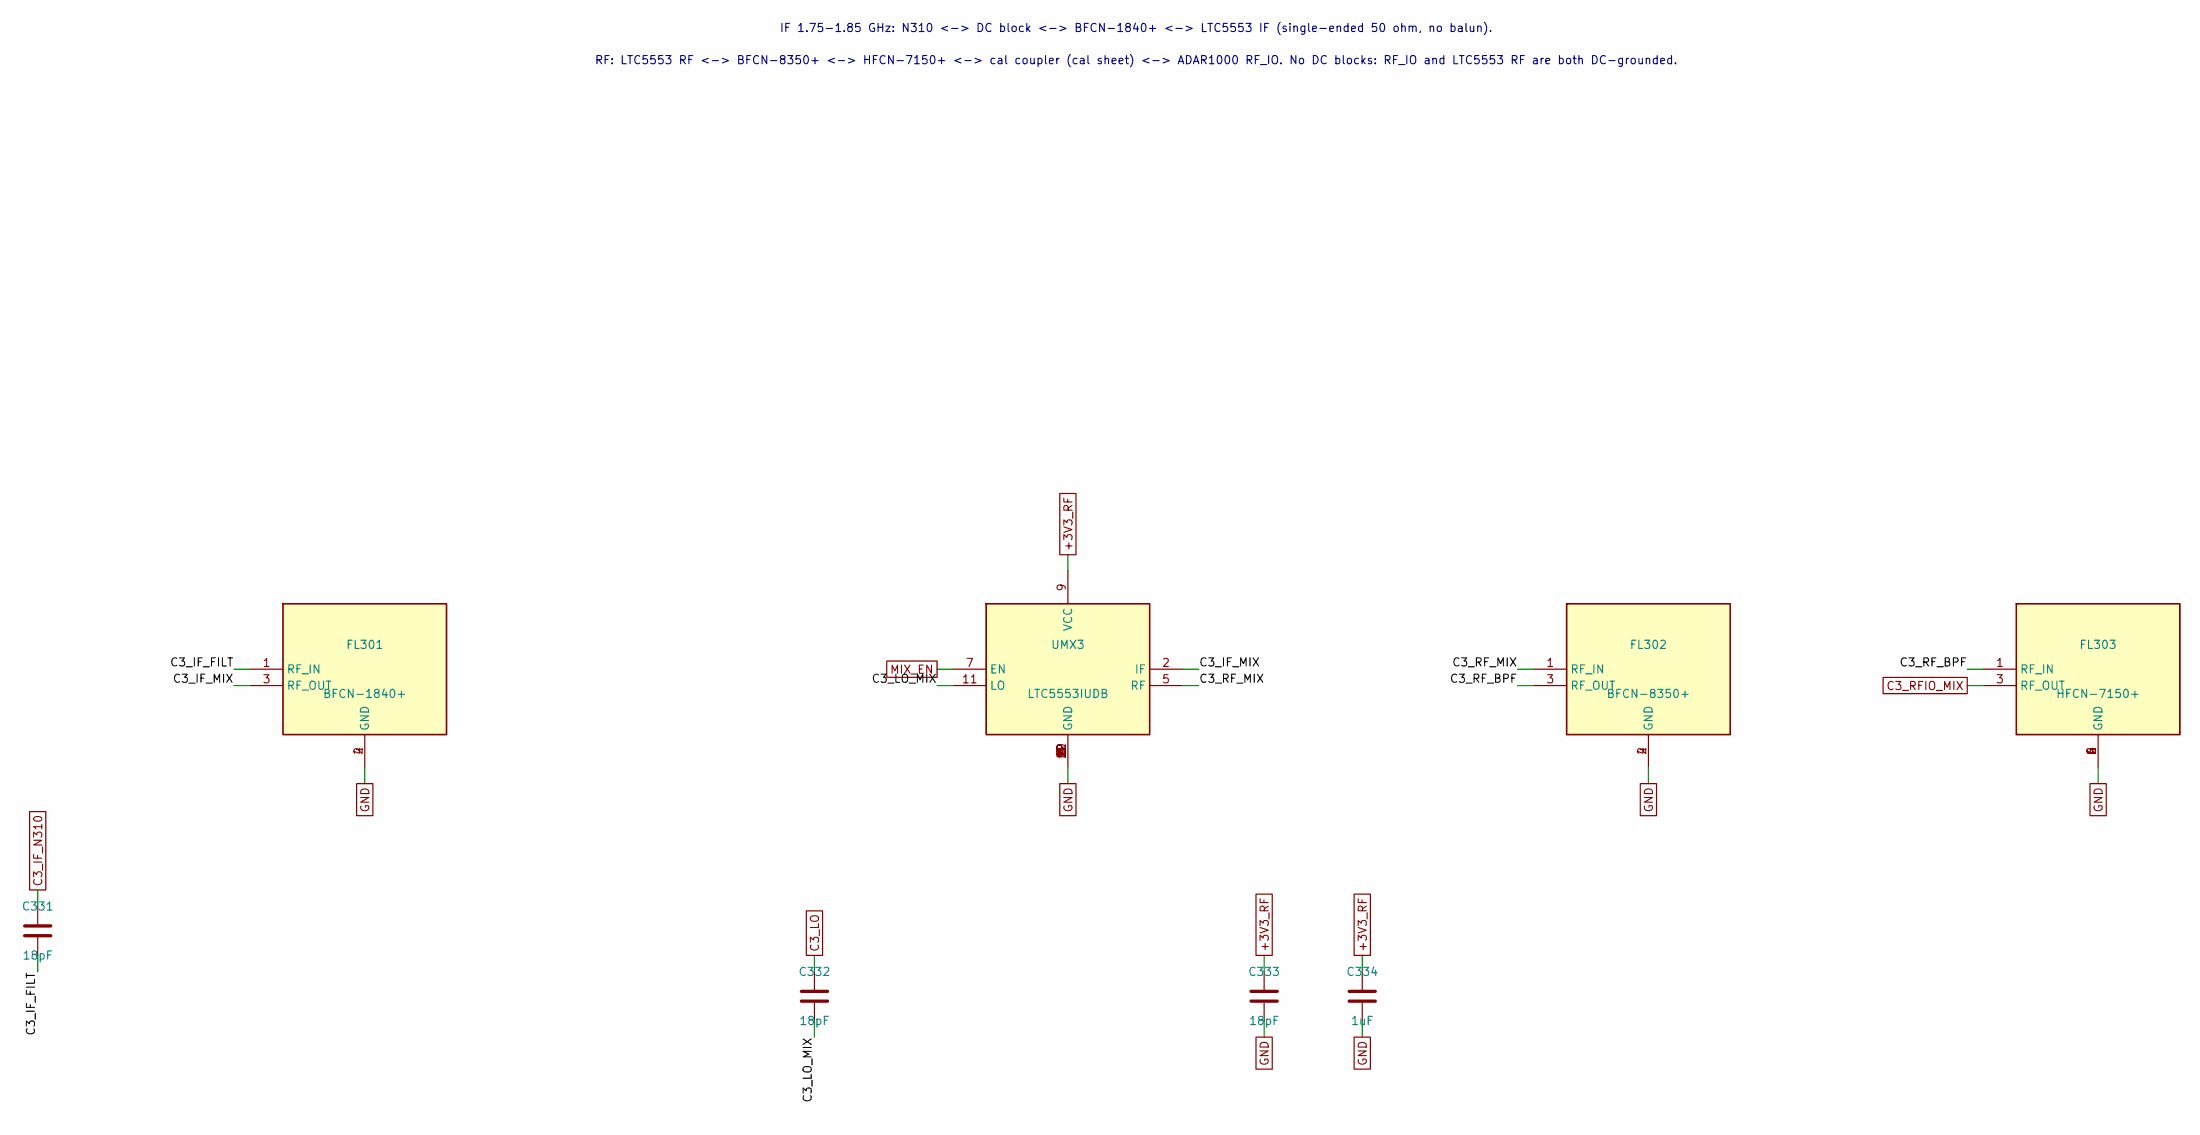
[picture p43: schematic conv3.kicad_sch]

Parts:
C331, C333: 18pF; C_0402_1005Metric; MPN GJM1555C1H180FB01
C332: 18pF; C_0402_1005Metric; MPN 0402ZK180GBS
C334: 1uF; C_0603_1608Metric; MPN GRM188R71A105KA61
FL301: BFCN-1840+; MPN BFCN-1840+
FL302: BFCN-8350+; MPN BFCN-8350+
FL303: HFCN-7150+; MPN HFCN-7150+
UMX3: LTC5553IUDB; MPN LTC5553IUDB#PBF

Connections:
+3V3_RF: C333.1, C334.1, UMX3.9 (VCC)
C3_IF_FILT: C331.2, FL301.1 (RF_IN)
C3_IF_MIX: FL301.3 (RF_OUT), UMX3.2 (IF)
C3_IF_N310: C331.1
C3_LO: C332.1
C3_LO_MIX: C332.2, UMX3.11 (LO)
C3_RFIO_MIX: FL303.3 (RF_OUT)
C3_RF_BPF: FL302.3 (RF_OUT), FL303.1 (RF_IN)
C3_RF_MIX: FL302.1 (RF_IN), UMX3.5 (RF)
GND: C333.2, C334.2, FL301.2 (GND), FL301.4 (GND), FL302.2 (GND), FL302.4 (GND), FL303.2 (GND), FL303.4 (GND), FL303.5 (GND), FL303.6 (GND), UMX3.1 (GND), UMX3.3 (GND), UMX3.4 (GND), UMX3.6 (GND), UMX3.8 (GND), UMX3.10 (GND), UMX3.12 (GND), UMX3.EP (GND)
MIX_EN: UMX3.7 (EN)

Notes on the sheet:
IF 1.75-1.85 GHz: N310 <-> DC block <-> BFCN-1840+ <-> LTC5553 IF (single-ended 50 ohm, no balun).
RF: LTC5553 RF <-> BFCN-8350+ <-> HFCN-7150+ <-> cal coupler (cal sheet) <-> ADAR1000 RF_IO. No DC blocks: RF_IO and LTC5553 RF are both DC-grounded.
