CLIS-WPI/OpenRU/hardware/h2/schematics/conv4.kicad_sch

## KiCad design hardware/h2/schematics/conv4.kicad_sch (2026-11-12)

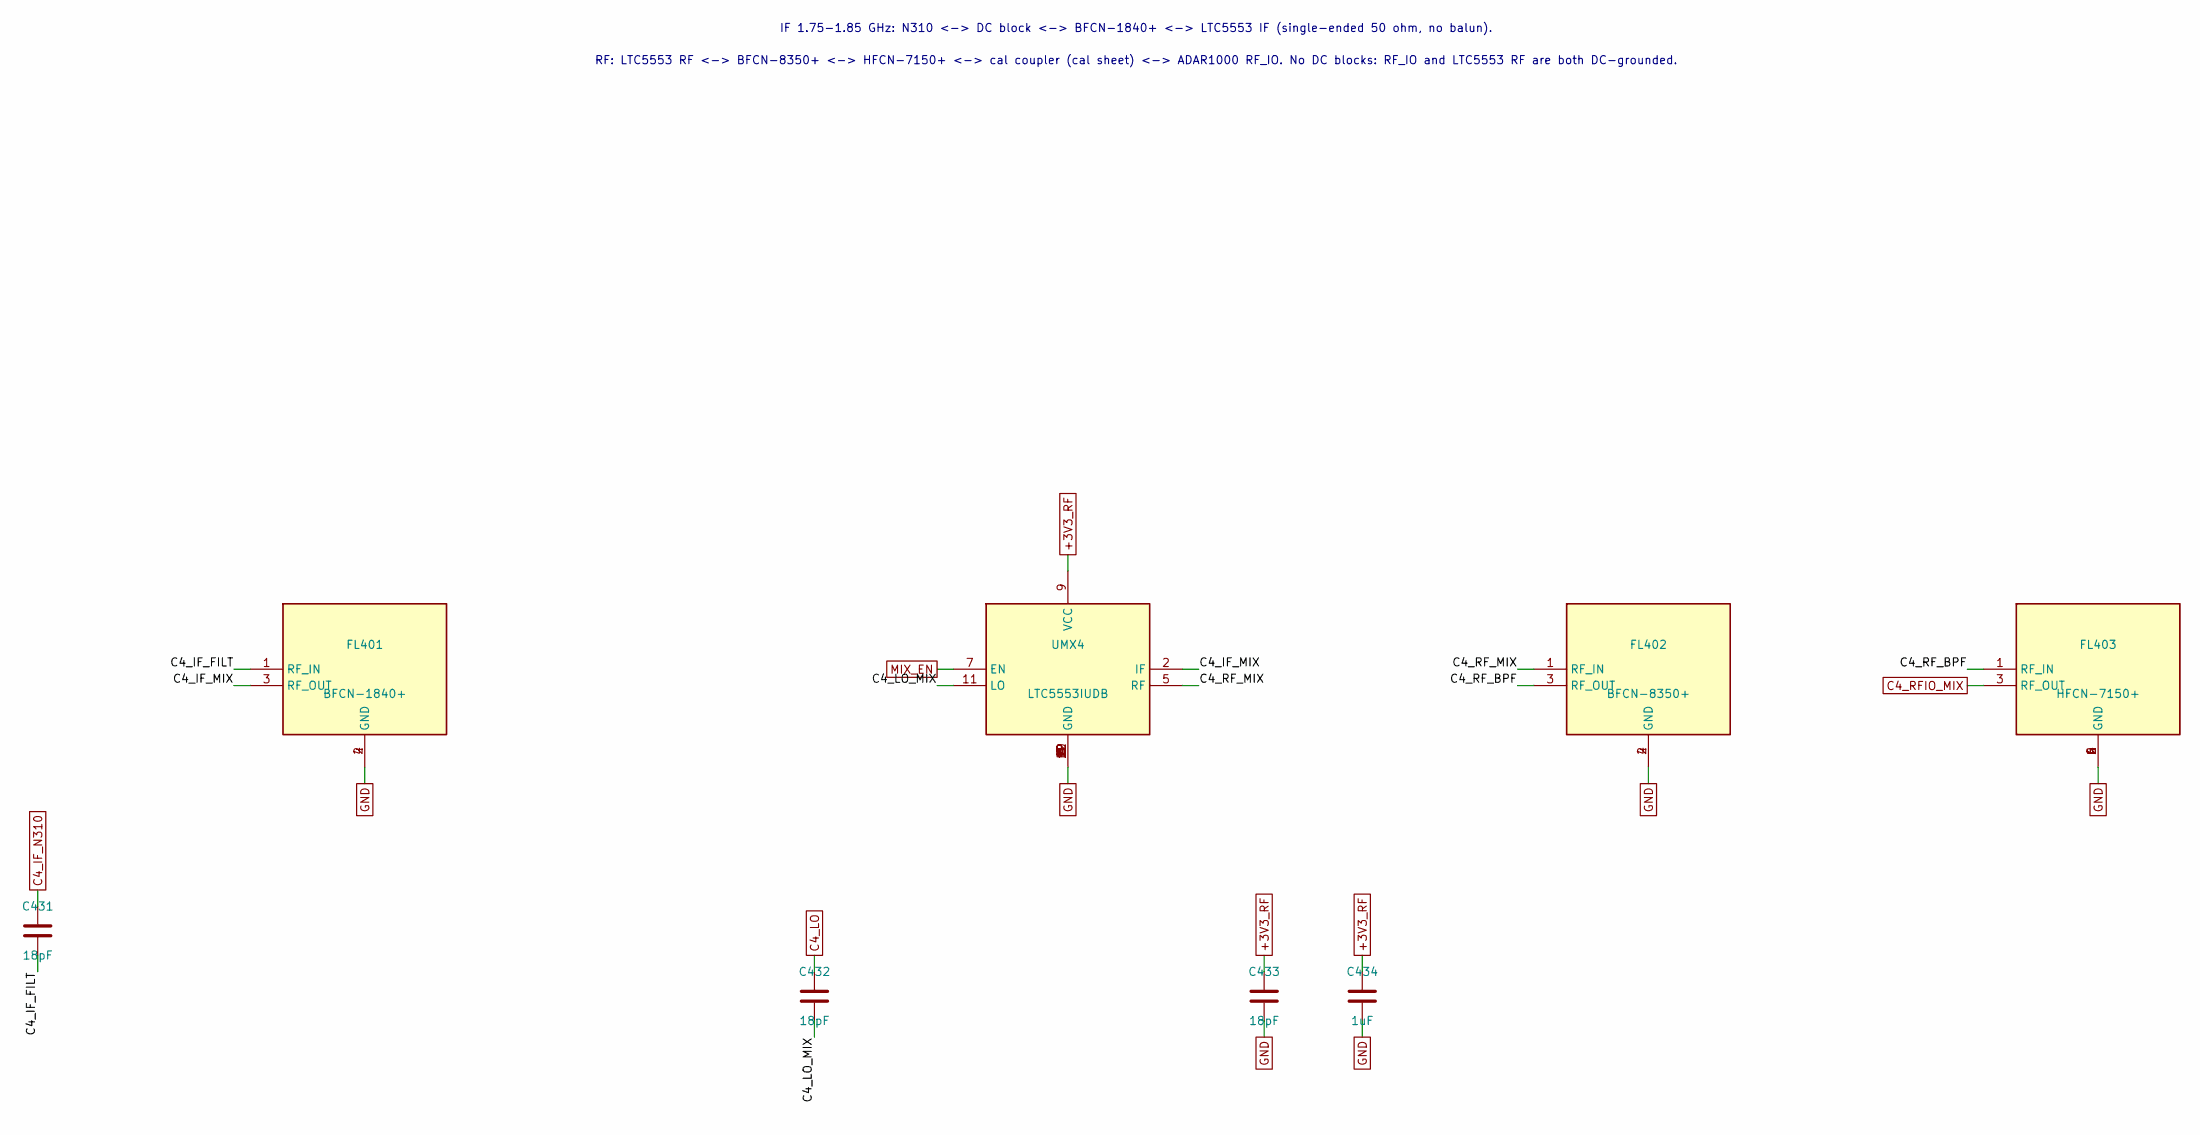
[picture p44: schematic conv4.kicad_sch]

Parts:
C431, C433: 18pF; C_0402_1005Metric; MPN GJM1555C1H180FB01
C432: 18pF; C_0402_1005Metric; MPN 0402ZK180GBS
C434: 1uF; C_0603_1608Metric; MPN GRM188R71A105KA61
FL401: BFCN-1840+; MPN BFCN-1840+
FL402: BFCN-8350+; MPN BFCN-8350+
FL403: HFCN-7150+; MPN HFCN-7150+
UMX4: LTC5553IUDB; MPN LTC5553IUDB#PBF

Connections:
+3V3_RF: C433.1, C434.1, UMX4.9 (VCC)
C4_IF_FILT: C431.2, FL401.1 (RF_IN)
C4_IF_MIX: FL401.3 (RF_OUT), UMX4.2 (IF)
C4_IF_N310: C431.1
C4_LO: C432.1
C4_LO_MIX: C432.2, UMX4.11 (LO)
C4_RFIO_MIX: FL403.3 (RF_OUT)
C4_RF_BPF: FL402.3 (RF_OUT), FL403.1 (RF_IN)
C4_RF_MIX: FL402.1 (RF_IN), UMX4.5 (RF)
GND: C433.2, C434.2, FL401.2 (GND), FL401.4 (GND), FL402.2 (GND), FL402.4 (GND), FL403.2 (GND), FL403.4 (GND), FL403.5 (GND), FL403.6 (GND), UMX4.1 (GND), UMX4.3 (GND), UMX4.4 (GND), UMX4.6 (GND), UMX4.8 (GND), UMX4.10 (GND), UMX4.12 (GND), UMX4.EP (GND)
MIX_EN: UMX4.7 (EN)

Notes on the sheet:
IF 1.75-1.85 GHz: N310 <-> DC block <-> BFCN-1840+ <-> LTC5553 IF (single-ended 50 ohm, no balun).
RF: LTC5553 RF <-> BFCN-8350+ <-> HFCN-7150+ <-> cal coupler (cal sheet) <-> ADAR1000 RF_IO. No DC blocks: RF_IO and LTC5553 RF are both DC-grounded.
