CLIS-WPI/OpenRU/hardware/h2/schematics/fe1.kicad_sch

## KiCad design hardware/h2/schematics/fe1.kicad_sch (2026-11-12)

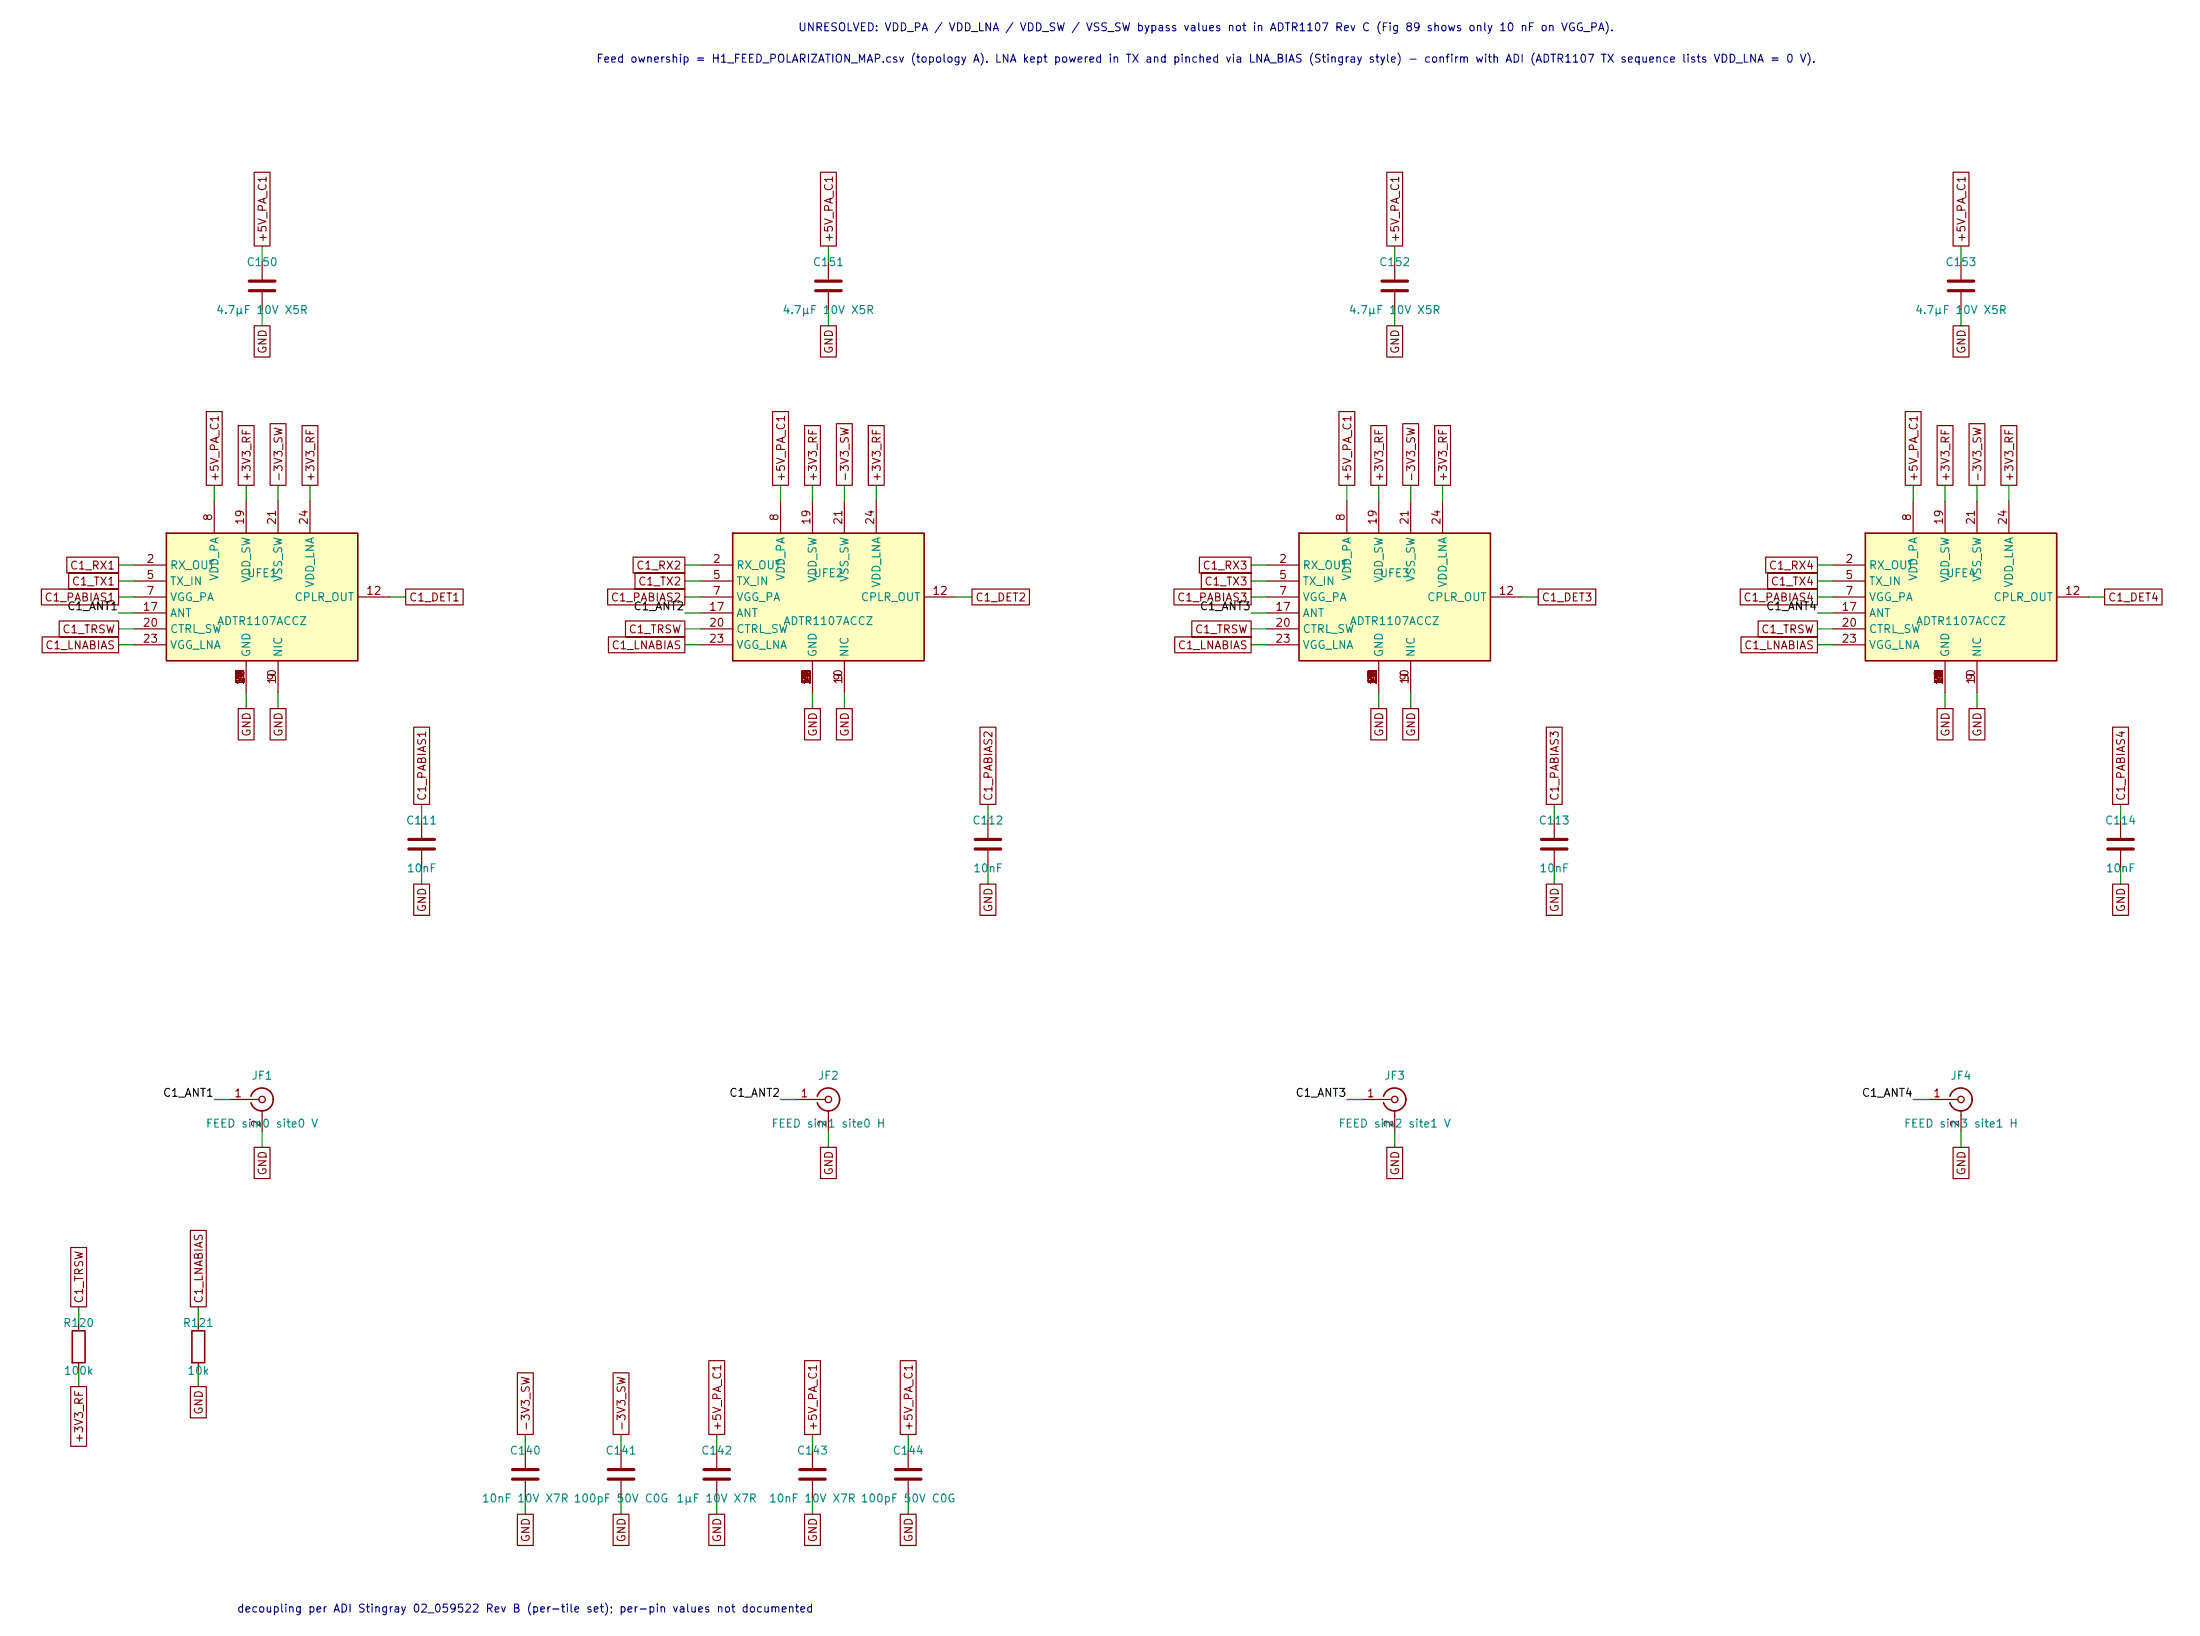
[picture p45: schematic fe1.kicad_sch]

Parts:
C111, C112, C113, C114: 10nF; C_0402_1005Metric
C140, C143: 10nF 10V X7R; C_0402_1005Metric
C141, C144: 100pF 50V C0G; C_0402_1005Metric
C142: 1µF 10V X7R; C_0402_1005Metric
C150, C151, C152, C153: 4.7µF 10V X5R; C_0402_1005Metric
JF1: FEED sim0 site0 V
JF2: FEED sim1 site0 H
JF3: FEED sim2 site1 V
JF4: FEED sim3 site1 H
R120: 100k; R_0402_1005Metric
R121: 10k; R_0402_1005Metric
UFE1, UFE2, UFE3, UFE4: ADTR1107ACCZ; MPN ADTR1107ACCZ

Connections:
+3V3_RF: R120.2, UFE1.19 (VDD_SW), UFE1.24 (VDD_LNA), UFE2.19 (VDD_SW), UFE2.24 (VDD_LNA), UFE3.19 (VDD_SW), UFE3.24 (VDD_LNA), UFE4.19 (VDD_SW), UFE4.24 (VDD_LNA)
+5V_PA_C1: C142.1, C143.1, C144.1, C150.1, C151.1, C152.1, C153.1, UFE1.8 (VDD_PA), UFE2.8 (VDD_PA), UFE3.8 (VDD_PA), UFE4.8 (VDD_PA)
-3V3_SW: C140.1, C141.1, UFE1.21 (VSS_SW), UFE2.21 (VSS_SW), UFE3.21 (VSS_SW), UFE4.21 (VSS_SW)
C1_ANT1: JF1.1 (In), UFE1.17 (ANT)
C1_ANT2: JF2.1 (In), UFE2.17 (ANT)
C1_ANT3: JF3.1 (In), UFE3.17 (ANT)
C1_ANT4: JF4.1 (In), UFE4.17 (ANT)
C1_DET1: UFE1.12 (CPLR_OUT)
C1_DET2: UFE2.12 (CPLR_OUT)
C1_DET3: UFE3.12 (CPLR_OUT)
C1_DET4: UFE4.12 (CPLR_OUT)
C1_LNABIAS: R121.1, UFE1.23 (VGG_LNA), UFE2.23 (VGG_LNA), UFE3.23 (VGG_LNA), UFE4.23 (VGG_LNA)
C1_PABIAS1: C111.1, UFE1.7 (VGG_PA)
C1_PABIAS2: C112.1, UFE2.7 (VGG_PA)
C1_PABIAS3: C113.1, UFE3.7 (VGG_PA)
C1_PABIAS4: C114.1, UFE4.7 (VGG_PA)
C1_RX1: UFE1.2 (RX_OUT)
C1_RX2: UFE2.2 (RX_OUT)
C1_RX3: UFE3.2 (RX_OUT)
C1_RX4: UFE4.2 (RX_OUT)
C1_TRSW: R120.1, UFE1.20 (CTRL_SW), UFE2.20 (CTRL_SW), UFE3.20 (CTRL_SW), UFE4.20 (CTRL_SW)
C1_TX1: UFE1.5 (TX_IN)
C1_TX2: UFE2.5 (TX_IN)
C1_TX3: UFE3.5 (TX_IN)
C1_TX4: UFE4.5 (TX_IN)
GND: C111.2, C112.2, C113.2, C114.2, C140.2, C141.2, C142.2, C143.2, C144.2, C150.2, C151.2, C152.2, C153.2, JF1.2 (Ext), JF2.2 (Ext), JF3.2 (Ext), JF4.2 (Ext), R121.2, UFE1.1 (GND), UFE1.3 (GND), UFE1.4 (GND), UFE1.6 (GND), UFE1.9 (NIC), UFE1.10 (NIC), UFE1.11 (GND), UFE1.13 (GND), UFE1.14 (GND), UFE1.15 (GND), UFE1.16 (GND), UFE1.18 (GND), UFE1.22 (GND), UFE1.EP (GND), UFE2.1 (GND), UFE2.3 (GND), UFE2.4 (GND), UFE2.6 (GND), UFE2.9 (NIC), UFE2.10 (NIC), UFE2.11 (GND), UFE2.13 (GND), UFE2.14 (GND), UFE2.15 (GND), UFE2.16 (GND), UFE2.18 (GND), UFE2.22 (GND), UFE2.EP (GND), UFE3.1 (GND), UFE3.3 (GND), UFE3.4 (GND), UFE3.6 (GND), UFE3.9 (NIC), UFE3.10 (NIC), UFE3.11 (GND), UFE3.13 (GND), UFE3.14 (GND), UFE3.15 (GND), UFE3.16 (GND), UFE3.18 (GND), UFE3.22 (GND), UFE3.EP (GND), UFE4.1 (GND), UFE4.3 (GND), UFE4.4 (GND), UFE4.6 (GND), UFE4.9 (NIC), UFE4.10 (NIC), UFE4.11 (GND), UFE4.13 (GND), UFE4.14 (GND), UFE4.15 (GND), UFE4.16 (GND), UFE4.18 (GND), UFE4.22 (GND), UFE4.EP (GND)

Notes on the sheet:
UNRESOLVED: VDD_PA / VDD_LNA / VDD_SW / VSS_SW bypass values not in ADTR1107 Rev C (Fig 89 shows only 10 nF on VGG_PA).
Feed ownership = H1_FEED_POLARIZATION_MAP.csv (topology A). LNA kept powered in TX and pinched via LNA_BIAS (Stingray style) - confirm with ADI (ADTR1107 TX sequence lists VDD_LNA = 0 V).
decoupling per ADI Stingray 02_059522 Rev B (per-tile set); per-pin values not documented
