CLIS-WPI/OpenRU/hardware/h2/schematics/fe2.kicad_sch

## KiCad design hardware/h2/schematics/fe2.kicad_sch (2026-11-12)

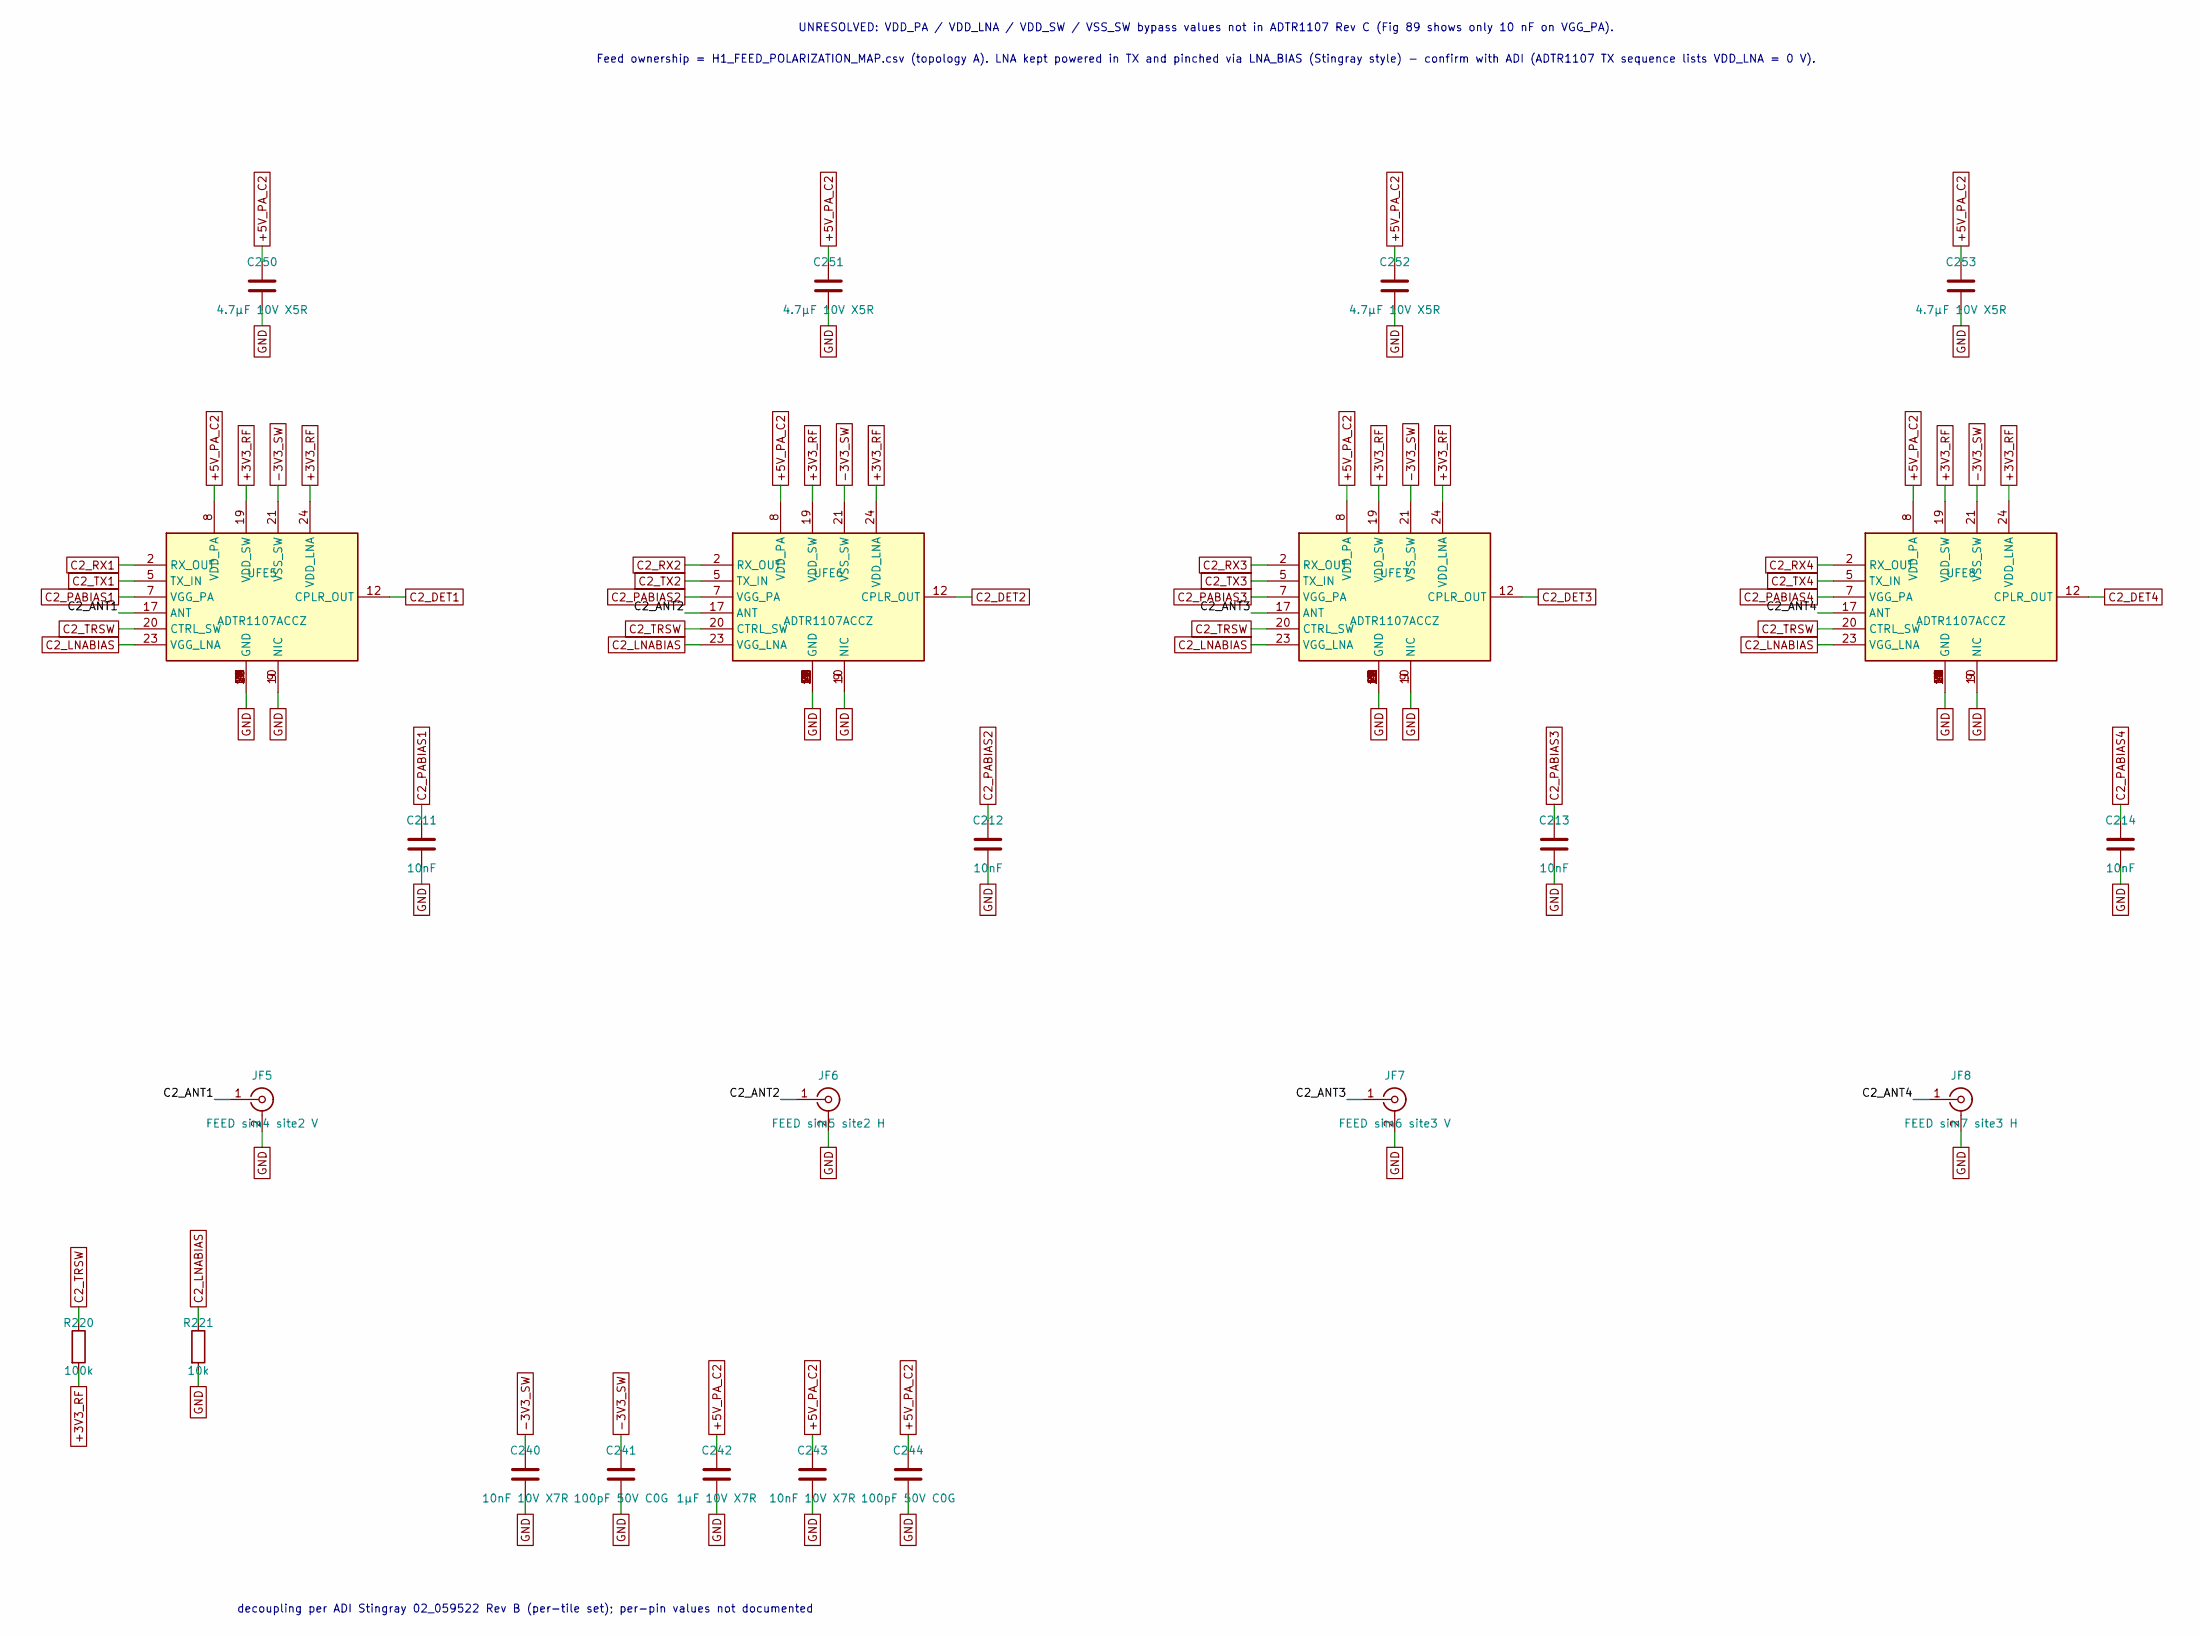
[picture p46: schematic fe2.kicad_sch]

Parts:
C211, C212, C213, C214: 10nF; C_0402_1005Metric
C240, C243: 10nF 10V X7R; C_0402_1005Metric
C241, C244: 100pF 50V C0G; C_0402_1005Metric
C242: 1µF 10V X7R; C_0402_1005Metric
C250, C251, C252, C253: 4.7µF 10V X5R; C_0402_1005Metric
JF5: FEED sim4 site2 V
JF6: FEED sim5 site2 H
JF7: FEED sim6 site3 V
JF8: FEED sim7 site3 H
R220: 100k; R_0402_1005Metric
R221: 10k; R_0402_1005Metric
UFE5, UFE6, UFE7, UFE8: ADTR1107ACCZ; MPN ADTR1107ACCZ

Connections:
+3V3_RF: R220.2, UFE5.19 (VDD_SW), UFE5.24 (VDD_LNA), UFE6.19 (VDD_SW), UFE6.24 (VDD_LNA), UFE7.19 (VDD_SW), UFE7.24 (VDD_LNA), UFE8.19 (VDD_SW), UFE8.24 (VDD_LNA)
+5V_PA_C2: C242.1, C243.1, C244.1, C250.1, C251.1, C252.1, C253.1, UFE5.8 (VDD_PA), UFE6.8 (VDD_PA), UFE7.8 (VDD_PA), UFE8.8 (VDD_PA)
-3V3_SW: C240.1, C241.1, UFE5.21 (VSS_SW), UFE6.21 (VSS_SW), UFE7.21 (VSS_SW), UFE8.21 (VSS_SW)
C2_ANT1: JF5.1 (In), UFE5.17 (ANT)
C2_ANT2: JF6.1 (In), UFE6.17 (ANT)
C2_ANT3: JF7.1 (In), UFE7.17 (ANT)
C2_ANT4: JF8.1 (In), UFE8.17 (ANT)
C2_DET1: UFE5.12 (CPLR_OUT)
C2_DET2: UFE6.12 (CPLR_OUT)
C2_DET3: UFE7.12 (CPLR_OUT)
C2_DET4: UFE8.12 (CPLR_OUT)
C2_LNABIAS: R221.1, UFE5.23 (VGG_LNA), UFE6.23 (VGG_LNA), UFE7.23 (VGG_LNA), UFE8.23 (VGG_LNA)
C2_PABIAS1: C211.1, UFE5.7 (VGG_PA)
C2_PABIAS2: C212.1, UFE6.7 (VGG_PA)
C2_PABIAS3: C213.1, UFE7.7 (VGG_PA)
C2_PABIAS4: C214.1, UFE8.7 (VGG_PA)
C2_RX1: UFE5.2 (RX_OUT)
C2_RX2: UFE6.2 (RX_OUT)
C2_RX3: UFE7.2 (RX_OUT)
C2_RX4: UFE8.2 (RX_OUT)
C2_TRSW: R220.1, UFE5.20 (CTRL_SW), UFE6.20 (CTRL_SW), UFE7.20 (CTRL_SW), UFE8.20 (CTRL_SW)
C2_TX1: UFE5.5 (TX_IN)
C2_TX2: UFE6.5 (TX_IN)
C2_TX3: UFE7.5 (TX_IN)
C2_TX4: UFE8.5 (TX_IN)
GND: C211.2, C212.2, C213.2, C214.2, C240.2, C241.2, C242.2, C243.2, C244.2, C250.2, C251.2, C252.2, C253.2, JF5.2 (Ext), JF6.2 (Ext), JF7.2 (Ext), JF8.2 (Ext), R221.2, UFE5.1 (GND), UFE5.3 (GND), UFE5.4 (GND), UFE5.6 (GND), UFE5.9 (NIC), UFE5.10 (NIC), UFE5.11 (GND), UFE5.13 (GND), UFE5.14 (GND), UFE5.15 (GND), UFE5.16 (GND), UFE5.18 (GND), UFE5.22 (GND), UFE5.EP (GND), UFE6.1 (GND), UFE6.3 (GND), UFE6.4 (GND), UFE6.6 (GND), UFE6.9 (NIC), UFE6.10 (NIC), UFE6.11 (GND), UFE6.13 (GND), UFE6.14 (GND), UFE6.15 (GND), UFE6.16 (GND), UFE6.18 (GND), UFE6.22 (GND), UFE6.EP (GND), UFE7.1 (GND), UFE7.3 (GND), UFE7.4 (GND), UFE7.6 (GND), UFE7.9 (NIC), UFE7.10 (NIC), UFE7.11 (GND), UFE7.13 (GND), UFE7.14 (GND), UFE7.15 (GND), UFE7.16 (GND), UFE7.18 (GND), UFE7.22 (GND), UFE7.EP (GND), UFE8.1 (GND), UFE8.3 (GND), UFE8.4 (GND), UFE8.6 (GND), UFE8.9 (NIC), UFE8.10 (NIC), UFE8.11 (GND), UFE8.13 (GND), UFE8.14 (GND), UFE8.15 (GND), UFE8.16 (GND), UFE8.18 (GND), UFE8.22 (GND), UFE8.EP (GND)

Notes on the sheet:
UNRESOLVED: VDD_PA / VDD_LNA / VDD_SW / VSS_SW bypass values not in ADTR1107 Rev C (Fig 89 shows only 10 nF on VGG_PA).
Feed ownership = H1_FEED_POLARIZATION_MAP.csv (topology A). LNA kept powered in TX and pinched via LNA_BIAS (Stingray style) - confirm with ADI (ADTR1107 TX sequence lists VDD_LNA = 0 V).
decoupling per ADI Stingray 02_059522 Rev B (per-tile set); per-pin values not documented
