CLIS-WPI/OpenRU/hardware/h2/schematics/fe3.kicad_sch

## KiCad design hardware/h2/schematics/fe3.kicad_sch (2026-11-12)

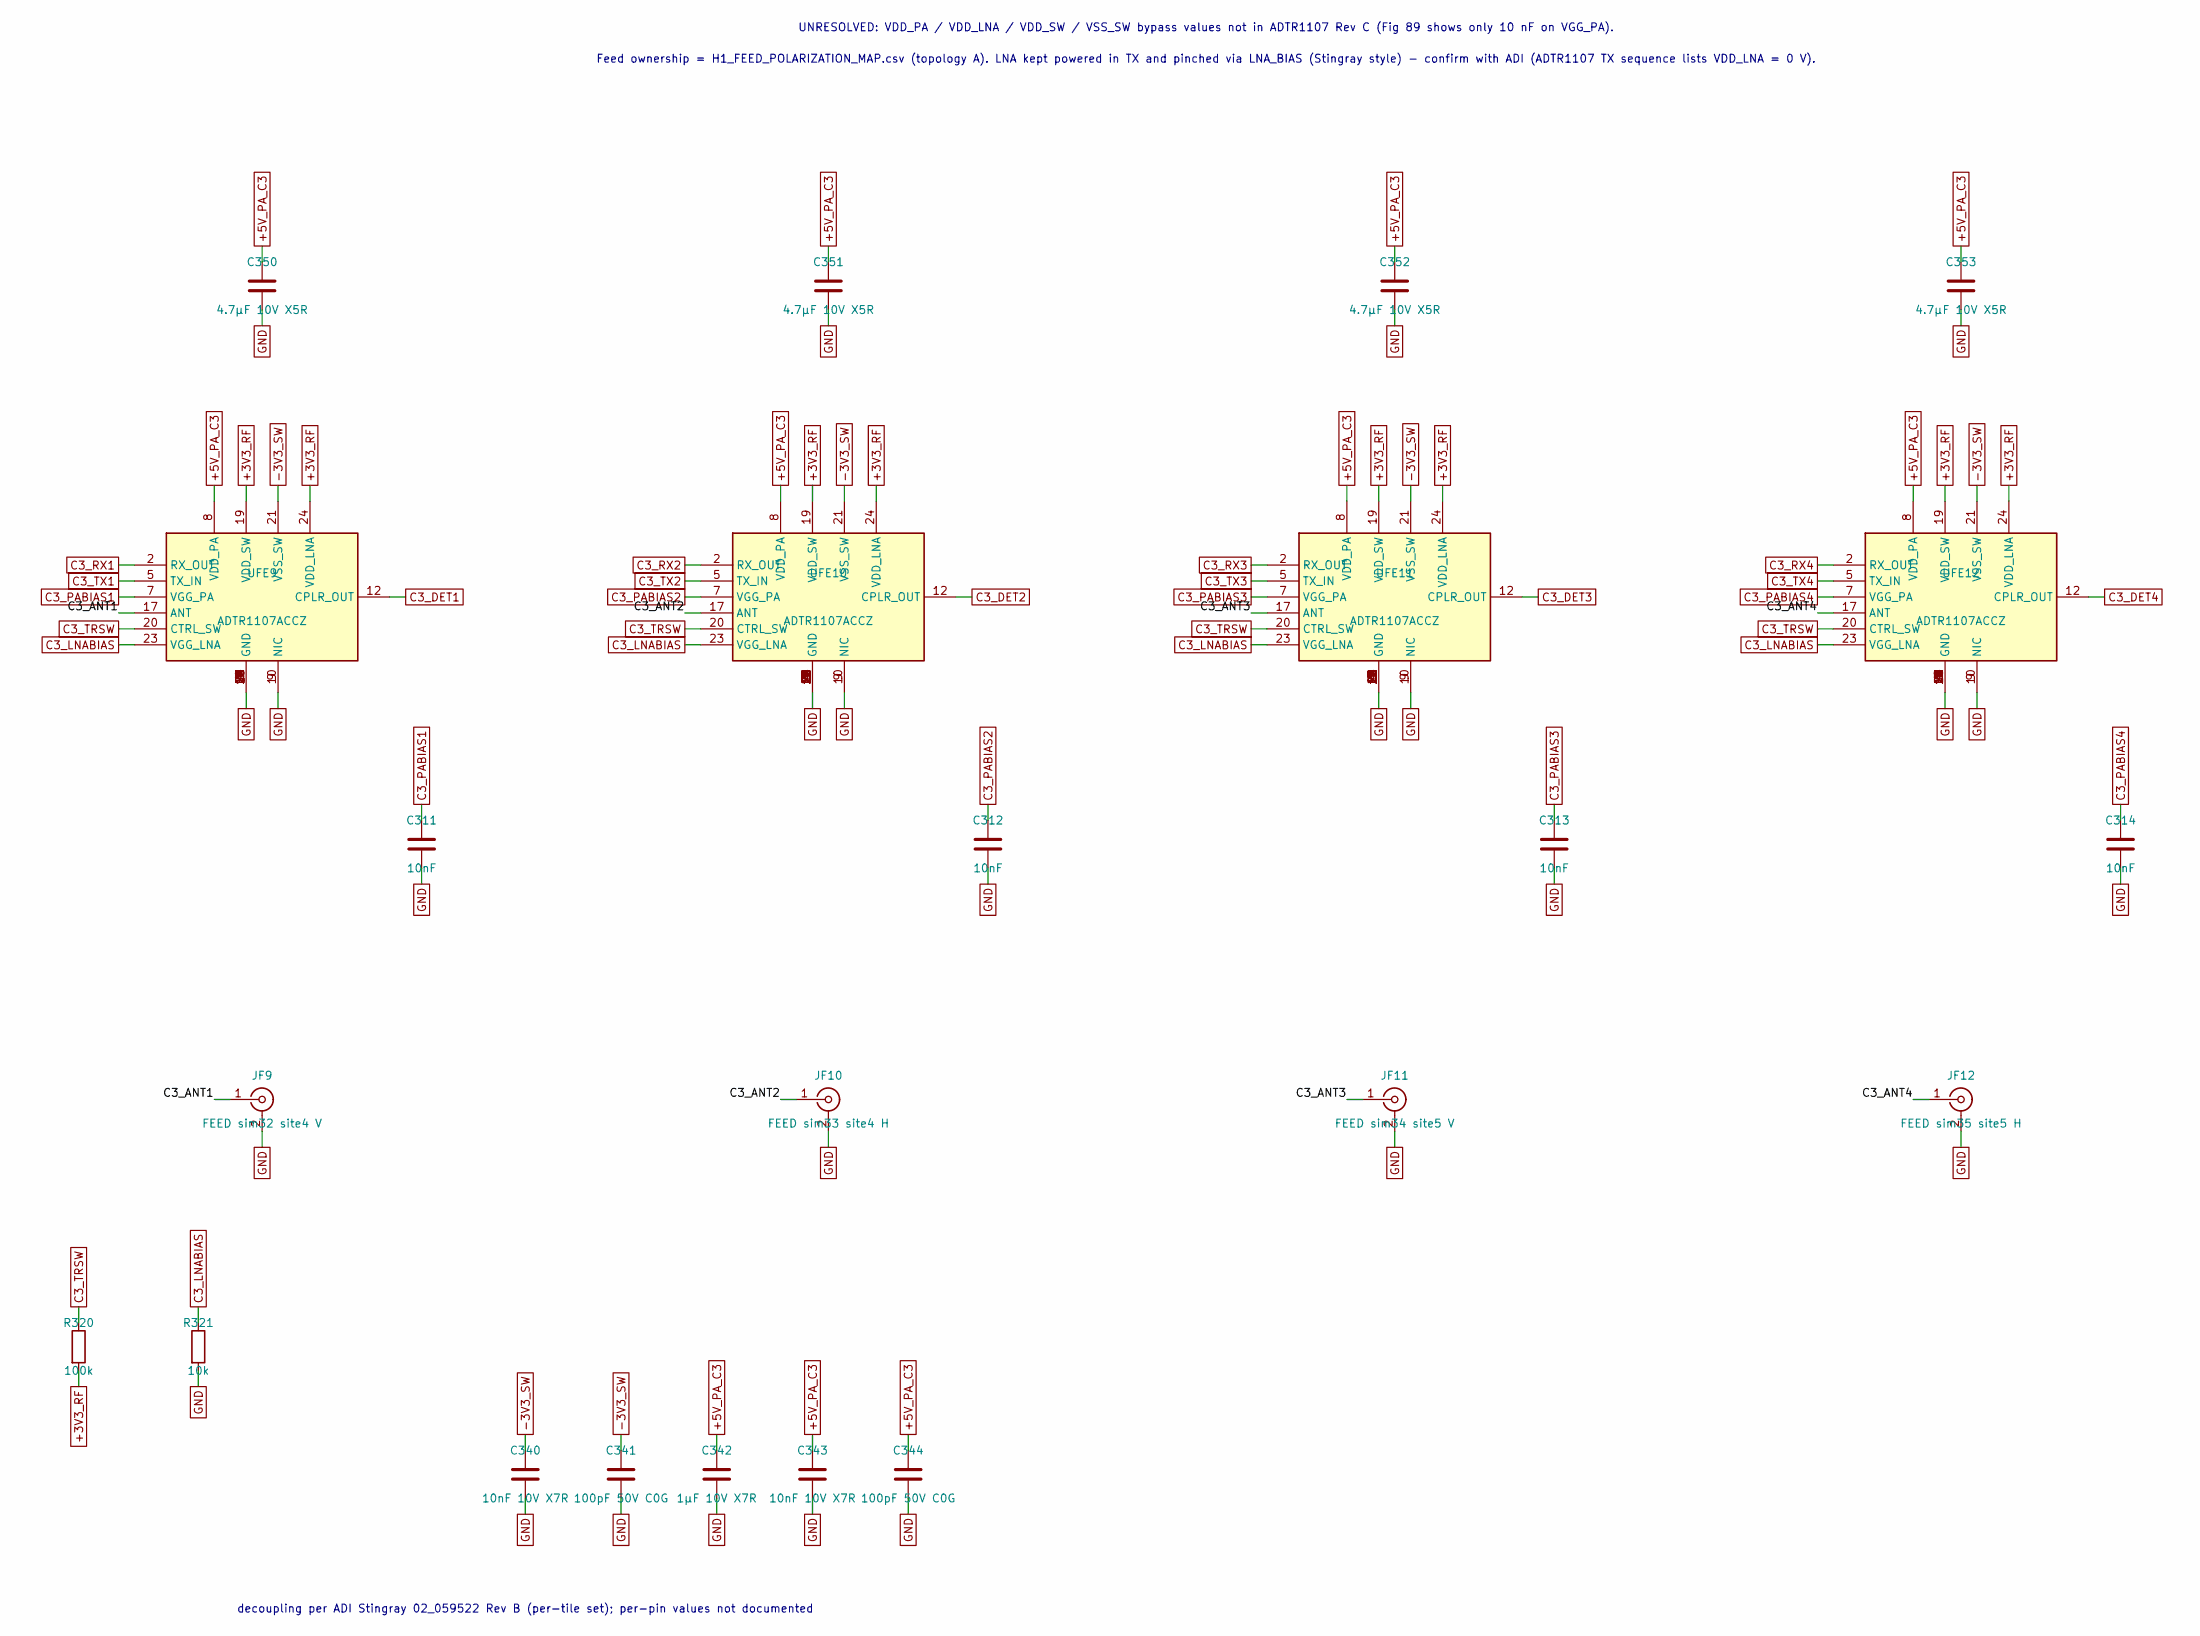
[picture p47: schematic fe3.kicad_sch]

Parts:
C311, C312, C313, C314: 10nF; C_0402_1005Metric
C340, C343: 10nF 10V X7R; C_0402_1005Metric
C341, C344: 100pF 50V C0G; C_0402_1005Metric
C342: 1µF 10V X7R; C_0402_1005Metric
C350, C351, C352, C353: 4.7µF 10V X5R; C_0402_1005Metric
JF9: FEED sim32 site4 V
JF10: FEED sim33 site4 H
JF11: FEED sim34 site5 V
JF12: FEED sim35 site5 H
R320: 100k; R_0402_1005Metric
R321: 10k; R_0402_1005Metric
UFE9, UFE10, UFE11, UFE12: ADTR1107ACCZ; MPN ADTR1107ACCZ

Connections:
+3V3_RF: R320.2, UFE9.19 (VDD_SW), UFE9.24 (VDD_LNA), UFE10.19 (VDD_SW), UFE10.24 (VDD_LNA), UFE11.19 (VDD_SW), UFE11.24 (VDD_LNA), UFE12.19 (VDD_SW), UFE12.24 (VDD_LNA)
+5V_PA_C3: C342.1, C343.1, C344.1, C350.1, C351.1, C352.1, C353.1, UFE9.8 (VDD_PA), UFE10.8 (VDD_PA), UFE11.8 (VDD_PA), UFE12.8 (VDD_PA)
-3V3_SW: C340.1, C341.1, UFE9.21 (VSS_SW), UFE10.21 (VSS_SW), UFE11.21 (VSS_SW), UFE12.21 (VSS_SW)
C3_ANT1: JF9.1 (In), UFE9.17 (ANT)
C3_ANT2: JF10.1 (In), UFE10.17 (ANT)
C3_ANT3: JF11.1 (In), UFE11.17 (ANT)
C3_ANT4: JF12.1 (In), UFE12.17 (ANT)
C3_DET1: UFE9.12 (CPLR_OUT)
C3_DET2: UFE10.12 (CPLR_OUT)
C3_DET3: UFE11.12 (CPLR_OUT)
C3_DET4: UFE12.12 (CPLR_OUT)
C3_LNABIAS: R321.1, UFE9.23 (VGG_LNA), UFE10.23 (VGG_LNA), UFE11.23 (VGG_LNA), UFE12.23 (VGG_LNA)
C3_PABIAS1: C311.1, UFE9.7 (VGG_PA)
C3_PABIAS2: C312.1, UFE10.7 (VGG_PA)
C3_PABIAS3: C313.1, UFE11.7 (VGG_PA)
C3_PABIAS4: C314.1, UFE12.7 (VGG_PA)
C3_RX1: UFE9.2 (RX_OUT)
C3_RX2: UFE10.2 (RX_OUT)
C3_RX3: UFE11.2 (RX_OUT)
C3_RX4: UFE12.2 (RX_OUT)
C3_TRSW: R320.1, UFE9.20 (CTRL_SW), UFE10.20 (CTRL_SW), UFE11.20 (CTRL_SW), UFE12.20 (CTRL_SW)
C3_TX1: UFE9.5 (TX_IN)
C3_TX2: UFE10.5 (TX_IN)
C3_TX3: UFE11.5 (TX_IN)
C3_TX4: UFE12.5 (TX_IN)
GND: C311.2, C312.2, C313.2, C314.2, C340.2, C341.2, C342.2, C343.2, C344.2, C350.2, C351.2, C352.2, C353.2, JF9.2 (Ext), JF10.2 (Ext), JF11.2 (Ext), JF12.2 (Ext), R321.2, UFE9.1 (GND), UFE9.3 (GND), UFE9.4 (GND), UFE9.6 (GND), UFE9.9 (NIC), UFE9.10 (NIC), UFE9.11 (GND), UFE9.13 (GND), UFE9.14 (GND), UFE9.15 (GND), UFE9.16 (GND), UFE9.18 (GND), UFE9.22 (GND), UFE9.EP (GND), UFE10.1 (GND), UFE10.3 (GND), UFE10.4 (GND), UFE10.6 (GND), UFE10.9 (NIC), UFE10.10 (NIC), UFE10.11 (GND), UFE10.13 (GND), UFE10.14 (GND), UFE10.15 (GND), UFE10.16 (GND), UFE10.18 (GND), UFE10.22 (GND), UFE10.EP (GND), UFE11.1 (GND), UFE11.3 (GND), UFE11.4 (GND), UFE11.6 (GND), UFE11.9 (NIC), UFE11.10 (NIC), UFE11.11 (GND), UFE11.13 (GND), UFE11.14 (GND), UFE11.15 (GND), UFE11.16 (GND), UFE11.18 (GND), UFE11.22 (GND), UFE11.EP (GND), UFE12.1 (GND), UFE12.3 (GND), UFE12.4 (GND), UFE12.6 (GND), UFE12.9 (NIC), UFE12.10 (NIC), UFE12.11 (GND), UFE12.13 (GND), UFE12.14 (GND), UFE12.15 (GND), UFE12.16 (GND), UFE12.18 (GND), UFE12.22 (GND), UFE12.EP (GND)

Notes on the sheet:
UNRESOLVED: VDD_PA / VDD_LNA / VDD_SW / VSS_SW bypass values not in ADTR1107 Rev C (Fig 89 shows only 10 nF on VGG_PA).
Feed ownership = H1_FEED_POLARIZATION_MAP.csv (topology A). LNA kept powered in TX and pinched via LNA_BIAS (Stingray style) - confirm with ADI (ADTR1107 TX sequence lists VDD_LNA = 0 V).
decoupling per ADI Stingray 02_059522 Rev B (per-tile set); per-pin values not documented
