CLIS-WPI/OpenRU/hardware/h2/schematics/fe4.kicad_sch

## KiCad design hardware/h2/schematics/fe4.kicad_sch (2026-11-12)

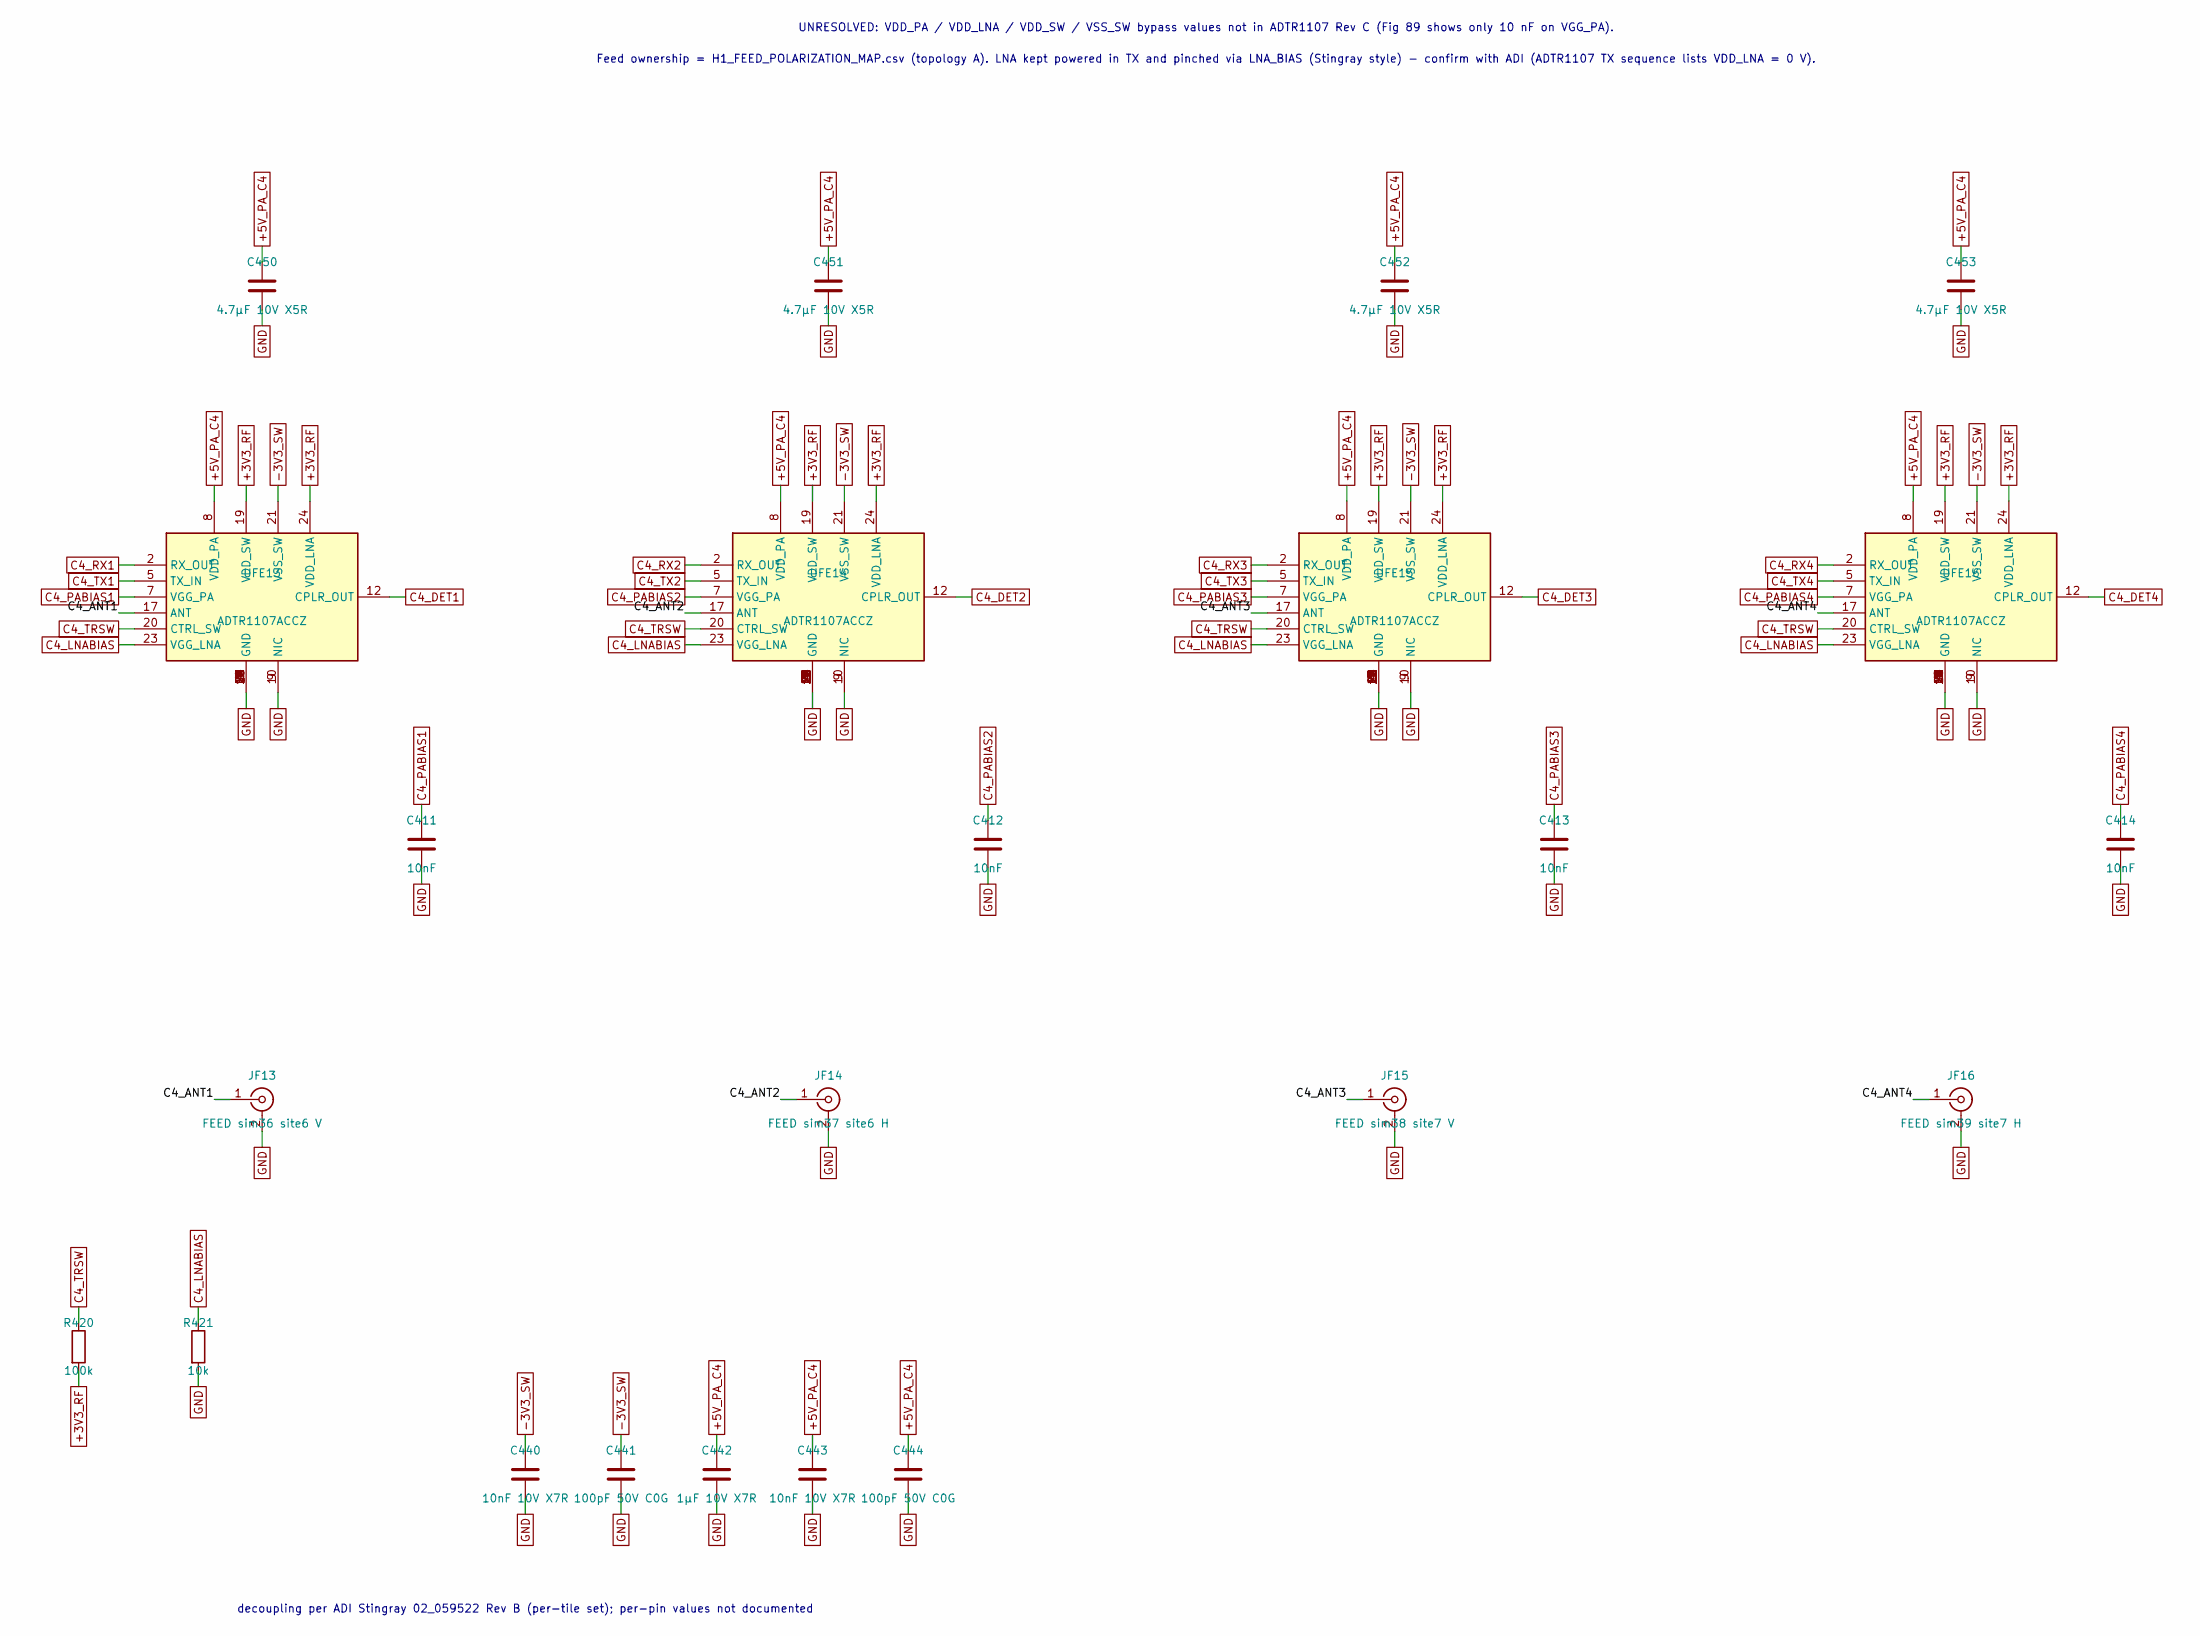
[picture p48: schematic fe4.kicad_sch]

Parts:
C411, C412, C413, C414: 10nF; C_0402_1005Metric
C440, C443: 10nF 10V X7R; C_0402_1005Metric
C441, C444: 100pF 50V C0G; C_0402_1005Metric
C442: 1µF 10V X7R; C_0402_1005Metric
C450, C451, C452, C453: 4.7µF 10V X5R; C_0402_1005Metric
JF13: FEED sim36 site6 V
JF14: FEED sim37 site6 H
JF15: FEED sim38 site7 V
JF16: FEED sim39 site7 H
R420: 100k; R_0402_1005Metric
R421: 10k; R_0402_1005Metric
UFE13, UFE14, UFE15, UFE16: ADTR1107ACCZ; MPN ADTR1107ACCZ

Connections:
+3V3_RF: R420.2, UFE13.19 (VDD_SW), UFE13.24 (VDD_LNA), UFE14.19 (VDD_SW), UFE14.24 (VDD_LNA), UFE15.19 (VDD_SW), UFE15.24 (VDD_LNA), UFE16.19 (VDD_SW), UFE16.24 (VDD_LNA)
+5V_PA_C4: C442.1, C443.1, C444.1, C450.1, C451.1, C452.1, C453.1, UFE13.8 (VDD_PA), UFE14.8 (VDD_PA), UFE15.8 (VDD_PA), UFE16.8 (VDD_PA)
-3V3_SW: C440.1, C441.1, UFE13.21 (VSS_SW), UFE14.21 (VSS_SW), UFE15.21 (VSS_SW), UFE16.21 (VSS_SW)
C4_ANT1: JF13.1 (In), UFE13.17 (ANT)
C4_ANT2: JF14.1 (In), UFE14.17 (ANT)
C4_ANT3: JF15.1 (In), UFE15.17 (ANT)
C4_ANT4: JF16.1 (In), UFE16.17 (ANT)
C4_DET1: UFE13.12 (CPLR_OUT)
C4_DET2: UFE14.12 (CPLR_OUT)
C4_DET3: UFE15.12 (CPLR_OUT)
C4_DET4: UFE16.12 (CPLR_OUT)
C4_LNABIAS: R421.1, UFE13.23 (VGG_LNA), UFE14.23 (VGG_LNA), UFE15.23 (VGG_LNA), UFE16.23 (VGG_LNA)
C4_PABIAS1: C411.1, UFE13.7 (VGG_PA)
C4_PABIAS2: C412.1, UFE14.7 (VGG_PA)
C4_PABIAS3: C413.1, UFE15.7 (VGG_PA)
C4_PABIAS4: C414.1, UFE16.7 (VGG_PA)
C4_RX1: UFE13.2 (RX_OUT)
C4_RX2: UFE14.2 (RX_OUT)
C4_RX3: UFE15.2 (RX_OUT)
C4_RX4: UFE16.2 (RX_OUT)
C4_TRSW: R420.1, UFE13.20 (CTRL_SW), UFE14.20 (CTRL_SW), UFE15.20 (CTRL_SW), UFE16.20 (CTRL_SW)
C4_TX1: UFE13.5 (TX_IN)
C4_TX2: UFE14.5 (TX_IN)
C4_TX3: UFE15.5 (TX_IN)
C4_TX4: UFE16.5 (TX_IN)
GND: C411.2, C412.2, C413.2, C414.2, C440.2, C441.2, C442.2, C443.2, C444.2, C450.2, C451.2, C452.2, C453.2, JF13.2 (Ext), JF14.2 (Ext), JF15.2 (Ext), JF16.2 (Ext), R421.2, UFE13.1 (GND), UFE13.3 (GND), UFE13.4 (GND), UFE13.6 (GND), UFE13.9 (NIC), UFE13.10 (NIC), UFE13.11 (GND), UFE13.13 (GND), UFE13.14 (GND), UFE13.15 (GND), UFE13.16 (GND), UFE13.18 (GND), UFE13.22 (GND), UFE13.EP (GND), UFE14.1 (GND), UFE14.3 (GND), UFE14.4 (GND), UFE14.6 (GND), UFE14.9 (NIC), UFE14.10 (NIC), UFE14.11 (GND), UFE14.13 (GND), UFE14.14 (GND), UFE14.15 (GND), UFE14.16 (GND), UFE14.18 (GND), UFE14.22 (GND), UFE14.EP (GND), UFE15.1 (GND), UFE15.3 (GND), UFE15.4 (GND), UFE15.6 (GND), UFE15.9 (NIC), UFE15.10 (NIC), UFE15.11 (GND), UFE15.13 (GND), UFE15.14 (GND), UFE15.15 (GND), UFE15.16 (GND), UFE15.18 (GND), UFE15.22 (GND), UFE15.EP (GND), UFE16.1 (GND), UFE16.3 (GND), UFE16.4 (GND), UFE16.6 (GND), UFE16.9 (NIC), UFE16.10 (NIC), UFE16.11 (GND), UFE16.13 (GND), UFE16.14 (GND), UFE16.15 (GND), UFE16.16 (GND), UFE16.18 (GND), UFE16.22 (GND), UFE16.EP (GND)

Notes on the sheet:
UNRESOLVED: VDD_PA / VDD_LNA / VDD_SW / VSS_SW bypass values not in ADTR1107 Rev C (Fig 89 shows only 10 nF on VGG_PA).
Feed ownership = H1_FEED_POLARIZATION_MAP.csv (topology A). LNA kept powered in TX and pinched via LNA_BIAS (Stingray style) - confirm with ADI (ADTR1107 TX sequence lists VDD_LNA = 0 V).
decoupling per ADI Stingray 02_059522 Rev B (per-tile set); per-pin values not documented
