CLIS-WPI/OpenRU/hardware/h2/schematics/interlock.kicad_sch

## KiCad design hardware/h2/schematics/interlock.kicad_sch (2026-11-12)

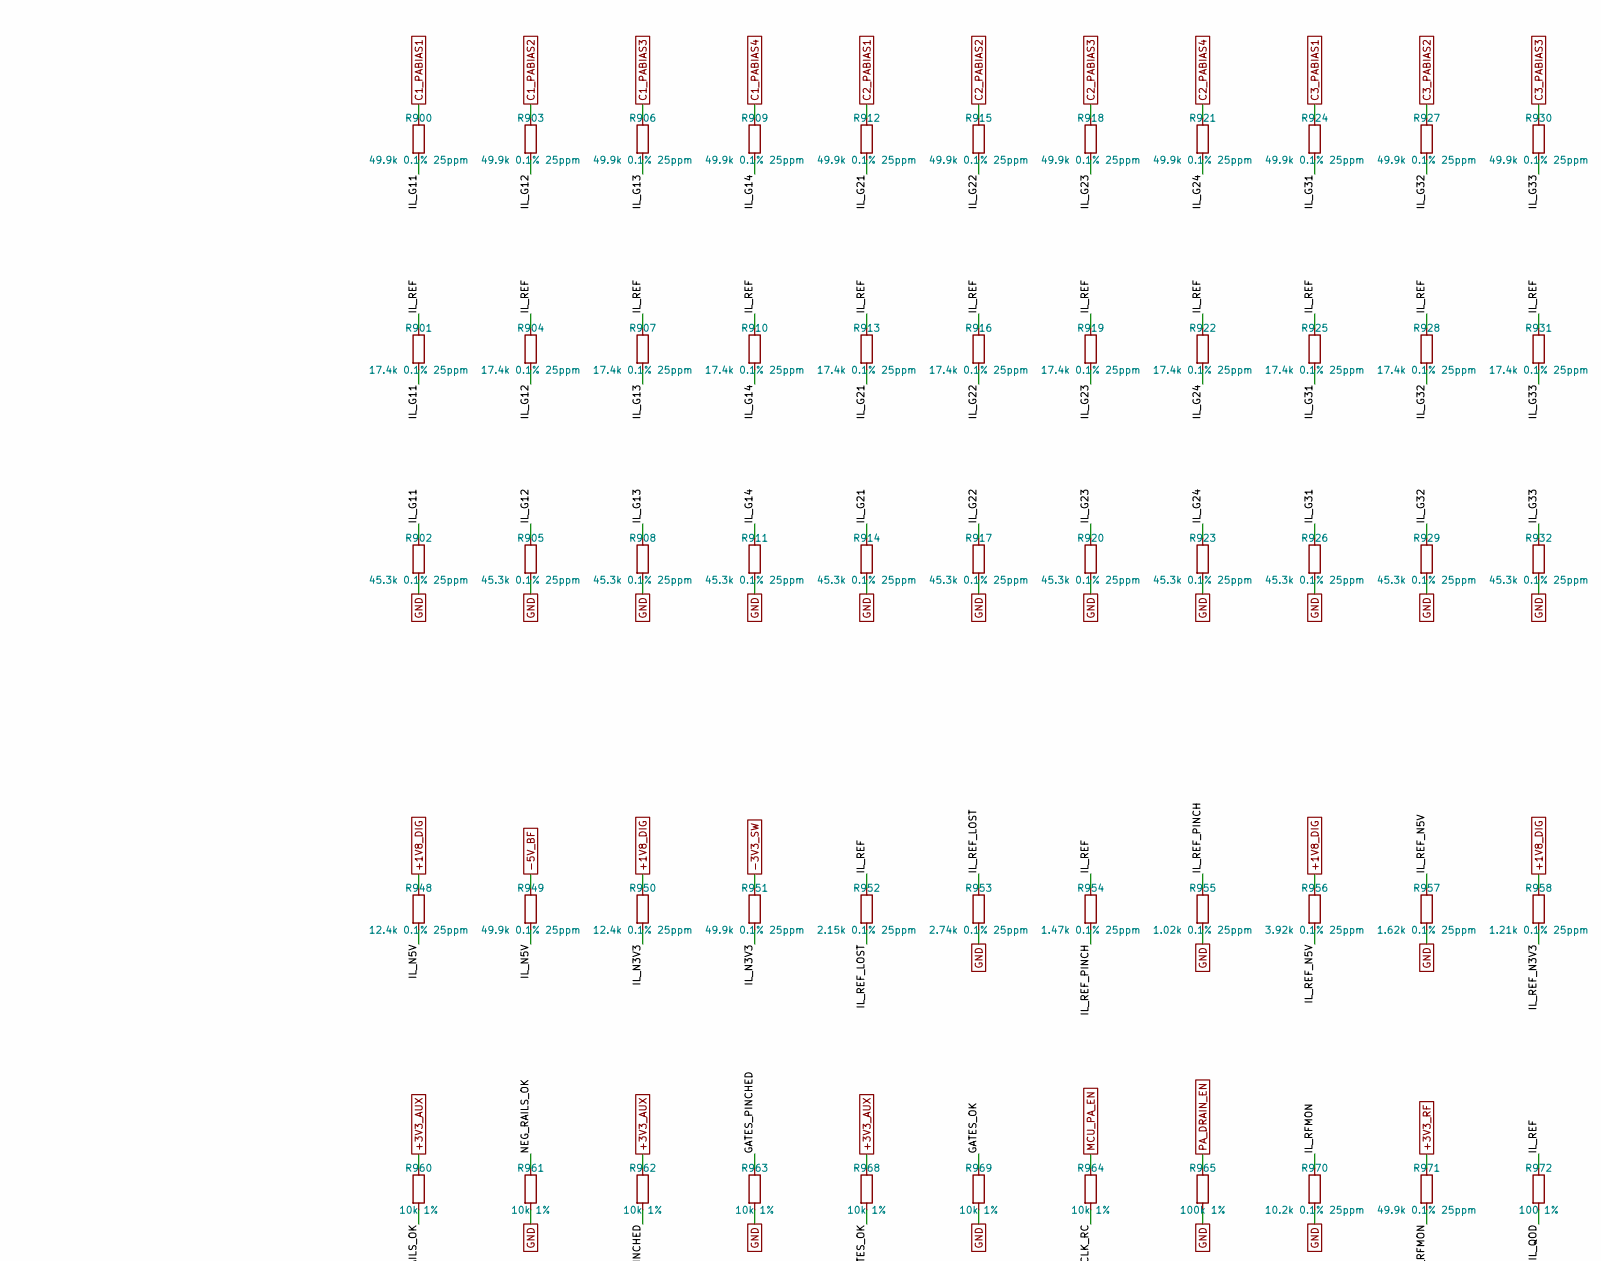
[picture p49: schematic interlock.kicad_sch, part in row 1, column 1]

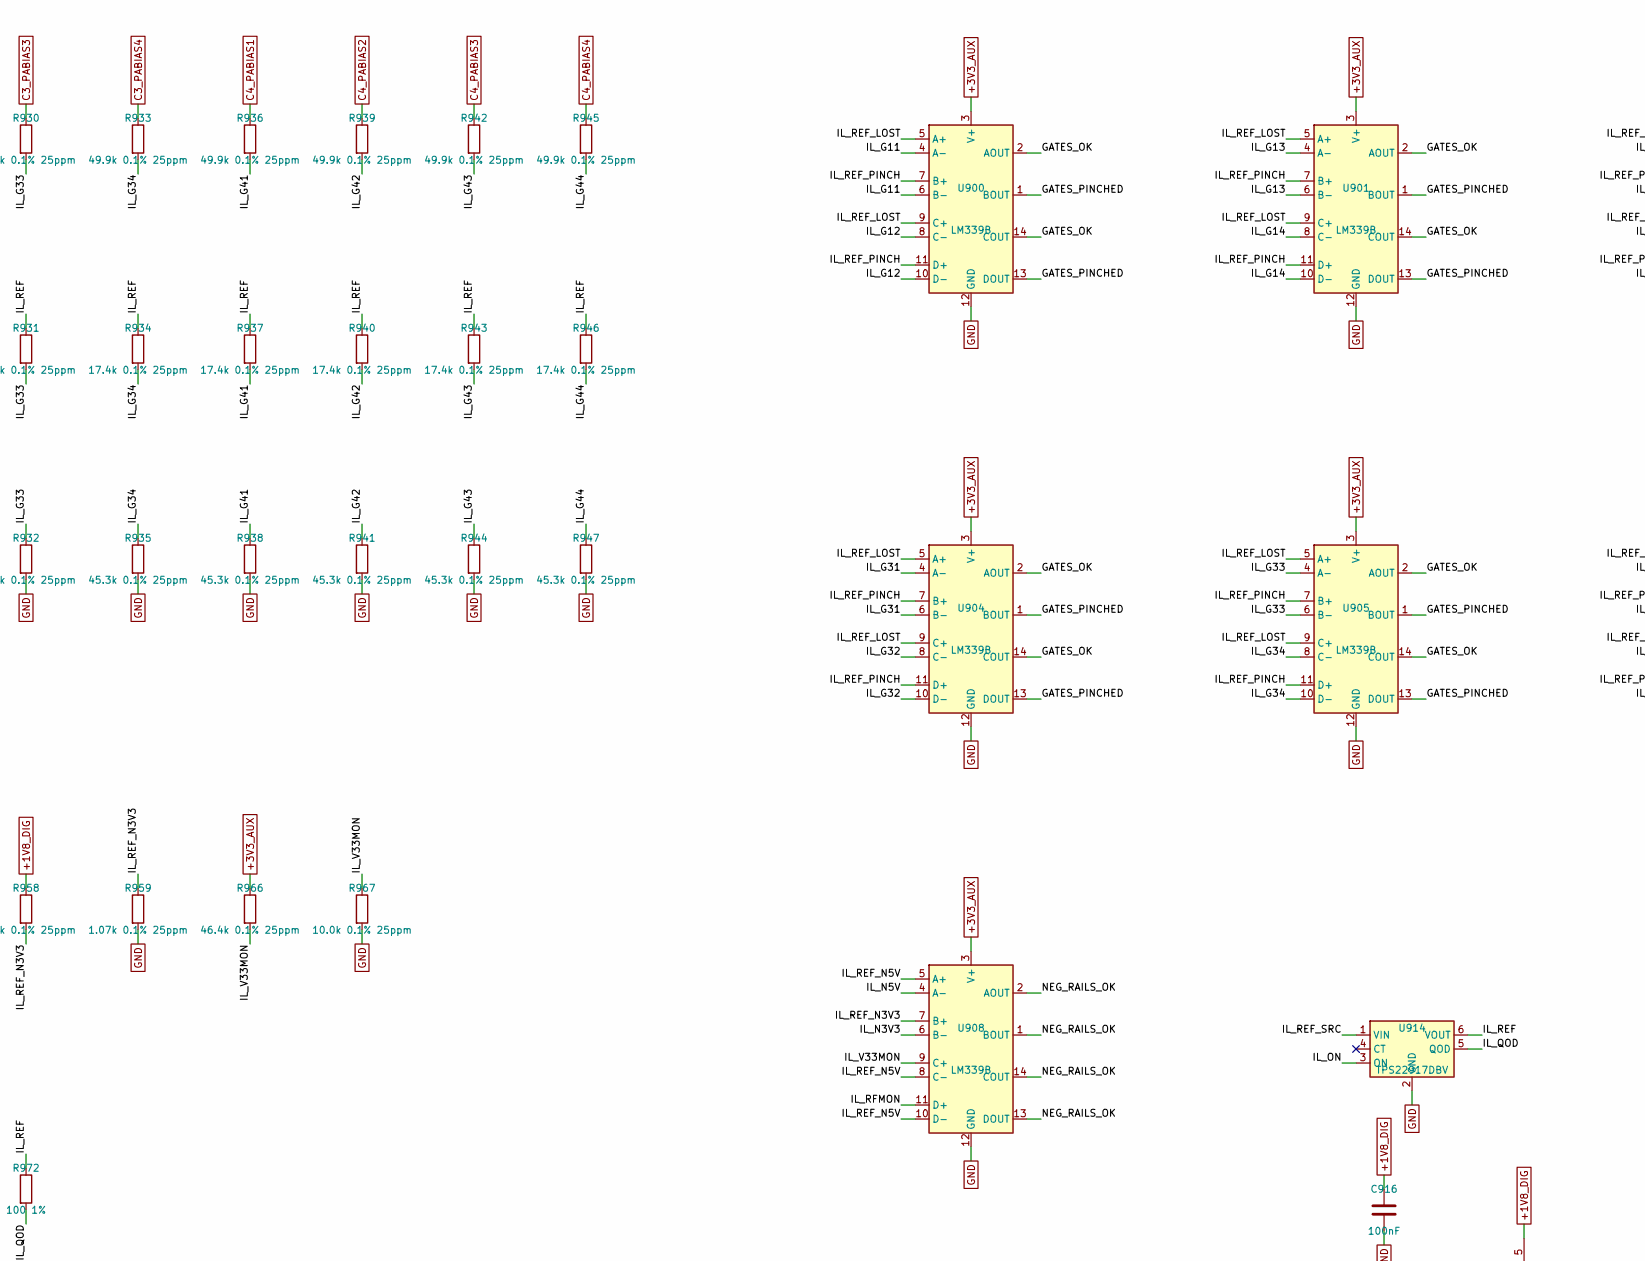
[picture p50: schematic interlock.kicad_sch, part in row 1, column 2]

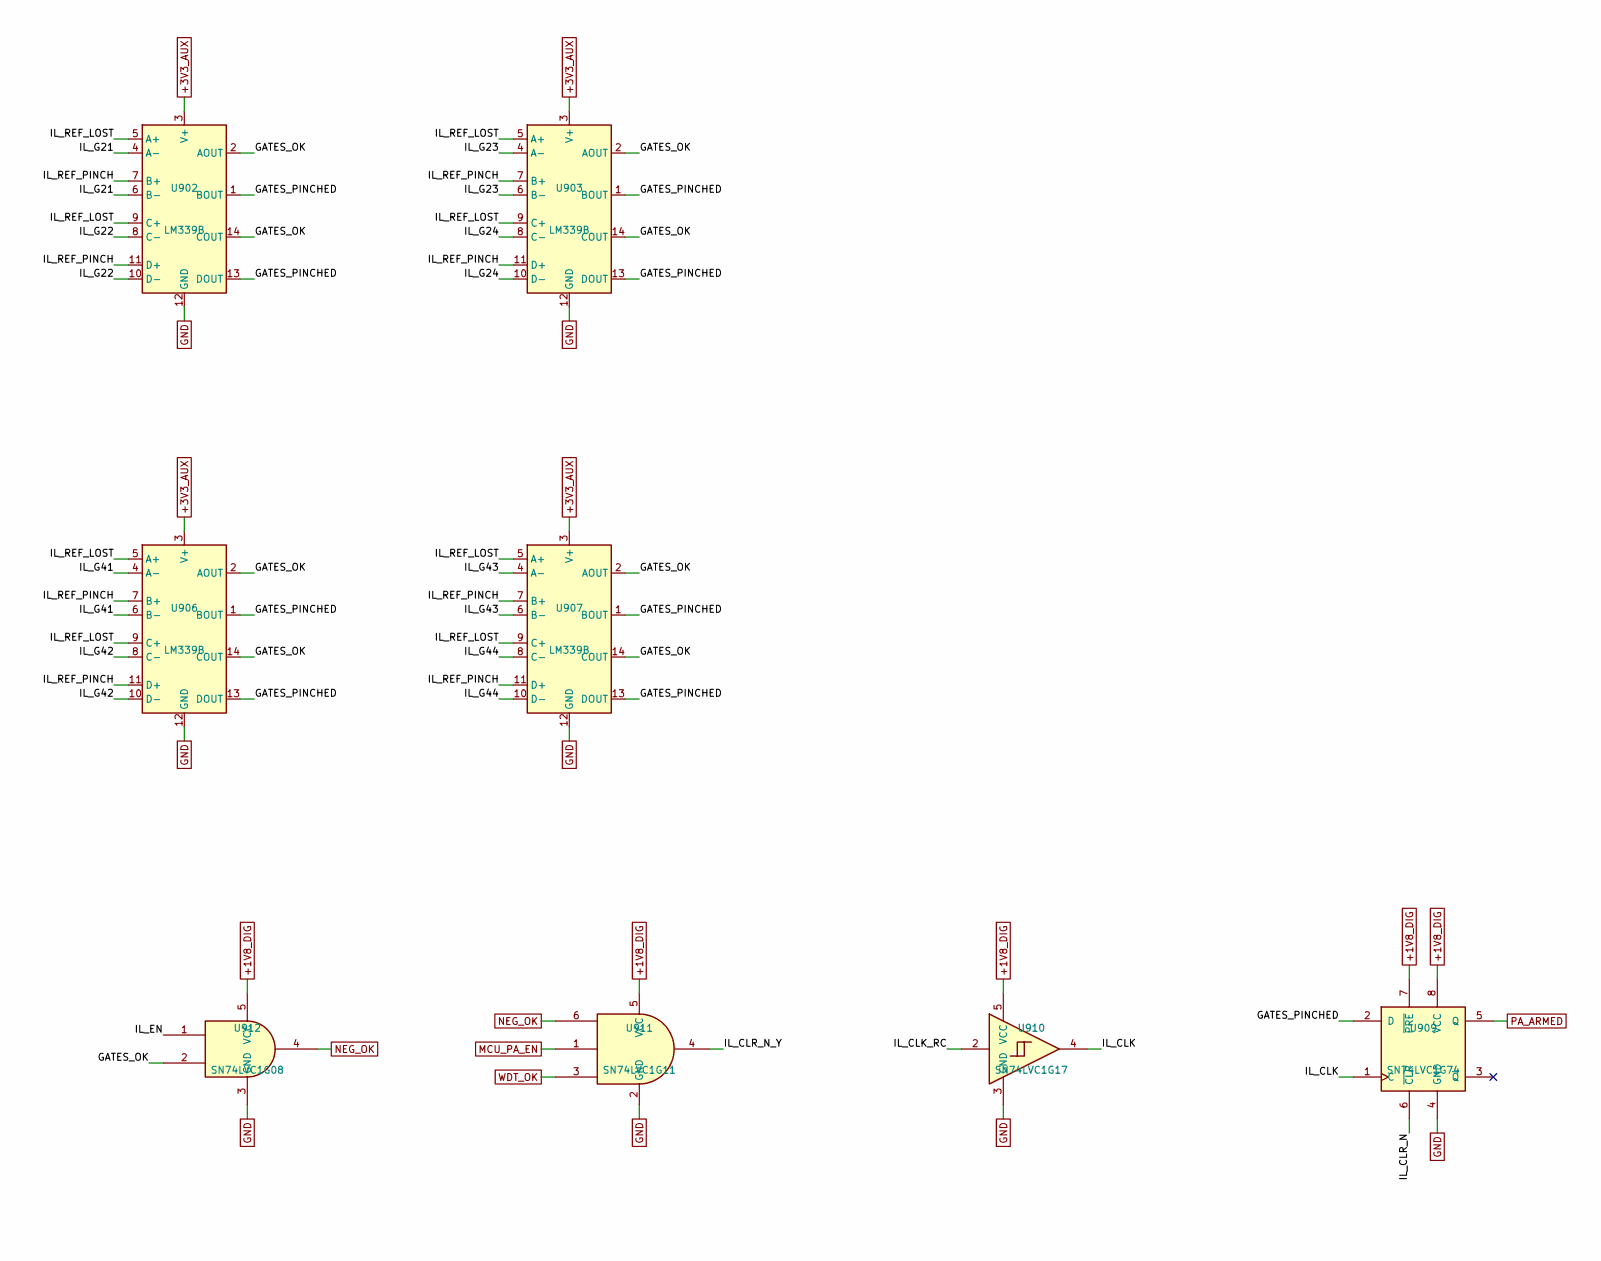
[picture p51: schematic interlock.kicad_sch, part in row 1, column 3]

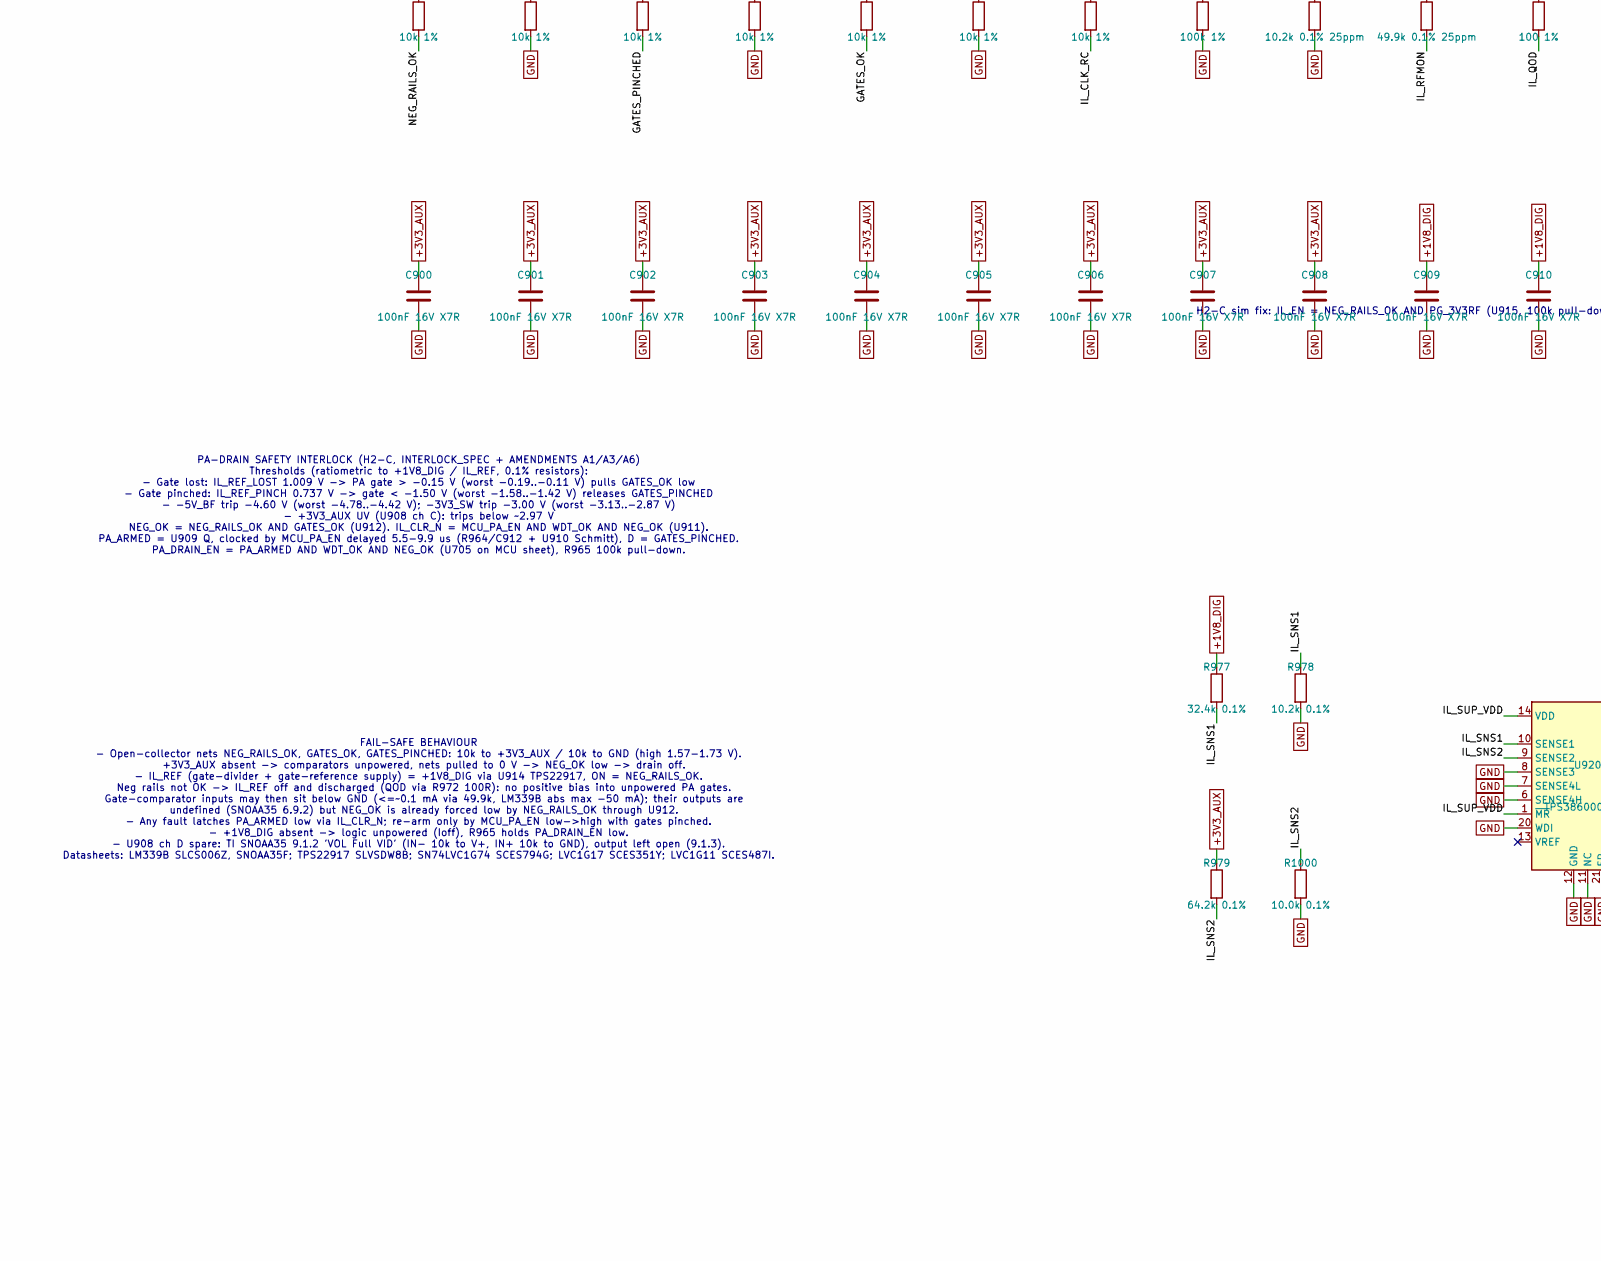
[picture p52: schematic interlock.kicad_sch, part in row 2, column 1]

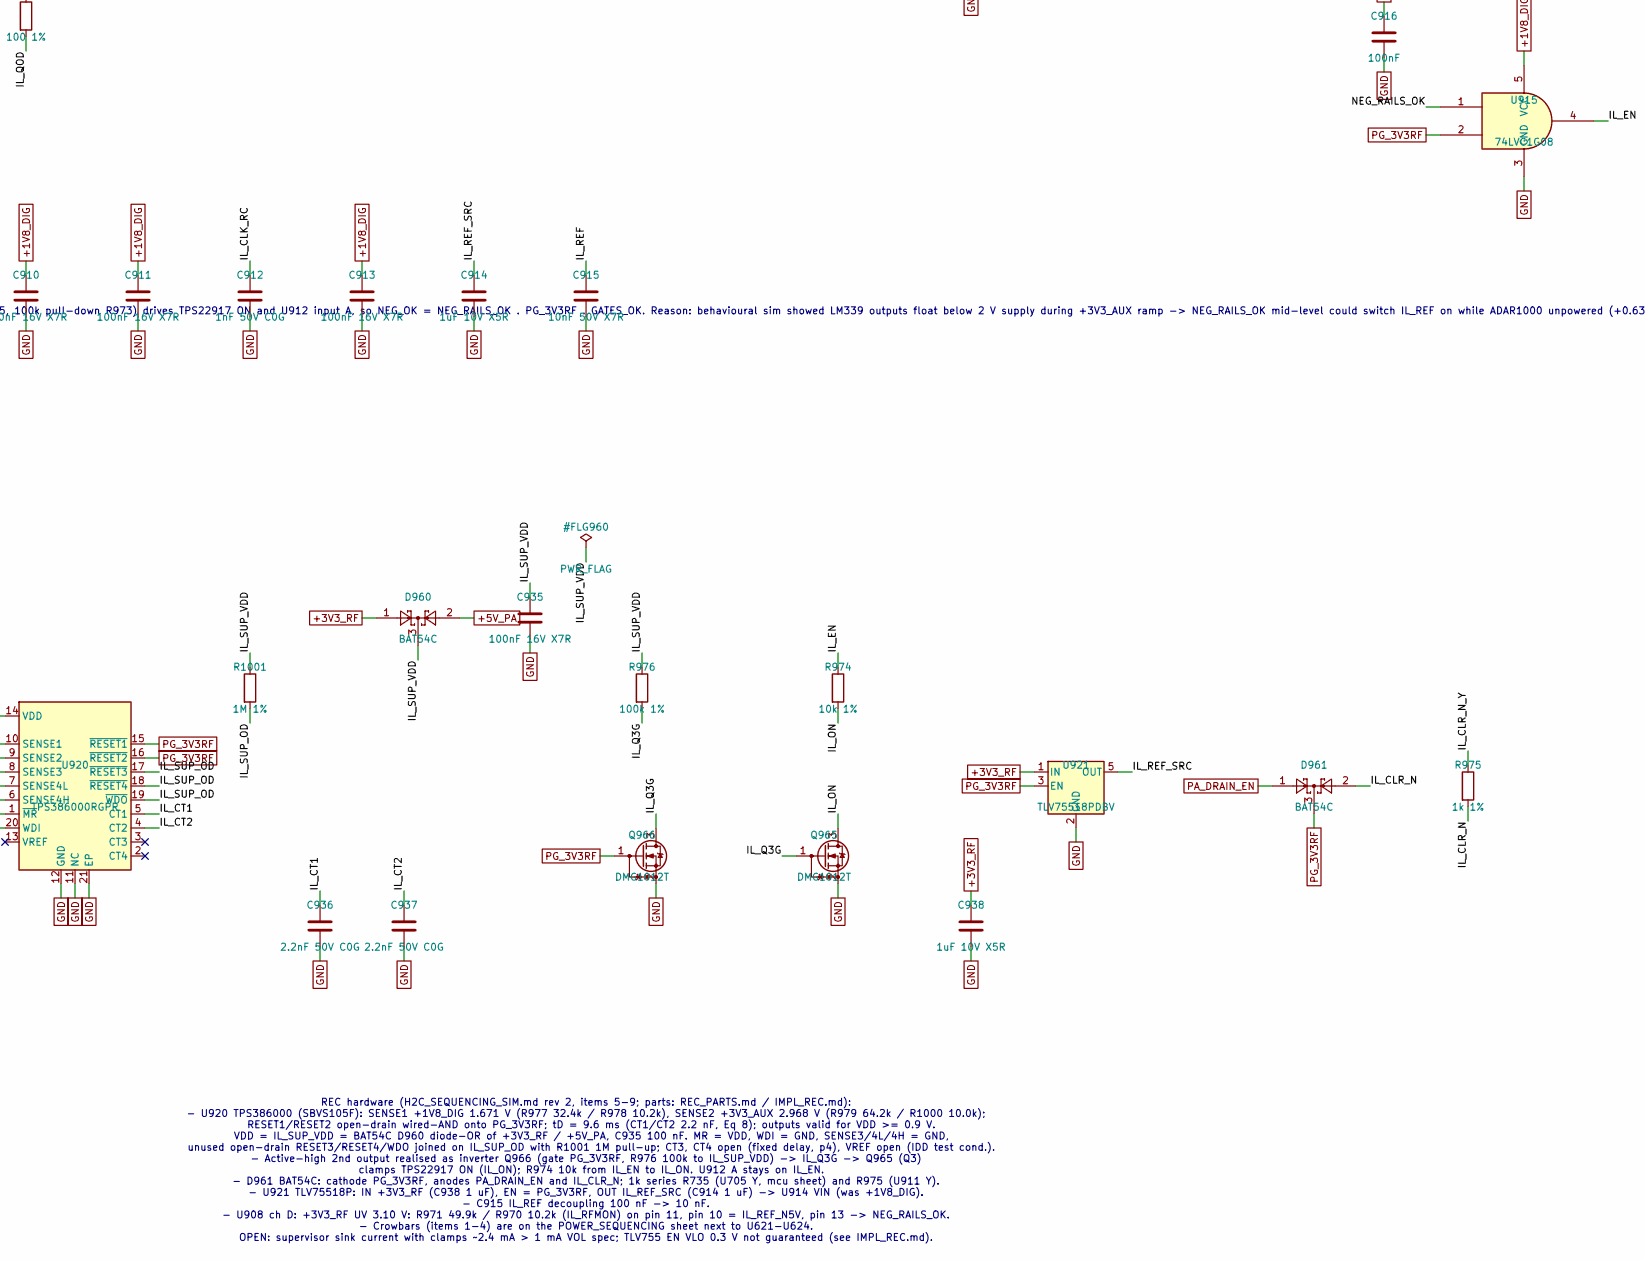
[picture p53: schematic interlock.kicad_sch, part in row 2, column 2]

Parts:
C900, C901, C902, C903, C904, C905, C906, C907, C908, C909, C910, C911, C913: 100nF 16V X7R; C_0402_1005Metric; MPN Murata GRM155R71C104KA88D
C912: 1nF 50V C0G; C_0402_1005Metric; MPN Murata GRM1555C1H102JA01D
C914, C938: 1uF 10V X5R; C_0402_1005Metric; MPN Murata GRM155R61A105KE15D
C915: 10nF 50V X7R; C_0402_1005Metric; MPN Murata GRM155R71H103KA88D
C916: 100nF; C_0402_1005Metric
C935: 100nF 16V X7R; C_0402_1005Metric
C936, C937: 2.2nF 50V C0G; C_0402_1005Metric
D960, D961: BAT54C; SOT-23; MPN Diodes BAT54C-7-F
Q965, Q966: DMG1012T; SOT-523; MPN Diodes DMG1012T-7
R900, R903, R906, R909, R912, R915, R918, R921, R924, R927, R930, R933, R936, R939, R942, R945, R949, R951: 49.9k 0.1% 25ppm; R_0402_1005Metric; MPN Panasonic ERA-2AEB4992X
R901, R904, R907, R910, R913, R916, R919, R922, R925, R928, R931, R934, R937, R940, R943, R946: 17.4k 0.1% 25ppm; R_0402_1005Metric; MPN Panasonic ERA-2AEB1742X
R902, R905, R908, R911, R914, R917, R920, R923, R926, R929, R932, R935, R938, R941, R944, R947: 45.3k 0.1% 25ppm; R_0402_1005Metric; MPN Panasonic ERA-2AEB4532X
R948, R950: 12.4k 0.1% 25ppm; R_0402_1005Metric; MPN Panasonic ERA-2AEB1242X
R952: 2.15k 0.1% 25ppm; R_0402_1005Metric; MPN Panasonic ERA-2AEB2151X
R953: 2.74k 0.1% 25ppm; R_0402_1005Metric; MPN Panasonic ERA-2AEB2741X
R954: 1.47k 0.1% 25ppm; R_0402_1005Metric; MPN Panasonic ERA-2AEB1471X
R955: 1.02k 0.1% 25ppm; R_0402_1005Metric; MPN Panasonic ERA-2AEB1021X
R956: 3.92k 0.1% 25ppm; R_0402_1005Metric; MPN Panasonic ERA-2AEB3921X
R957: 1.62k 0.1% 25ppm; R_0402_1005Metric; MPN Panasonic ERA-2AEB1621X
R958: 1.21k 0.1% 25ppm; R_0402_1005Metric; MPN Panasonic ERA-2AEB1211X
R959: 1.07k 0.1% 25ppm; R_0402_1005Metric; MPN Panasonic ERA-2AEB1071X
R960, R961, R962, R963, R964, R968, R969: 10k 1%; R_0402_1005Metric; MPN Panasonic ERJ-2RKF1002X
R965: 100k 1%; R_0402_1005Metric; MPN Panasonic ERJ-2RKF1003X
R966: 46.4k 0.1% 25ppm; R_0402_1005Metric; MPN Panasonic ERA-2AEB4642X
R967: 10.0k 0.1% 25ppm; R_0402_1005Metric; MPN Panasonic ERA-2AEB1002X
R970: 10.2k 0.1% 25ppm; R_0402_1005Metric
R971: 49.9k 0.1% 25ppm; R_0402_1005Metric
R972: 100 1%; R_0402_1005Metric; MPN Panasonic ERJ-2RKF1000X
R973: 100k; R_0402_1005Metric
R974: 10k 1%; R_0402_1005Metric
R975: 1k 1%; R_0402_1005Metric
R976: 100k 1%; R_0402_1005Metric
R977: 32.4k 0.1%; R_0402_1005Metric
R978: 10.2k 0.1%; R_0402_1005Metric
R979: 64.2k 0.1%; R_0402_1005Metric
R1000: 10.0k 0.1%; R_0402_1005Metric
R1001: 1M 1%; R_0402_1005Metric
U900, U901, U902, U903, U904, U905, U906, U907, U908: LM339B; SOIC-14_3.9x8.7mm_P1.27mm; MPN TI LM339BIDR
U909: SN74LVC1G74; VSSOP-8_2.3x2mm_P0.5mm; MPN TI SN74LVC1G74DCUR
U910: SN74LVC1G17; Texas_R-PDSO-G5_DCK-5; MPN TI SN74LVC1G17DCKR
U911: SN74LVC1G11; SOT-363_SC-70-6; MPN TI SN74LVC1G11DCKR
U912: SN74LVC1G08; SOT-23-5; MPN TI SN74LVC1G08DBVR
U914: TPS22917DBV; SOT-23-6; MPN TI TPS22917DBVR
U915: 74LVC1G08; SOT-23-5
U920: TPS386000RGPR; Texas_RGP0020D_VQFN-20-1EP_4x4mm_P0.5mm_EP2.7x2.7mm; MPN TI TPS386000RGPR
U921: TLV75518PDBV; SOT-23-5; MPN TI TLV75518PDBVR

Connections:
+1V8_DIG: C909.1, C910.1, C911.1, C913.1, C916.1, R948.1, R950.1, R956.1, R958.1, R977.1, U909.7 (~PRE), U909.8 (VCC), U910.5 (VCC), U911.5 (VCC), U912.5 (VCC), U915.5 (VCC)
+3V3_AUX: C900.1, C901.1, C902.1, C903.1, C904.1, C905.1, C906.1, C907.1, C908.1, R960.1, R962.1, R966.1, R968.1, R979.1, U900.3 (V+), U901.3 (V+), U902.3 (V+), U903.3 (V+), U904.3 (V+), U905.3 (V+), U906.3 (V+), U907.3 (V+), U908.3 (V+)
+3V3_RF: C938.1, D960.1, R971.1, U921.1 (IN)
+5V_PA: D960.2
-3V3_SW: R951.1
-5V_BF: R949.1
C1_PABIAS1: R900.1
C1_PABIAS2: R903.1
C1_PABIAS3: R906.1
C1_PABIAS4: R909.1
C2_PABIAS1: R912.1
C2_PABIAS2: R915.1
C2_PABIAS3: R918.1
C2_PABIAS4: R921.1
C3_PABIAS1: R924.1
C3_PABIAS2: R927.1
C3_PABIAS3: R930.1
C3_PABIAS4: R933.1
C4_PABIAS1: R936.1
C4_PABIAS2: R939.1
C4_PABIAS3: R942.1
C4_PABIAS4: R945.1
GATES_OK: R968.2, R969.1, U900.2 (AOUT), U900.14 (COUT), U901.2 (AOUT), U901.14 (COUT), U902.2 (AOUT), U902.14 (COUT), U903.2 (AOUT), U903.14 (COUT), U904.2 (AOUT), U904.14 (COUT), U905.2 (AOUT), U905.14 (COUT), U906.2 (AOUT), U906.14 (COUT), U907.2 (AOUT), U907.14 (COUT), U912.2
GATES_PINCHED: R962.2, R963.1, U900.1 (BOUT), U900.13 (DOUT), U901.1 (BOUT), U901.13 (DOUT), U902.1 (BOUT), U902.13 (DOUT), U903.1 (BOUT), U903.13 (DOUT), U904.1 (BOUT), U904.13 (DOUT), U905.1 (BOUT), U905.13 (DOUT), U906.1 (BOUT), U906.13 (DOUT), U907.1 (BOUT), U907.13 (DOUT), U909.2 (D)
GND: C900.2, C901.2, C902.2, C903.2, C904.2, C905.2, C906.2, C907.2, C908.2, C909.2, C910.2, C911.2, C912.2, C913.2, C914.2, C915.2, C916.2, C935.2, C936.2, C937.2, C938.2, Q965.2 (S), Q966.2 (S), R902.2, R905.2, R908.2, R911.2, R914.2, R917.2, R920.2, R923.2, R926.2, R929.2, R932.2, R935.2, R938.2, R941.2, R944.2, R947.2, R953.2, R955.2, R957.2, R959.2, R961.2, R963.2, R965.2, R967.2, R969.2, R970.2, R973.2, R978.2, R1000.2, U900.12 (GND), U901.12 (GND), U902.12 (GND), U903.12 (GND), U904.12 (GND), U905.12 (GND), U906.12 (GND), U907.12 (GND), U908.12 (GND), U909.4 (GND), U910.3 (GND), U911.2 (GND), U912.3 (GND), U914.2 (GND), U915.3 (GND), U920.6 (SENSE4H), U920.7 (SENSE4L), U920.8 (SENSE3), U920.11 (NC), U920.12 (GND), U920.20 (WDI), U920.21 (EP), U921.2 (GND)
IL_CLK: U909.1 (C), U910.4
IL_CLK_RC: C912.1, R964.2, U910.2
IL_CLR_N: D961.2, R975.2, U909.6 (~CLR)
IL_CLR_N_Y: R975.1, U911.4
IL_CT1: C936.1, U920.5 (CT1)
IL_CT2: C937.1, U920.4 (CT2)
IL_EN: R973.1, R974.1, U912.1, U915.4
IL_G11: R900.2, R901.2, R902.1, U900.4 (A-), U900.6 (B-)
IL_G12: R903.2, R904.2, R905.1, U900.8 (C-), U900.10 (D-)
IL_G13: R906.2, R907.2, R908.1, U901.4 (A-), U901.6 (B-)
IL_G14: R909.2, R910.2, R911.1, U901.8 (C-), U901.10 (D-)
IL_G21: R912.2, R913.2, R914.1, U902.4 (A-), U902.6 (B-)
IL_G22: R915.2, R916.2, R917.1, U902.8 (C-), U902.10 (D-)
IL_G23: R918.2, R919.2, R920.1, U903.4 (A-), U903.6 (B-)
IL_G24: R921.2, R922.2, R923.1, U903.8 (C-), U903.10 (D-)
IL_G31: R924.2, R925.2, R926.1, U904.4 (A-), U904.6 (B-)
IL_G32: R927.2, R928.2, R929.1, U904.8 (C-), U904.10 (D-)
IL_G33: R930.2, R931.2, R932.1, U905.4 (A-), U905.6 (B-)
IL_G34: R933.2, R934.2, R935.1, U905.8 (C-), U905.10 (D-)
IL_G41: R936.2, R937.2, R938.1, U906.4 (A-), U906.6 (B-)
IL_G42: R939.2, R940.2, R941.1, U906.8 (C-), U906.10 (D-)
IL_G43: R942.2, R943.2, R944.1, U907.4 (A-), U907.6 (B-)
IL_G44: R945.2, R946.2, R947.1, U907.8 (C-), U907.10 (D-)
IL_N3V3: R950.2, R951.2, U908.6 (B-)
IL_N5V: R948.2, R949.2, U908.4 (A-)
IL_ON: Q965.3 (D), R974.2, U914.3 (ON)
IL_Q3G: Q965.1 (G), Q966.3 (D), R976.2
IL_QOD: R972.2, U914.5 (QOD)
IL_REF: C915.1, R901.1, R904.1, R907.1, R910.1, R913.1, R916.1, R919.1, R922.1, R925.1, R928.1, R931.1, R934.1, R937.1, R940.1, R943.1, R946.1, R952.1, R954.1, R972.1, U914.6 (VOUT)
IL_REF_LOST: R952.2, R953.1, U900.5 (A+), U900.9 (C+), U901.5 (A+), U901.9 (C+), U902.5 (A+), U902.9 (C+), U903.5 (A+), U903.9 (C+), U904.5 (A+), U904.9 (C+), U905.5 (A+), U905.9 (C+), U906.5 (A+), U906.9 (C+), U907.5 (A+), U907.9 (C+)
IL_REF_N3V3: R958.2, R959.1, U908.7 (B+)
IL_REF_N5V: R956.2, R957.1, U908.5 (A+), U908.8 (C-), U908.10 (D-)
IL_REF_PINCH: R954.2, R955.1, U900.7 (B+), U900.11 (D+), U901.7 (B+), U901.11 (D+), U902.7 (B+), U902.11 (D+), U903.7 (B+), U903.11 (D+), U904.7 (B+), U904.11 (D+), U905.7 (B+), U905.11 (D+), U906.7 (B+), U906.11 (D+), U907.7 (B+), U907.11 (D+)
IL_REF_SRC: C914.1, U914.1 (VIN), U921.5 (OUT)
IL_RFMON: R970.1, R971.2, U908.11 (D+)
IL_SNS1: R977.2, R978.1, U920.10 (SENSE1)
IL_SNS2: R979.2, R1000.1, U920.9 (SENSE2)
IL_SUP_OD: R1001.2, U920.17 (~RESET3), U920.18 (~RESET4), U920.19 (~WDO)
IL_SUP_VDD: C935.1, D960.3, R976.1, R1001.1, U920.1 (~MR), U920.14 (VDD)
IL_V33MON: R966.2, R967.1, U908.9 (C+)
MCU_PA_EN: R964.1, U911.1
NEG_OK: U911.6, U912.4
NEG_RAILS_OK: R960.2, R961.1, U908.1 (BOUT), U908.2 (AOUT), U908.13 (DOUT), U908.14 (COUT), U915.1
PA_ARMED: U909.5 (Q)
PA_DRAIN_EN: D961.1, R965.1
PG_3V3RF: D961.3, Q966.1 (G), U915.2, U920.15 (~RESET1), U920.16 (~RESET2), U921.3 (EN)
WDT_OK: U911.3

Notes on the sheet:
PA-DRAIN SAFETY INTERLOCK (H2-C, INTERLOCK_SPEC + AMENDMENTS A1/A3/A6) Thresholds (ratiometric to +1V8_DIG / IL_REF, 0.1% resistors): - Gate lost: IL_REF_LOST 1.009 V -> PA gate > -0.15 V (worst -0.19..-0.11 V) pulls GATES_OK low - Gate pinched: IL_REF_PINCH 0.737 V -> gate < -1.50 V (worst -1.58..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
FAIL-SAFE BEHAVIOUR - Open-collector nets NEG_RAILS_OK, GATES_OK, GATES_PINCHED: 10k to +3V3_AUX / 10k to GND (high 1.57-1.73 V). +3V3_AUX absent -> comparators unpowered, nets pulled to 0 V -> NEG_OK low -> drain off. - IL_REF (gate-divider + gate-reference supply) = +1V8_DIG via U914 TPS22917, ON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
H2-C sim fix: IL_EN = NEG_RAILS_OK AND PG_3V3RF (U915, 100k pull-down R973) drives TPS22917 ON and U912 input A, so NEG_OK = NEG_RAILS_OK . PG_3V3RF . GATES_OK. Reason: behavioural sim showed LM339 outputs float below 2 V supply during +3V3_AUX ramp -> NEG_RAILS_OK mid-level could switch IL_REF on 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
REC hardware (H2C_SEQUENCING_SIM.md rev 2, items 5-9; parts: REC_PARTS.md / IMPL_REC.md): - U920 TPS386000 (SBVS105F): SENSE1 +1V8_DIG 1.671 V (R977 32.4k / R978 10.2k), SENSE2 +3V3_AUX 2.968 V (R979 64.2k / R1000 10.0k); RESET1/RESET2 open-drain wired-AND onto PG_3V3RF; tD = 9.6 ms (CT1/CT2 2.2 nF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
