CLIS-WPI/OpenRU/hardware/h2/schematics/lo.kicad_sch

## KiCad design hardware/h2/schematics/lo.kicad_sch (2026-11-12)

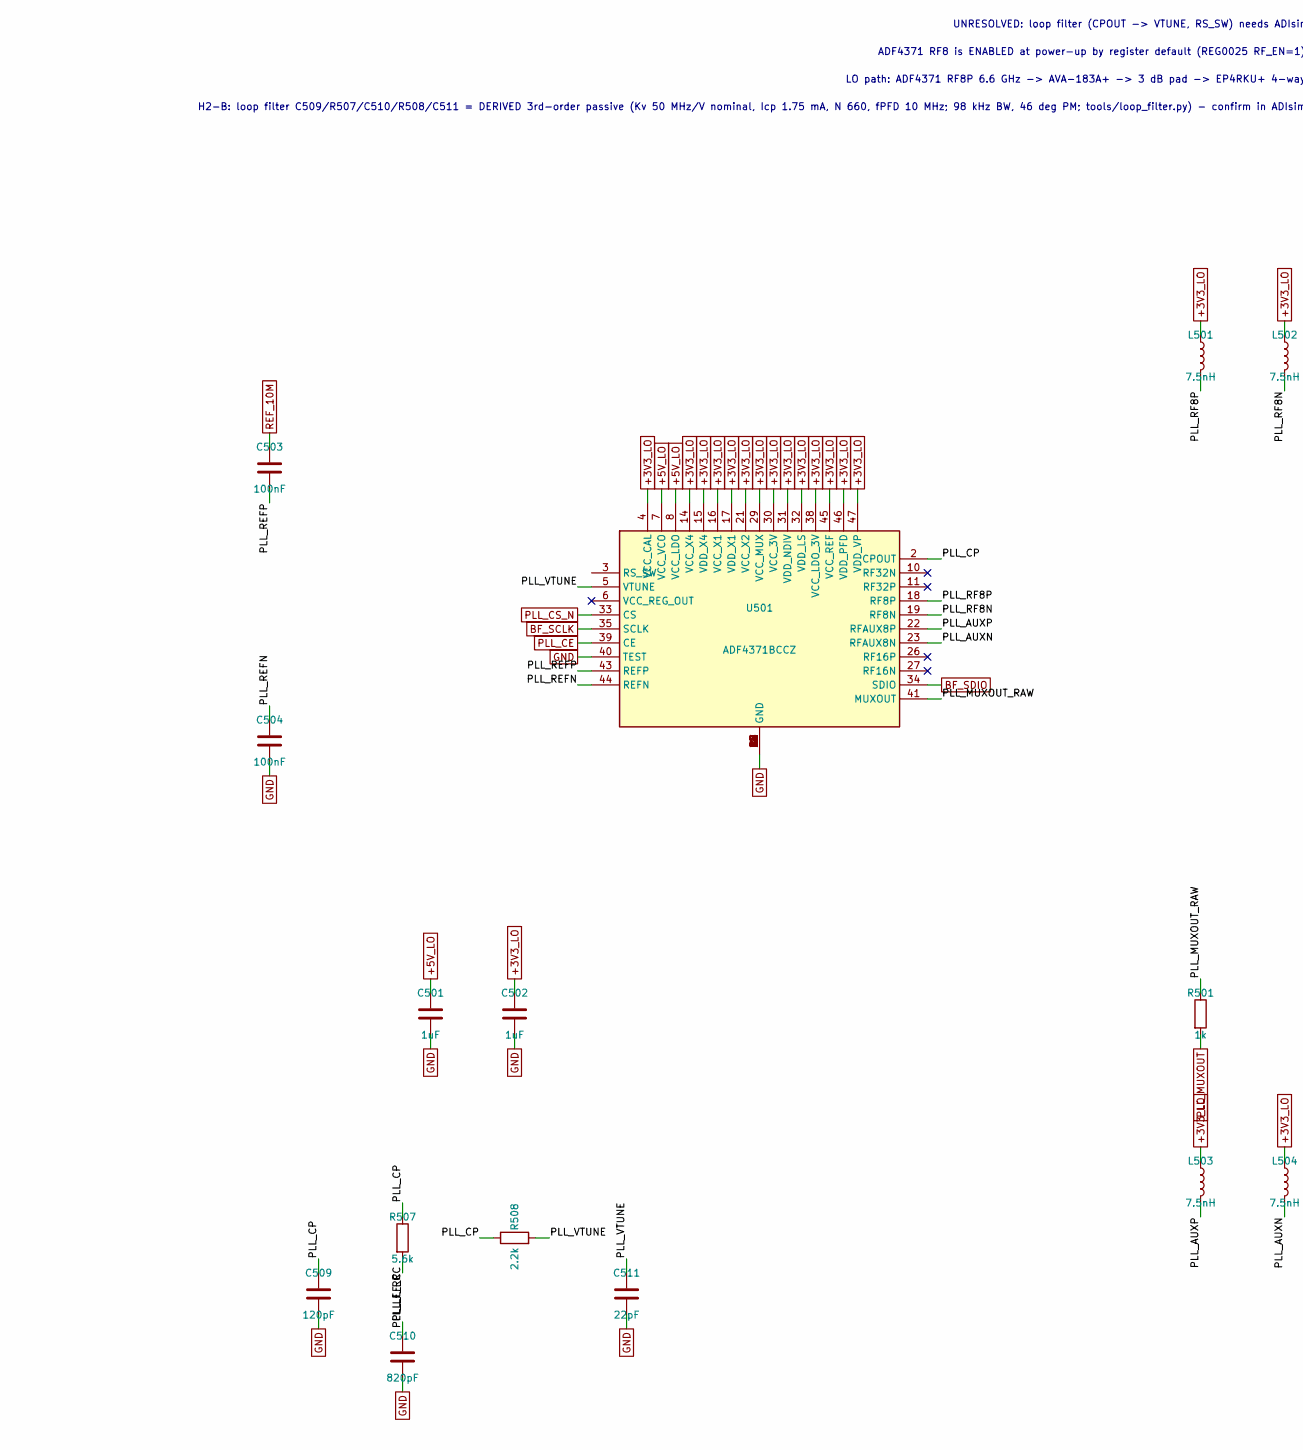
[picture p54: schematic lo.kicad_sch, part in row 1, column 1]

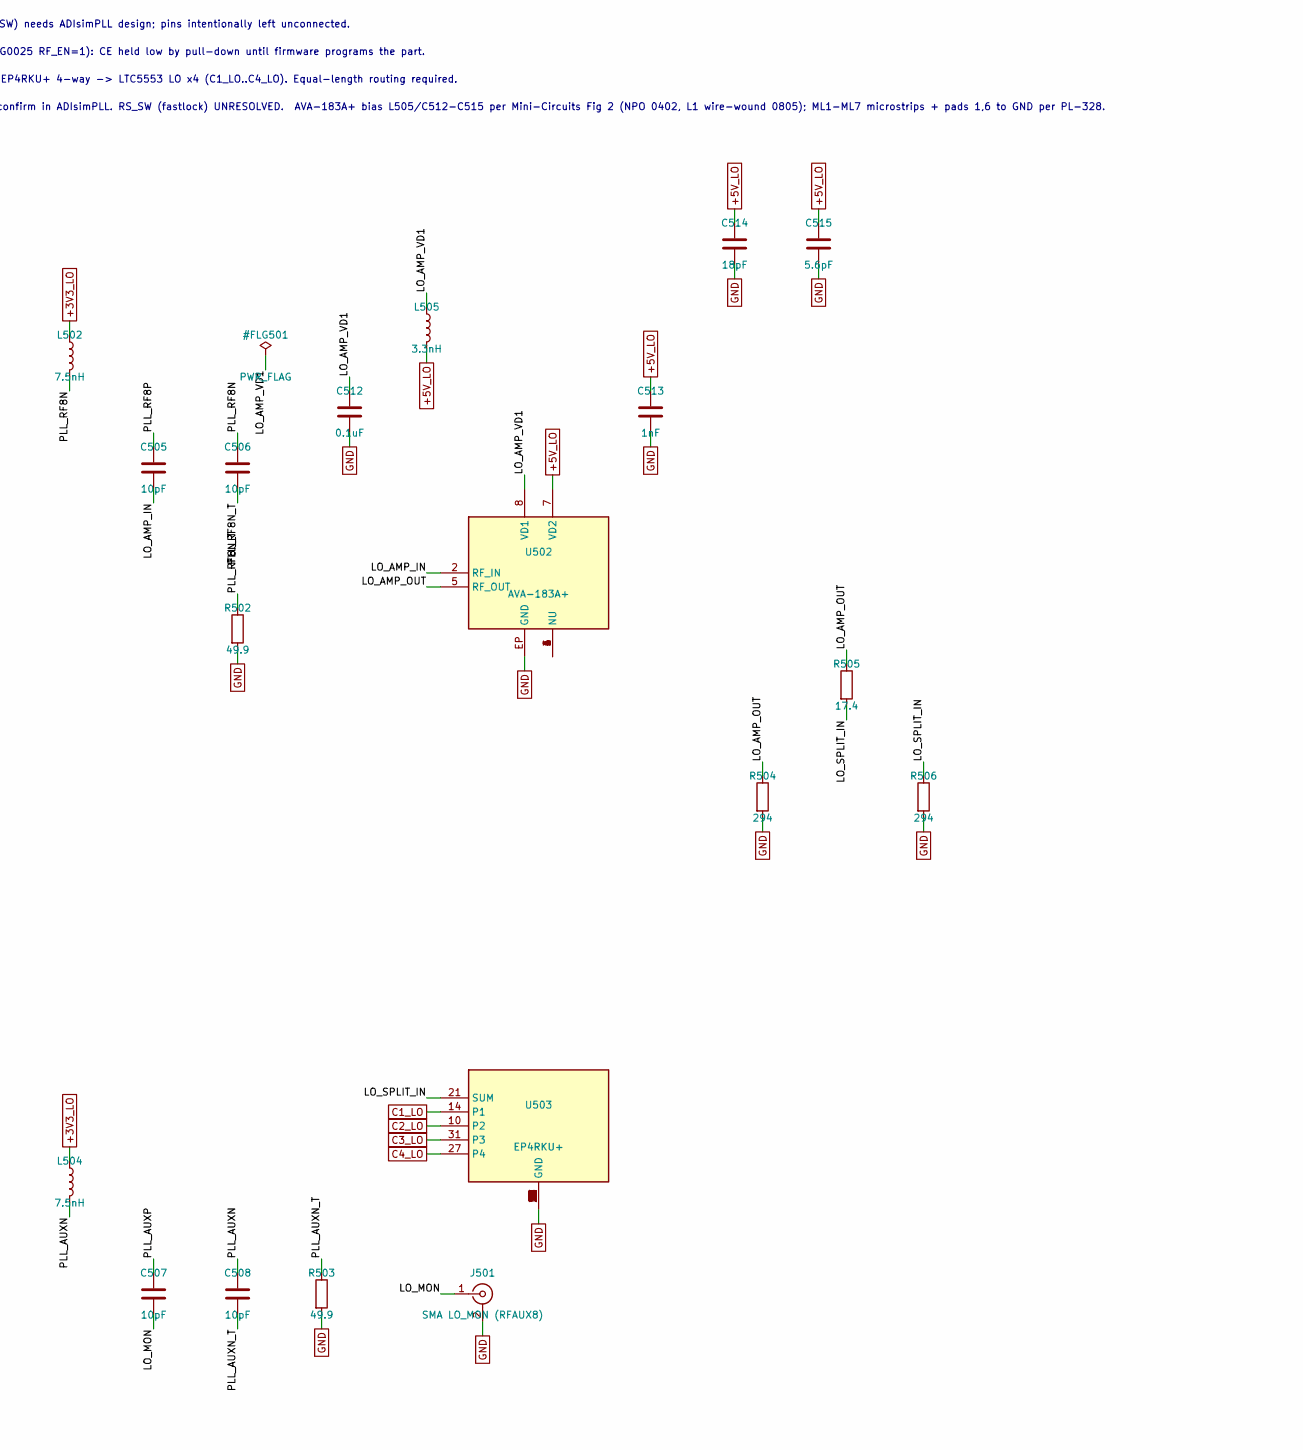
[picture p55: schematic lo.kicad_sch, part in row 1, column 2]

Parts:
C501, C502: 1uF; C_0603_1608Metric
C503, C504: 100nF; C_0402_1005Metric
C505, C506, C507, C508: 10pF; C_0402_1005Metric
C509: 120pF; C_0402_1005Metric
C510: 820pF; C_0402_1005Metric
C511: 22pF; C_0402_1005Metric
C512: 0.1uF; C_0402_1005Metric
C513: 1nF; C_0402_1005Metric
C514: 18pF; C_0402_1005Metric
C515: 5.6pF; C_0402_1005Metric
J501: SMA LO_MON (RFAUX8)
L501, L502, L503, L504: 7.5nH; L_0402_1005Metric
L505: 3.3nH; L_0805_2012Metric
R501: 1k; R_0402_1005Metric
R502, R503: 49.9; R_0402_1005Metric
R504, R506: 294; R_0402_1005Metric
R505: 17.4; R_0402_1005Metric
R507: 5.6k; R_0402_1005Metric
R508: 2.2k; R_0402_1005Metric
U501: ADF4371BCCZ; MPN ADF4371BCCZ
U502: AVA-183A+; MPN AVA-183A+
U503: EP4RKU+; MPN EP4RKU+

Connections:
+3V3_LO: C502.1, L501.1, L502.1, L503.1, L504.1, U501.4 (VCC_CAL), U501.14 (VCC_X4), U501.15 (VDD_X4), U501.16 (VCC_X1), U501.17 (VDD_X1), U501.21 (VCC_X2), U501.29 (VCC_MUX), U501.30 (VCC_3V), U501.31 (VDD_NDIV), U501.32 (VDD_LS), U501.38 (VCC_LDO_3V), U501.45 (VCC_REF), U501.46 (VDD_PFD), U501.47 (VDD_VP)
+5V_LO: C501.1, C513.1, C514.1, C515.1, L505.2, U501.7 (VCC_VCO), U501.8 (VCC_LDO), U502.7 (VD2)
BF_SCLK: U501.35 (SCLK)
BF_SDIO: U501.34 (SDIO)
C1_LO: U503.14 (P1)
C2_LO: U503.10 (P2)
C3_LO: U503.31 (P3)
C4_LO: U503.27 (P4)
GND: C501.2, C502.2, C504.2, C509.2, C510.2, C511.2, C512.2, C513.2, C514.2, C515.2, J501.2 (Ext), R502.2, R503.2, R504.2, R506.2, U501.1 (GND), U501.9 (GND), U501.12 (GND), U501.13 (GND), U501.20 (GND), U501.24 (GND), U501.25 (GND), U501.28 (GND), U501.36 (GND), U501.37 (GND), U501.40 (TEST), U501.42 (GND), U501.48 (GND), U501.EP (GND), U502.EP (GND), U503.1 (GND), U503.2 (GND), U503.3 (GND), U503.4 (GND), U503.5 (GND), U503.6 (GND), U503.7 (GND), U503.8 (GND), U503.9 (GND), U503.11 (GND), U503.12 (GND), U503.13 (GND), U503.15 (GND), U503.16 (GND), U503.17 (GND), U503.18 (GND), U503.19 (GND), U503.20 (GND), U503.22 (GND), U503.23 (GND), U503.24 (GND), U503.25 (GND), U503.26 (GND), U503.28 (GND), U503.29 (GND), U503.30 (GND), U503.32 (GND), U503.EP (GND)
LO_AMP_IN: C505.2, U502.2 (RF_IN)
LO_AMP_OUT: R504.1, R505.1, U502.5 (RF_OUT)
LO_AMP_VD1: C512.1, L505.1, U502.8 (VD1)
LO_MON: C507.2, J501.1 (In)
LO_SPLIT_IN: R505.2, R506.1, U503.21 (SUM)
unnamed: U502.1 (NU), U502.3 (NU), U502.4 (NU), U502.6 (NU)
PLL_AUXN: C508.1, L504.2, U501.23 (RFAUX8N)
PLL_AUXN_T: C508.2, R503.1
PLL_AUXP: C507.1, L503.2, U501.22 (RFAUX8P)
PLL_CE: U501.39 (CE)
PLL_CP: C509.1, R507.1, R508.1, U501.2 (CPOUT)
PLL_CS_N: U501.33 (CS)
PLL_LF_RC: C510.1, R507.2
PLL_MUXOUT: R501.2
PLL_MUXOUT_RAW: R501.1, U501.41 (MUXOUT)
PLL_REFN: C504.1, U501.44 (REFN)
PLL_REFP: C503.2, U501.43 (REFP)
PLL_RF8N: C506.1, L502.2, U501.19 (RF8N)
PLL_RF8N_T: C506.2, R502.1
PLL_RF8P: C505.1, L501.2, U501.18 (RF8P)
PLL_VTUNE: C511.1, R508.2, U501.5 (VTUNE)
REF_10M: C503.1

Notes on the sheet:
UNRESOLVED: loop filter (CPOUT -> VTUNE, RS_SW) needs ADIsimPLL design; pins intentionally left unconnected.
ADF4371 RF8 is ENABLED at power-up by register default (REG0025 RF_EN=1): CE held low by pull-down until firmware programs the part.
LO path: ADF4371 RF8P 6.6 GHz -> AVA-183A+ -> 3 dB pad -> EP4RKU+ 4-way -> LTC5553 LO x4 (C1_LO..C4_LO). Equal-length routing required.
H2-B: loop filter C509/R507/C510/R508/C511 = DERIVED 3rd-order passive (Kv 50 MHz/V nominal, Icp 1.75 mA, N 660, fPFD 10 MHz; 98 kHz BW, 46 deg PM; tools/loop_filter.py) - confirm in ADIsimPLL. RS_SW (fastlock) UNRESOLVED. AVA-183A+ bias L505/C512-C515 per Mini-Circuits Fig 2 (NPO 0402, L1 wire-wou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
