CLIS-WPI/OpenRU/hardware/h2/schematics/mcu.kicad_sch

## KiCad design hardware/h2/schematics/mcu.kicad_sch (2026-11-12)

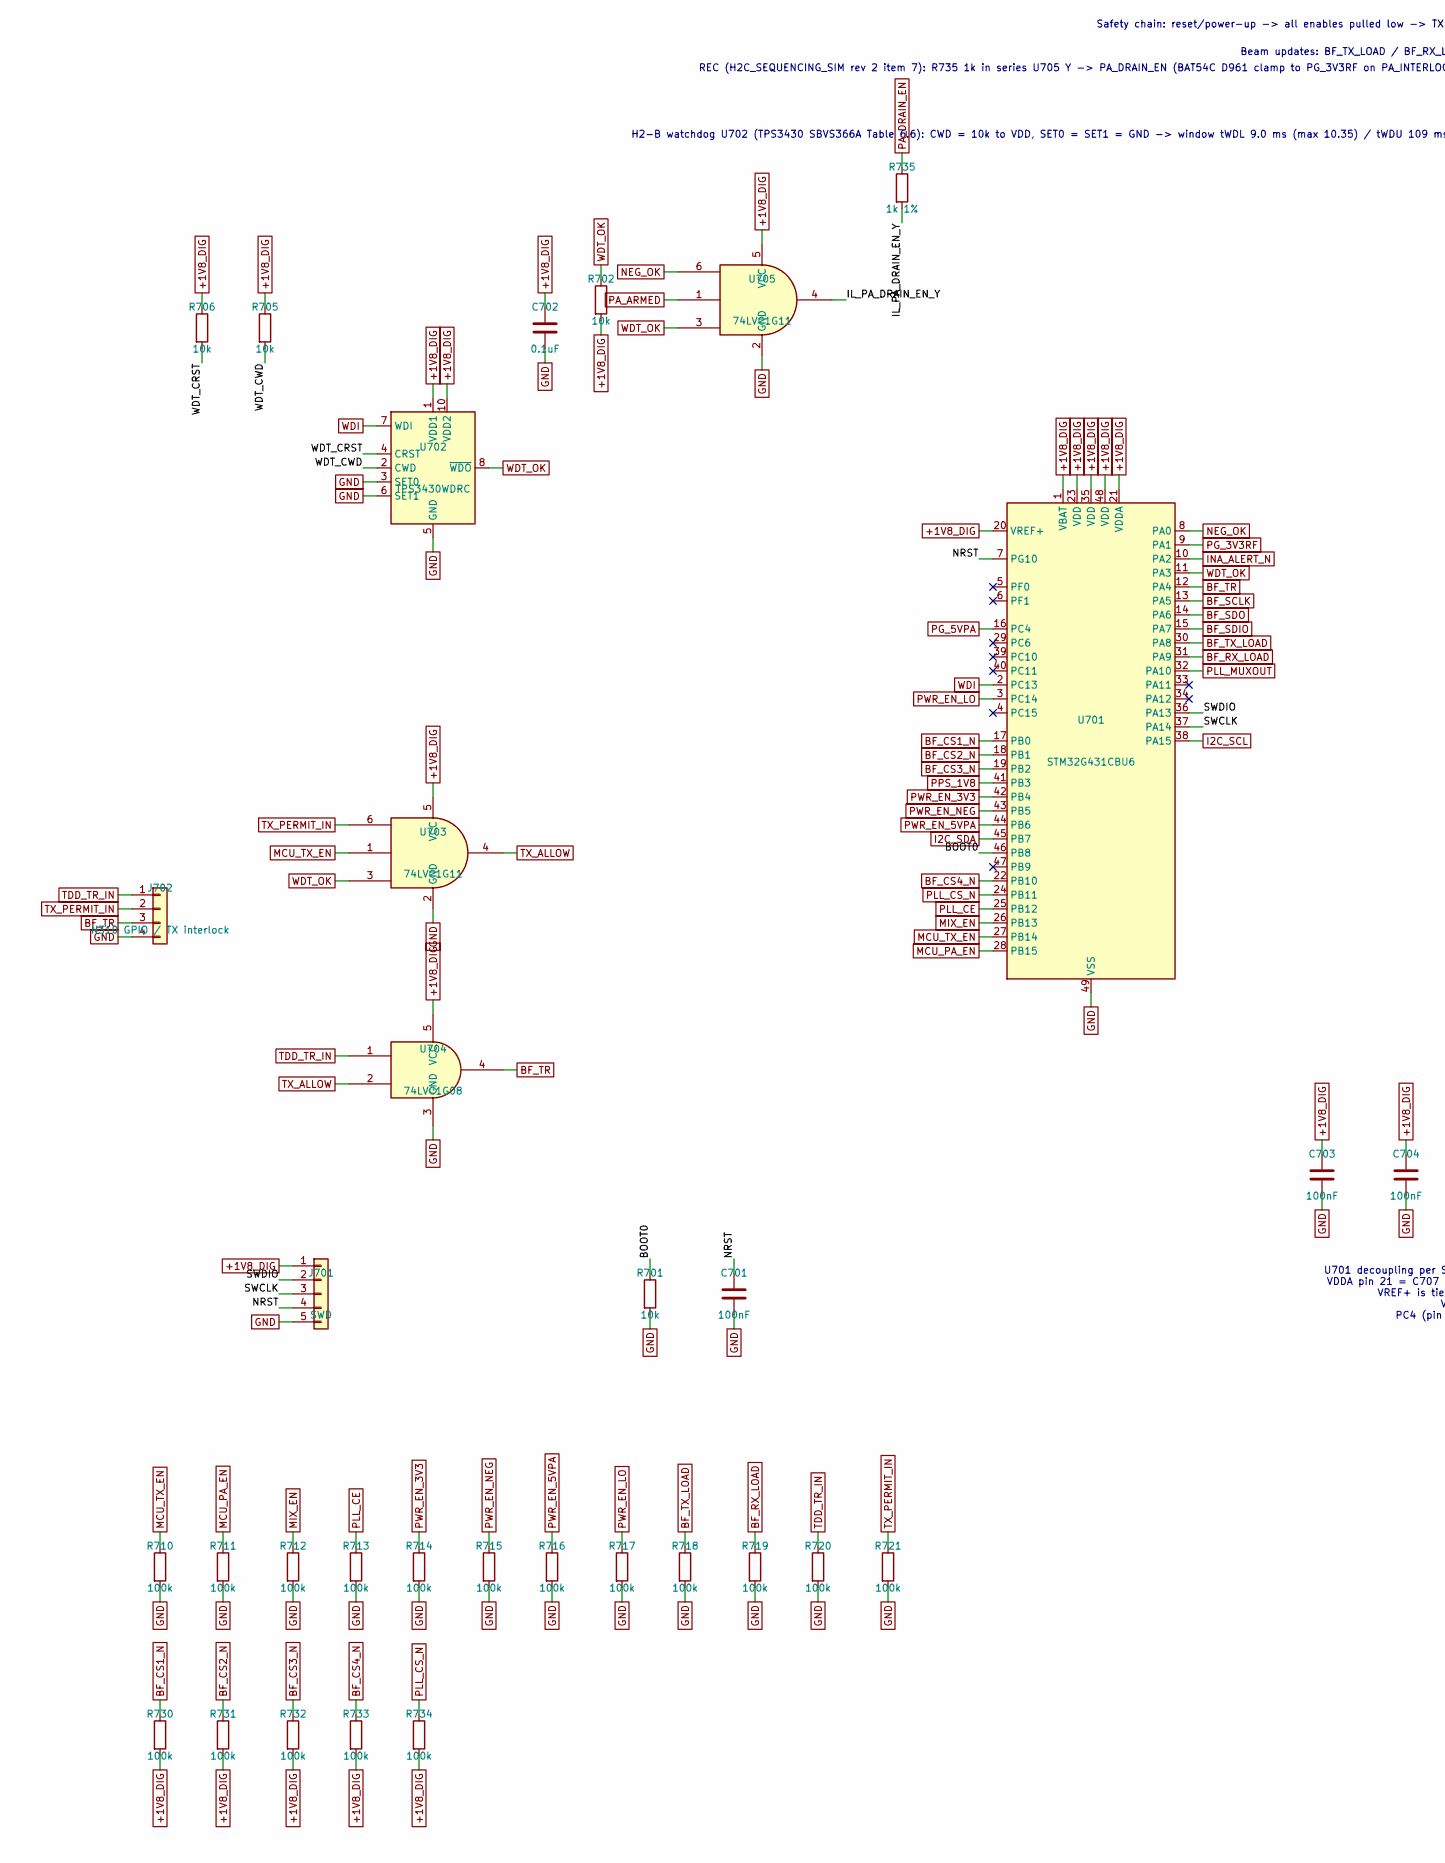
[picture p56: schematic mcu.kicad_sch, part in row 1, column 1]

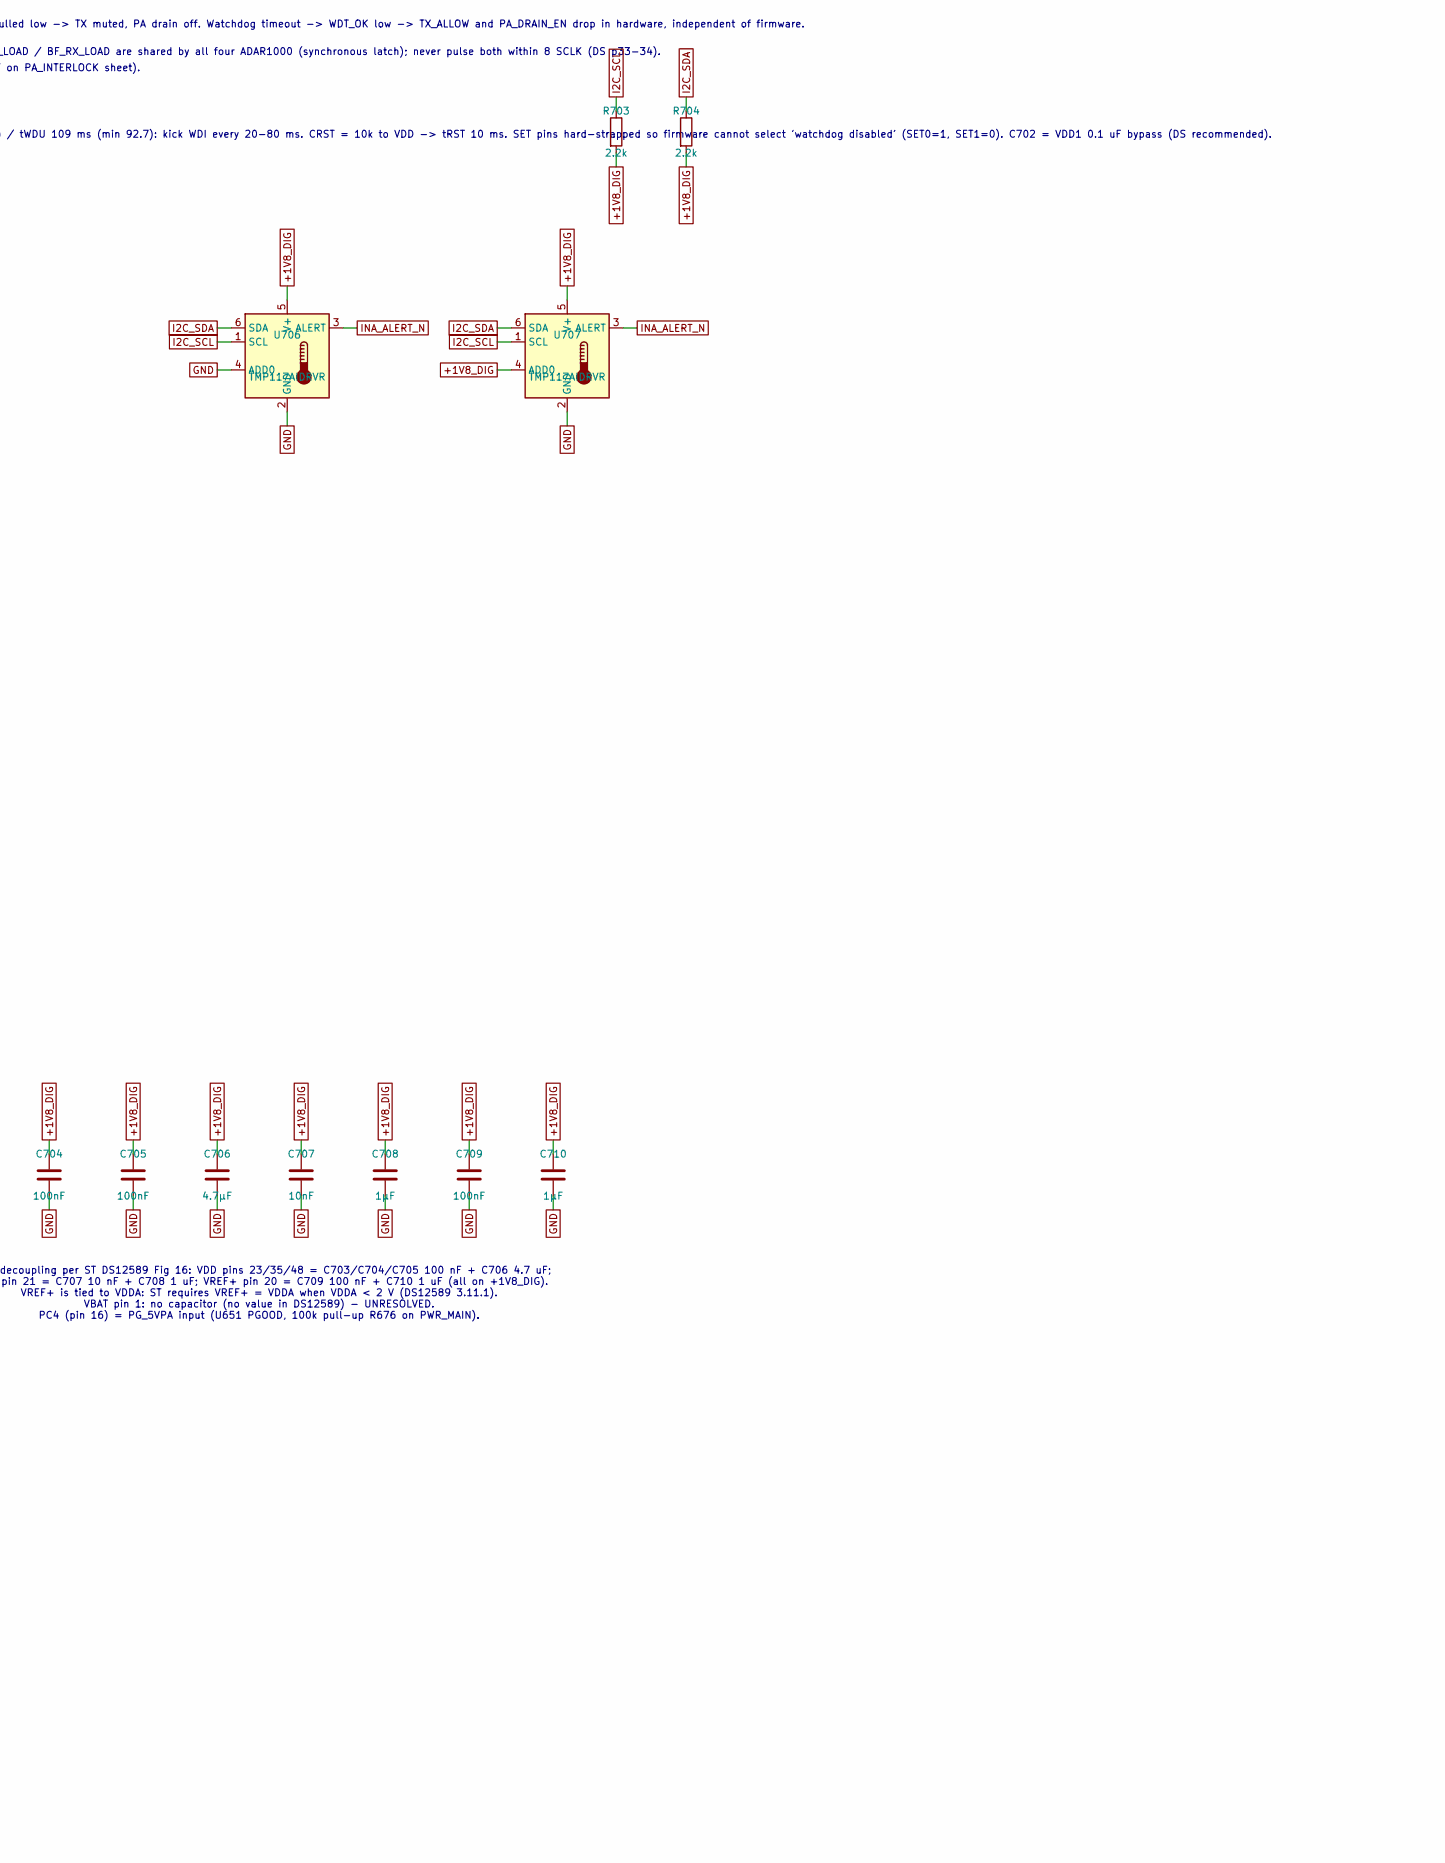
[picture p57: schematic mcu.kicad_sch, part in row 1, column 2]

Parts:
C701, C703, C704, C705, C709: 100nF; C_0402_1005Metric
C702: 0.1uF; C_0402_1005Metric
C706: 4.7µF; C_0402_1005Metric
C707: 10nF; C_0402_1005Metric
C708, C710: 1µF; C_0402_1005Metric
J701: SWD
J702: N310 GPIO / TX interlock
R701, R702, R705, R706: 10k; R_0402_1005Metric
R703, R704: 2.2k; R_0402_1005Metric
R710, R711, R712, R713, R714, R715, R716, R717, R718, R719, R720, R721, R730, R731, R732, R733, R734: 100k; R_0402_1005Metric
R735: 1k 1%; R_0402_1005Metric
U701: STM32G431CBU6; QFN-48-1EP_7x7mm_P0.5mm_EP5.6x5.6mm; MPN STM32G431CBU6
U702: TPS3430WDRC; MPN TPS3430WDRCR
U703, U705: 74LVC1G11; SOT-23-6
U704: 74LVC1G08; SOT-23-5
U706, U707: TMP117AIDRVR; WSON-6-1EP_2x2mm_P0.65mm_EP1x1.6mm; MPN TMP117AIDRVR

Connections:
+1V8_DIG: C702.1, C703.1, C704.1, C705.1, C706.1, C707.1, C708.1, C709.1, C710.1, J701.1, R702.2, R703.2, R704.2, R705.1, R706.1, R730.2, R731.2, R732.2, R733.2, R734.2, U701.1 (VBAT), U701.20 (VREF+), U701.21 (VDDA), U701.23 (VDD), U701.35 (VDD), U701.48 (VDD), U702.1 (VDD1), U702.10 (VDD2), U703.5 (VCC), U704.5 (VCC), U705.5 (VCC), U706.5 (V+), U707.4 (ADD0), U707.5 (V+)
BF_CS1_N: R730.1, U701.17 (PB0)
BF_CS2_N: R731.1, U701.18 (PB1)
BF_CS3_N: R732.1, U701.19 (PB2)
BF_CS4_N: R733.1, U701.22 (PB10)
BF_RX_LOAD: R719.1, U701.31 (PA9)
BF_SCLK: U701.13 (PA5)
BF_SDIO: U701.15 (PA7)
BF_SDO: U701.14 (PA6)
BF_TR: J702.3, U701.12 (PA4), U704.4
BF_TX_LOAD: R718.1, U701.30 (PA8)
BOOT0: R701.1, U701.46 (PB8)
GND: C701.2, C702.2, C703.2, C704.2, C705.2, C706.2, C707.2, C708.2, C709.2, C710.2, J701.5, J702.4, R701.2, R710.2, R711.2, R712.2, R713.2, R714.2, R715.2, R716.2, R717.2, R718.2, R719.2, R720.2, R721.2, U701.49 (VSS), U702.3 (SET0), U702.5 (GND), U702.6 (SET1), U702.11 (GND), U703.2 (GND), U704.3 (GND), U705.2 (GND), U706.2 (GND), U706.4 (ADD0), U707.2 (GND)
I2C_SCL: R703.1, U701.38 (PA15), U706.1 (SCL), U707.1 (SCL)
I2C_SDA: R704.1, U701.45 (PB7), U706.6 (SDA), U707.6 (SDA)
IL_PA_DRAIN_EN_Y: R735.2, U705.4
INA_ALERT_N: U701.10 (PA2), U706.3 (ALERT), U707.3 (ALERT)
MCU_PA_EN: R711.1, U701.28 (PB15)
MCU_TX_EN: R710.1, U701.27 (PB14), U703.1
MIX_EN: R712.1, U701.26 (PB13)
NEG_OK: U701.8 (PA0), U705.6
NRST: C701.1, J701.4, U701.7 (PG10)
PA_ARMED: U705.1
PA_DRAIN_EN: R735.1
PG_3V3RF: U701.9 (PA1)
PG_5VPA: U701.16 (PC4)
PLL_CE: R713.1, U701.25 (PB12)
PLL_CS_N: R734.1, U701.24 (PB11)
PLL_MUXOUT: U701.32 (PA10)
PPS_1V8: U701.41 (PB3)
PWR_EN_3V3: R714.1, U701.42 (PB4)
PWR_EN_5VPA: R716.1, U701.44 (PB6)
PWR_EN_LO: R717.1, U701.3 (PC14)
PWR_EN_NEG: R715.1, U701.43 (PB5)
SWCLK: J701.3, U701.37 (PA14)
SWDIO: J701.2, U701.36 (PA13)
TDD_TR_IN: J702.1, R720.1, U704.1
TX_ALLOW: U703.4, U704.2
TX_PERMIT_IN: J702.2, R721.1, U703.6
WDI: U701.2 (PC13), U702.7 (WDI)
WDT_CRST: R706.2, U702.4 (CRST)
WDT_CWD: R705.2, U702.2 (CWD)
WDT_OK: R702.1, U701.11 (PA3), U702.8 (~WDO), U703.3, U705.3

Notes on the sheet:
Safety chain: reset/power-up -> all enables pulled low -> TX muted, PA drain off. Watchdog timeout -> WDT_OK low -> TX_ALLOW and PA_DRAIN_EN drop in hardware, independent of firmware.
Beam updates: BF_TX_LOAD / BF_RX_LOAD are shared by all four ADAR1000 (synchronous latch); never pulse both within 8 SCLK (DS p33-34).
H2-B watchdog U702 (TPS3430 SBVS366A Table 6.6): CWD = 10k to VDD, SET0 = SET1 = GND -> window tWDL 9.0 ms (max 10.35) / tWDU 109 ms (min 92.7): kick WDI every 20-80 ms. CRST = 10k to VDD -> tRST 10 ms. SET pins hard-strapped so firmware cannot select 'watchdog disabled' (SET0=1, SET1=0). C702 = VD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
U701 decoupling per ST DS12589 Fig 16: VDD pins 23/35/48 = C703/C704/C705 100 nF + C706 4.7 uF; VDDA pin 21 = C707 10 nF + C708 1 uF; VREF+ pin 20 = C709 100 nF + C710 1 uF (all on +1V8_DIG). VREF+ is tied to VDDA: ST requires VREF+ = VDDA when VDDA < 2 V (DS12589 3.11.1). VBAT pin 1: no capacitor 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
REC (H2C_SEQUENCING_SIM rev 2 item 7): R735 1k in series U705 Y -> PA_DRAIN_EN (BAT54C D961 clamp to PG_3V3RF on PA_INTERLOCK sheet).
