CLIS-WPI/OpenRU/hardware/h2/schematics/power.kicad_sch

## KiCad design hardware/h2/schematics/power.kicad_sch (2026-11-12)

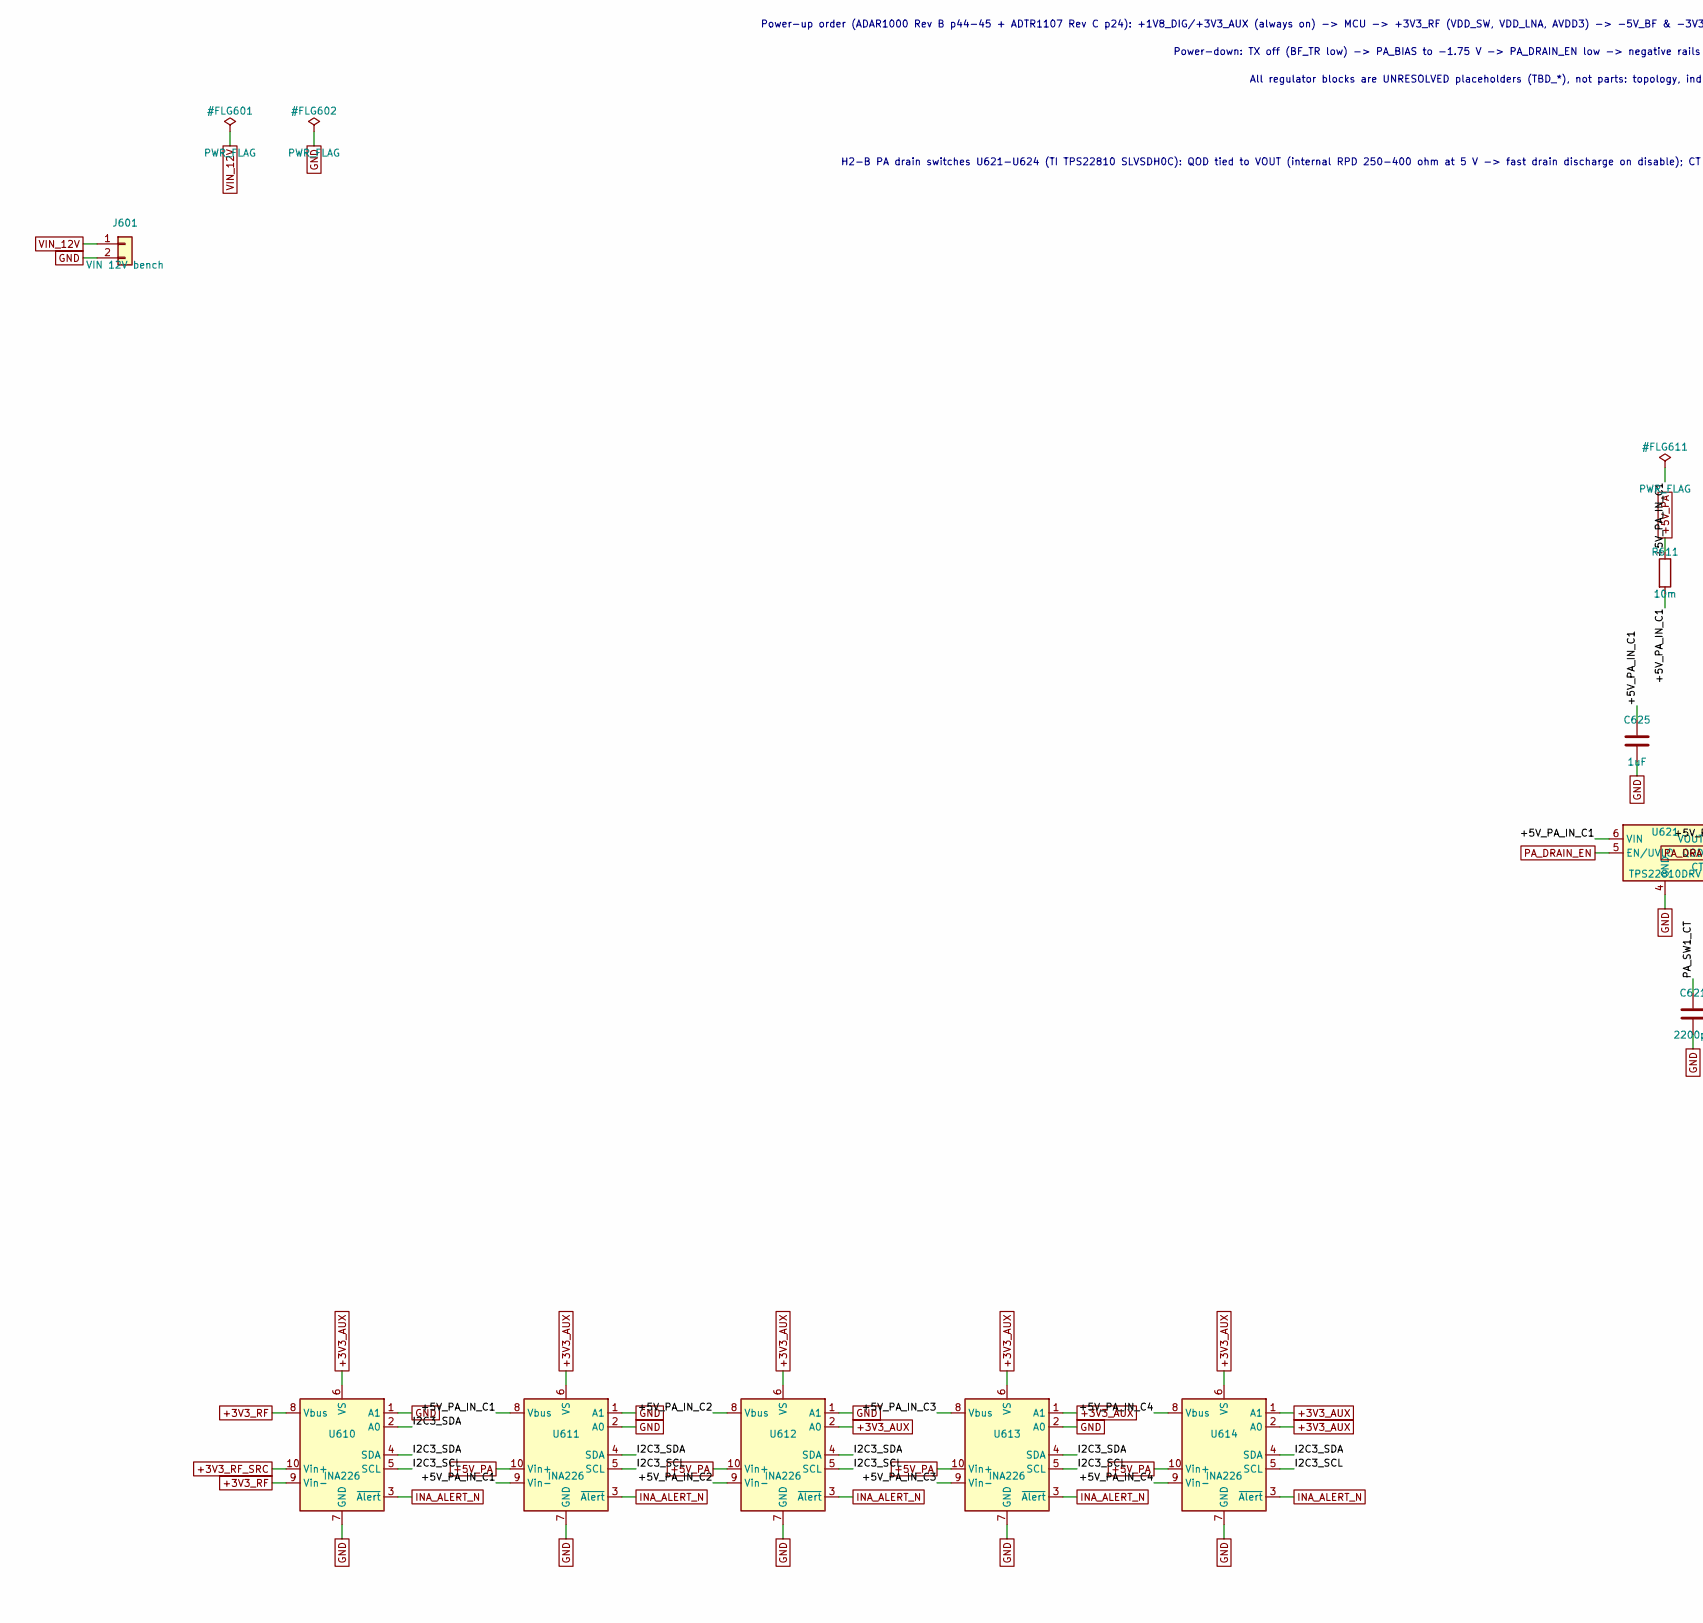
[picture p58: schematic power.kicad_sch, part in row 1, column 1]

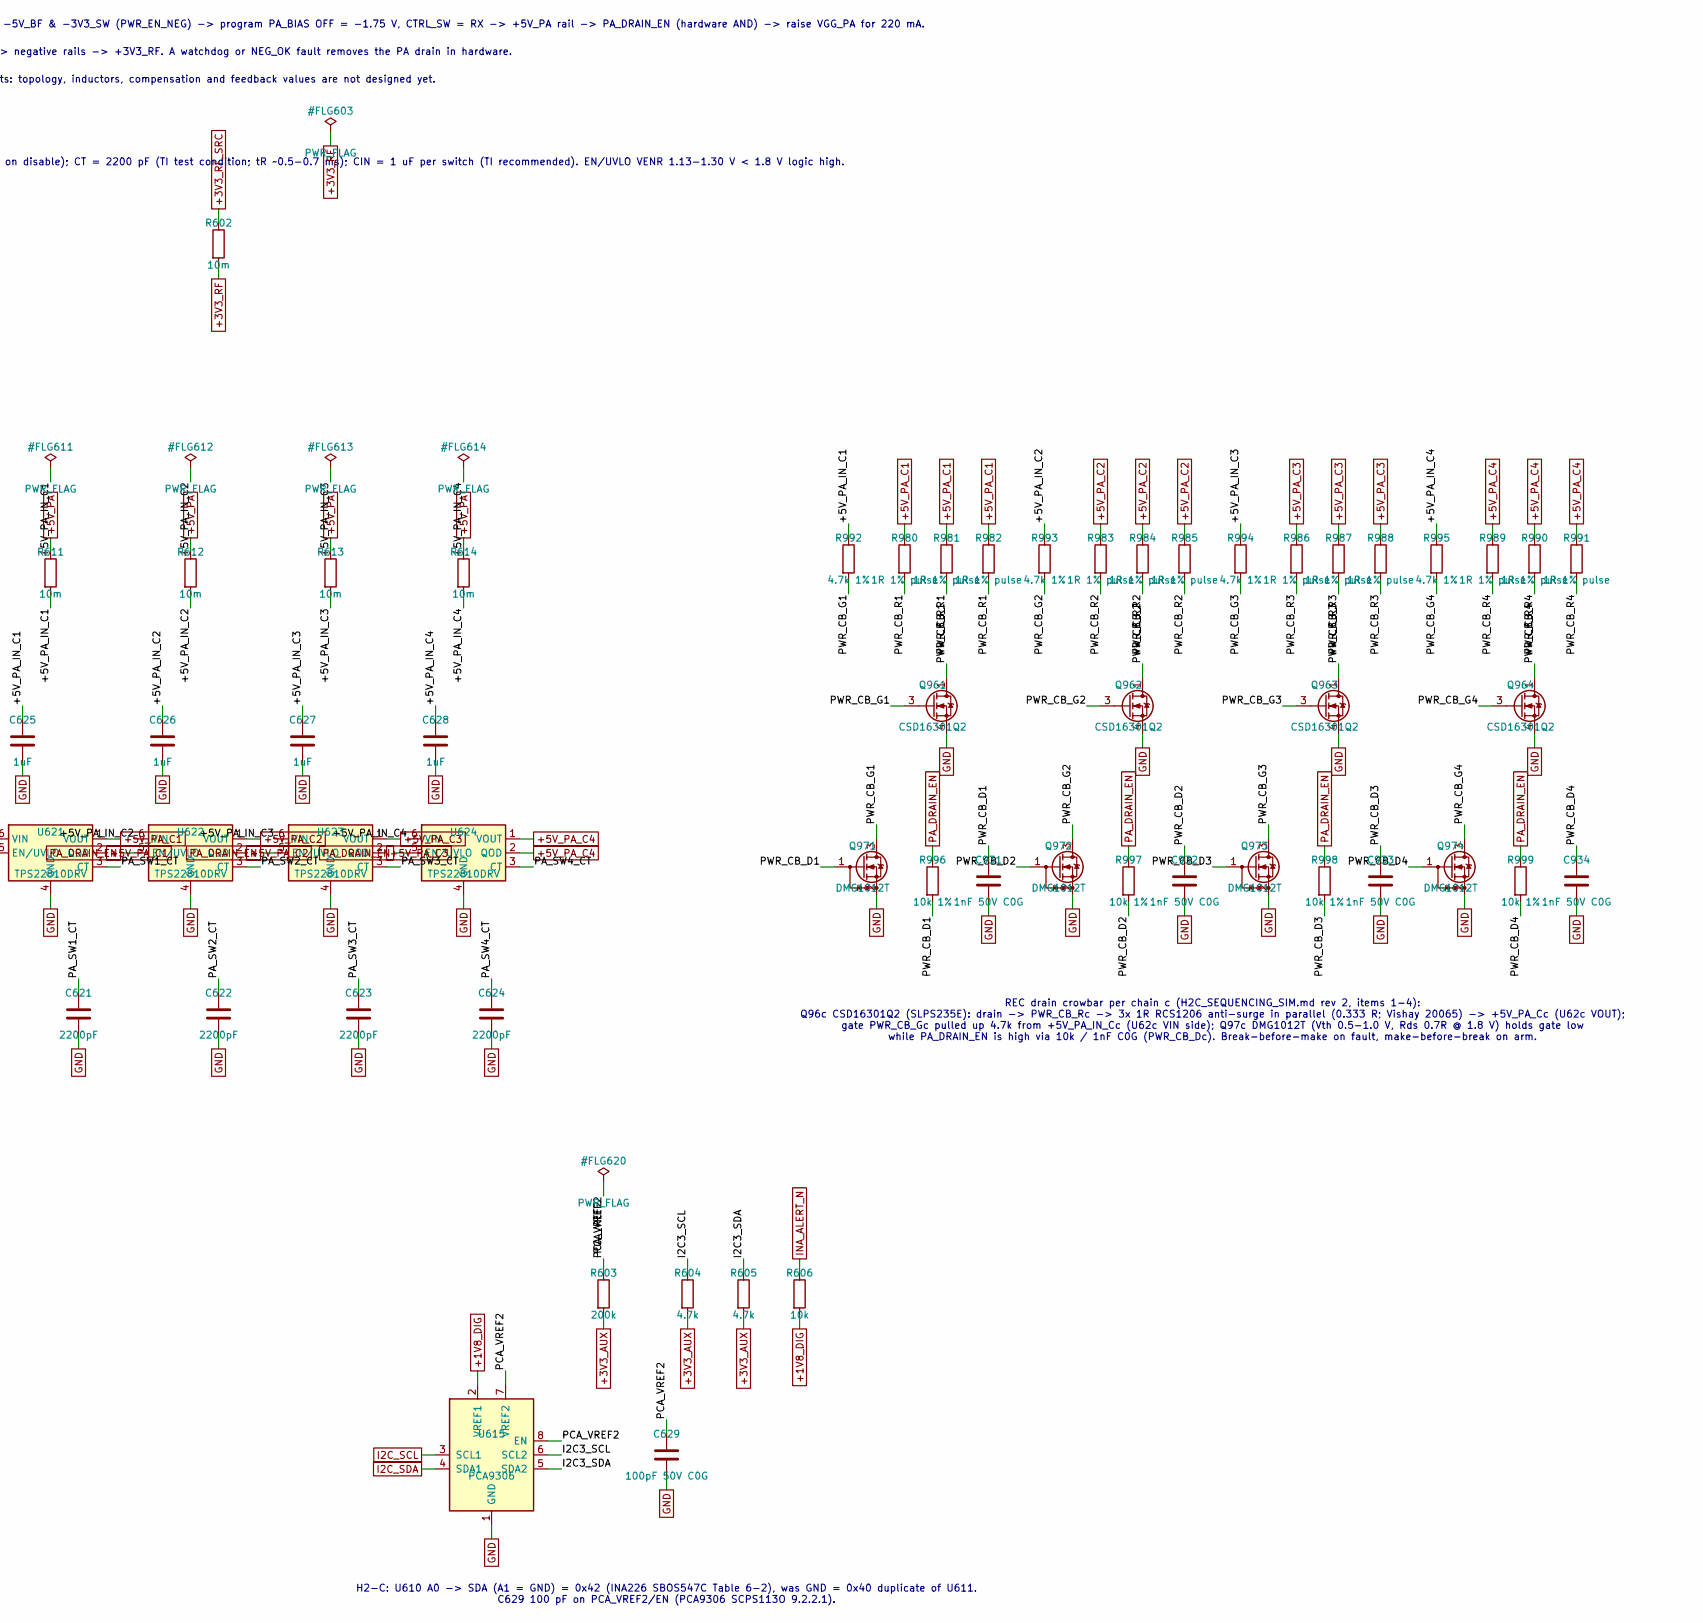
[picture p59: schematic power.kicad_sch, part in row 1, column 2]

Parts:
C621, C622, C623, C624: 2200pF; C_0402_1005Metric
C625, C626, C627, C628: 1uF; C_0603_1608Metric
C629: 100pF 50V C0G; C_0402_1005Metric
C931, C932, C933, C934: 1nF 50V C0G; C_0402_1005Metric
J601: VIN 12V bench
Q961, Q962, Q963, Q964: CSD16301Q2; Texas_DQK; MPN TI CSD16301Q2
Q971, Q972, Q973, Q974: DMG1012T; SOT-523; MPN Diodes DMG1012T-7
R602, R611, R612, R613, R614: 10m; R_1206_3216Metric
R603: 200k; R_0402_1005Metric
R604, R605: 4.7k; R_0402_1005Metric
R606: 10k; R_0402_1005Metric
R980, R981, R982, R983, R984, R985, R986, R987, R988, R989, R990, R991: 1R 1% pulse; R_1206_3216Metric; MPN Vishay RCS12061R00FKEA
R992, R993, R994, R995: 4.7k 1%; R_0402_1005Metric
R996, R997, R998, R999: 10k 1%; R_0402_1005Metric
U610, U611, U612, U613, U614: INA226; MPN INA226AIDGSR
U615: PCA9306; VSSOP-8_2.3x2mm_P0.5mm
U621, U622, U623, U624: TPS22810DRV; MPN TPS22810DRVR

Connections:
+1V8_DIG: R606.2, U615.2 (VREF1)
+3V3_AUX: R603.2, R604.2, R605.2, U610.6 (VS), U611.6 (VS), U612.2 (A0), U612.6 (VS), U613.1 (A1), U613.6 (VS), U614.1 (A1), U614.2 (A0), U614.6 (VS)
+3V3_RF: R602.2, U610.8 (Vbus), U610.9 (Vin-)
+3V3_RF_SRC: R602.1, U610.10 (Vin+)
+5V_PA: R611.1, R612.1, R613.1, R614.1, U611.10 (Vin+), U612.10 (Vin+), U613.10 (Vin+), U614.10 (Vin+)
+5V_PA_C1: R980.1, R981.1, R982.1, U621.1 (VOUT), U621.2 (QOD)
+5V_PA_C2: R983.1, R984.1, R985.1, U622.1 (VOUT), U622.2 (QOD)
+5V_PA_C3: R986.1, R987.1, R988.1, U623.1 (VOUT), U623.2 (QOD)
+5V_PA_C4: R989.1, R990.1, R991.1, U624.1 (VOUT), U624.2 (QOD)
+5V_PA_IN_C1: C625.1, R611.2, R992.1, U611.8 (Vbus), U611.9 (Vin-), U621.6 (VIN)
+5V_PA_IN_C2: C626.1, R612.2, R993.1, U612.8 (Vbus), U612.9 (Vin-), U622.6 (VIN)
+5V_PA_IN_C3: C627.1, R613.2, R994.1, U613.8 (Vbus), U613.9 (Vin-), U623.6 (VIN)
+5V_PA_IN_C4: C628.1, R614.2, R995.1, U614.8 (Vbus), U614.9 (Vin-), U624.6 (VIN)
GND: C621.2, C622.2, C623.2, C624.2, C625.2, C626.2, C627.2, C628.2, C629.2, C931.2, C932.2, C933.2, C934.2, J601.2, Q961.4 (S), Q961.7 (S), Q962.4 (S), Q962.7 (S), Q963.4 (S), Q963.7 (S), Q964.4 (S), Q964.7 (S), Q971.2 (S), Q972.2 (S), Q973.2 (S), Q974.2 (S), U610.1 (A1), U610.7 (GND), U611.1 (A1), U611.2 (A0), U611.7 (GND), U612.1 (A1), U612.7 (GND), U613.2 (A0), U613.7 (GND), U614.7 (GND), U615.1 (GND), U621.4 (GND), U621.7 (GND), U622.4 (GND), U622.7 (GND), U623.4 (GND), U623.7 (GND), U624.4 (GND), U624.7 (GND)
I2C3_SCL: R604.1, U610.5 (SCL), U611.5 (SCL), U612.5 (SCL), U613.5 (SCL), U614.5 (SCL), U615.6 (SCL2)
I2C3_SDA: R605.1, U610.2 (A0), U610.4 (SDA), U611.4 (SDA), U612.4 (SDA), U613.4 (SDA), U614.4 (SDA), U615.5 (SDA2)
I2C_SCL: U615.3 (SCL1)
I2C_SDA: U615.4 (SDA1)
INA_ALERT_N: R606.1, U610.3 (~Alert), U611.3 (~Alert), U612.3 (~Alert), U613.3 (~Alert), U614.3 (~Alert)
PA_DRAIN_EN: R996.1, R997.1, R998.1, R999.1, U621.5 (EN/UVLO), U622.5 (EN/UVLO), U623.5 (EN/UVLO), U624.5 (EN/UVLO)
PA_SW1_CT: C621.1, U621.3 (CT)
PA_SW2_CT: C622.1, U622.3 (CT)
PA_SW3_CT: C623.1, U623.3 (CT)
PA_SW4_CT: C624.1, U624.3 (CT)
PCA_VREF2: C629.1, R603.1, U615.7 (VREF2), U615.8 (EN)
PWR_CB_D1: C931.1, Q971.1 (G), R996.2
PWR_CB_D2: C932.1, Q972.1 (G), R997.2
PWR_CB_D3: C933.1, Q973.1 (G), R998.2
PWR_CB_D4: C934.1, Q974.1 (G), R999.2
PWR_CB_G1: Q961.3 (G), Q971.3 (D), R992.2
PWR_CB_G2: Q962.3 (G), Q972.3 (D), R993.2
PWR_CB_G3: Q963.3 (G), Q973.3 (D), R994.2
PWR_CB_G4: Q964.3 (G), Q974.3 (D), R995.2
PWR_CB_R1: Q961.1 (D), Q961.2 (D), Q961.5 (D), Q961.6 (D), Q961.8 (D), R980.2, R981.2, R982.2
PWR_CB_R2: Q962.1 (D), Q962.2 (D), Q962.5 (D), Q962.6 (D), Q962.8 (D), R983.2, R984.2, R985.2
PWR_CB_R3: Q963.1 (D), Q963.2 (D), Q963.5 (D), Q963.6 (D), Q963.8 (D), R986.2, R987.2, R988.2
PWR_CB_R4: Q964.1 (D), Q964.2 (D), Q964.5 (D), Q964.6 (D), Q964.8 (D), R989.2, R990.2, R991.2
VIN_12V: J601.1

Notes on the sheet:
Power-up order (ADAR1000 Rev B p44-45 + ADTR1107 Rev C p24): +1V8_DIG/+3V3_AUX (always on) -> MCU -> +3V3_RF (VDD_SW, VDD_LNA, AVDD3) -> -5V_BF & -3V3_SW (PWR_EN_NEG) -> program PA_BIAS OFF = -1.75 V, CTRL_SW = RX -> +5V_PA rail -> PA_DRAIN_EN (hardware AND) -> raise VGG_PA for 220 mA.
Power-down: TX off (BF_TR low) -> PA_BIAS to -1.75 V -> PA_DRAIN_EN low -> negative rails -> +3V3_RF. A watchdog or NEG_OK fault removes the PA drain in hardware.
All regulator blocks are UNRESOLVED placeholders (TBD_*), not parts: topology, inductors, compensation and feedback values are not designed yet.
H2-B PA drain switches U621-U624 (TI TPS22810 SLVSDH0C): QOD tied to VOUT (internal RPD 250-400 ohm at 5 V -> fast drain discharge on disable); CT = 2200 pF (TI test condition; tR ~0.5-0.7 ms); CIN = 1 uF per switch (TI recommended). EN/UVLO VENR 1.13-1.30 V < 1.8 V logic high.
H2-C: U610 A0 -> SDA (A1 = GND) = 0x42 (INA226 SBOS547C Table 6-2), was GND = 0x40 duplicate of U611. C629 100 pF on PCA_VREF2/EN (PCA9306 SCPS113O 9.2.2.1).
REC drain crowbar per chain c (H2C_SEQUENCING_SIM.md rev 2, items 1-4): Q96c CSD16301Q2 (SLPS235E): drain -> PWR_CB_Rc -> 3x 1R RCS1206 anti-surge in parallel (0.333 R; Vishay 20065) -> +5V_PA_Cc (U62c VOUT); gate PWR_CB_Gc pulled up 4.7k from +5V_PA_IN_Cc (U62c VIN side); Q97c DMG1012T (Vth 0.5-1.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
