CLIS-WPI/OpenRU/hardware/h2/schematics/pwr_lo.kicad_sch

## KiCad design hardware/h2/schematics/pwr_lo.kicad_sch (2026-11-12)

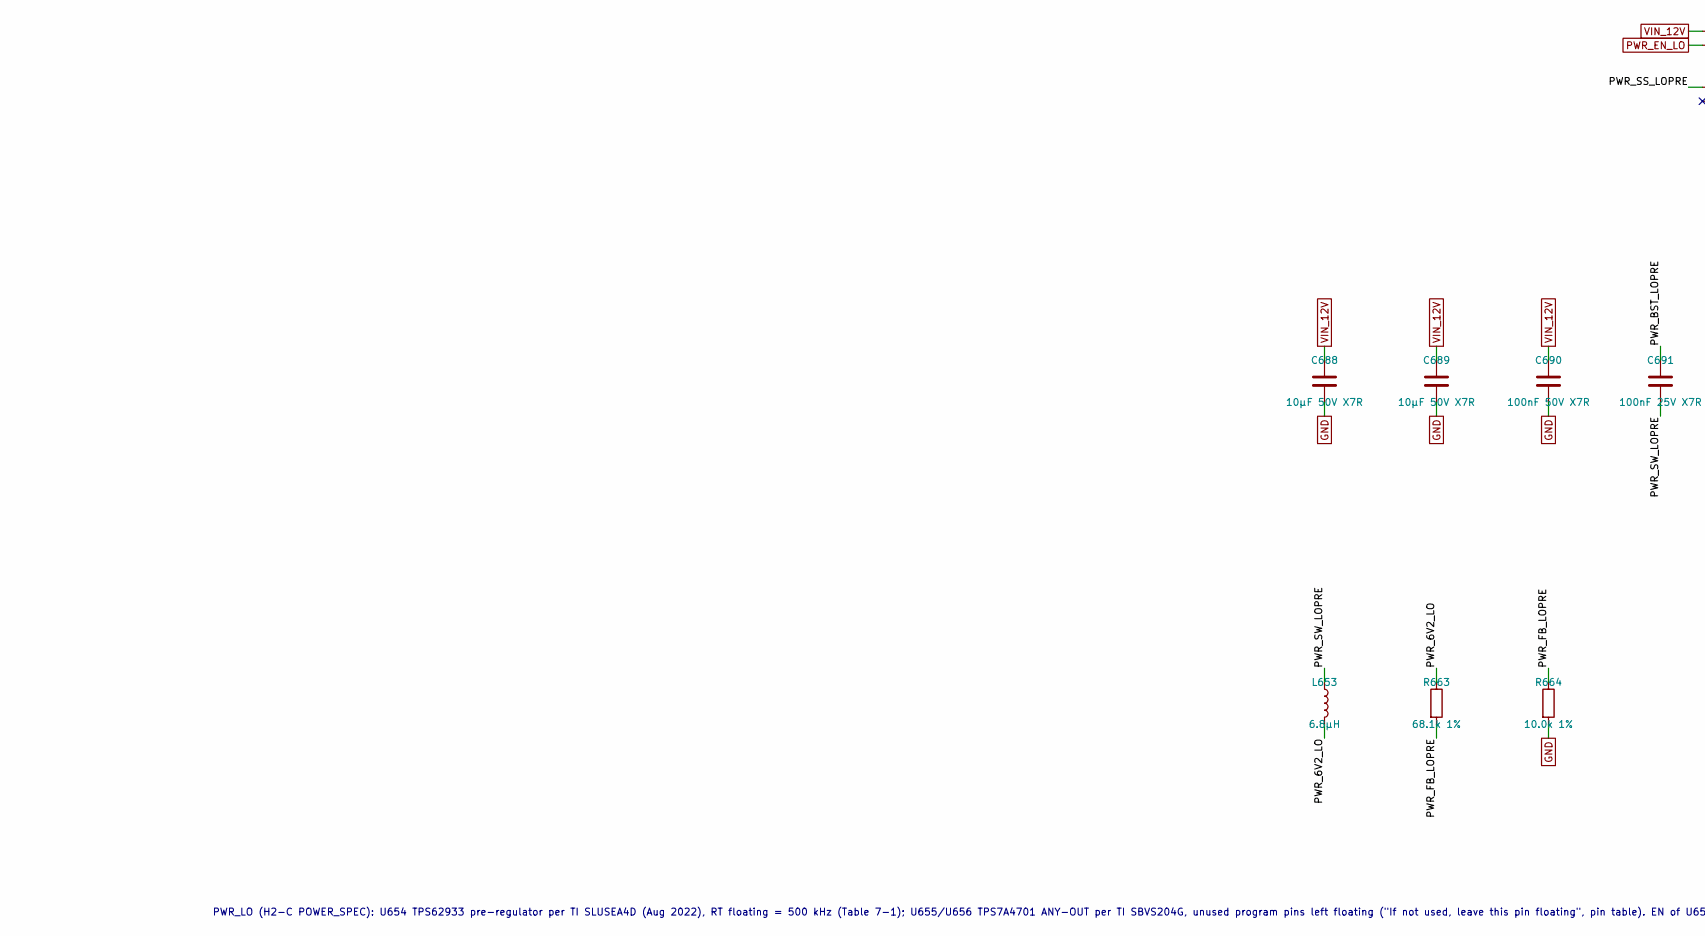
[picture p60: schematic pwr_lo.kicad_sch, part in row 1, column 1]

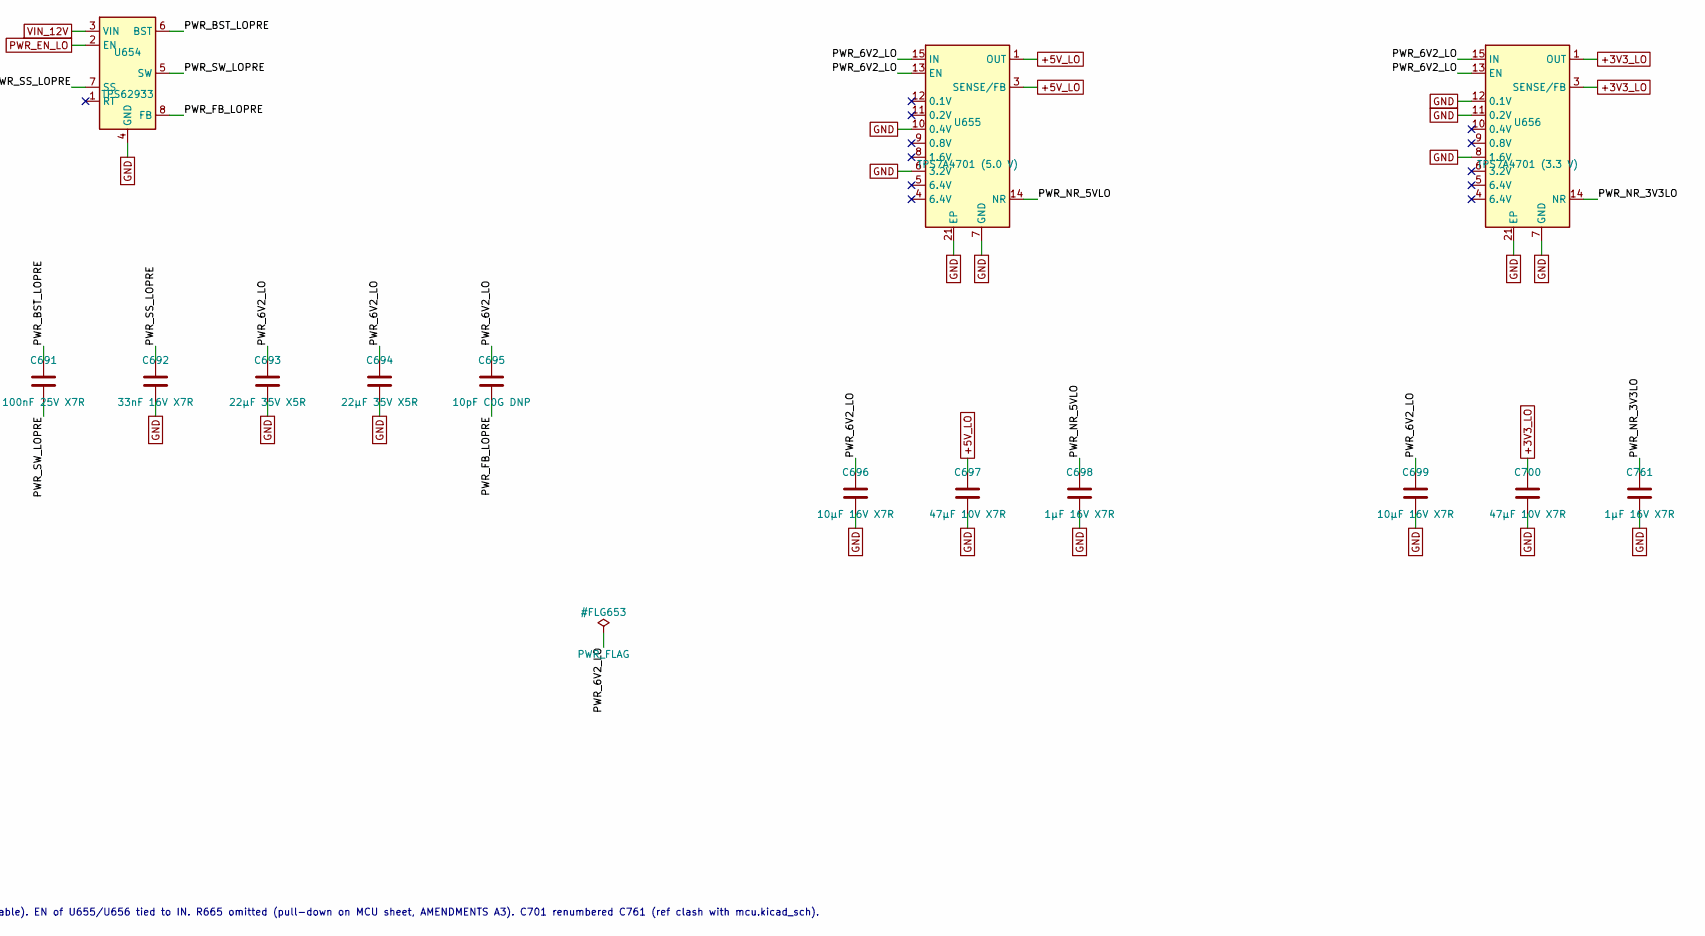
[picture p61: schematic pwr_lo.kicad_sch, part in row 1, column 2]

Parts:
C688, C689: 10µF 50V X7R; C_1206_3216Metric; MPN CGA5L1X7R1H106K160AC
C690: 100nF 50V X7R; C_0402_1005Metric
C691: 100nF 25V X7R; C_0402_1005Metric
C692: 33nF 16V X7R; C_0402_1005Metric
C693, C694: 22µF 35V X5R; C_1206_3216Metric; MPN C3216X5R1V226M160AC
C695: 10pF C0G DNP; C_0402_1005Metric
C696, C699: 10µF 16V X7R; C_1206_3216Metric
C697, C700: 47µF 10V X7R; C_1210_3225Metric
C698, C761: 1µF 16V X7R; C_0603_1608Metric
L653: 6.8µH; L_Wuerth_XHMI-6060; MPN 74439346068
R663: 68.1k 1%; R_0402_1005Metric
R664: 10.0k 1%; R_0402_1005Metric
U654: TPS62933; SOT-583-8; MPN TPS62933DRLR
U655: TPS7A4701 (5.0 V); Texas_RGW0020A_VQFN-20-1EP_5x5mm_P0.65mm_EP3.15x3.15mm_Ther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; MPN TPS7A4701RGWR
U656: TPS7A4701 (3.3 V); Texas_RGW0020A_VQFN-20-1EP_5x5mm_P0.65mm_EP3.15x3.15mm_Ther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; MPN TPS7A4701RGWR

Connections:
+3V3_LO: C700.1, U656.1 (OUT), U656.3 (SENSE/FB), U656.20 (OUT)
+5V_LO: C697.1, U655.1 (OUT), U655.3 (SENSE/FB), U655.20 (OUT)
GND: C688.2, C689.2, C690.2, C692.2, C693.2, C694.2, C696.2, C697.2, C698.2, C699.2, C700.2, C761.2, R664.2, U654.4 (GND), U655.6 (3.2V), U655.7 (GND), U655.10 (0.4V), U655.21 (EP), U656.7 (GND), U656.8 (1.6V), U656.11 (0.2V), U656.12 (0.1V), U656.21 (EP)
PWR_6V2_LO: C693.1, C694.1, C695.1, C696.1, C699.1, L653.2, R663.1, U655.13 (EN), U655.15 (IN), U655.16 (IN), U656.13 (EN), U656.15 (IN), U656.16 (IN)
PWR_BST_LOPRE: C691.1, U654.6 (BST)
PWR_EN_LO: U654.2 (EN)
PWR_FB_LOPRE: C695.2, R663.2, R664.1, U654.8 (FB)
PWR_NR_3V3LO: C761.1, U656.14 (NR)
PWR_NR_5VLO: C698.1, U655.14 (NR)
PWR_SS_LOPRE: C692.1, U654.7 (SS)
PWR_SW_LOPRE: C691.2, L653.1, U654.5 (SW)
VIN_12V: C688.1, C689.1, C690.1, U654.3 (VIN)

Notes on the sheet:
PWR_LO (H2-C POWER_SPEC): U654 TPS62933 pre-regulator per TI SLUSEA4D (Aug 2022), RT floating = 500 kHz (Table 7-1); U655/U656 TPS7A4701 ANY-OUT per TI SBVS204G, unused program pins left floating ("If not used, leave this pin floating", pin table). EN of U655/U656 tied to IN. R665 omitted (pull-dow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
