CLIS-WPI/OpenRU/hardware/h2/schematics/pwr_main.kicad_sch

## KiCad design hardware/h2/schematics/pwr_main.kicad_sch (2026-11-12)

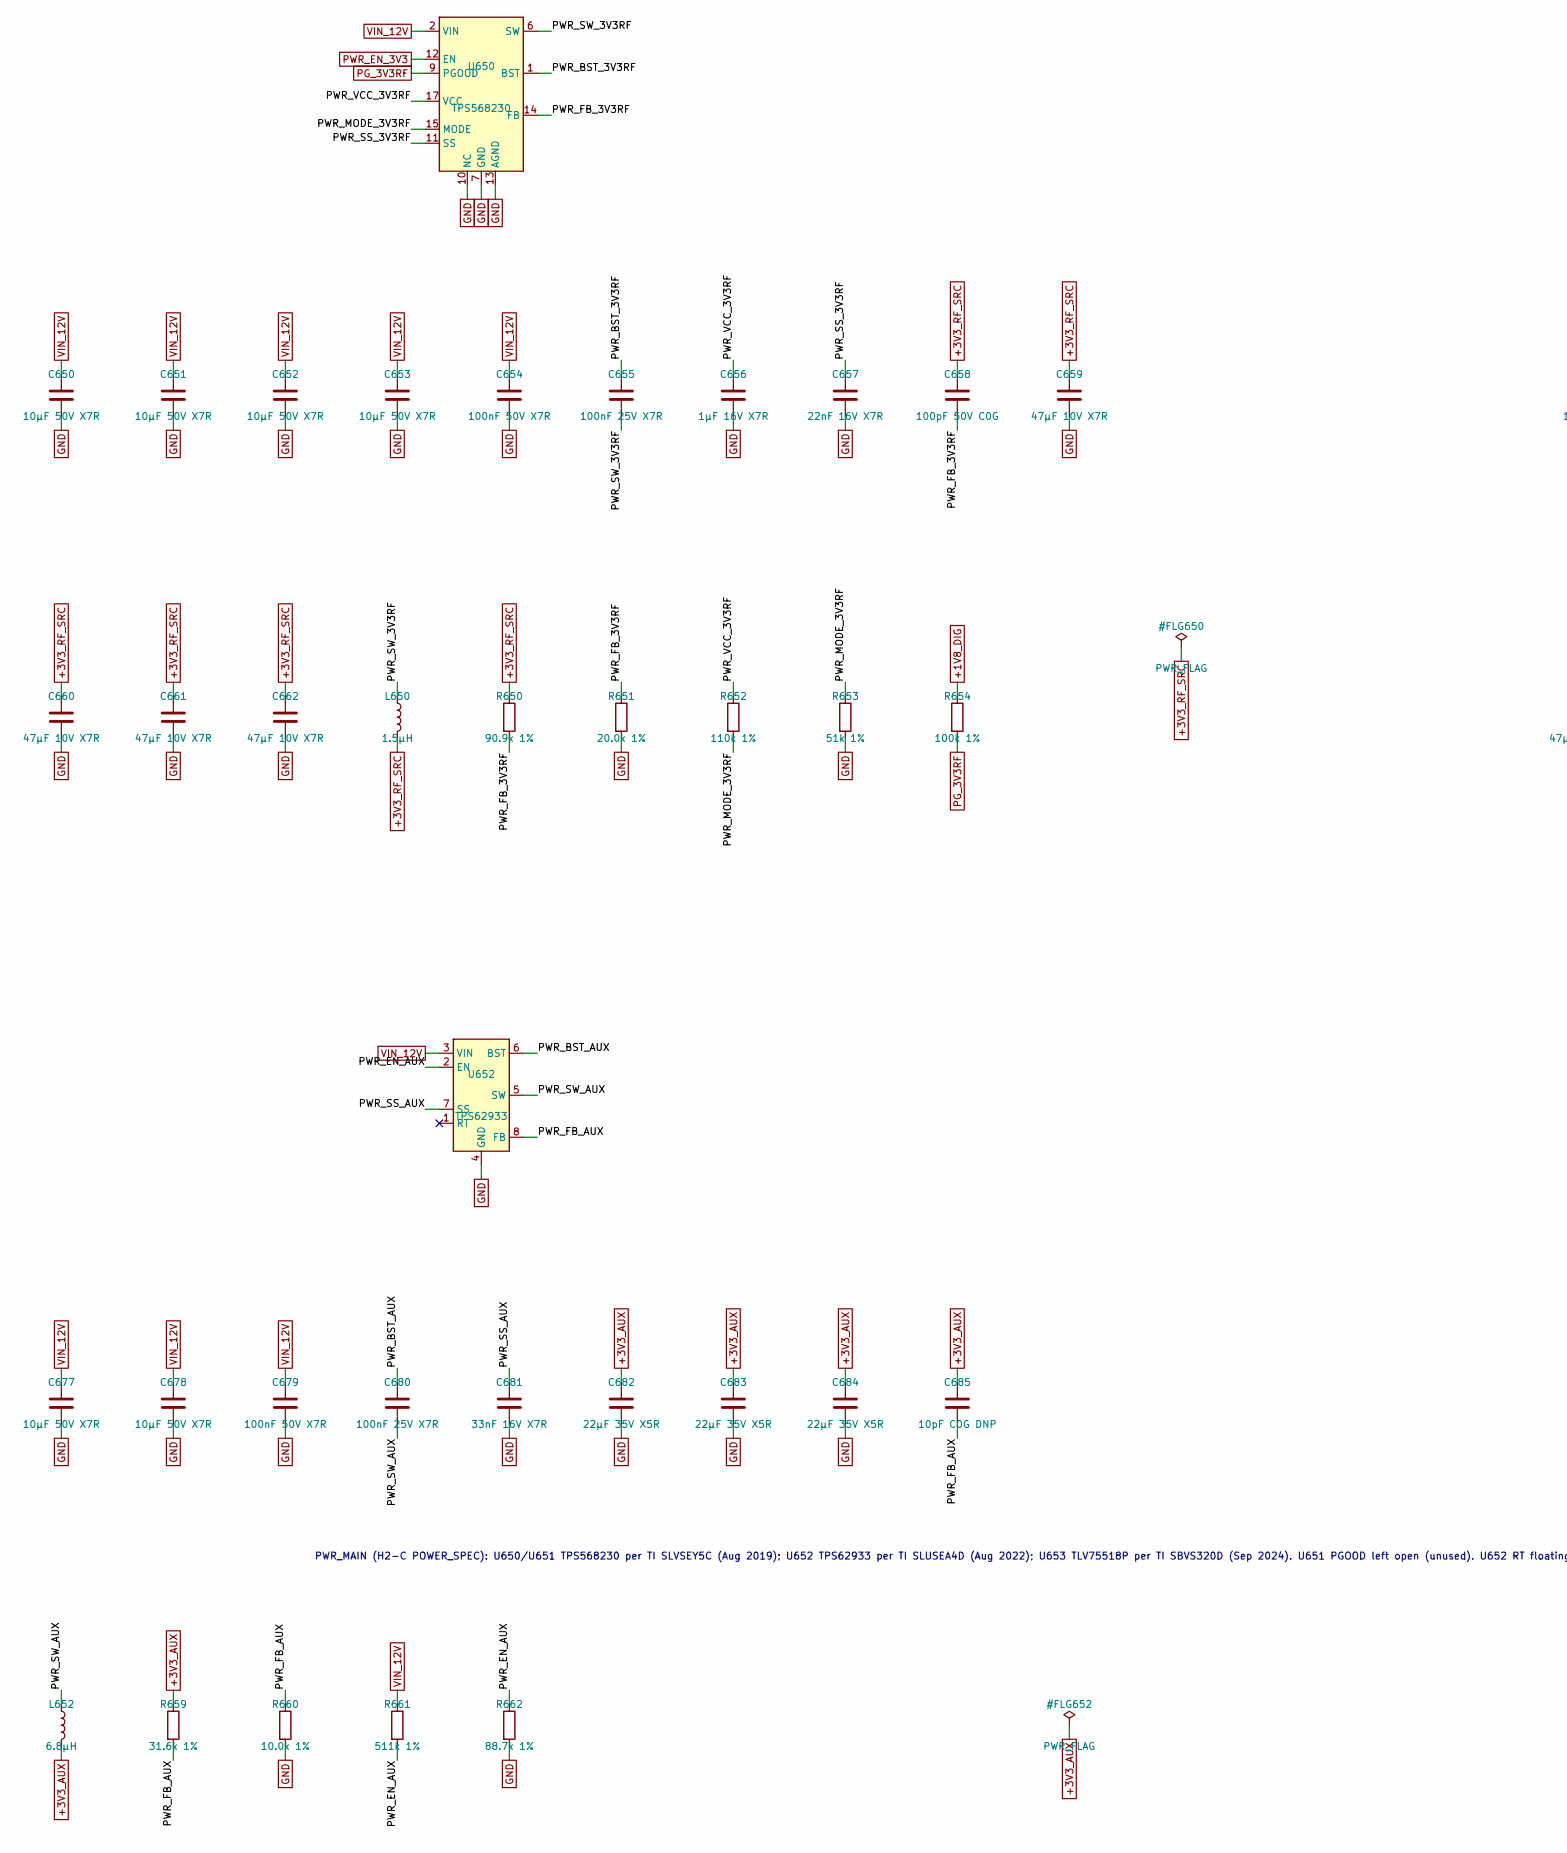
[picture p62: schematic pwr_main.kicad_sch, part in row 1, column 1]

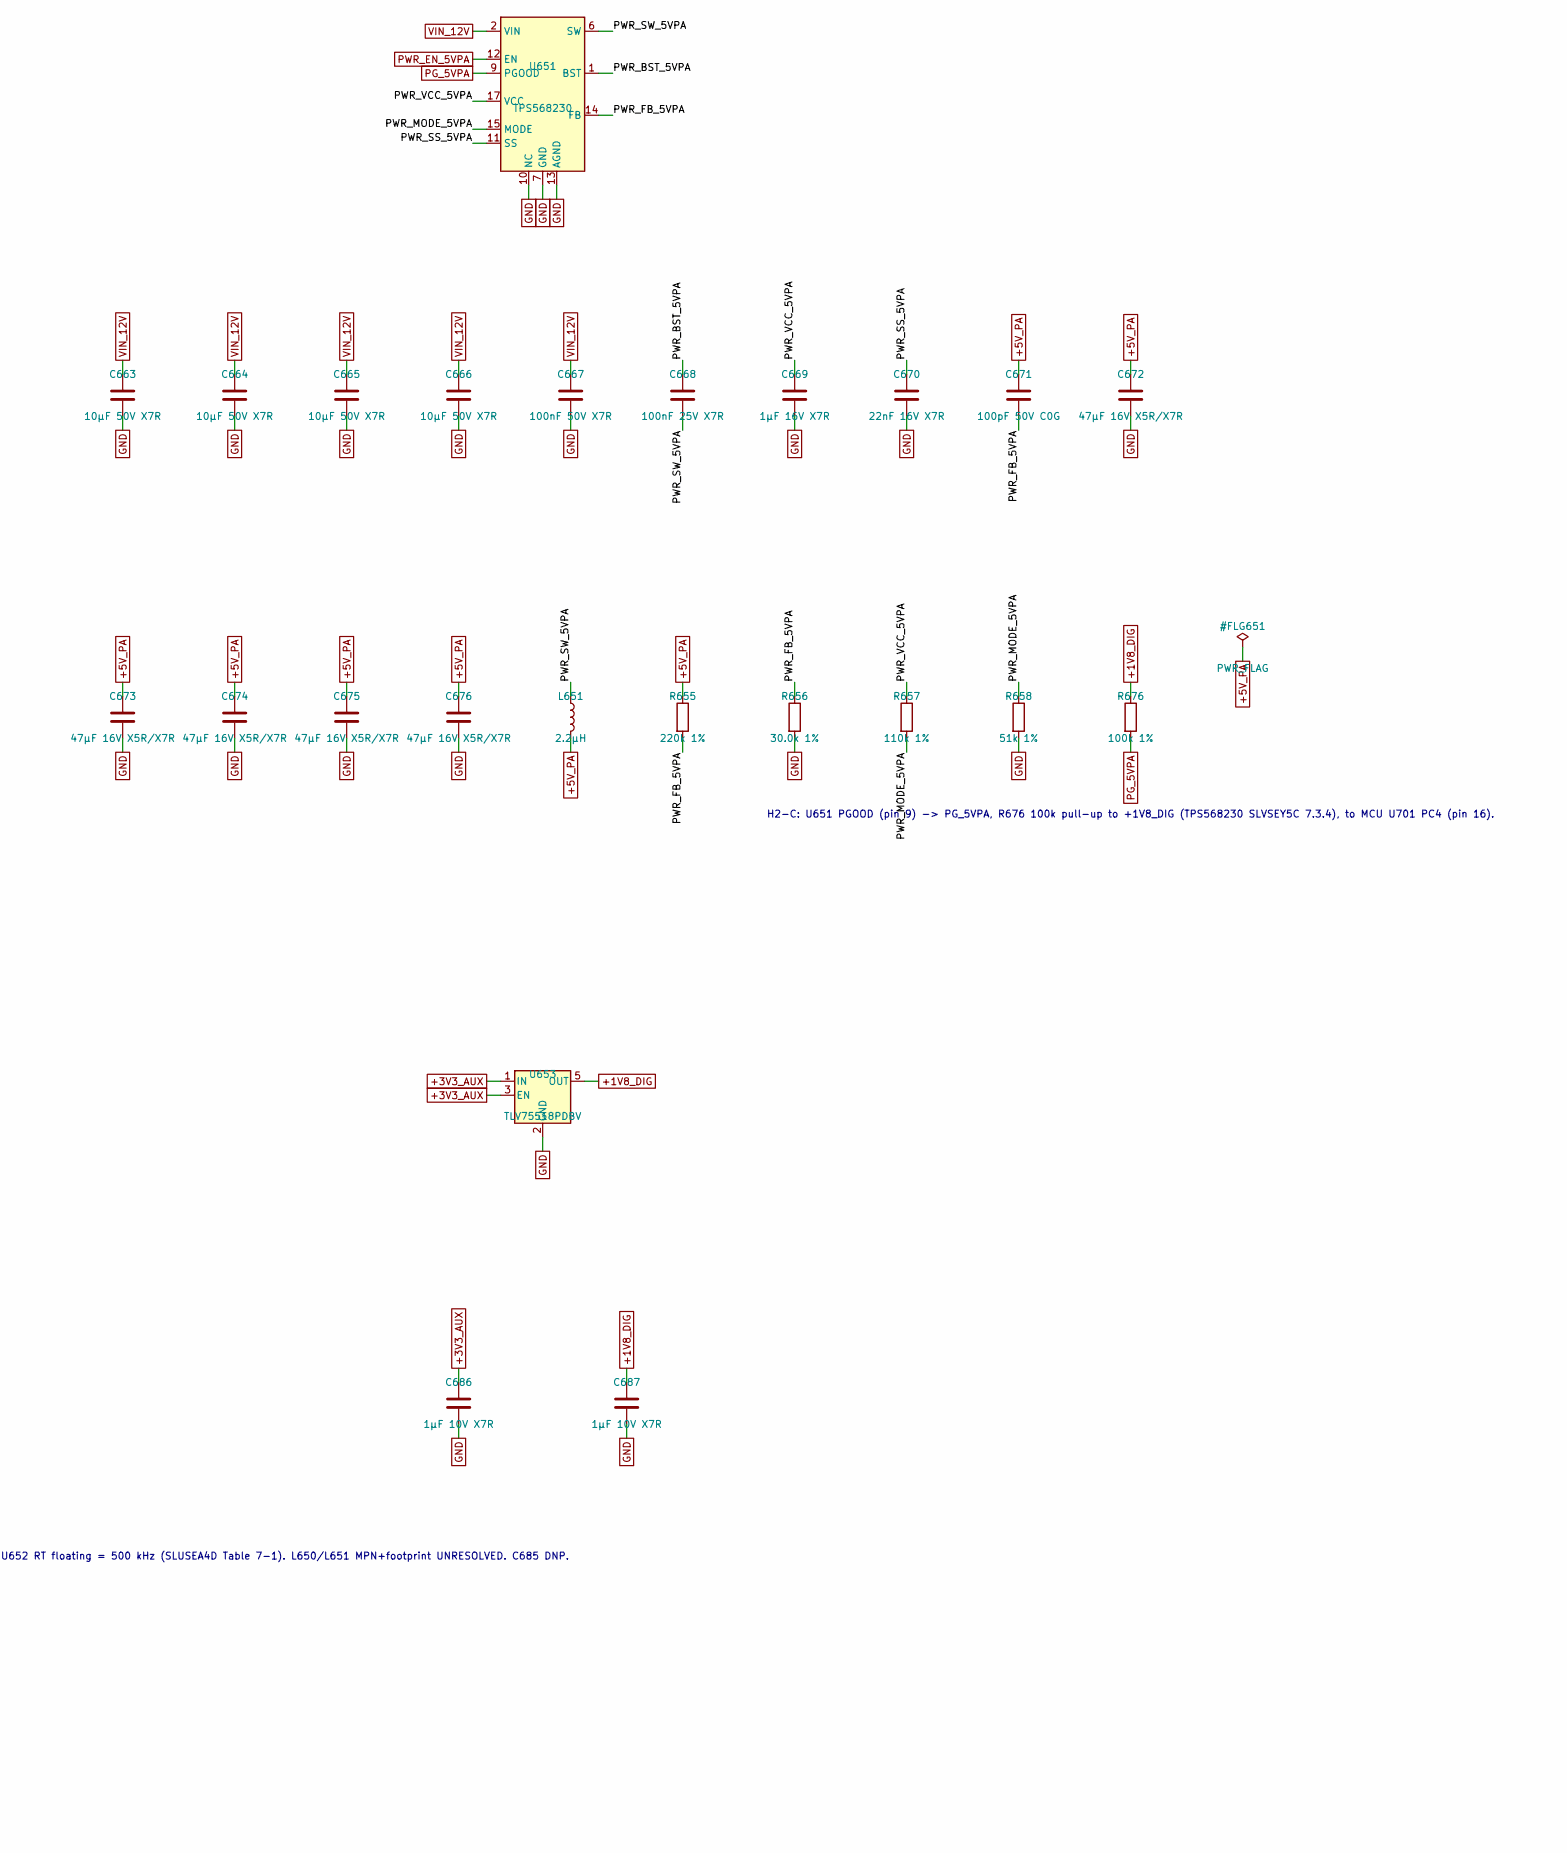
[picture p63: schematic pwr_main.kicad_sch, part in row 1, column 2]

Parts:
C650, C651, C652, C653, C663, C664, C665, C666, C677, C678: 10µF 50V X7R; C_1206_3216Metric; MPN CGA5L1X7R1H106K160AC
C654, C667, C679: 100nF 50V X7R; C_0402_1005Metric
C655, C668, C680: 100nF 25V X7R; C_0402_1005Metric
C656, C669: 1µF 16V X7R; C_0603_1608Metric
C657, C670: 22nF 16V X7R; C_0402_1005Metric
C658, C671: 100pF 50V C0G; C_0402_1005Metric
C659, C660, C661, C662: 47µF 10V X7R; C_1210_3225Metric
C672, C673, C674, C675, C676: 47µF 16V X5R/X7R; C_1210_3225Metric
C681: 33nF 16V X7R; C_0402_1005Metric
C682, C683, C684: 22µF 35V X5R; C_1206_3216Metric; MPN C3216X5R1V226M160AC
C685: 10pF C0G DNP; C_0402_1005Metric
C686, C687: 1µF 10V X7R; C_0603_1608Metric
L650: 1.5µH
L651: 2.2µH
L652: 6.8µH; L_Wuerth_XHMI-6060; MPN 74439346068
R650: 90.9k 1%; R_0402_1005Metric
R651: 20.0k 1%; R_0402_1005Metric
R652, R657: 110k 1%; R_0402_1005Metric
R653, R658: 51k 1%; R_0402_1005Metric
R654, R676: 100k 1%; R_0402_1005Metric
R655: 220k 1%; R_0402_1005Metric
R656: 30.0k 1%; R_0402_1005Metric
R659: 31.6k 1%; R_0402_1005Metric
R660: 10.0k 1%; R_0402_1005Metric
R661: 511k 1%; R_0402_1005Metric
R662: 88.7k 1%; R_0402_1005Metric
U650, U651: TPS568230; Texas_RJE0020A_VQFN-20-1EP_3x3mm_P0.45mm_EP0.675x0.76mm; MPN TPS568230RJER
U652: TPS62933; SOT-583-8; MPN TPS62933DRLR
U653: TLV75518PDBV; SOT-23-5; MPN TLV75518PDBVR

Connections:
+1V8_DIG: C687.1, R654.1, R676.1, U653.5 (OUT)
+3V3_AUX: C682.1, C683.1, C684.1, C685.1, C686.1, L652.2, R659.1, U653.1 (IN), U653.3 (EN)
+3V3_RF_SRC: C658.1, C659.1, C660.1, C661.1, C662.1, L650.2, R650.1
+5V_PA: C671.1, C672.1, C673.1, C674.1, C675.1, C676.1, L651.2, R655.1
GND: C650.2, C651.2, C652.2, C653.2, C654.2, C656.2, C657.2, C659.2, C660.2, C661.2, C662.2, C663.2, C664.2, C665.2, C666.2, C667.2, C669.2, C670.2, C672.2, C673.2, C674.2, C675.2, C676.2, C677.2, C678.2, C679.2, C681.2, C682.2, C683.2, C684.2, C686.2, C687.2, R651.2, R653.2, R656.2, R658.2, R660.2, R662.2, U650.7 (GND), U650.8 (GND), U650.10 (NC), U650.13 (AGND), U650.16 (NC), U650.18 (GND), U650.21 (GND), U651.7 (GND), U651.8 (GND), U651.10 (NC), U651.13 (AGND), U651.16 (NC), U651.18 (GND), U651.21 (GND), U652.4 (GND), U653.2 (GND)
PG_3V3RF: R654.2, U650.9 (PGOOD)
PG_5VPA: R676.2, U651.9 (PGOOD)
PWR_BST_3V3RF: C655.1, U650.1 (BST)
PWR_BST_5VPA: C668.1, U651.1 (BST)
PWR_BST_AUX: C680.1, U652.6 (BST)
PWR_EN_3V3: U650.12 (EN)
PWR_EN_5VPA: U651.12 (EN)
PWR_EN_AUX: R661.2, R662.1, U652.2 (EN)
PWR_FB_3V3RF: C658.2, R650.2, R651.1, U650.14 (FB)
PWR_FB_5VPA: C671.2, R655.2, R656.1, U651.14 (FB)
PWR_FB_AUX: C685.2, R659.2, R660.1, U652.8 (FB)
PWR_MODE_3V3RF: R652.2, R653.1, U650.15 (MODE)
PWR_MODE_5VPA: R657.2, R658.1, U651.15 (MODE)
PWR_SS_3V3RF: C657.1, U650.11 (SS)
PWR_SS_5VPA: C670.1, U651.11 (SS)
PWR_SS_AUX: C681.1, U652.7 (SS)
PWR_SW_3V3RF: C655.2, L650.1, U650.6 (SW), U650.19 (SW), U650.20 (SW)
PWR_SW_5VPA: C668.2, L651.1, U651.6 (SW), U651.19 (SW), U651.20 (SW)
PWR_SW_AUX: C680.2, L652.1, U652.5 (SW)
PWR_VCC_3V3RF: C656.1, R652.1, U650.17 (VCC)
PWR_VCC_5VPA: C669.1, R657.1, U651.17 (VCC)
VIN_12V: C650.1, C651.1, C652.1, C653.1, C654.1, C663.1, C664.1, C665.1, C666.1, C667.1, C677.1, C678.1, C679.1, R661.1, U650.2 (VIN), U650.3 (VIN), U650.4 (VIN), U650.5 (VIN), U651.2 (VIN), U651.3 (VIN), U651.4 (VIN), U651.5 (VIN), U652.3 (VIN)

Notes on the sheet:
PWR_MAIN (H2-C POWER_SPEC): U650/U651 TPS568230 per TI SLVSEY5C (Aug 2019); U652 TPS62933 per TI SLUSEA4D (Aug 2022); U653 TLV75518P per TI SBVS320D (Sep 2024). U651 PGOOD left open (unused). U652 RT floating = 500 kHz (SLUSEA4D Table 7-1). L650/L651 MPN+footprint UNRESOLVED. C685 DNP.
H2-C: U651 PGOOD (pin 9) -> PG_5VPA, R676 100k pull-up to +1V8_DIG (TPS568230 SLVSEY5C 7.3.4), to MCU U701 PC4 (pin 16).
