CLIS-WPI/OpenRU/hardware/h2/schematics/pwr_neg.kicad_sch

## KiCad design hardware/h2/schematics/pwr_neg.kicad_sch (2026-11-12)

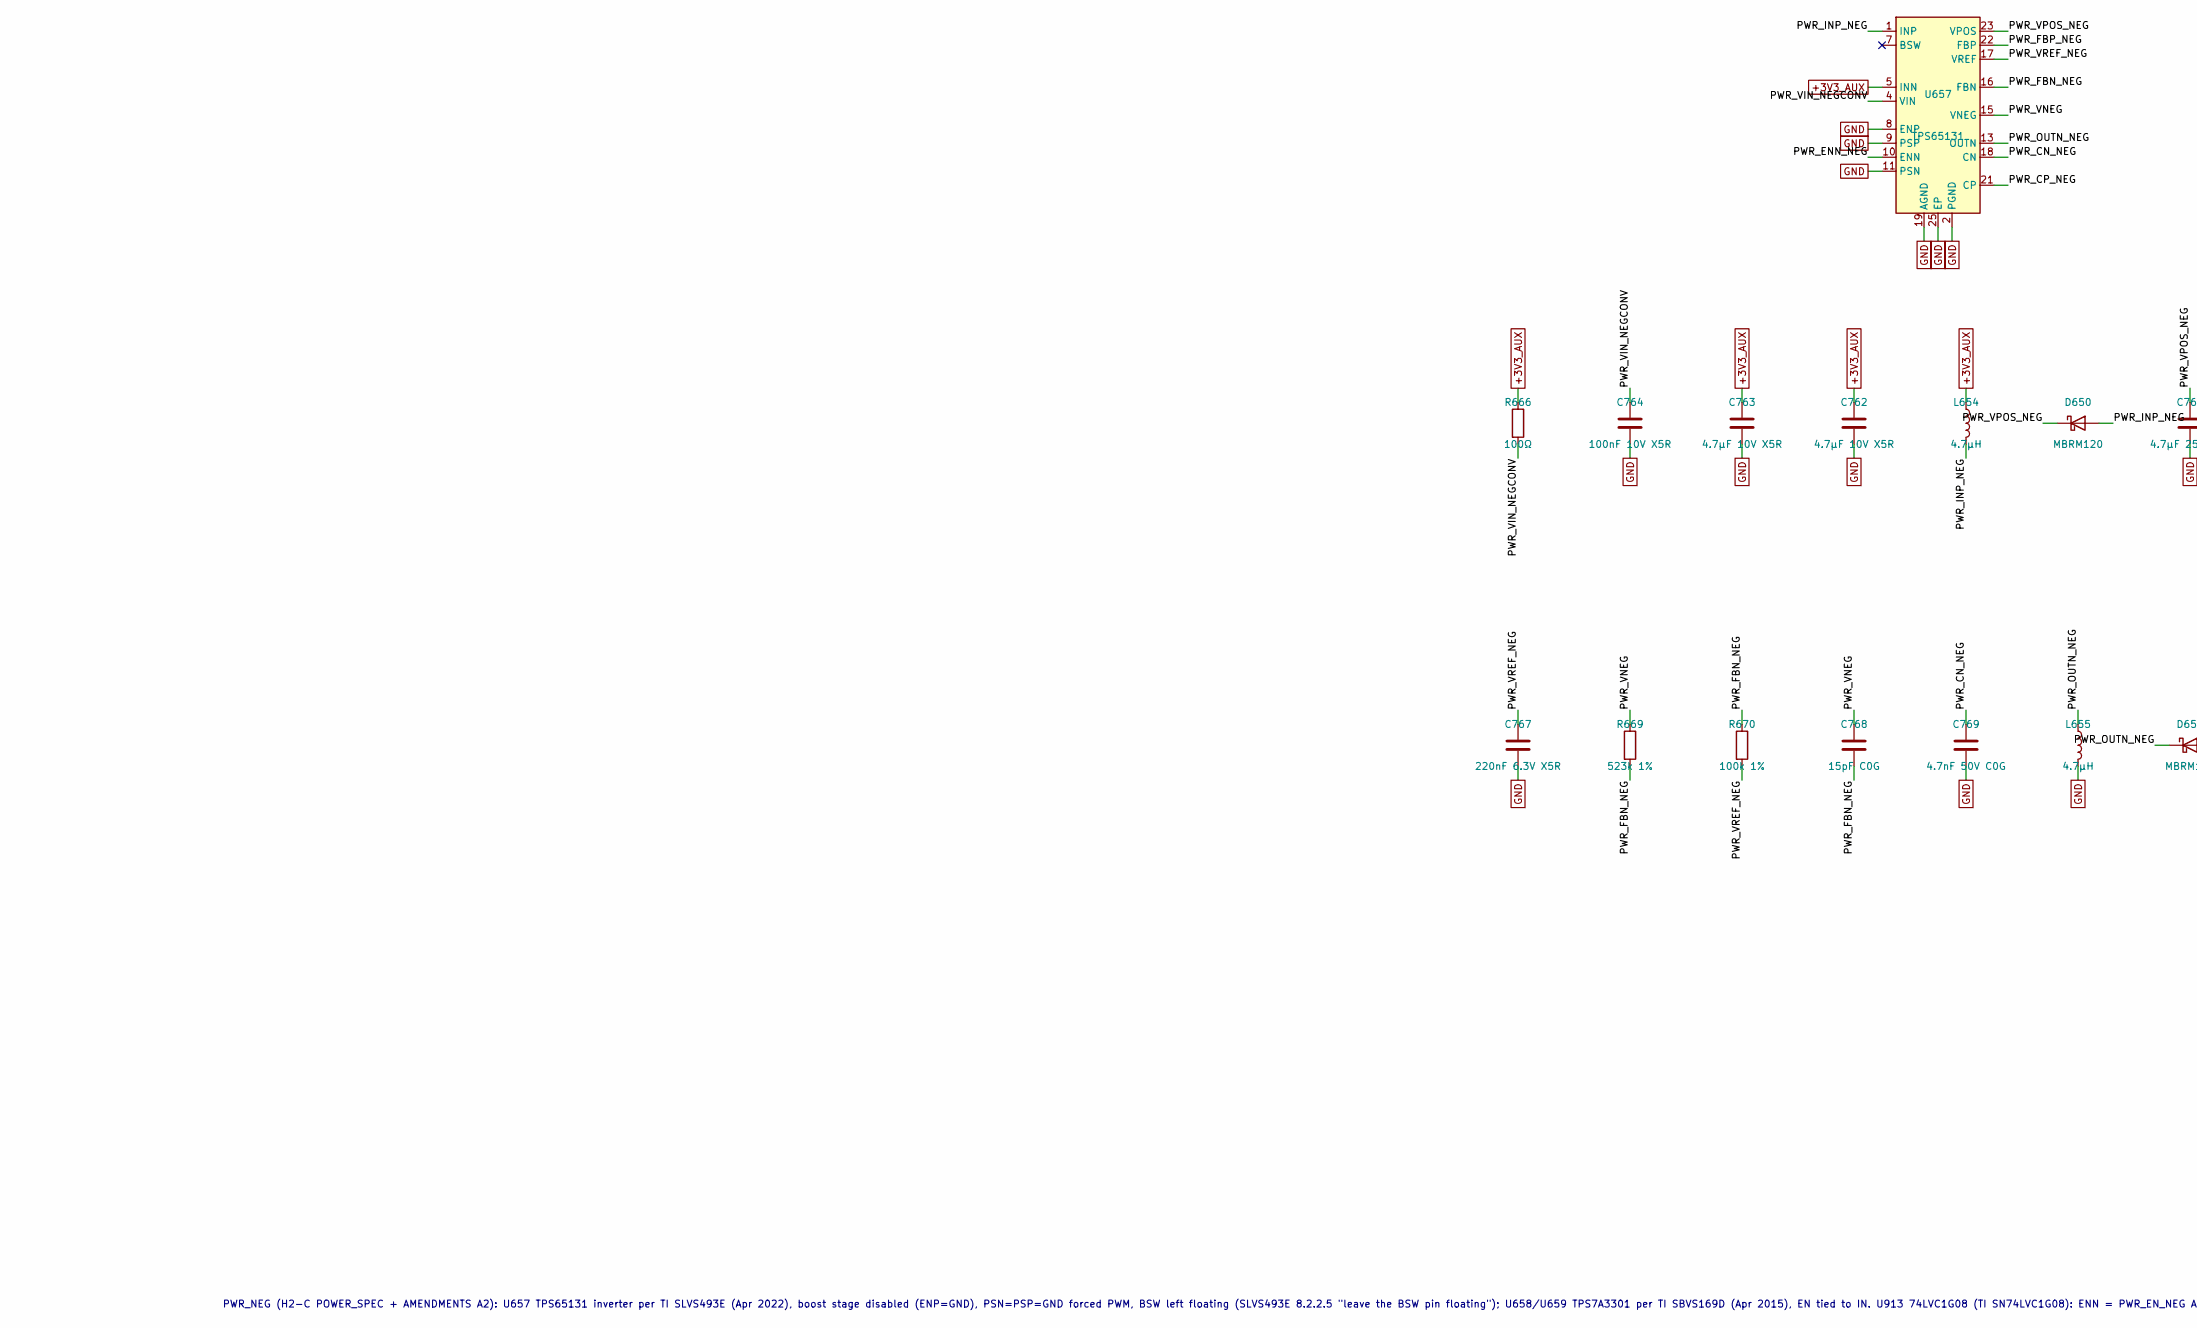
[picture p64: schematic pwr_neg.kicad_sch, part in row 1, column 1]

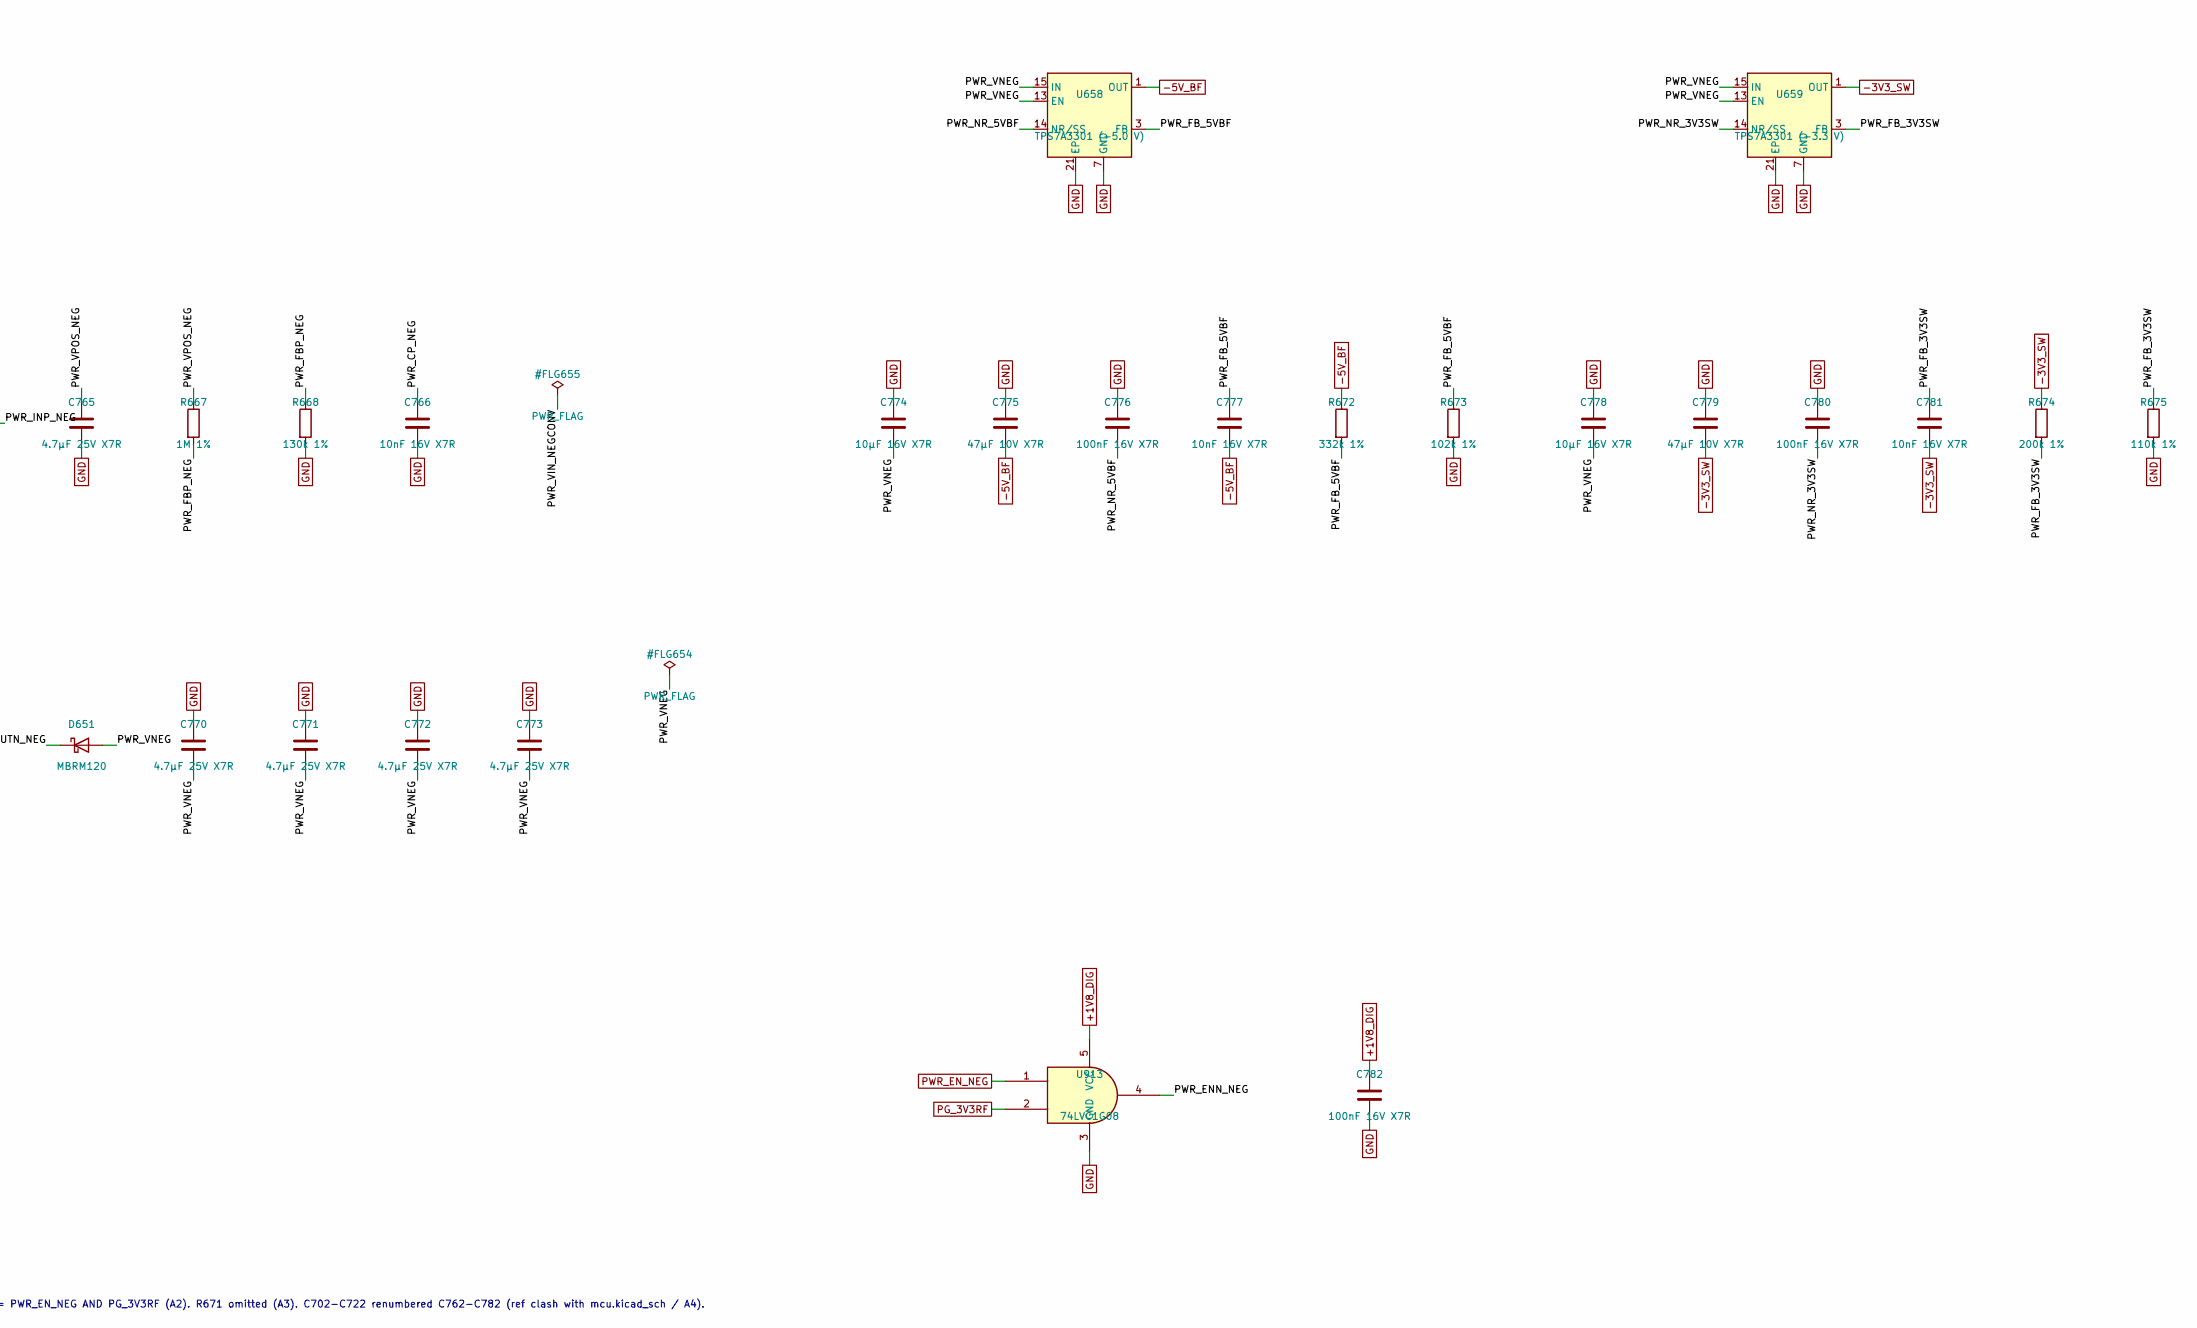
[picture p65: schematic pwr_neg.kicad_sch, part in row 1, column 2]

Parts:
C762, C763: 4.7µF 10V X5R; C_0805_2012Metric
C764: 100nF 10V X5R; C_0402_1005Metric
C765, C770, C771, C772, C773: 4.7µF 25V X7R; C_0805_2012Metric
C766, C777, C781: 10nF 16V X7R; C_0402_1005Metric
C767: 220nF 6.3V X5R; C_0402_1005Metric
C768: 15pF C0G; C_0402_1005Metric
C769: 4.7nF 50V C0G; C_0402_1005Metric
C774, C778: 10µF 16V X7R; C_1206_3216Metric
C775, C779: 47µF 10V X7R; C_1210_3225Metric
C776, C780, C782: 100nF 16V X7R; C_0402_1005Metric
D650, D651: MBRM120; D_Powermite_KA; MPN MBRM120
L654, L655: 4.7µH; L_6.3x6.3_H3; MPN B82462G4472M000
R666: 100Ω; R_0402_1005Metric
R667: 1M 1%; R_0402_1005Metric
R668: 130k 1%; R_0402_1005Metric
R669: 523k 1%; R_0402_1005Metric
R670: 100k 1%; R_0402_1005Metric
R672: 332k 1%; R_0402_1005Metric
R673: 102k 1%; R_0402_1005Metric
R674: 200k 1%; R_0402_1005Metric
R675: 110k 1%; R_0402_1005Metric
U657: TPS65131; VQFN-24-1EP_4x4mm_P0.5mm_EP2.45x2.45mm_ThermalVias; MPN TPS65131RGER
U658: TPS7A3301 (−5.0 V); Texas_RGW0020A_VQFN-20-1EP_5x5mm_P0.65mm_EP3.15x3.15mm_Ther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; MPN TPS7A3301RGWR
U659: TPS7A3301 (−3.3 V); Texas_RGW0020A_VQFN-20-1EP_5x5mm_P0.65mm_EP3.15x3.15mm_Ther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; MPN TPS7A3301RGWR
U913: 74LVC1G08; SOT-23-5; MPN SN74LVC1G08DBVR

Connections:
+1V8_DIG: C782.1, U913.5 (VCC)
+3V3_AUX: C762.1, C763.1, L654.1, R666.1, U657.5 (INN), U657.6 (INN)
-3V3_SW: C779.2, C781.2, R674.1, U659.1 (OUT), U659.20 (OUT)
-5V_BF: C775.2, C777.2, R672.1, U658.1 (OUT), U658.20 (OUT)
GND: C762.2, C763.2, C764.2, C765.2, C766.2, C767.2, C769.2, C770.1, C771.1, C772.1, C773.1, C774.1, C775.1, C776.1, C778.1, C779.1, C780.1, C782.2, L655.2, R668.2, R673.2, R675.2, U657.2 (PGND), U657.3 (PGND), U657.8 (ENP), U657.9 (PSP), U657.11 (PSN), U657.19 (AGND), U657.25 (EP), U658.7 (GND), U658.21 (EP), U659.7 (GND), U659.21 (EP), U913.3 (GND)
PG_3V3RF: U913.2
PWR_CN_NEG: C769.1, U657.18 (CN)
PWR_CP_NEG: C766.1, U657.21 (CP)
PWR_ENN_NEG: U657.10 (ENN), U913.4
PWR_EN_NEG: U913.1
PWR_FBN_NEG: C768.2, R669.2, R670.1, U657.16 (FBN)
PWR_FBP_NEG: R667.2, R668.1, U657.22 (FBP)
PWR_FB_3V3SW: C781.1, R674.2, R675.1, U659.3 (FB)
PWR_FB_5VBF: C777.1, R672.2, R673.1, U658.3 (FB)
PWR_INP_NEG: D650.2 (A), L654.2, U657.1 (INP), U657.24 (INP)
PWR_NR_3V3SW: C780.2, U659.14 (NR/SS)
PWR_NR_5VBF: C776.2, U658.14 (NR/SS)
PWR_OUTN_NEG: D651.1 (K), L655.1, U657.13 (OUTN), U657.14 (OUTN)
PWR_VIN_NEGCONV: C764.1, R666.2, U657.4 (VIN)
PWR_VNEG: C768.1, C770.2, C771.2, C772.2, C773.2, C774.2, C778.2, D651.2 (A), R669.1, U657.15 (VNEG), U658.13 (EN), U658.15 (IN), U658.16 (IN), U659.13 (EN), U659.15 (IN), U659.16 (IN)
PWR_VPOS_NEG: C765.1, D650.1 (K), R667.1, U657.23 (VPOS)
PWR_VREF_NEG: C767.1, R670.2, U657.17 (VREF)

Notes on the sheet:
PWR_NEG (H2-C POWER_SPEC + AMENDMENTS A2): U657 TPS65131 inverter per TI SLVS493E (Apr 2022), boost stage disabled (ENP=GND), PSN=PSP=GND forced PWM, BSW left floating (SLVS493E 8.2.2.5 "leave the BSW pin floating"); U658/U659 TPS7A3301 per TI SBVS169D (Apr 2015), EN tied to IN. U913 74LVC1G08 (TI 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
