CLIS-WPI/OpenRU/(commit log)

2026-11-11 Clarify Docker socket scope in README
2026-11-12 Add P1 scientific validation suite
    Add separate long_horizon P1A-P1E experiments, polarization, sensor degradation, NR resource audit, and constrained energy validation. Preserve smoke/full membership and document the reduced design, negative findings, and evidence limits.
2026-11-12 Add provisional H1 4T4R/16-feed architecture baseline
    Topology A (sim-faithful) feed map generated from build_feed_map and
    guarded by tests/unit/test_h1_feed_map.py. Adds requirements, block
    diagram, frequency plan (IF 1.8 GHz / LO 6.6 GHz candidate), RF cascade
    budget, candidate BOM with discrete cost-down alternative to ADTR1107,
    clock/calibration, power/thermal, risks/gate and source manifest.
    Provisional engineering baseline, not an approved hardware design.
    H1 gate: NOT YET (open blockers B1 ADAR1000 availability, B2 ADTR1107
    TX power shortfall vs sim, B3 specs unverified at 8.4 GHz, B4 energy
    model mismatch). PCB fabrication: NO-GO. Simulator unchanged.
    Depends on p1-scientific-valida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
2026-11-12 Track H1 CSV deliverables
    The repo-wide *.csv ignore (for generated results) excluded the H1 BOM,
    cascade budget and feed map; the feed-map CSV is read by
    tests/unit/test_h1_feed_map.py. Add a narrow hardware/*.csv exception.
    [H1_CANDIDATE_BOM.csv, H1_FEED_POLARIZATION_MAP.csv, H1_RF_CASCADE_BUDGET.csv]
2026-11-12 Add H1.1 component qualification and schematic-entry gate
    Beamformer: ADAR1000 preferred (lifecycle RFND per official page; ADI
    direct 16 wk; no authorised-distributor stock). QPX0252 not yet a
    fallback (export flags contradictory, no published RF specs, Preview).
    Front end: ADTR1107 selected for the PROTOTYPE envelope (>=10 dBm/feed);
    no scalable-target FE qualified (ADTR1101, QPF5001, QPA0813 chain).
    Correction: QPA0813 OP1dB is 19 dBm (28.5 dBm is Psat); H1 cascade and
    BOM updated - the discrete chain is less linear than ADTR1107.
    Gate: CONDITIONAL GO for prototype schematic entry (conditions C1-C4);
    no part bench-qualified at 8.4 GHz; layout freeze and PCB fabrication
    NO-GO. Vendor que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
    [H1_1_FEM_COMPARISON.csv, H1_CANDIDATE_BOM.csv, H1_RF_CASCADE_BUDGET.csv]
2026-11-12 Add H2-A preliminary KiCad schematic for the 4T4R/16-feed RF tile
    Preliminary engineering schematic (not a released design) for topology A:
    4x ADAR1000 + 16x ADTR1107, LTC5553 converters (IF 1.8 GHz / LO 6.6 GHz),
    ADF4371 LO with AVA-183A+ buffer and EP4RKU+ 4-way split, per-chain
    EDC21-24+ calibration couplers, power/sequencing interlocks and MCU.
    - Mixer: LTC5553 replaces LTC5552 (ADI guidance for IF > 500 MHz,
    datasheet tables at IF 1890 MHz, single-ended IF, no balun)
    - KiCad 9 project (21 sheets, 211 parts) generated only through
    mcp-server-kicad 0.21.1 from datasheet pin tables; unverifiable
    circuits left unconnected and listed as UNRESOLVED
    - ERC: 22 errors, all deliberate unre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
    [H1_CANDIDATE_BOM.csv, H1_RF_CASCADE_BUDGET.csv, H2A_CANDIDATE_BOM.csv, H2A_LO_BUDGET.csv, H2A_PIN_INTERFACE_VERIFICATION.csv, H2A_RF_CASCADE_BUDGET.csv, H2A_SPUR_TABLE.csv, adar1000_pins.csv]
2026-11-12 Add H2-B electrical completion: gate-bias safety review, ERC 22 -> 5
    Edited with the KiCad MCP tools (KiCad 9.0.9 host); H2-A generator frozen.
    - Gate-bias conflict: ADAR1000 Rev B p45 OFF values (0x85 ~ -2.5 V PA,
    0x68 ~ -1.96 V LNA) exceed/reach ADTR1107 Rev C VGG abs max (-2 V).
    No schematic path applies them; firmware limit <= 0x5D (~-1.75 V) and
    drain-off bench pre-check documented on all BF sheets. Still open
    pending ADI confirmation.
    - ADF4371 loop filter drawn (DERIVED 3rd-order, 98 kHz BW, 46 deg PM;
    tools/loop_filter.py) - to confirm in ADIsimPLL; RS_SW unresolved.
    - AVA-183A+ bias network per Mini-Circuits Fig 2.
    - TPS22810 x4: QOD to VOUT, CT 2200 pF, CIN 1 uF (TI data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
    [H2B_PIN_INTERFACE_VERIFICATION.csv, bf1.kicad_sch, bf2.kicad_sch, bf3.kicad_sch, bf4.kicad_sch, lo.kicad_sch, mcu.kicad_sch, openru_x6_tile.kicad_sch]
2026-11-12 Add H2-C power tree, independent PA-drain interlock and safety simulation
    All KiCad edits via the KiCad MCP tools (KiCad 9.0.9).
    - Regulators: placeholders replaced by TI datasheet designs (TPS568230 x2,
    TPS62933 x2, TLV75518P, TPS7A4701 x2, TPS65131, TPS7A3301 x2); hardware
    rail ordering (negative rails gated by PG_3V3RF).
    - Independent PA-drain interlock: LM339B window monitors on 16 gates and
    rails, arm-only-when-pinched latch, IL_REF from +3V3_RF gated by
    PG_3V3RF/NEG rails, TPS386000 supervisor, per-chain crowbar
    (CSD16301Q2 + 0.33 ohm) with break-before-make.
    - Decoupling (ADI Stingray, ST DS12589); INA226 address fix; PCA9306
    100 pF; PG_5VPA routed; MCU pin map verified.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
    [H2C_PIN_INTERFACE_VERIFICATION.csv, bf1.kicad_sch, bf2.kicad_sch, bf3.kicad_sch, bf4.kicad_sch, fe1.kicad_sch, fe2.kicad_sch, fe3.kicad_sch]
2026-11-12 Add H2-D independent PA safety architecture review (no schematic change)
    - Audit of the as-built H2-C interlock: signal-state matrix, 68-row FMEA,
    fault trees TE1-TE4; order-1 cut sets found for every top event;
    TPS3430 WDO is high during brown-out (invalidates the H2-C nominal
    ordering result - erratum added); +5V_PA FB fault can put 12 V on
    all VDD_PA; IL_REF unmonitored; no current limit.
    - Guaranteed-characteristics database (min/max only) for all safety parts.
    - Gate-bias conflict analysis: passive divider is the only firmware-
    independent bound (46 mV margin, fails on -5 V rail faults) ->
    footprint option only; firmware limit is not independently fail-safe.
    - Architecture c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
2026-11-12 Add hardware-independent RF beamforming and calibration model
2026-11-13 Add H2 observability audit and Jones polarization calibration model
